ccroswhite/BFDAC/Alinx/pin_free.txt

=== used-pin presence on connectors ===
  G20: NOT on connectors (onboard?)
  G19: NOT on connectors (onboard?)
  B30: C17,B71_L24_P,B30
  A30: C16,B71_L24_N,A30
  A27: C20,B71_L22_P,A27
  A28: C19,B71_L22_N,A28
  T26: C2,B71_L3_P,T26
  R26: C1,B71_L3_N,R26
  H29: C5,B71_L15_P,H29
  G29: C4,B71_L15_N,G29
  P28: A5,B71_L5_P,P28
  R27: A1,B71_L2_N,R27
  T27: A2,B71_L2_P,T27
  N28: A4,B71_L5_N,N28
  R28: A7,B71_L1_N,R28
  T28: A8,B71_L1_P,T28
  BC33: NOT on connectors (onboard?)
  BF27: NOT on connectors (onboard?)
  AM26: A16,VUP_SELECTMAP_DATA4,AM26
  AN26: A14,VUP_SELECTMAP_DATA5,AN26
  AL25: A10,VUP_SELECTMAP_DATA6,AL25
  AM25: A11,VUP_SELECTMAP_DATA7,AM25
=== free bank-71 pins (first 20 not in XDC) ===
A10,B71_L18_N,D28
A11,B71_L18_P,E28
A13,B71_L10_N,K27
A14,B71_L10_P,K26
A16,B71_L12_N,J29
A17,B71_L12_P,J28
B1,B71_L6_N,N26
B2,B71_L6_P,P26
B4,B71_L13_N,H26
B5,B71_L13_P,J26
B7,B71_L4_N,N29
B8,B71_L4_P,P29
B10,B71_L23_N,A29
B11,B71_L23_P,B29
B13,B71_L20_N,C29
B14,B71_L20_P,D29
B16,B71_L11_N,H28
B17,B71_L11_P,H27
C7,B71_L17_N,E27
C8,B71_L17_P,F27
