ccroswhite/BFDAC/Alinx/xdc_pins.txt

set_property PACKAGE_PIN G20     [get_ports clk_200m_p]
set_property PACKAGE_PIN G19     [get_ports clk_200m_n]
set_property PACKAGE_PIN B30     [get_ports clk_49m_p]
set_property PACKAGE_PIN A30     [get_ports clk_49m_n]
set_property PACKAGE_PIN A27     [get_ports clk_45m_p]
set_property PACKAGE_PIN A28     [get_ports clk_45m_n]
set_property PACKAGE_PIN T26     [get_ports spi_sclk]
set_property PACKAGE_PIN R26     [get_ports spi_cs_n]
set_property PACKAGE_PIN H29     [get_ports spi_mosi]
set_property PACKAGE_PIN G29     [get_ports spi_miso]
set_property PACKAGE_PIN P28     [get_ports fpga_irq_n]
set_property PACKAGE_PIN R27     [get_ports i2s_bclk]
set_property PACKAGE_PIN T27     [get_ports i2s_lrclk]
set_property PACKAGE_PIN N28     [get_ports i2s_data]
set_property PACKAGE_PIN R28     [get_ports relay_line_mute]
set_property PACKAGE_PIN T28     [get_ports relay_hp_mute]
set_property PACKAGE_PIN U28     [get_ports relay_hp_rails]
set_property PACKAGE_PIN R29     [get_ports {relay_level[0]}]
set_property PACKAGE_PIN T29     [get_ports {relay_level[1]}]
set_property PACKAGE_PIN BC33    [get_ports led_status]
set_property PACKAGE_PIN BF27    [get_ports qspi1_cs_n]
set_property PACKAGE_PIN AM26    [get_ports {qspi1_dq[0]}]
set_property PACKAGE_PIN AN26    [get_ports {qspi1_dq[1]}]
set_property PACKAGE_PIN AL25    [get_ports {qspi1_dq[2]}]
set_property PACKAGE_PIN AM25    [get_ports {qspi1_dq[3]}]
