ccroswhite/BFDAC/utils/coef/DAC_PERSONAS.md

# BFDAC Filter Personas — Sonic Design Reference

**6 DAC Personas × 6 Filter Variations = 36 URAM Coefficient Sets**

Generated by: `gen_coe_super.py --generate-all --architecture uram`  
Coefficient format: Q1.17 signed 18-bit, 16 polyphase phases, 64 taps/phase  
Base sample rate: 48 kHz → 768 kHz output (×16 interpolation)

---

## Variation Axes (consistent across all personas)

| Tag | What changes | You hear it as |
|-----|---|---|
| **F1 Reference** | Definitive flagship character of that DAC | The intended "house sound" |
| **F2 Fast** | Higher Kaiser beta / steeper roll-off | More defined, more "hi-fi", slightly more fatiguing |
| **F3 Slow** | Lower Kaiser beta / gentler transition | More natural, analogue ease, less edge |
| **F4 Apodising** | Blackman-Harris window, fc pulled in | Removes CD brickwall pre-ringing, very clean presentation |
| **F5 Phase Alt** | Minimum-phase or hybrid (60% min / 40% linear) blend | Changes transient envelope — zero pre-ringing vs some |
| **F6 Extended BW** | fc pushed to 21–23 kHz | More air, space, and presence perceived above the mix |

---

## Persona 1 — dCS Vivaldi Apex

**Sonic Character: "Analytical Precision with Organic Resolution"**

The dCS house sound is about revealing everything in the recording without ever sounding harsh.
It is surgical but not clinical. The Vivaldi Apex is known for an enormous sense of space and
air — you hear deep into the mix. The baseline apodising filter (Kaiser β=8, fc=20.5 kHz) sits
just above 20 kHz to remove the Gibbs ringing injected by CD mastering brickwall filters
upstream, which is dCS's core philosophy. The relaxed beta means the transition band is gentle —
not trying to be a brickwall itself — giving a relaxed, airy quality rather than the "tense"
sound of a very steep filter.

| Variation | Parameters | Description |
|---|---|---|
| F1 | Kaiser β=8, fc=20.5k, linear | Definitive dCS filter — apodising, removes upstream pre-ringing |
| F2 | Kaiser β=12, fc=20k, linear | More frequency-domain precision, slightly more "hi-fi" |
| F3 | Kaiser β=5, fc=20.5k, linear | Softer — more analogue-like ease, less defined but more natural |
| F4 | Blackman-Harris, fc=19k, linear | Deep apodising — maximum removal of digital artefacts |
| F5 | Kaiser β=8, fc=20.5k, hybrid | Organic quality of minimum-phase combined with dCS openness |
| F6 | Kaiser β=8, fc=23k, linear | "Air and space" filter — maximises perception of presence |

---

## Persona 2 — Chord DAVE

**Sonic Character: "Transient Accuracy and Maximum Tap Count"**

Rob Watts's WTA (Watts Transient Alignment) algorithm is the defining characteristic. The DAVE
uses over 1 million taps to reconstruct the waveform with extraordinary precision. The result is
that you hear micro-details — the precise decay of a piano note, the exact attack of a plucked
string — that other DACs smear together. It is not warm, it is not smooth — it is truthful. The
steep Kaiser β=14 brickwall is intentional: keep 20 kHz as a hard boundary, waste no energy on
the transition, put all the taps into passband accuracy.

| Variation | Parameters | Description |
|---|---|---|
| F1 | Kaiser β=14, fc=20k, linear | WTA reference — tight brickwall, maximum impulse accuracy |
| F2 | Kaiser β=18, fc=20k, linear | Even more stopband rejection, most "hi-fi" presentation |
| F3 | Kaiser β=10, fc=20k, linear | Relaxed — trades some precision for a less intense listen |
| F4 | Blackman-Harris, fc=18.5k, linear | Cleans up CD-era material, less fatiguing on older recordings |
| F5 | Kaiser β=14, fc=20k, minimum | Removes pre-ringing entirely — fundamentally different character |
| F6 | Kaiser β=14, fc=22k, linear | Adds "air" that the strict brickwall cuts off |

---

## Persona 3 — MSB Reference

**Sonic Character: "Zero Pre-Ringing, Organic Transients, Black Background"**

MSB uses a discrete R-2R ladder DAC — no delta-sigma, no DSD conversion. The modulator noise
floor is exceptionally low, giving an almost spooky quiet background. The sonic character is
organic and natural — transients have the right energy envelope (all post-impulse, nothing before
it), which is exactly what you hear in real acoustic instruments. Minimum phase is the correct
choice here: no pre-ringing means a piano attack sounds like a piano attack, not like something
that starts ringing before the hammer hits the string. The Hann window gives a smooth,
non-aggressive roll-off.

| Variation | Parameters | Description |
|---|---|---|
| F1 | Hann, fc=20k, minimum | MSB reference — Hann + minimum phase, zero pre-ringing |
| F2 | Kaiser β=10, fc=20k, minimum | Slightly steeper, more defined, still zero pre-ringing |
| F3 | Kaiser β=6, fc=20k, minimum | Softest version, most "analogue" feeling |
| F4 | Blackman-Harris, fc=19k, minimum | Deep apodising and zero pre-ringing combined |
| F5 | Kaiser β=10, fc=20k, hybrid | Compromise — some pre-ringing returns, sharper transient attack |
| F6 | Hann, fc=23k, minimum | More air without introducing pre-ringing |

---

## Persona 4 — Berkeley Audio Design Alpha 3

**Sonic Character: "Maximum Analogue Character, No Digital Fingerprint"**

Michael Ritter's philosophy at Berkeley is radical: the DAC chip does nothing but convert bits
to voltage. All the filtering happens in the FPGA. This means the output has no trace of the
internal chip filter (which typically adds its own phase distortion and roll-off character). The
Berkeley sound is extraordinarily open and relaxed — non-fatiguing, listeners report being able
to sit with it for hours. The aggressive FIRLS + Blackman-Harris apodising at 18.5 kHz means the
filter is already rolled off before 20 kHz. This sounds like a limitation but the ear perceives
it as ease — there is no "edge" to the sound.

| Variation | Parameters | Description |
|---|---|---|
| F1 | FIRLS+BH, fc=18.5k, linear | Berkeley reference — maximum analogue ease |
| F2 | FIRLS+BH, fc=20k, linear | Widens to 20 kHz — more detail at the cost of some ease |
| F3 | FIRLS+BH, fc=17k, linear | Most analogue/relaxed version, almost LP-like top end |
| F4 | Gaussian α=4, fc=18k, linear | Softer roll-off shape than BH — very smooth, no hard knee |
| F5 | FIRLS+BH, fc=18.5k, hybrid | Adds minimum-phase organic quality to the Berkeley character |
| F6 | FIRLS+BH, fc=21k, linear | Retains BH character with more air |

---

## Persona 5 — Merason DAC1

**Sonic Character: "Burr-Brown PRaT — Pace, Rhythm and Timing"**

The Merason is built on the Burr-Brown PCM1794A, one of the most loved DAC chips in audiophile
history. The Burr-Brown house sound is slightly smooth and romantic — never harsh, never
fatiguing, but with enough detail to be engaging. More importantly, it has exceptional PRaT
(Pace, Rhythm and Timing) — music played through it has drive and momentum. It makes you want
to tap your foot. Kaiser β=11 sits between the Chord brick-wall precision and the dCS ease —
a deliberately crafted middle ground that is detailed but smooth.

| Variation | Parameters | Description |
|---|---|---|
| F1 | Kaiser β=11, fc=20k, linear | Merason reference — balanced smooth/detailed |
| F2 | Kaiser β=13, fc=20k, linear | More detail, better transient definition, still not harsh |
| F3 | Kaiser β=9, fc=20k, linear | More romantic — the PCM1794A's smoothest character |
| F4 | Blackman-Harris, fc=19.5k, linear | Cleans up digital fingerprint, purely natural presentation |
| F5 | Kaiser β=11, fc=20k, hybrid | Slightly organic transients — preserves PRaT quality |
| F6 | Kaiser β=11, fc=22k, linear | Adds "air and shimmer" above the mix |

---

## Persona 6 — Mola Mola Tambaqui

**Sonic Character: "Studio Monitor Neutrality, Ultra-Low Noise"**

Bruno Putzeys (also designer of Purifi amplifiers) built the Tambaqui around his MDAT modulator
— a proprietary noise shaper that achieves extraordinary dynamic range and linearity. The
Tambaqui tells you exactly what is in the recording — it does not add warmth, romance, or any
colouration. If the recording is great, it sounds great. If it is not, you will know. This is
the DAC engineers and mastering engineers reach for. Kaiser β=16 is the steepest flagship
reference — maximum stopband rejection, ruler-flat passband.

| Variation | Parameters | Description |
|---|---|---|
| F1 | Kaiser β=16, fc=20k, linear | Tambaqui reference — neutral precision, ruler-flat |
| F2 | Kaiser β=20, fc=20k, linear | Maximum resolution — every micro-detail resolved |
| F3 | Kaiser β=12, fc=20k, linear | Slight relaxation — adds the tiniest warmth to very revealing material |
| F4 | Blackman-Harris, fc=19k, linear | Removes digital artefacts, slightly less clinical presentation |
| F5 | Kaiser β=16, fc=20k, minimum | Zero pre-ringing — changes character toward organic |
| F6 | Gaussian α=3, fc=21k, linear | The one "colour" option: air with a smooth Gaussian roll, no hard knee |

---

## Generation Commands

```bash
# All 36 filters — simulation scale (4 MACs, 64 taps/phase):
python gen_coe_super.py --generate-all --architecture uram --out_dir coeffs

# Single persona — all 6 variations:
python gen_coe_super.py --generate-all --persona chord-dave --architecture uram --out_dir coeffs

# Single specific filter:
python gen_coe_super.py --persona msb-reference --variation F4 --architecture uram --out_dir coeffs

# Production scale (1024 MACs):
python gen_coe_super.py --generate-all --architecture uram \
    --uram-num-macs 1024 --uram-taps-per-phase 64 --out_dir coeffs_prod
```

## Output File Tree

```
coeffs/
  dcs-vivaldi/
    dcs-vivaldi_F1_F1-Reference_m4_t64.txt
    dcs-vivaldi_F2_F2-Fast_m4_t64.txt
    dcs-vivaldi_F3_F3-Slow_m4_t64.txt
    dcs-vivaldi_F4_F4-Apodising_m4_t64.txt
    dcs-vivaldi_F5_F5-PhaseAlt_m4_t64.txt
    dcs-vivaldi_F6_F6-ExtendedBW_m4_t64.txt
  chord-dave/      (6 files)
  msb-reference/   (6 files)
  berkeley-alpha3/ (6 files)
  merason/         (6 files)
  mola-mola/       (6 files)
```

---

*Last updated: 2026-07-01*  
*Reference implementation: `gen_coe_super.py` `DAC_LIBRARY` dict*

---

# Filter Design Choices: The Science and the Honesty

## What We Actually Know vs. What We Are Approximating

### The Hard Truth First

We do **not** know with confidence exactly what Rob Watts, dCS, MSB, or Mola Mola are doing
internally. What we have is:

- **Published patents** (Watts has several on WTA, dCS has SACD/ring DAC patents)
- **White papers** (dCS Ring DAC, Chord WTA algorithm description)
- **Measurements** published by Audio Science Review, Stereophile, and others — impulse
  responses, frequency responses, phase responses
- **Interviews** where designers describe their philosophy in general terms
- **Reverse-engineering** from those measurements by the audio community

What we are doing is **emulating the audible fingerprint** of those designs using filter theory,
not replicating their actual silicon. The distinction matters.

---

## Why Specific Windows Produce Specific Sounds

The relationship between window choice and audible character is well-understood DSP. The
science here is solid.

### Kaiser Window — Why Chord DAVE uses high beta

The Kaiser window is parametric — beta controls the **trade-off between stopband attenuation
and transition band width**. High beta (14–20) means:

```
Passband → [very flat] → steep cliff → [very deep stopband]
```

Rob Watts has explicitly stated in interviews and white papers that his WTA filter prioritises
**time domain accuracy over frequency domain performance**. The paradox is that to get time
domain accuracy you need **very long filters** (~1 million taps), not necessarily steep
frequency roll-off. However, the Kaiser window's shape produces a very controlled impulse
response — the ringing is symmetric and decays predictably. With enough taps, the pre-ringing
and post-ringing are pushed so far out in time that they become inaudible. This is the WTA
principle: **don't reduce the ringing, make it temporally inaudible by spreading it far from
the transient**.

A Hamming window at the same tap count would have lower stopband attenuation (~43 dB vs ~80+
dB for Kaiser β=14) and a less controlled transition. Kaiser gives **adjustable precision** —
that is why it dominates serious filter design.

### Hann Window — Why MSB uses it for minimum phase

The Hann window has a **smooth, gradual roll-off shape**:

```
Passband → [gentle slope] → quiet stopband
```

Stopband attenuation is ~44 dB — less than Kaiser β=14 — but the **impulse response is very
smooth** with no abrupt discontinuities. Combined with minimum-phase conversion (which takes
all the energy and pushes it forward in time, eliminating pre-ringing entirely), the Hann
window produces the most **organically-shaped post-impulse decay**.

The minimum-phase conversion via Hilbert transform or homomorphic method does not change the
magnitude response — only the phase. So you keep the Hann's gentle frequency roll-off but
eliminate all pre-ringing. The remaining ringing all follows the impulse, which is how acoustic
instruments actually behave in a room. MSB have published that their design philosophy is
explicitly around this — zero pre-ringing, all energy causal.

### Blackman-Harris Window — Why it is used for apodising

Blackman-Harris has the **highest stopband attenuation** of the common windows (~92 dB) with a
fairly wide transition band. The wide transition is the key:

```
Passband → [wide gentle slope starting at ~17–19 kHz] → very deep stopband
```

The word **apodising** literally means "removing the foot" — it refers to removing the
sidelobes of the sinc function that cause Gibbs phenomenon ringing. A CD's original mastering
uses a brickwall at 22.05 kHz which injects its own pre-ringing into the signal. An apodising
filter rolls off *before* that brickwall frequency, effectively erasing that pre-ringing.

dCS's apodising filters (and our F4 variations) do exactly this. dCS has explicitly described
this in their technical literature — their filter is designed to attenuate the out-of-band
energy that causes Gibbs ringing from upstream 44.1 kHz brickwall filters.
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
