ccroswhite/BFDAC/pkg36.png

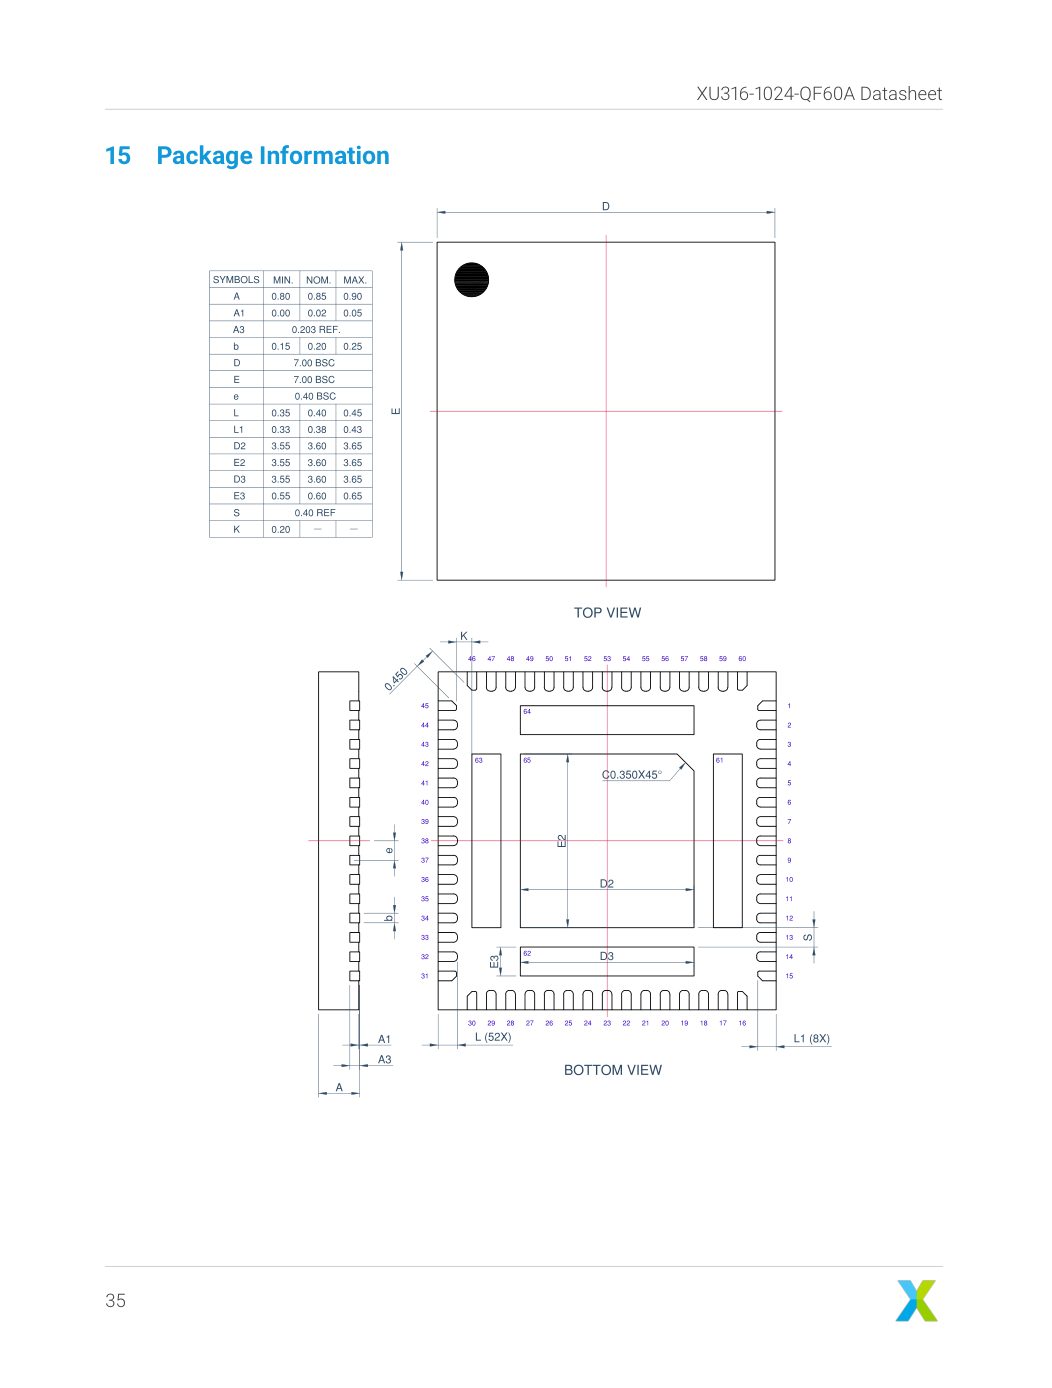
pkg36.png
