ccroswhite/BFDAC/bom.md

# BFDAC — Consolidated Bill of Materials

Single source of truth for all board-level parts. Organized per block; **BOM
section N documents schematic.html figure N** — the two files are an
authoritative pair and MUST be edited in lock-step (any part added, removed or
revalued in one is reflected in the other in the same change). Netlist values
(`bfdac_*.cir`) are authoritative for analog values; this document tracks
realized MPNs and quantities.

## 18b. Current Coefficient-Flash Decision (Supersedes Item 18a MPN)

The selected carrier part is **Macronix `MX66UM2G45GXRI00`** (no `-T` suffix),
four devices, one shared bus and four existing chip-selects. The interface in
this revision is **x1 SPI**, not x4 QSPI; use 4-byte Fast Read `0x0C` with eight
dummy clocks at a 100 MHz carrier SCK target. The device also supports x8 OPI,
which is not used by this design. The selected part is linked at
[DigiKey](https://www.digikey.com/en/products/detail/macronix/MX66UM2G45GXRI00/18109953).
SIO0/SIO1 map to MOSI/MISO; SIO2/SIO3 remain static high in x1 mode;
SIO4-SIO7, DQS and ECS# are no-connect. VCC/VCCQ share V18, GND/VSSQ share
GND, RESET# is strapped high, and the schematic includes separate 100-nF
decouplers for VCC and VCCQ per device. The 100-MHz target still requires
post-route MISO timing sign-off.

The 1-Gb alternate is `MX66UM1G45GXDI00`. Its 24-ball map and 6 x 8 mm,
5 x 5 / 1.0 mm land pattern match the 2-Gb part; no PCB pin or CS changes are
needed. Build that population with `CFLASH_DEVICE_ADDR_BITS=27` instead of 28
(for the current Vivado scripts, set that environment variable) and limit the
coefficient image accordingly. With 64-KiB-sector-aligned,
11,862,016-byte records that do not cross chip boundaries, four 2-Gb devices
hold up to 88 full-size records (22/device); four 1-Gb devices hold 44 (11/device).
The 2-Gb population is the default and supports the planned 64-record library.
This per-device limit supersedes item 18a's aggregate-only 90-record estimate;
the controller does not split a single read across chip-select boundaries.
The prior Micron MPN and its footprint/pin map are superseded.

## Board-to-Board Connectors

The main circuit board has three bottom-side SEAF-40 sites: Conn1/J506 west,
closest to the FPGA; Conn2/J603 north-center; and Conn3/J604 south-center.
Use `SEAF-40-05.0-L-06-2-A-K-TR` on all board-side sites. The local symbol and
footprint each represent 40 contacts per row x six rows (240 pads), numbered
row-major A1-F40. Conn1/J506 carries the AP interface, a 30-contact `V12SOM`
bank with its `GND` perimeter, and a separate `V33_IF_IN` group with a carrier
`GND` guard. `VAP_IO/GND_AP` remain a separate AP-side domain. The separate
J507/J508 +12 V terminals are removed from the active design.
The mating pre-regulator board uses the same SEAF land pattern; its connectors
(J7703/J7704 to J603/J604, plus **J7705 to J506** - full 240-pad mirror of the
Conn1 map; `V12SOM`/`V33_IF_IN` are sourced on that assembly, row-A AP_* +
`VAP_IO`/`GND_AP` continue to the AP section whose physical interconnect is
TBD) and V4P3 front-end are drawn on the PREREG subsheet of this project with
`on_board=no` (bom 17o). Its own PCB file remains separate.
See `docs/SEAF_PIN_ASSIGNMENTS.md` for the complete Conn1 map and the current
J603/J604 assignments. Contact derating/current sharing and the local 1.8 V
LDO implementation remain to be qualified; the source for `V33_IF_IN` on the
pre-regulator/mating assembly must also be specified.
This section is the current connector selection and supersedes the historical
connector decisions recorded under items 17(m5)/(m6) below.
Use three `SEAR-40-30.0-06-85` interposers, one per mating site. They are
BOM-only; do not add them as PCB footprints or to the chassis 3MF. The
matching three SEAF connectors on the pre-regulator board belong in that
board's assembly BOM.
The target separation between the two boards is 40 mm; the pre-regulator
board's PCB layout is not in this project.

| BOM § | Block | Schematic | MPN status |
|---|---|---|---|
| 1 | Master clock tree & reclock | Fig. 1b | **LOCKED (Round 30, ratified)** — RTZ coding + SN74LVC1G74 single-FF reclock |
| 2 | Unit cell array | Fig. 2 | **LOCKED (Round 29)** — BJT steering cell (DMMT5551) |
| 3 | Per-rail output stage | Fig. 3 | values locked, MPNs TBD |
| 4 | I/V converter | Fig. 4 | OPA1612AIDRGR DRG WSON-8; BUF634AIDDAR DDA HSOIC-8 PowerPAD |
| 5 | Reconstruction filter | Fig. 4b | values locked, coils custom |
| 6 | Line V-stage | Fig. 4c | shares §8 MPNs |
| 7 | Output routing & relays | Fig. 4d | K4 = Omron G6K-2F-Y **DC3** on dedicated `V33RLY` LDO (2026-10-10), drawn |
| 8 | ~~Headphone amplifier~~ | Fig. 4e | **REMOVED 2026-10-05 (user: power/heat) — not in this version; kept for record** |
| 20 | Temperature sensing (I²C, isolated) | — | NEW 2026-10-05 — TMP117 + ~~ISO1610~~ **ISO1640** ruled (MPN corrected 2026-10-08) |
| 21 | AP ↔ FPGA control SPI isolation | — | **RULED 2026-10-05: single SPI, TI ISO7741** (3/1, 100 Mbps); 10 MHz guaranteed / 50 MHz if the AP has RX sample delay |
| 9 | Supplies & references | Fig. 5 | values locked, LDO/refs TBD |
| 10 | Common-mode servo | Fig. 5b | pairs selected, support TBD |

Open sync items are listed at the [bottom](#open-sync-items).

---

# 1. Master clock tree & cascode reclocking (Fig. 1b, Round 24)

Round 24 architecture: clock selection moved off-chip. FPGA receives a single
muxed MCLK and drives `clk_sel`; the same buffer tree clocks the external
reclock flip-flops so cascode edge timing is set by the OCXO chain, not the
FPGA fabric (~23 dB timing-SNDR gain, `reclock_study.py`, Round 23).

> **DATASHEET-VERIFIED (Round 30, 2026-07-22):** all §1 jitter/skew/timing
> figures below updated from MC10EP52/D rev 7 (onsemi), LMK00304 SNAS578G
> rev G, LMK1C110x SNAS717A, SN74LVC1G74 rev G (TI).
>
> **RATIFIED (Round 30, 2026-07-22, user):** the cell coding is **RTZ at
> 75 % duty** (each selected cell emits one identical charge pulse per
> sample: 6-of-8 mclk cycles high = 122.1 ns at the 6.144 MHz cell rate)
> and the reclock stage is **one SN74LVC1G74 per cell** (single-FF package
> — MANDATED by the SSN code² analysis, see §1.2). DEM is the
> unconstrained sort-based 2nd-order vector shaper (RTL). Verification:
> 4-leg battery, `progress.md` Round 30 "RTZ-DEM VERIFICATION"
> (`rtz_study.py`, `bfdac_cosim28j.cir`, `rtz_noise.py`, `dwa_tones*.py`).
> Key consequence for layout: **sub-ns length matching is retired** — RTZ
> pulse-position invariance relaxes clock-tree skew to ±5 ns and Q/Q̅
> intra-pair mismatch to ~700 ps (~12 cm).

## 1.1 Clock selection & distribution

| Ref | Qty | Part | Function | Key specs |
|---|---|---|---|---|
| Y301 | 1 | Crystek **CCHD-957-25-49.152** (primary) / NDK **NZ2520SDA** 49.152 MHz audio grade per NDKT02-00008 (2nd source) | 48 kHz-family master clock, 1024·fs, LVCMOS 3.3 V → 33 Ω → shared `XOCLK` net (2026-09-28: E/D = `!clk_sel`; **VERIFY output high-Z when disabled**, pinout 1 E/D 2 GND 3 OUT 4 Vcc, footprint) | P3 (2026-09-13, `pn_n2b.py` + gate 97): with RTZ both pulse edges come from the same clock 122 ns apart, so **only the broadband floor above ~1 MHz reaches the output** (close-in PN = pulse position only, −179 dBc @ 1 kHz, sim-validated to 0.4 dB). Requirement: floor ≤ −169 dBc/Hz (≈ 80 fs width-jitter). CCHD-957: floor ~−169, ~82 fs 12k–20M, ±25 ppm — **confirm both figures on datasheet**; NZ2520SDA: −172 @ 100k, 43 fs, ±50 ppm (irrelevant to audio; matters only if slaved to S/PDIF without ASRC). OCXO not required. PLL cleaners (AD9558/LMK048xx) REJECTED — floors 10–20 dB worse. |
| Y302 | 1 | same family, **45.1584 MHz** | 44.1 kHz-family master clock → 33 Ω → `XOCLK` (E/D = `clk_sel`) | as Y301 |
| ~~U301 LMK00304~~ | 0 | **REMOVED 2026-09-28 (open item 15, user-ratified option 2).** Its only LVCMOS output (REFout, the sole way to drive LMK1C1108 CLKIN) is 95 fs additive vs the 51 fs LVPECL figure quoted here; the mux function moves to the XO enables. Tree common jitter ≈ √(82² + 20² + 20²) ≈ 87 fs (was ≈129 fs with REFout, ≈101 fs as originally assumed). Switch still not glitch-free → same sequencer mute + MMCM reset as before. | | |
| U301 | 1 | TI **SN74LVC1G04DBVR** | `clk_sel` inverter → Y301 E/D; `clk_sel` → Y302 E/D directly; 10 k pull-down on `clk_sel` = 48 k family default while the FPGA is unconfigured | SOT-23-5, V33CLK |
| U312 | 1 | TI **SN74LVC1G125DBVR** | FPGA `mclk` copy off `XOCLK` → 100/120 Ω divider (3.3 → 1.8 V, ≈55 Ω source) → J1 A17 (B71_L12_P / J28) as **LVCMOS18 single-ended** | its jitter is irrelevant — the FF retimes; FPGA only needs the ±5 ns window. **FPGA XDC TODO:** `mclk` becomes IBUF on J28, `mclk_n`/J29 freed |
| U302–U319 | 18 | TI **LMK1C1108** | 1:8 LVCMOS clock fanout, two-level tree (2 roots → 16 leaves → 128 FF clock traces; Round 29: 128 single-FF MC100EP52 packages). **LOCKED 2026-10-09: all 128 XO→FF CLK paths length-matched ±5 mm (§1.2 layout rule)** | VERIFIED @3.3 V: output–output skew 35 ps typ / 55 ps max per device; **part-to-part skew 280 ps max** (dominates leaf-to-leaf across different chips — still inside the 1 ns FPGA-vs-FF budget; inter-bank static skew benign, DEM decorrelates, Round 23); additive jitter 12 fs typ / 20 fs max; tpd 1.3–2.2 ns; fmax 250 MHz; ~~length matching RETIRED (Round 30 RTZ ratification): tree skew tolerance ±5 ns — route for signal integrity only~~ **RE-INSTATED 2026-10-09 (user): ±5 ns remains the functional limit; layout target ±5 mm end-to-end, ±2.5 mm root/leaf feeds (§1.2 layout rule)** |
| R3xx | 1 per clock trace + 2 | 22–33 Ω 0402 | Series termination at each buffer clock output | at driver pin, no stubs |

## 1.2 Reclock flip-flops — **LOCKED (Round 30, ratified): RTZ + SN74LVC1G74**

> **HARD CONSTRAINT (Round 30 user ruling — was implicit, now explicit):
> the reclock/drive electronics sit millimeters from the matched DMMT5551
> steering pairs and the timing-critical clock tree. The thermal budget
> there is very small: per-cell heat sources cause gradient drift across
> the matched parts (Vbe/alpha tempco → INL drift, timing drift). Target:
> per-cell drive electronics ≤ ~10 mW (CMOS-class dynamic power only);
> reclock array total ≤ ~1–1.5 W. The MC100EP52 (≈140 mW/cell static,
> ≈18 W array — verified Round 30) is VETOED. Any future drive-stage
> candidate must pass this constraint BEFORE electrical evaluation.**
>
> **RESOLVED (Round 30 ratification): SN74LVC1G74 @ ≈5–7 mW/cell passes
> the constraint** (3–4 mW FF dynamic + 2.9 mW drive network, sim-measured
> `bfdac_cosim28j.cir` p_net1). Array < 1 W.

### Round 30 ratified design: RTZ coding + SN74LVC1G74 per cell

Architecture: **one FPGA data pin per cell (128 total, LVCMOS18)** carrying
the **RTZ-encoded** pattern (selected cell → 6-of-8 mclk cycles high per
cell period; unselected → low); **octal 1.8→3.3 V translators at the SoM
connectors (FPGA side of the board, SN74AXC8T245-class, 8/channel — RULED
2026-10-09, replaces the 128 per-cell AXC1T45)** feed the **SN74LVC1G74** D
inputs over 3.3 V runs into the cell array; the **128 FPGA → translator 1.8 V
lines are length-matched** (user ruling); the FF —
clocked from the LMK1C1108 tree at mclk — retimes the pulse and its true
Q/Q̅ outputs drive the DMMT5551 steering pair (§2) through the rs/rp
network. Translator/data-path timing errors are retimed away by the FF;
only the FF's own edges reach the cell.

Why RTZ (Round 30, 4-leg verification, `progress.md`): every selected cell
emits an *identical, self-contained* charge pulse per sample, so
(a) rise-vs-fall duty asymmetry — the defect that killed every NRZ CMOS
candidate at 1.1–1.4e-2/ns — becomes a pure **gain** error (−2.43 % at the
worst measured dtrf, k-variation ≤ 3.3e-4, sim-verified); (b) per-cell
static spreads (duty, Q/Q̅ trace skew) become DEM-shaped mismatch;
(c) pulse position is charge-invariant → clock skew is benign. Costs:
−2.5 dB amplitude (75 % duty) and real width-jitter sensitivity (needs
tree broadband floor ≤ 150 fs — actual 50–80 fs ✓; per-FF additive jitter
≤ 1 ps — bench-verify).

Why single-FF packages (MANDATORY): under RTZ all selected cells switch
simultaneously; on a shared die the SSN edge pushout (β·switching-count,
rise-vs-fall coefficients differ) makes pulse WIDTH depend on packmate
activity → code² distortion at 75–100 dB class for a quad (even Δβ =
0.05 ps/cell → 104.7 dB, `rtz_noise.py`). One FF per package reduces SSN
to a per-cell static effect (DEM-shaped). Each FF package gets local rail
isolation (R/ferrite + C, values at open item #11) so board-rail droop
stays width-symmetric.

Derived layout tolerances (Round 30): Q/Q̅ intra-pair trace mismatch
≤ ~700 ps ≈ 12 cm; clock-tree skew ≤ ±5 ns ≈ ±80 cm; data traces
untimed (retimed away). Only the analog cell matching constraints (§2)
remain sub-ns/precision class.

**LOCKED layout rule (2026-10-09, user: "beat the 5 ns by a country mile; equalise
SSN timing") — the Round-30 tolerances above are the *functional* limits, NOT the
layout targets.** Data path, FPGA pin → translator → FF, length-matched on both
segments: **FPGA pin → AXC8T245 input (1.8 V, 128 lines): ±2.5 mm (≈ ±16 ps),
within each octal group and across all 16 groups**; **AXC8T245 output → LVC1G74 D
(3.3 V, 128 lines): ±5 mm (≈ ±33 ps)**; Q/Q̅ intra-pair ±1 mm. Rationale: the
trace is then 20× below the FPGA pin-to-pin Tco spread (~300 ps) and the
translator channel skew (~300–500 ps), so all 128 D edges — and the translators'
SSN event — land at one repeatable point in every cell's setup window, far from
the sampling edge. SSN equalisation: 8 lines per octal, 8 octals per channel,
identical decoupling per octal, channels mirrored; translator B-sides on their
own ferrite/C island of `V33FF`, separate from the FF islands. **Clock tree
matching RE-INSTATED (user, 2026-10-09): XO → root LMK1C1108 → leaf LMK1C1108 →
FF CLK, all 128 end-to-end paths matched to ±5 mm (≈ ±33 ps), both channels
included; the two root legs and the 16 leaf feeds matched to ±2.5 mm.** The
Round-30 "length matching retired" note is reversed: static per-cell clock skew
interacts with sort-shaper DEM (cell assignment changes every sample), so it is
removed rather than tolerated; the remaining leaf-to-leaf skew is then the
LMK1C1108 part-to-part figure (280 ps max) alone.

| Ref | Qty | Part | Function | Key specs |
|---|---|---|---|---|
| U311–U438 | 128 | TI **SN74LVC1G74DQER** (single D-FF, true Q/Q̅, X2SON-8 DQE, 1.4 x 1.0 mm, 0.35 mm pitch, VCC = 3.3 V) | Retime 1 RTZ data line → complementary base-drive pair (1 per cell, placed adjacent to its DMMT5551 pair) | VERIFIED (rev G): fmax 175–200 MHz @3.3 V (vs 49.152 MHz clock); tpd 2.2–7.1 ns; "balanced outputs"; Icc static 10 µA; ~3–4 mW dynamic at RTZ activity. **BENCH-VERIFY (not datasheet-spec'd):** part-to-part \|tPLH−tPHL\| spread σ ≤ ~600 ps; **additive jitter ≤ 0.8 ps rms (P3 2026-09-16, gate 98: per-FF jitter is independent per cell and enters at 0.155× the common-path sensitivity = 171 nV/ps; 0.84 ps is the most the 245 nV budget can absorb with the CCHD-957 floor, 0.6 ps comfortable; 1 ps → 171 nV = −127 dB0 total, still 14 dB better than dCS)**. Design-in: clock pin driven by the full-swing LMK1C1108 leaf edge (≥ 3 V/ns, series R, no stub); per-FF ferrite + local C from a dedicated low-noise 3.3 V rail (delay sensitivity ~50–100 ps/V → ≤ 1 mV rms rail noise ≈ 0.1 ps). Fallback if bench > 0.6 ps: MC100EP52 / NB7V52M-class (0.2 ps spec'd) + level translator (Round 29 costing). Open item #10 |
| ~~U440–U567~~ | ~~128~~ | ~~**AXC1T45-class** single-bit 1.8→3.3 V translator~~ | **SUPERSEDED 2026-10-09 (user ruling: routing/parts congestion in the cell array; no single-part FF+translator exists, see item 12)** | — |
| U440–U455 | 16 (8/channel) | TI **SN74AXC8T245RHLR — LOCKED 2026-10-10** (VQFN-24 RHL 3.5 × 5.5 mm 0.5 mm EP; user ruling VQFN over TSSOP). **Pin map VERIFIED 2026-10-10 against the datasheet Fig. 4-2 (user image):** 1 VCCA, 2 DIR1, 3–10 A1–A8, 11 DIR2, 12/13 GND, 14–21 B8–B1, 22 OE̅, 23/24 VCCB, 25 PAD (grounded, recommended). *The TI/UL KiCad symbol (`datasheets/CAXC8T245QWRGYRQ1/KiCADv6`) labels pin 23 "VCCA" — the figure says VCCB; the figure is used.* Vendor land pattern `VQFN25_RGY_TEX` copied verbatim as `bfdac:TI_RGY_VQFN-24_3.5x5.5mm_P0.5mm_EP` (-L/-M density variants left in `datasheets/`). **DRAWN 2026-10-10 on the new `xlat.kicad_sch`:** device g carries cells 8g+1..8g+8 (U440–447 = L, U448–455 = R); A = `DATnn_1V8` / `DATRnn_1V8` from J6 / J5 (connector nets renamed), B = `DATnn` / `DATRnn` to the CELL sheets; DIR1/DIR2 = V18, OE̅ = GND, PAD = GND; C440–455 100 n on VCCA; FB440–455 BLM18PG121 + C460–475 100 n = per-octal `V33FF` island (`VXBnnn`). Per-cell AXC1T45 removed from the CELL sheets (cell = 7 kinds now). ERC 0 errors, xcheck PASS | FPGA LVCMOS18 data → LVC1G74 D inputs, placed **at the SoM connectors (J1/J5/J6), FPGA side of the board**; A-side on `V18` (SoM VCCIO_65_EX), B-side on `V33FF` | timing benign (pre-FF, retimed away; setup path = Tco + ~1–2 ns + flight ≪ half-period). **LOCKED 2026-10-09: FPGA pin → translator 1.8 V lines matched ±2.5 mm; translator → FF 3.3 V lines matched ±5 mm (see layout rule above); own `V33FF` ferrite/C island per octal.** Removes 128 SOT packages + 128 decoupling caps from the cell zone; per cell leaves FF + DMMT5551 + base network |
| R43x | 2/cell (256) | **1.35 kΩ** 0402 1% (was 1.41 k) | FF Q/Q̅ → base series (rs) | **RULING 2026-09-26 (hw/reconcile.md 1):** network re-sized to reproduce the locked-deck base levels **vlo/vhi = 1.10 / 1.70 V** (every ID record, LUT and kernel since R28 was taken at these levels). k = rp/(rs+rp) = 0.1823 → swing 0.602 V |
| R44x | 2/cell (256) | **301 Ω** 0402 1% (was 246) | base node → buffered **VCM 1.345 V rail** (rp) | V_base = VCM(1−k) + k·V_Q = 1.10 / 1.70 V. Thevenin 246 Ω at the base (+ the 10 Ω stopper of §2); complementary pair → VCM rail net current constant, 0.37 mA/cell sink → 24 mA/channel into the buffer (OPA1678-class, MPN at §9); ≈3.4 mW/cell. **CONFIRMATION GATE (open):** one `cosim112` run with the real rs/rp/3.3 V network in place of the ideal 10 Ω `B` drives (Thevenin 246 Ω vs 10 Ω into ~10 pF base) before release |
| L/C4xx | 128 sets | ferrite/R + local C per FF package | per-package 3.3 V rail isolation | values from open item #11 bound (board-rail SSN width-symmetry) |
| U390 | 1/channel | ~~TI TPS7A4700~~ **ADI ADP7158ACPZ-3.3-R7 — LOCKED 2026-10-10 (user)**: fixed 3.3 V, 2 A, 1.7 µVrms (10 Hz–100 kHz), LFCSP-10 3 × 3 EP (ADI CP-10-9). KiCad symbol/footprint supplied by the user: `datasheets/ADP7158ACPZ_3_3_R7/KiCADv6` (pins 1–2 VOUT, 3 VOUT_SENSE, 4 BYP, 5 EN, 6 REF_SENSE, 7 REF, 8 VREG, 9–10 VIN, 11 GND = EP) | dedicated 3.3 V FF/translator rail `V33FF` | load ≈ 0.3–0.5 A/channel (64 × LVC1G74 + 8 × AXC8T245 B-side; final from item 11 deck) → 15–25 % of rating. **Input: 4.0 V pre-reg (user ruling 2026-10-10, power sheet item 17) → 0.7 V × 0.3 A ≈ 0.2 W, ≈ +10 K.** Why this class: the `V33FF` 15 nV/√Hz pin requirement (≈ 5 µVrms in band) is set by the LDO itself — the per-FF bead/C (item 11) only works above ~10 MHz. TPS7A80xx (≈ 15 µVrms) rejected on noise; TPS7A85 (4 A) rejected as oversize; TPS7A4700 (4 µVrms) was marginal. NOT shared with digital 3.3 V |

### Round 29 EP52 design (SUPERSEDED by Round 30 ratification; kept for record)

Architecture (Rounds 27–29): **one FPGA data pin per cell (128 total,
LVCMOS18)**; reclock FF is a **differential LVPECL D-FF** whose true/complement
outputs drive the BJT steering pair (§2) through a resistive level-shift
network. Rationale (Round 28 sims): the cell needs Q/Q̅ skew ≤ ~0.4 ns with
matched complementary edge shapes to hold |asym| ≤ 1e-3; ECLinPS-EP guarantees
≤ 30 ps skew and inherently matched differential edges (→ asym ~1e-4, back at
the verified 151.7 dB glitch budget). No CMOS translator is needed: the FPGA’s
1.8 V output is resistively shifted into the FF’s differential D input against
an external threshold reference (see finding below).

> **VERIFIED FINDING (Round 30): the MC100EP52 has NO V_BB output pin.**
> SOIC-8 pinout is CLK/CLK̅, D/D̅, Q/Q̅, VCC, VEE only (the IBB row in the
> maximum-ratings table is EP-family boilerplate).
>
> **THRESHOLD-RAIL DESIGN (Round 30, closes open item #8).** Three buffered
> rails per channel replace the assumed on-chip V_BB (all derive from the
> clean FF 3.3 V LDO rail — partial ratiometric tracking):
>
> - **Offset rail 2.49 V** (revised from 2.31 V): feeds all 128 × 1 kΩ
>   offset legs (D and CLK networks). With the unchanged 3.6k/1k values the
>   D pin then swings 1.95–2.34 V (center ≈ 2.15 V) and the CLK pin
>   1.95–2.67 V (center ≈ 2.31 V). Load ≈ 40 mA avg per channel, partly
>   data-dependent (D legs) — buffer must source AND sink stiffly.
> - **THR_D = 2.15 V**: all 64 D̅ pins. Worst-case 64 × IIH(150 µA) =
>   9.6 mA, **data-dependent** (IIL is only 0.5 µA) — which is exactly why
>   it must NOT share a rail with the clock thresholds.
> - **THR_CLK = 2.31 V** (= CLK mid-swing): all 64 CLK̅ pins. ≤ 9.6 mA,
>   periodic (benign). Kept at mid-swing for symmetric noise margin; the
>   larger clock swing keeps pin slew ≈ 0.6–1.4 V/ns (LMK 20–80% edge
>   0.3–0.7 ns × network attenuation 0.217).
>
> Margins (verified limits): VIHCMR 2.0–3.3 V — low-state more-positive
> input = 2.15 V (D) / 2.31 V (CLK), ≥ 150/310 mV above the 2.0 V floor
> (old design sat exactly AT it); VPP(min) 150 mV vs 390 mV (D) / 720 mV
> (CLK) differential swing ✓. Accuracy: 1% divider + LDO ≈ ±35 mV — inside
> the ±150 mV window ✓.
>
> Jitter budget: CLK̅ threshold noise converts at σt = σv / slew (worst
> 0.6 V/ns) — buffered divider + per-pin RC keeps σv < 10 µV → < 17 fs,
> negligible vs the 0.2–1 ps FF jitter. Slow drift is common to all FFs in
> a group = static skew, DEM/inter-bank benign (Round 23 ruling).
>
> Realization per rail: E96 divider from FF 3.3 V rail → RC (1 µF, fc
> ≈44 Hz) → op-amp buffer (dual handles THR_D+THR_CLK; OPA1678-class, MPN
> final at §9) → 2.2 Ω into 10 µF bulk (cap-load isolation, DC feedback
> after the resistor) → star distribution → **10 Ω + 100 nF at every FF
> pin** (kickback isolation; 150 µA × 10 Ω = 1.5 mV static, negligible).

| Ref | Qty | Part | Function | Key specs |
|---|---|---|---|---|
| ~~U311–U438~~ | 128 | onsemi **MC100EP52** (ECLinPS-EP differential D-FF, LVPECL, VCC = 3.3 V) | SUPERSEDED — was: reclock 128 data lines → 128 complementary base-drive pairs (1 per cell) | VERIFIED (MC10EP52/D rev 7): tpd 330 ps typ / 410 ps max (85 °C); random clock jitter 0.2 ps typ / 1 ps max RMS; setup 50 ps min, **hold 0 ps min**; tr/tf (20–80%) 80–180 ps; fmax 4 GHz typ; Q/Q̅ skew not separately specified — inherent to the single differential output stage (matched complementary edges, the Round-28 requirement); **no V_BB pin** (see finding above) |
| R41x | 2/FF (256) | 3.6 kΩ + 1 kΩ 0402 1% | FPGA LVCMOS18 → D input level shift (swing 1.95–2.34 V, offset leg to the 2.49 V rail); D̅ → 10 Ω + 100 nF → THR_D 2.15 V rail | DC-coupled (cell lines are not DC-balanced; no AC coupling); values unchanged from Round 29, only the rails moved (see threshold-rail design above) |
| R42x | 2/FF (256) | 3.6 kΩ + 1 kΩ 0402 1% | LMK1C1108 3.3 V CMOS clock → CLK input (swing 1.95–2.67 V, same 2.49 V offset leg); CLK̅ → 10 Ω + 100 nF → THR_CLK 2.31 V rail | single-ended clock vs mid-swing external reference; separate rail from THR_D so data-dependent D̅ input current cannot modulate the clock threshold |
| U390 | TBD (≥3/channel) | TI **TPS7A4700** 1 A low-noise LDO (or 1× TPS7A85 4 A per channel — decide at §9 power design) **[EP52 era — superseded; current part is ADP7158ACPZ-3.3-R7, see the §1.2 RTZ table above]** | dedicated 3.3 V PECL/FF rail | NOT shared with digital 3.3 V. **VERIFIED FINDING (Round 30): IEE = 35 mA typ / 47 mA max per FF (85 °C) + ≈7 mA output-network load ⇒ ≈42 mA typ / 54 mA max per FF → 64 FFs ≈ 2.7 A typ / 3.5 A max PER CHANNEL (~18 W array dissipation total).** Old estimate (25–35 mA/FF, 1–1.6 A/channel) was low — one 1 A LDO per channel is INSUFFICIENT: use ≥3 × TPS7A4700 per channel (≤22 FFs each, ≈0.9 A) or one 4 A-class low-noise LDO. Draw is code-INDEPENDENT (differential) — still true |
| — | — | ~~SN74LVC74A / SN74AVC16T245~~ | **REMOVED (Round 29)** — CMOS FF + translator replaced by MC100EP52 + resistive shift | Q/Q̅ skew and edge-shape mismatch of CMOS FFs fail the asym ≤ 1e-3 requirement (Round 28) |
| R4xx | 256 | 100 Ω 0402 1% | FF Q/Q̅ → steering-pair base series (2 per cell) | with R4yx forms the PECL pulldown + attenuator (§2) |
| R4yx | 256 | 165 Ω 0402 1% | base node → buffered 1.0 V rail (2 per cell) | sets base swing 1.36–1.86 V from PECL 1.6–2.4 V; PECL DC pulldown 1.6–3.6 mA |

## 1.3 FPGA interface summary

| Signal | Direction | Pin | Notes |
|---|---|---|---|
| `mclk` | in | J28 (B71_L12_P, true GC; J29 freed) | LVCMOS18 single-ended from U312 divider (2026-09-28; was LVDS from the removed LMK00304) |
| `clk_sel` | out | J26 (B71_L13_P) | quasi-static, **SPI reg 0x03** (single register drives DSP family + OCXO mux, Round 30; 0x06 retired); H26 (B71_L13_N) now free |
| `cascode_l/r[63:0]` | out | **ASSIGNED (Round 30)**: L = banks 64+65, R = banks 67+69, explicit `PACKAGE_PIN` list in XDC §8 (L-pair sites only, conflict-checked vs connector CSV) | 128 pins, 1 per cell, IOB-registered on `cell_clk` (mclk-rate MMCM output, phase-aligned to the FF clock); **carries the RTZ pattern (Round 30): selected cell = 6-of-8 mclk cycles high per 6.144 MHz cell period** — pattern generated in the DEM/staging RTL; output timing vs virtual `ff_clk` (LVC1G74 capture); per-cell pin order free to remap at layout (DEM decorrelates) |

## 1.4 Timing budget (49.152 MHz worst case, 20.35 ns period)

| Item | Value |
|---|---|
| FPGA Tco (IOB, LVCMOS18) | 3–5 ns |
| Board flight FPGA → FF | 0.5–1 ns |
| Translator (AXC1T45-class) | ≈ 1–2 ns (budget; retimed away, only setup-path relevant) |
| FF setup (SN74LVC1G74) | ≤ 2.5 ns budget (conservative; transcribe exact rev G value at XDC pass) |
| Clock skew FPGA vs FF | ±5 ns TOLERANCE (Round 30 RTZ position-invariance — was <1 ns); actual ≈ 0.35 ns worst (LMK00304 50 ps + LMK1C1108 part-to-part 280 ps + trace) |
| **Setup margin** | **≈ 9–13 ns** (XDC virtual-clock numbers stay conservative) |
| Hold | verify at XDC pass: Tco(min) ~2 ns + translator ~1 ns vs LVC1G74 t_h (budget 1.5 ns) + 0.35 ns skew — expected pass, TRANSCRIBE exact t_h |

---

# 2. Unit cell array (Fig. 2) — LOCKED (Round 29): BJT steering cell

Per cell; **64 cells per channel, 128 per stereo unit**, one FPGA pin per cell
(RTL: `cascode_l/r[63:0]`, 128 pins); the complementary base-drive pair comes
from the reclock FF's differential Q/Q̅ outputs (§1.2).

**Round 28/29 redesign: the switch-FET pair is replaced by a same-die NPN
emitter-coupled steering pair** (classic ECL-driven bipolar current-steering,
PCM63 lineage). Bases swing 1.36–1.86 V (0.5 V differential crossing, set by
the §1.2 attenuator — **2026-09-26: levels are 1.10–1.70 V**, the locked-deck
`vlo/vhi`; the 1.36–1.86 figures below are the Round-29 history); the pair steers within ±~120 mV of crossing, the emitter
node never collapses (no dead zone), and injection is ~100× lower than any
FET/rail combination. Deck-verified (`bfdac_cosim27*`): bus disturbance
2.2 mV vs 89 mV (FET), asym 7.6e-5 at zero skew, temp corners −20/+85 °C
stable, k-linearity clean.

| Ref | Role | Qty/cell | Qty/unit | Part / value | Notes |
|---|---|---|---|---|---|
| Q1a, Q1b | Steering pair, same-die matched NPN | 1 pkg | 128 | **DMMT5551** (Diodes Inc dual, SOT-363) | same die → ΔV_be < 1 mV sets crossing symmetry; V_CE ≈ 0.58 V on-state (bus 1.75 V, emitter 1.17 V); α error (I_c/I_e) is a static per-cell gain term → absorbed by DEM mismatch shaping |
| Rs1, Rs2 | Base stopper **10 Ω** | 2 | 256 | 10 Ω 0402 1% | deck `RNa/RNb` (locked); sits between the §1.2 rs/rp node and the base. ~~Rb 100 Ω / Rp 165 Ω to a 1.0 V rail~~ REMOVED 2026-09-26 (EP52/PECL network, superseded by §1.2 R43x/R44x) |
| Q4 | Tail transistor | 1 (¼ pkg) | 32 pkg | **THAT300** matched quad NPN array | 4 cells share one package |
| Rt | Tail set 750 Ω | 1 | 128 | 750 Ω thin film | I_cell = (1.25 − V_be)/750 ≈ 0.774 mA |
| Rb | q4_base feed 100 Ω | shared | per netlist | 100 Ω | common base line, 1.25 V ref |
| Cb (C_q4) | Base-line bypass | 1/channel | 2 | **220 µF** (locked deck; was 1000 µF R14) | shared ×1 per channel; with R_bias 100 Ω → 7 Hz corner; noise floor code-independence verified on the locked plant (R109/R110) |

---

# 3. Per-rail output stage (Fig. 3) — LOCKED 2026-09-24 (`hw/ref_netlist.md`, from `bfdac_cosim112.cir`)

Per rail; **2 rails per channel, 4 per stereo unit**. Values are the locked
plant of gates 112–118 (v80 padding + passive replica-ff + Si1555 double
cascode + Rg 100 Ω). The Round-24 BJT cascode / I_b-comp / replica-DAC
rows are gone (superseded R80/R91). Discrete MPNs: Si1555DL ratified, 2SA1036K (QR) ruled — **all §3 actives named (stale "rest TBD" struck 2026-10-09)**.

| Ref | Role | Qty/rail | Qty/unit | Part / value | Notes |
|---|---|---|---|---|---|
| M5 | Bottom cascode, N-MOSFET | 1 | 4 | **Si1555DL** (N half) | source = bus, drain = mid; gate from casb via Rg5 |
| Rg5 | Bottom-cascode gate stopper | 1 | 4 | **100 Ω** | ruling 4b (10 Ω) REVERSED 2026-09-24: 10 Ω cost ~4 dB HD3 (half of the "static bow" was ringing) |
| M6 | Top cascode, N-MOSFET | 1 | 4 | **Si1555DL** (N half) | source = mid, drain = col (TIA summing node, 4.0 V) |
| Rg6 | Top-cascode gate stopper | 1 | 4 | 100 Ω | gate from casb2 (fixed 4.37 V) |
| MR | casb reference, diode-connected | 1 | 4 | Si1555DL (N half) | drain+gate = casb, source = vfr 1.75 V; sets casb = 1.75 + V_gs |
| QR | Replica-ff PNP V-I | 1 | 4 | **2SA1036K** (Rohm) | base = ns1p/m (summed FF outputs), collector → casb, emitter via Re to 7.2 V |
| Re | Replica emitter degeneration | 1 | 4 | 35.3 Ω | — |
| Rr1 ×64 | Replica sum resistors | 64 | 256 | 10 kΩ | one per cell per rail: FF Q̅ → ns1p (p rail), FF Q → ns1m (m rail). **R114 (2026-09-27):** the replica senses the FF *pin*, whose levels are shifted by Rout × base-network current (≈25 Ω × 1.2/0.8 mA); that scale error is a static bow (34 ppm) absorbed by the in-situ LUT cal (gate 126 HD2 −128 / HD3 −135). Do NOT add any other load to Q/Q̅ — it changes the replica scale |
| Rsh | Replica node shunt | 1 | 4 | 156.25 Ω → **156 Ω E96** | ns1 node to 5.94 V bias; nominal for a 3.3 V pin swing — the real loaded swing is ≈3.25 V, residual taken up by the LUT (hw/reconcile.md G1) |
| Csh | Replica node C | 1 | 4 | 50 pF C0G | ns1 to GND |
| Mpad | 50 mA padding mirror, N-MOSFET | 1 | 4 | **Si1555DL** (N half) | drain = bus, gate = padb 0.6 V (shared), source via Rpad to −15 |
| Rpad | Padding source resistor | 1 | 4 | 286 Ω (≈0.7 W) | ~50 mA; N4 noise line 43 nV. **LOCKED 2026-10-09 (user): 4 × TE RQ73C2B1K13BTD in parallel — 1.13 kΩ, 1206, 0.5 W (DigiKey-verified), 0.1 %, 10 ppm precision thin film = 282.5 Ω (−1.2 % vs 286, irrelevant: PADB servo U907 sets the 50 mA); 12.5 mA / 0.18 W per leg = 36 % loading.** Rationale: thin film mandatory (excess noise under 14 V DC is in the N4 budget — thick film 0.1 %/25 ppm alternative rejected); 4 legs at ≤ 50 % loading spread the heat per the item 13 ruling and average 1/f noise; precision is free. Earlier 2 × 574/576 Ω 2010/2512 realisations (Vishay PAT constructed MPN, Cal-Chip 1 W 100 ppm) superseded. Item 13 RULED 2026-09-29: −15 V return stays, heat managed by placement. |
| Cpadb | padb bypass | 1/channel | 2 | 100 µF | shared across both rails |
| C_bus | Bus capacitor | 1 | 4 | **47 nF C0G** 50 V 1206, Murata GRM3195C1H473JA01D (`gen_kicad`) | (was 10 nF R24); casb noise → i = e·ωC_bus is the P6 mechanism — keep casb quiet |
| R_bleed | Bus bleed | 1 | 4 | 910 Ω | ≈1.9 mA |
| C_col | Summing-node RTZ slam absorber | 1 | 4 | **12 nF C0G** 50 V 0805, Murata GRM2165C1H123JA01D (`gen_kicad`) | 47 nF remains an available refinement (not adopted) |

Cell-array shared parts (per channel): R_bias 100 Ω + C_q4 220 µF on q4_base
(1.25 V ref → THAT300 tail bases), see §2.

---

# 4. I/V converter (Fig. 4) — P5 TIA, RATIFIED 2026-09-21 / LOCKED 2026-09-24

Per rail (×4 per unit). Transimpedance with the summing node (col) held at
**V_VG = 4.0 V**; R_f 270 Ω direct to **6.0 Vrms balanced** (per side
±4.25 V pk) — no reconstruction filter, no line V-stage (§5, §6 superseded).
R_off from the filtered +15F rail carries the cascode DC plus V_VG/R_f.

| Ref | Role | Qty/rail | Qty/unit | Part / value | Notes |
|---|---|---|---|---|---|
| U_iv | Front amp | 1 | 4 | **OPA1612AIDRGR** (DRG WSON-8 3 x 3 mm, thermal pad to V-) (single; dual footprint reserved for NPAR=2 fallback if bench FF jitter > 0.7 ps) | +in = V_VG 4.0 V ref; e_n sees R_off‖R_f (noise gain 2.4–4) |
| U_buf | Output buffer in the loop | 1 | 4 | **BUF634AIDDAR** (DDA HSOIC-8 PowerPAD, exposed pad to V-; 13 x 0.254 mm thermal vias per TI Figure 11-1) | C_f MUST hang on the buffer output (Cf from the op-amp output lets BUF634A i_n reach the output, +36 nV) |
| R_f | Feedback | 1 | 4 | **270 Ω 0.1%** thin film | — |
| C_f | Feedback | 1 | 4 | **1.3 nF C0G** (‖ R_f, 450 kHz) | = the old 28 Ω‖12 nF pole |
| R_off | DC injection from +15F | 1 | 4 | **p: 133 Ω / m: 116 Ω** (MIDCODE 32.5; 132.8/116.0 at 32) — **LOCKED 2026-10-09 (user): 4 × 536 Ω (E96) = 134.0 (+0.75 %, DC trim) / 4 × 464 Ω (E96) = 116.0 in parallel, TE RA73 0603 — aluminium-nitride substrate, 0.5 W @ 70 °C (datasheet 1773270-3; the series only exists in 0603), 0.1 %, 25 ppm, 75 V: RA73F1J536RBTD / RA73F1J464RBTD (both user-verified at DigiKey 2026-10-09)**; 21 / 24 mA per leg = 0.23 / 0.26 W = 46 / 52 %. **LAYOUT RULE: RA73 rating is "dependent on component mounting" — enlarged copper/thermal pads per the datasheet, in the items 13/14 chassis-coupled heat zone.** Fallback if cooler is wanted: 8 legs (1.07 k / 931 Ω E96 → 133.75 / 116.4 Ω) at 23 / 26 %. RQ73 1206 (Rpad's series) has no 536/464 Ω at 0.5 W | sized for the mean code incl. the +0.5 code idle-pattern offset — this nulls the offset DC at the summing node (no servo). With 0.1 % / 25 ppm: cal-time offset ≈ 22 mV and ≈ 22 mV drift over ~40 K self-heat (was ≈ 220 / 90 mV with 1 % / 100 ppm) — both inside the digital DC trim, no temperature re-trim needed (item 14). Thin film mandatory: noise gain × 3.2 into the summing node, 11 V DC across the part |
| R_ld | Output load (sim) | — | — | — | ~~600 Ω tap string for 6/4/2 V on K1/K2 relays~~ **STRUCK 2026-10-07: level is digital (§7)**; output = 600 Ω min external load via 10 Ω build-out + K4 |
| — | V_VG 4.0 V reference | 1/channel | 2 | buffered, ≤10 nV/√Hz | see §9 |

---

# 5. Reconstruction filter (Fig. 4b) — SUPERSEDED 2026-09-21 (ruling 2: R_f 270 direct to 6 Vrms; kept for record)

Per leg; **2 legs per channel, 4 per stereo unit**. 3rd-order Bessel,
f−3dB = 450 kHz, singly-terminated; exact synthesis (`bfdac_filt1.cir`).

| Ref | Role | Qty/leg | Qty/unit | Part / value | Notes |
|---|---|---|---|---|---|
| L1 | Series inductor | 1 | 4 | ~~77.6 µH air-core, DCR 1.5 Ω (custom wound)~~ **NOT BUILT — §5 superseded; no inductors on the board** | L = (5/6)R0/ωs; ±5% OK (delay 583–644 ns, flatness survives) |
| C2 | Shunt capacitor | 1 | 4 | **1.99 nF C0G** (e.g. 1.8 n + 180 p‖) | C = (12/25)/(R0·ωs); per leg to ground |
| L3 | Series inductor | 1 | 4 | ~~15.5 µH air-core, DCR 0.4 Ω (custom wound)~~ **NOT BUILT — §5 superseded** | L = (1/6)R0/ωs |
| R0 | Termination, tapped | 1 (string) | 4 | **150 Ω total, taps at 1/3 & 2/3** → 3× 50 Ω 0.1% string | taps = 2/4/6 Vrms level select (Fig. 4d); bridged by hi-Z V-stage |

**Layout rule:** air-core coils orthogonal orientation + spacing; keep away
from mains/rail magnetics.

---

# 6. Line V-stage (Fig. 4c) — SUPERSEDED 2026-09-21 (ruling 2: no line V-stage; kept for record)

Per leg; **2 legs per channel, 4 per stereo unit**. Same topology and
semiconductor MPNs as the HP front end (§8.1) with line-specific values.
Decks: `bfdac_vstage1/1b/1o/1n/1t/2/2b`. Fixed gain 1.769; never
relay-switched (level set upstream at the R0 taps).

| Ref | Role | Qty/leg | Qty/unit | Part / value | Notes |
|---|---|---|---|---|---|
| LTP pair | Input, low-noise NPN | 2 | 8 | ZTX851 (per §8.1) | 6 mA/side, **33 Ω degeneration** |
| Tail CCS | BJT tail | 1 | 8 | 2N5551 (per §8.1) | 12 mA |
| Mirror + QH | PNP mirror load + β-helper | 3 | 12 | 2N5401 (per §8.1) | **200 Ω degeneration** (HP uses 100 Ω), 22 k bleed |
| QV0, QV, QVC | Darlington VAS + cascode | 3 | 12 | 2N5401 / KSA992 (per §8.1) | QV 6 mA (Rev 130 Ω); cascode base +8 V |
| Miller | Compensation | 1+1 | 4+4 | 1 nF C0G + 100 Ω series | back to LTP output node |
| Diamond | Class-A output, m=3 | — | — | per §8.1 driver parts | Idq 25 mA; stoppers 22 Ω / 10 Ω |
| Zobel | — | 1+1 | 4+4 | 10 Ω + 100 nF | — |
| Rf | Feedback | 1 | 4 | 150 Ω 0.1% thin film 25 ppm | — |
| Rg | Feedback | 1 | 4 | 195 Ω → **use 196 Ω E96** (gain −0.03%, FPGA-trimmable) | matching sets XLR balance |

Min load 600 Ω differential. Verified: −140 dB THD @ 1 k, SNR 132.8 dB @ 6 V.

---

# 7. Output routing & relays (Fig. 4d) — **RELAY LOCKED: Omron G6K-2F-Y DC12 (user ruling 2026-10-08, re-affirmed 2026-10-09). Selection CLOSED — do not reopen.**

Per channel (×2 per unit). All relays **telecom-class, bifurcated Au
contacts** — **family RULED 2026-10-07 (user): Panasonic GN (AGN2xx)**; **variant set CONFIRMED 2026-10-07 21:52 (user): K4 = AGN200A12, K1/K2 = AGN210A12 + DRV8220** (see below). Switched only
while muted so contacts never break current.

**GN datasheet check (ASCTB13E 2022.10, `datasheets/Panasonic_GN_relay_mech_eng_gn.pdf`, read 2026-10-07):** the current catalog offers **only three operating functions — 0 single-side stable, 1 = ONE-coil latching, 6 = high-sensitivity single-side stable. There is NO 2-coil latching GN; "AGN220A12" is not in the 2022 catalog** (treat as discontinued / not orderable — the earlier from-memory ruling of a dual-coil AGN220A12 + ULN2003A is withdrawn). Verified figures: 2 Form C; contacts **AgPd + Au-clad stationary / AgPd movable**, 100 mΩ max initial, 1 A 30 VDC / 0.3 A 125 VAC, min load (ref.) 10 µA 10 mV; 12 V coil: single-side stable 1,028 Ω / 11.7 mA / 140 mW, operate ≤ 75 % / release ≥ 10 %; **1-coil latching AGN210\*12: 1,440 Ω / 8.3 mA / 100 mW, set & reset ≤ 75 % V (9 V)**, max allowable 150 %, "use within ±5 % of rated coil voltage"; operate/set and release/reset ≤ 4 ms; recommended set/reset pulse **≥ 10 ms at rated voltage**; 1,500 Vrms contact-coil; −40…+85 °C. **Size: 10.6 L × 5.7 W × 9.0 H mm (SMD max 10 mm) — a standing relay, so it misses the §7(5) ≤ 6 mm low-profile preference.** Suffixes: none = PC-board pins, **A** = SMD gull-wing (7.4 mm span), **S** = SMD H = 0.5 (5.7 span); **X/Z** = tape. Pins: 1–4 / 5–8 two rows at 2.2 mm pitch with a 3.2 mm gap, coil on 1/8 (polarised, "direction indication" bar = pin 1 side), 2 Form C on 2–4 / 5–7 (TOP-view schematic p.7).

**Decision needed (one of):** **(A) AGN210A12 single-coil latching + one bipolar (H-bridge) driver per relay** — e.g. TI **DRV8220** (4.5–18 V VM, 1.8 V-compatible logic inputs, SOT-23-8), 3 per channel / 6 per unit, 8.3 mA pulses from `V12SOM`, zero hold power, 9 mm tall; TB6612FNG dual bridge is the 2-relays-per-package alternative but its 0.7·VCC logic threshold does not take 1.8 V directly. **(B) TQ2SA-L2-12V** (Panasonic TQ-SMD, 2 Form C, 2-coil latching, 12 V, Au-clad Ag twin crossbar, 14 × 9 × **5** mm — from memory, datasheet to fetch) + one **ULN2003V12** per channel (6 low-side pulsed outputs, 1.8 V-logic version of the ULN2003A) — the original driver plan, low profile, not GN. **(C) AGN200A12 single-side stable + ULN2003V12** — simplest, but 6 × 140 mW = **0.84 W held** near the output stage (the heat criterion that made latching preferred). Recommendation: (A) if GN is a must, else (B).

**TECHNOLOGY RULED 2026-10-07 21:31 (user): electromechanical relays — NO MEMS at this point. DECISION MADE.** MEMS switch (ADI ADGM3144 SP4T / ADGM3121, datasheet Rev. 0 in `datasheets/adgm3144.pdf`, reviewed 2026-10-07) evaluated and rejected on datasheet numbers: (1) abs max ±7 V on / ±10 V stand-off on RF pins vs 48 V P48 phantom at the XLR (4.8× over; GN open contact 750 Vrms / 1,500 V surge); (2) RF-pin ESD **150 V HBM, Class 0B** at a human-touched connector (ADI text: add external protection — which puts a TVS in the −140 dB path); (3) open-only switch — cannot ground the muted output, so the §7 "disconnected AND grounded" rule fails (muted node floats on 10 MΩ; a bleeder stiff enough to matter breaks the 600 Ω min load); (4) only published linearity −103 dBc THD @ 0.88 Vrms/300 Ω vs the −140 dB target at 3 Vrms/300 Ω (37 dB short, unproven); (5) ΔRon 0.8 Ω max → 0.27 % leg imbalance vs the 0.1 % Rf/Rg matching budget (GN ≤ 0.1 Ω → 0.033 %). Secondary: VINH 2.0 V (level shifter from the 1.8 V bank), 10 MHz charge-pump feedthrough on the signal node, 80 V VCP next to the output, continuously-on wear-out (10 yr to 1 % at 85 °C). MEMS wins on held power (8 mW vs 100 mW), area (10×), cycles (10⁸) and off-isolation (−119 dB) — none of which is a binding constraint here, so they do not offset the abs-max failures. **Reopen only** for a MEMS part with ≥ ±50 V stand-off, ≥ 2 kV HBM on the RF pins and published THD ≤ −140 dB at ≥ 3 Vrms/300 Ω.

**Variant set — CONFIRMED 2026-10-07 21:52 (user: "if by math the electromechanical relay is best, we use it"; K4 recommendation honoured):** **K4 = AGN200A12 single-side stable** (NC contact = output shorted to GND with coil off → mute is guaranteed with no power, no FPGA, no pulse; 140 mW held per channel, 0.28 W/unit, inside the thermal budget) + **K1/K2 = AGN210A12 single-coil latching + DRV8220 H-bridge** (zero held power; taps are switched only while K4 mutes). Driver for K4: one low-side switch (ULN2003V12 channel or a logic-level MOSFET) with flyback to `V12SOM`; unmute asserted only by FPGA GPIO AND-ed with DONE and power-good. **High-sensitivity AGN26xA12 for K4 considered and NOT taken:** saves 40 mW/channel held (100 vs 140 mW) but drops ambient to −40…+70 °C and tightens operate to ≤ 80 % V; the 85 °C ceiling is worth more than 80 mW/unit in a ~20 W enclosure.

**LEVEL SELECT RULED 2026-10-07 22:14 (user: "go with your suggestion"): DIGITAL — K1/K2 and the R0 tap string are STRUCK.** Why: the R0 taps were the §5 filter termination bridged by a hi-Z V-stage, both removed by ruling 2 (2026-09-21); nothing replaced them, so §7 had no working level mechanism. Analysed alternatives: **(B) passive output divider** — Z_out = 0.222·R_s, −1.74 dB load-dependent at 600 Ω (R_s = 300 Ω/leg) or 71 mA rms per leg to fix it → rejected. **(A) switched R_f in the TIA loop** (parallel-add 540 Ω ‖ 0.67 nF → 180 Ω / 135 Ω ‖ 2.6 nF → 90 Ω, pole stays 450 kHz, loop never opens) — workable, but R_off sets I_off = I_DC + V_VG/R_f to hold the output at 0 V DC, so each tap also needs an R_off add (1,486 Ω / 371 Ω from +15F on the same contact) and the buffer DC sink rises 14.8 → 22.2 → 44.4 mA: **+0.77 W/unit at 4 V, +3.1 W/unit at 2 V held**, plus 4 latching relays + 4 DRV8220 + 8 networks. **(C) digital** — LEVEL register 0x02 becomes a cap on VOLUME 0x01; SNR 132.8 → 129.3 (4 V) → 123.3 dB0 (2 V) sim; N1 (≥ 120 dB0) is defined at 6 V so no MUST is touched, D1 improves at reduced level; zero parts, zero heat, frees P26/N29. **Chosen: (C).** RTL follow-up: `relay_level[1:0]` ports idle (pins stay in the XDC, no-connect on J1), LEVEL → digital gain cap sequenced by automute as today. **DONE 2026-10-09 (RTL):** LEVEL 0x02 is a 3-bit code — **000 = 2 V, 001 = 4 V, 010 = 6 V, 011 = 0.6 V, 100 = 0.2 V rms** (0.6 / 0.2 added 2026-10-09 after the dCS Vivaldi comparison; user ruling: free, so add them). Implementation: `automute_controller` applies the code only in ST_SWITCHING (muted + force-zero, so a 10–30 dB gain step is click-free); `vu13p_dac_top` maps it to a Q0.16 gain {×1/3, ×2/3, ×1, ×1/10, ×1/30} and folds it into the boot-envelope word the `dac_dsp_core` volume multiplier already consumes (one 16×16 DSP; DSP core untouched). Two latent bugs fixed on the way: the level was reset to 2 V on every mute/i2s_err/rate change, and a LEVEL write made while muted was lost (req pulse swallowed) — pending is now `target != applied`, state resets only on `rst_n`. **SNR at the XLR by level (analog floor ≈ 1.4 µV rms is fixed, the signal shrinks): 132.8 / 129.3 / 123.3 / 112.8 / 103.3 dB0 at 6 / 4 / 2 / 0.6 / 0.2 V.** N1 (≥ 120 dB0) is defined at 6 V and is untouched; the low levels exist as a safety cap / volume-range convenience for direct-to-power-amp use, where 1.4 µV is already at or below the amp's own input noise. tb_automute (+4 checks) and tb_spi_ctrl_plane (CTRL_STATE layout now `{clk_src[5], base_rate[4], outsel[3], level[2:0]}`) ALL PASS.

**§7 SHEET REALISED 2026-10-07 (`out.kicad_sch`, gen_kicad `OUT_PARTS`):** per channel **R670/R671 (L), R672/R673 (R) = 10 Ω RG1608P 0.1 % build-out** outside the TIA loop (default, revisit; −0.14 dB into 600 Ω) → **K601/K602 AGN200A12** (local symbol, pins coil 1(+)/8(−), COM 4/5, NC 3/6, NO 2/7 — **VERIFY against ASCTB13E p.7**; SMD footprint TODO): COM = XLR pin, NO = build-out, NC = GND → **J601/J602 XLR3** (~~Neutrik NC3MAH placeholder~~ **NC3MD-H-B locked 2026-10-10**, pin 1 + shell to GND). **U602 SN74LVC1G11** at V18 (1.65–5.5 V part): `RLY_LINE_MUTE` (J1 R28) AND `FPGA_DONE` (**J2 A1 VUP_SELECTMAP_DONE**, new carrier pin, 1.8 V bank 0 — VERIFY the SoM's DONE pull-up) AND `PG_A15` (analog ±15 V power-good, **placeholder from the power sheet**, R674 10 k to V18 holds it high until drawn) → `UNMUTE_EN` → **U601 ULN2003V12** (SOIC-16, 1.8 V inputs, COM = V12SOM flyback; ch 1/2 = K601/K602, inputs 3–7 to GND, outputs 3–7 NC) → coils from `V12SOM`. C601 100 n. Checks: xcheck PASS 1300/542 both channels, ERC 2 (CASB2 notes), netlist `OUT_P_L → R670 → K601.2`, `KC_L = K601.8/U601.16`.

**K4 PART CHANGED 2026-10-08 (user): AGN200A12 → Omron G6K-2F-Y DC12.** Reason: no usable Panasonic pin map or SMD footprint drawing could be found (the GN datasheet text has coil 1/8 and contact triples 2–4 / 5–7 only); the user's best reading of the GN diagram — **COM 3/6, NC 2/7, NO 4/5** — is exactly the map decoded from the KiCad `Relay:G6K-2` symbol graphics (armature rests on the filled NC contact), so the two sources agree and the G6K (same industry 8-pin family) comes with a library symbol **and** footprint `Relay_SMD:Relay_DPDT_Omron_G6K-2F-Y`. Trade: 12 V coil 1,440 Ω / 8.3 mA / **100 mW** held (−40 mW/channel vs GN) against a **70 °C ambient ceiling** (GN 85 °C) — accepted because K4 sits at the rear-panel/XLR edge, the coolest zone of a ~20 W enclosure (expected internal air ≈ room + 15–25 K); the §20 TMP117 "ambient" sensor validates this on the prototype. Datasheet figures above are from memory — **VERIFY coil R / contact material / min-load against en-g6k.pdf**. Generator: `OUT_PARTS["k4"]`, K601/K602 now `Relay:G6K-2` pins 1 (+coil, V12SOM) / 8 (coil, ULN) / 3,6 (COM → XLR 2,3) / 4,5 (NO → build-outs) / 2,7 (NC → GND); local AGN200A12 symbol removed. xcheck PASS, ERC 2, netlist `XLR_HOT_L = J601.2/K601.3`, `OBP_L = K601.4/R670.2`.

**Fixed either way:** ~~coil net = `V12SOM` branch~~ **coil net = `V33RLY` (dedicated TPS7A2033 from the 4.0 V pre-reg, 2026-10-10 — 12 V is SoM-only, item 17(l))**; FPGA set/reset pulse ≥ 10 ms per datasheet → use 20 ms; the fail-safe rule below applies in full for (A)/(B) (power-on reset pulse to *muted*, state survives power loss). One DPDT handles both legs of the balanced output, so K1/K2/K4 stay one package each.

**Selection criteria (2026-10-05, user: heat is a criterion — item 17):** (1) **coil heat** — non-latching telecom relays hold 100–200 mW each; 3 relays/channel held continuously = 0.6–1.2 W/unit of steady heat near the output stage. **Latching (bistable) preferred**: zero holding power, coil energised only for the 10 ms set/reset pulse (candidates: Omron G6KU-2F-Y, TE Axicom IM41/IM42 (single/dual coil), Panasonic TQ2-L/TX2-L, Kemet EC2-L). Latching changes the driver (dual-coil or H-bridge pulse driver, e.g. TBD62783/DRV8838-class, or ULN2003A with pulse timing in the FPGA) and the fail-safe rule below. (2) Contact: bifurcated Au-clad, ≥ 1 µA / 10 mV dry-circuit rating, thermal EMF ≤ ~1 µV (both contacts of a Form C pair same material — DC offset into the 6 Vrms output). (3) 2 Form C where the unused side must be grounded (K3/K4 rule). (4) Coil voltage decides the rail: 5 V coil from `V5AP`/digital or 12 V from `V12SOM` (item 17(a)); 3 V coils draw more current. (5) Sealed (wash-tight) not required; low profile (≤ 6 mm) preferred for the lid clearance.

| Ref | Function | Qty/ch | Qty/unit | De-energised / reset state | FPGA pin (XDC) |
|---|---|---|---|---|---|
| ~~K1, K2~~ | ~~Level taps (R0 string, 2/4/6 Vrms)~~ | — | — | **STRUCK 2026-10-07 — level is digital (see ruling above)** | P26/N29 no-connect, RTL ports idle |
| ~~K3~~ | ~~Input select (line/HP), DPDT~~ | — | — | **STRUCK 2026-10-05 — no HP path to select** | pin was shared, none freed |
| K4 (K601/K602) | Line mute, **Omron G6K-2F-Y DC3** (DC12 → DC3 2026-10-10; was AGN200A12, changed 2026-10-08) | 1 | 2 | NO open + NC shunt to GND (muted) | `relay_line_mute` (R28) via U602 gate; coil 91 Ω / 33 mA / 100 mW on `V33RLY` | **Re-confirmed 2026-10-12 (user):** stays NON-latching - held 100 mW/ch accepted; latching K4 rejected (cannot guarantee NC on power loss), coil-economiser PWM rejected (noise on the coil rail at the XLR).
| ~~K5~~ | ~~HP mute~~ | — | — | **STRUCK 2026-10-05 (§8 removed)** | T28 FREED |
| ~~K6~~ | ~~HP rails~~ | — | — | **STRUCK 2026-10-05 (§8 removed)** | N26 FREED |
| U601 | Relay coil driver, ULN2003V12 | ½ | 1 | — | one package for both K4 coils (ch 1/2), flyback COM to `V33RLY`; **DRV8220 H-bridges dropped with K1/K2** |
| U603 | Relay-coil LDO, **TI TPS7A2033PDBVR** (3.3 V, 300 mA, SOT-23-5) + C602/C603 1 µF | ½ | 1 | — | **ADDED 2026-10-10 (user):** `V4P0` (4.0 V pre-reg) → `V33RLY`, coils + ULN COM only. **EN = `UNMUTE_EN`** (V_EN(HI) 0.9 V max vs ≥ 1.65 V from U602; internal 500 k pull-down) → the coil rail does not exist until DONE ∧ PG_A15 ∧ GPIO: a second hardware mute path that survives a shorted U601 output. Keeps the 33 mA coil steps and flyback energy off `V33D` (TMP117 / ISO1640). V_DO 140 mV max @ 300 mA; t_start 0.75–1.15 ms. `datasheets/TI_TPS7A20.pdf` |
| U602 | Unmute gate, SN74LVC1G11 @ V18 | ½ | 1 | — | `relay_line_mute` AND `FPGA_DONE` (J2 A1) AND `PG_A15` (power sheet placeholder, R674 pull-up) |
| R670–R673 | Build-out 10 Ω 0.1 % | 2 | 4 | — | outside the TIA loop, default value — revisit with cable/ESD plan |
| J601/J602 | XLR3 male | 1 | 2 | — | **Neutrik NC3MD-H-B — LOCKED 2026-10-10 (user: metal shell, black):** D-size zinc die-cast shell, black KTL, gold contacts, horizontal PCB mount (board perpendicular to the rear panel), latch lock, UL. Male is correct for a source (signal flows out of male pins; MHA200's female jacks are inputs / headphone outputs). Footprint `bfdac:Neutrik_NC3MD-H` from Neutrik drawing S1-NC3MD-H (`datasheets/NC3MD-H-B/`): pins 2/3/1 at −4/0/+4 mm, G 5 mm behind pin 3, Ø1.2 holes (Ø2.0 pads), Ø2.3 NPTH locating peg 5 mm in front; pin row 22.5 mm behind the panel rear face; **flange 31 mm tall centred 12.5 mm above the board → reaches 3 mm below it: board edge ≤ 20.2 mm in front of the pin row** (User.1 marker at 19.7). Pin 1 + shell to GND on the sheet; chassis-vs-signal ground split still a grounding-plan decision (shell bonds to chassis through the panel screws). Was NC3MAH placeholder (plastic A-series) |
| TP3xx–TP17xx | Test points — **DRAWN 2026-10-12 (progress.md mandate):** `Connector:TestPoint`, 138 total (2026-10-14: four dedicated summing-probe GND pads added). Signal/clock/cell-drive/summing nodes → `TestPoint:TestPoint_Pad_1.0x1.0mm` behind a 1 kΩ isolation stub (TNPW06031K00FEEA ×16: IV R688/R689, CLKR R845–R847, FPGA R327–R329, XLAT R470–R475); rails/refs/control/GND → `TestPoint:TestPoint_THTPad_2.0x2.0mm_Drill1.0mm`. Every bank ends in GND pads (rule d); COL_P/M also have dedicated 1 mm SMD GND pads: L TP987/988 via R688/689 with GND TP992/993, R TP787/788 via R788/789 with GND TP792/793. The 1k tap limits, but does not eliminate, probe loading (10 pF gives ~16 MHz); low-C active probe, no 50-ohm termination. Measure per-cell current contribution from settled pre-relay OUT_P/M baseline/test deltas using the independent L/R RTL diagnostic commands, not from the nominally fixed summing-node voltage | — | — | — | coverage: POWER 9, REFS_L 22 / REFS_R 19, IV 13/ch, CLKR 7, FPGA 5, XLAT 11, CTRL 15, SOM 12, OUT 12 — every rail, every reference, representative DAT/MCLK leaves, COL_P/M summing nodes, OUT_P/M, full control handshake set. Layout review (rule e: keep-outs vs match/capacitance budget) is a placement-time item, not drawn |

**Bring-up controls and indicators — LOCKED/DRAWN 2026-10-14.** BRINGUP sheet: SW9000 SELECT and SW9001 STEP = Würth 434133025816 tactile switches, 10k pull-ups to SoM V18 and 1k GPIO series resistors. SELECT press count in 3 seconds chooses CELL/DC/FREQUENCY; STEP advances one held condition, extra STEP after final R condition completes, 2-second SELECT hold cancels. Test LED D9023 = Kingbright APT1608LSECK/J3-PRV red 0603, nominal 500uA from V12SOM through 20k (user-approved current revision), Q9001 MMBT3904 sink with 10k base and 1M base-emitter pull-down; continuous 1/2/3 Hz while active, off after completion/abort. Digital-side placement only. M29/L29/L28 = SELECT/STEP/LED; N29 PG_ALL corrected to RTL input (old unused relay_level[1] moved to K28). XLR remains muted for every local test.

**Rail-presence indicators:** D9000–D9026 cover three shared pre-reg rails (P16A/N16A/V8P3), five V4P3 branch rails (LA/LB/LC/RA/RB), twelve per-channel POL rails, V12SOM, V33CLK, V33FF_L/R, V33D, V33RLY and VAP_IO. Negative-rail LEDs have anode at ground and resistor return to the negative rail. VAP_IO LED returns ONLY to GND_AP. D9027 senses V18 via 10k into Q9000, its 500uA LED current supplied by V12SOM through 20k (1.8V cannot guarantee direct LED headroom); D9028 is the TEST_ACTIVE flasher. VAP18/VAP09 carry NO presence LEDs (user ruling 2026-11-01: remove LEDs on the 1.8 V / 0.9 V rails — probe them on the AP-sheet TP bank TP852-TP860 instead). V18 sensing loads V18 by roughly 100uA in addition to the LED's separate V12SOM load. Nominal LED current ~500uA using Vf≈1.8V; exact current/visibility varies with Vf, rail voltage and temperature, and must be checked on first article (LED light-output specification is at 2mA). Locked direct-LED resistors: 28.7k at ±16.2V; 26.7k at ±15V; 20.5k at 12V; 13k at 8.3V; 10.7k at 7.2V; 4.99k at 4.3V; 3.01k at 3.3V. VAP_IO uses 3.01k: nominal 500uA at 3.3V, approximately 150uA at 2.25V with the same assumed Vf, hence dimmer. The 100uA target in earlier progress entries is superseded. No precision-reference/SET/bias/summing-node LEDs. Keep steady during normal measurements; the current-setting resistor doubles as a removable isolation component for comparisons. Place indicators near their rail source/entry; shared pre-reg presence does not prove continuity of BOTH parallel entry connectors. These are presence hints, not power-good comparators or voltage measurements. Source: https://www.kingbrightusa.com/images/catalog/SPEC/APT1608LSECK-J3-PRV.pdf .

Rule: unpowered-stage input must be relay-disconnected AND grounded (b-c
junction to collapsed rails clamps at ~0.6 V). ~~With latching relays the
de-energised = muted guarantee is lost~~ — **moot 2026-10-07: no latching relays
remain; K4 is single-side stable, coil off = NC shunt = muted, and the I/V output
sits at 0 V DC (R_off null) so unmute is thump-free.** Now 1 relay/channel (was 6).

---

# 8. Headphone amplifier (Fig. 4e, Rounds 19–20) — REMOVED 2026-10-05 (user: total power/heat; feature dropped for this version. Kept for record.)

**Consequences:** §7 K3/K5/K6 struck (FPGA pins T28, N26 freed); §9 HP rails and
§17(a) HP power deleted; thermal model 17(k): the **41.9 W "HP on" case and the
7–14 K HP step disappear** — the unit is a 19.9 W line-out design with only the
ambient/warm-up (≤ 5 K) excursion, so the QR1 compensator and CASB2 servo now
run with large margin (they stay: lot spread, warm-up, and the per-board trim
they remove). The HP-amp radiator ruling of 2026-10-01 is moot; the I/V and
FF/clock radiators stand. Front panel loses the HP jack.

Per `bfdac_hp1/hp2` decks. One leg as listed. **Stereo unit = 4 legs**
(2 bridged legs x 2 channels). Qty columns give per-leg and per-stereo-unit counts.
All primary MPNs chosen for ACTIVE production status as of selection date —
verify stock before ordering; alternates listed in preference order.

## 8.1 Semiconductors

| Ref (deck) | Role | Qty/leg | Qty/unit | Primary MPN | Pkg | Alternates | Notes |
|---|---|---|---|---|---|---|---|
| QI1, QI2 | LTP input, low-noise NPN (`QLN`) | 2 | 8 | ZTX851 (Diodes Inc) | TO-92 (E-Line) | BC550C x2 paralleled (onsemi); KSC1845F | rbb' <= 3R required to hold 3.3nV floor. ZTX851 rbb' ~1.7R, 60V Vceo OK on +/-15V. Match Vbe pairs to <2mV |
| QT | Tail current source NPN | 1 | 4 | 2N5551 (onsemi) | TO-92 | PN2222A; KSC2690A | Jellybean, multi-source |
| QP1, QP2, QH | Mirror + beta helper PNP (`QMPNP`) | 3 | 12 | 2N5401 (onsemi) | TO-92 | BC556B; KSA992 | Match QP1/QP2 from same tape |
| QV0, QV, QVC | Darlington VAS + cascode PNP (`Q5401`) | 3 | 12 | 2N5401 (onsemi) | TO-92 | KSA992; KSA1220A for QV if dissipation concern | QV runs 10mA/~7V = 70mW, TO-92 OK |
| QLV, QL0 | VAS current-source load NPN | 2 | 8 | 2N5551 (onsemi) | TO-92 | PN2222A | — |
| QA | Diamond driver NPN (m=2 in sim) | 1 | 4 | KSC2690A (onsemi) | TO-126 | TTC004B; 2x 2N5551 paralleled | Single medium-power part replaces m=2. Mount on main heatsink (Vbe tracking, see progress Round 19) |
| QB | Diamond driver PNP (m=2 in sim) | 1 | 4 | KSA1220A (onsemi) | TO-126 | TTA004B; 2x 2N5401 paralleled | Complement of QA, same heatsink |
| QD | Output power NPN (`QPWN`) | 1 | 4 | TTC004B (onsemi) | TO-220F | 2SC5171; MJE15032 (fT 3x lower — MUST re-run PM/osc decks first) | 2.4W idle class-A, isolated tab, heatsink required (~2C/W per channel) |
| QC | Output power PNP (`QPWP`) | 1 | 4 | TTA004B (onsemi) | TO-220F | 2SA1930; MJE15033 (same fT caveat) | Complement of QD |

## 8.2 Resistors

| Ref | Value | Qty/leg | Qty/unit | Type / MPN class | Notes |
|---|---|---|---|---|---|
| Re1, Re2 | 33R | 2 | 8 | 0.1% thin film 0805 (Vishay TNPW / Susumu RG) | LTP degeneration — matching sets gain balance |
| Rm1, Rm2 | 100R | 2 | 8 | 0.1% thin film | Mirror degeneration — matching sets offset |
| Rhb | 22k | 1 | 4 | 1% thick film | Helper bias |
| Rbl | 1k | 1 | 4 | 1% thick film | Darlington leak |
| Rev | 130R | 1 | 4 | 1% thin film | VAS current set — value is compliance-critical (Round 16 latch rule) |
| Rle, Rl0 | 120R | 2 | 8 | 1% thin film | VAS load CCS set |
| Rset | 4.7k | 1 | 4 | 1% thick film | CCS reference |
| Rmc | 100R | 1 | 4 | 1% thick film | Miller zero |
| RbA, RbB | 22R | 2 | 8 | 1% thick film | Driver base stoppers |
| RbC, RbD | 4.7R | 2 | 8 | 1% thick film 1206 | Power base stoppers |
| Red, Rec | 0.47R | 2 | 8 | 1206 thick-film current-sense, 0.25-0.5W 1% (Panasonic ERJ / Vishay CRCW-HP / Bourns CRA) | Dissipation only ~12mW quiescent, ~17mW full power — jellybean chip part. Sets Idq=162mA |
| Rz | 10R | 1 | 4 | 1W metal film | Zobel |
| Rf | 150R | 1 | 4 | 0.1% thin film 25ppm | Feedback — THD/gain critical |
| Rg | 195R | 1 | 4 | 0.1% thin film — **195R is not E96: use 196R (gain -0.03%, FPGA-trimmable) or 390R x2 parallel** | Feedback — matching across legs sets bridge balance (0.5% tested OK, 0.1% better) |

## 8.3 Capacitors

| Ref | Value | Qty/leg | Qty/unit | Type | Notes |
|---|---|---|---|---|---|
| C_m | 1nF | 1 | 4 | C0G/NP0 50V 0805 (TDK/Murata/Kemet) | Miller comp — value verified, do not substitute X7R |
| Cz | 100nF | 1 | 4 | Film PP/PET 63V (Wima MKS2) or C0G 50V | Zobel |

## 8.4 Bias networks — realized and verified (bfdac_hp4, Round 20)

| Ref | Function | Qty/leg | Qty/unit | Part | Notes |
|---|---|---|---|---|---|
| Dln, Dlp | LED voltage references (Vf ~1.8-2.0V) | 2 | 8 | Any jellybean green LED, 3mm/0805 (e.g., Kingbright) | Rail-tracking refs: tail/bias currents immune to rail sag |
| Rln, Rlp | LED feed, 2.7k | 2 | 8 | 1% thick film | ~4.9mA LED current |
| Cln, Clp | LED bypass, 100uF 25V | 2 | 8 | Alu electrolytic or polymer | LED noise filter |
| QCA / QCB | Diamond bias CCS | 2 | 8 | 2N5551 / 2N5401 | Replaces ideal Iba/Ibb (13.6/14.1mA) |
| Rea, Reb | CCS set, 75R | 2 | 8 | 1% thin film | — |
| Rte | Tail CCS set, 91R | 1 | 4 | 1% thin film | Tail 11.3mA (replaces Vtb + 900R) |
| Rc1, Rc2 | Cascode divider 3.3k/3.9k | 2 | 8 | 1% thick film | 8.1V ref (replaces Vbcas) |
| Cc1 | Cascode bypass, 10uF | 1 | 4 | X7R 25V or film | — |

Verified with full battery: THD/stability/temp corners unchanged vs ideal
sources (progress.md Round 20). Remaining schematic-level item before layout:
relay/mute interface.

## 8.5 Availability review flags

- **ZTX851** — single-source (Diodes Inc). If unobtainable: BC550C paralleled is the fully-jellybean fallback (noise re-sim recommended, expect ~+0.3dB).
- **KSC2690A/KSA1220A** — legacy Fairchild lines under onsemi; verify lifecycle status. TTC004B/TTA004B are the drop-in alternates and are shared with the output position (BOM consolidation option: use TTC004B/TTA004B for BOTH driver and output = one NPN/PNP power part number).
- **TTC004B/TTA004B** — onsemi active, but single-source. MJE15032/33 are the multi-source fallback pending a PM re-sim.
- All TO-92 small-signal parts are multi-source jellybeans.

---

# 9. Supplies & references (Fig. 5)

Rail filter feeds **R_off only** (offset injection, the sensitive path); raw
±15 feeds diamond buffers and current pads. One filter per rail polarity per
channel (+15F and −15F identical).

| Ref | Role | Qty/rail | Qty/unit | Part / value | Notes |
|---|---|---|---|---|---|
| R9a | Series element | 1 | 4 | 0.01 Ω | — |
| L9a | Series inductor | 1 | 4 | 30 nH | — |
| FB9 ‖ R9b | Ferrite bead + damp | 1+1 | 4+4 | bead 1 µH ‖ 100 Ω | damped — no bead resonance |
| C9a | Bulk | 1 | 4 | 10 µF | at +15F node |
| C9b | HF | 1 | 4 | 100 nF, 0.01 Ω ESR | — |
| U9x | ±15 V LDO rails, VEE15, V_ROFF (+15F LDO), **VP10** (+10 V pre-reg for U906/U908) | — | — | **power sheet — item 17(d)**; V_ROFF = LT3045-class 10 nV/√Hz LDO from the +17 pre-reg + the R9a/L9a/FB9/C9 filter above | the refs sheet consumes these via PWR_FLAG inputs only (KiCad `refs.kicad_sch`, rails table) |
| — | **Reference ladder — REALISED 2026-10-06** (`utils/gen_kicad.py` REFS_PARTS / refs sheet, xcheck PASS, ERC clean): one **REF7050** → R902 4.99 k + C904 **10 µF film** (3.2 Hz) → U902A **OPA1656** FET buffer = `REF5F` → dividers → buffers / servos | 1 chain | **1 per board** (ONE REF7050; the R channel's REF5 comes from the same part — derived req. 6) | REF7050QFKHT (LCCC-8, 2 ppm/°C, 0.23 ppm p-p, 55 nV/√Hz, 10 mA), VIN from P15A via 10 Ω/10 µF; film C (WIMA MKS2 10 µF 50 V) chosen over UKL/X7R: no leakage-vs-temperature ratio error, no class-II piezo on the master node; FET buffer so 5 k source × I_b < 0.01 % | Divider set-point errors are static E96 residues inside the 17(i) columns: V_VG +0.08 %, VREF −0.15 %, VFR −0.14 %, VCM −0.10 %, VE1 +0.14 %, CASB2 tap +0.07 %, PADB −0.2 %. Dividers from `REF5F`: **RG1608P 0.1 % 25 ppm** discretes for V_VG (2.49 k/10.0 k), CASB2 tap (4.02 k/6.04 k), PADB tap (2.87 k/7.15 k); **Vishay ACAS 0612 AT** matched arrays (ratio 0.05 %, 5 ppm/K tracking; 2 of 4 elements used, 2 NC) for VFR (1.18 k/634 — low-Z after sim), VCM (7.32 k/2.69 k), VREF (15.0 k/4.99 k), VE1 gain (4.42 k/10.0 k). **VERIFY** ACAS ordering-code format and MKS2 MPN before purchase |
| U903 | **V_VG 4.000 V** + **VREF 1.250 V** buffers | 1 dual | 2 | OPA1612AIDRGR (DRG WSON-8, EP to V-), unity, 10 Ω + 47 µF UKL + 1 µF C0G at each node | V_VG noise: divider 2 k‖ → 5.8 nV + 1.1 nV amp + 2.9×0.8 nV from REF5F ≈ 6.6 nV/√Hz ≤ 10 ✓; VREF ≤ 55 trivially |
| U904A, Q901 | **VFR 1.75 V sink** (absorbs the 150 mA replica current) | 1 + 1 | 2 | OPA1612AIDRGR (DRG WSON-8) A PI error amp (**vfr on +in**, ref on −in via 1 k, 1 µF film + 100 Ω from the output) → 100 Ω → BCP56-16 (SOT-223) collector on VFR, 2.2 Ω emitter → GND; **D903 BAT54 from the op-amp output to GND** (output cannot go below −0.4 V → Q901 V_EB(rev) ≤ 0.4 V vs 5 V abs-max, and the PI cap cannot wind up); 100 µF UKL + 1 µF C0G; divider **1.18 k/634** (ACAS) | P = 1.4 V × 150 mA = **0.21 W** in Q901 (wall zone, 17) — the one real power device on the sheet, hence SOT-223. **SIM 2026-10-07 (`utils/refs_loop.py` vfr, Nexperia BCP56-16 + BAT54 models, OPA1612 I_sc modelled): f_c 480 Hz, PM 96°, T(1 Hz) 74 dB; 5.5 nV/√Hz @ 10 Hz (first draft with the 11.8 k/6.34 k tap and 10 k/100 n PI gave 28 nV — i_n × 14 k — hence the low-Z tap); realistic start-up (ref and current together) max 1.748 V, no overshoot; STRESS (current 40 ms late) peaks 2.6 V for ~10 ms then settles ±0.1 % 15 ms later; op-amp/base min −0.41 V in both, clamp current 35 mA.** First draft had the sink polarity inverted (vfr on −in) — caught by the sim |
| U904B, Q903/Q904/Q905 | **VCM 1.345 V** bidirectional class-A buffer (±24 mA RTZ-edge current) | 1 + 3 | 2 | OPA1612AIDRGR (DRG WSON-8) B error amp → 47 Ω → V_be multiplier (BC847B, 1.43 k/1.0 k, 470 Ω pull-up from **+3V3A**) → **BC817-40 up / BC807-40 down (SOT-23)**, 2.2 Ω emitters → 2.2 Ω → VCM node (10 µF + 100 µF UKL); feedback from the VCM node | **SIM 2026-10-07 (refs_loop vcm, Nexperia models, 3.3 V rail): f_c 373 kHz, PM 160°, T(1 kHz) 81 dB; |Z_out| 4.6 µΩ / 0.11 mΩ / 1.1 mΩ / 12 mΩ / 21 mΩ @ 10 / 1 k / 10 k / 100 k / 1 MHz; 5.8 nV/√Hz; 23 mA × 50 ns RTZ pulses → +0.07 / −0.33 mV; I(Q903)/I(Q904) 41/65 mA with the 23.7 mA load sunk (class A held, I(Q904) min 64 mA); P(Q903) 0.079 W, P(Q904) 0.075 W.** 2026-10-07 ruling (user: "why such a large transistor?"): the pair only needs to source/sink ±24 mA around ~40 mA I_q — the SOT-223 parts were sized for 5 V × 40 mA = 0.2 W each; dropping the rail to 3.3 V halves that, so SOT-23 (≈ 0.25 W rated, θ_JA 250 K/W → +20 °C) is sufficient. Q905 thermally coupled to Q903/Q904. Replaces the 2026-09-26 "OPA1678 from the FF 3.3 V LDO" sketch (that rail is the noisy FF rail; VCM is now on the common REF5F chain) |
| U905A, RN927, U906 | **VE1 7.20 V / 150 mA** source | 1 + 1 + 1 | 2 | OPA1612AIDRGR (DRG WSON-8) A non-inv ×1.442 from REF5F (ACAS 4.42 k/10.0 k) → **LT3045EMSE SET** (stiff drive: LT3045 reference-noise term removed, C_SET 100 n) ← VP10; 10 µF X7R + 100 µF UKL out | (10 − 7.2) V × 0.15 A = 0.42 W in U906 (wall zone). ILIM/PGFB strapping **VERIFY** |
| Q902, R928/R929, U905B | **VB1 5.94 V** replica-node bias — **V_eb compensator (17(k)(d))** | 1 + 2 + 1 | 2 | VE1 → R928 57.6 Ω → **2SA1036K diode-connected** (same type/lot as QR1 Q7/Q8, placed touching them) → R929 590 Ω → GND (I ≈ 10 mA; R928 **59.0 Ω** after sim: VB1 5.947 V at 25 °C with the Rohm model) → OPA1612AIDRGR (DRG WSON-8) B unity → 10 Ω + 47 µF UKL + 1 µF C0G | dVB1/dV_eb = −R929/(R928+R929) = −0.91. **SIM 2026-10-06 (refs_loop vb1, DC temp −20…90 °C, QR1 replica Re 35.7 at 16 mA): I(QR1) tempco +0.039 %/K compensated vs +0.435 %/K with a fixed 5.94 V → 11×; dVB1/dT +2.43 mV/K.** Static V_eb spread absorbed by the ID campaign. VB1 ≤ 20 nV: 57.6‖590 → 1 nV + 2SA shot noise ≈ 2 nV + amp 1.1 ✓ |
| U902B, D901 | **CASB2 servo** (ruled 2026-10-01, gate 2026-10-02 — see row below) | ½ + 1 | 2 | OPA1656 B half: −in ← mid_p via 2 × 499 k + 1 n, +in = 3.002 V tap, C_i 1 µF film, out → 100 Ω → shared CASB2 node (100 µF UKL) → Rg6_p/m stoppers on CORE; BZT52C6V2 clamp | `mid_p` and the shared node are global nets in the capture; `kicad_xcheck` MERGE {casb2_m→casb2_p} documents the deliberate join |
| U907, D902 | **PADB current servo** (derived req. 4: 50 mA independent of VEE15 and Si1555 V_th) | 1 dual + 1 | 2 | OPA1656: A = diff-amp 0.25 × (padb_ep − VEE15) [4 × RG1608P 40.2 k/10.0 k] = 3.575 V at 50 mA; B = integrator (100 k / 1 µF film) vs 3.568 V tap → 1 k → PADB_BASE (Cpadb 100 µF on CORE); BZT52C2V7 clamp | **SIM 2026-10-06 (refs_loop padb): f_c 0.38 Hz, PM 103°, T(9 kHz) −86 dB; padb_base noise 1.7 nV @ 10 Hz, 0.14 nV @ 100 Hz; start-up (VEE15 ramp) I_pad peak 55.6 mA on the clamp, settles ±1 % in 1.2 s, final 50.15 mA p and m, gate 0.66 V.** First draft had the diff-amp inputs mirrored (PD_OUT = −3.57 V, loop railed) — caught by the sim; padb_ep now on the + side. p/m share the gate, I_m = I_p ± Mpad V_th mismatch (static, calibrated). Replaces the fixed 0.6 V gate bias |
| U908 | **+3V3A** rail for the VCM output pair (net `p5a` in the capture — was 5 V until 2026-10-07) | 1 | 2 | LT3045EMSE, SET 33.2 k RG1608P + 4.7 µF (3.32 V), from VP10; 10 µF + 100 µF UKL | ≈ 50 mA, (10 − 3.3) × 0.05 = 0.34 W in U908 (wall zone) |
| — | Loop verification | — | — | **`utils/refs_loop.py` (2026-10-06): VFR / VCM / PADB loops + VB1 compensator — all PASS after three corrections (VFR polarity + low-Z tap, PADB diff-amp sides, R928 59.0)**; CASB2 loop gated earlier (`utils/servo_loop.py`) | **2026-10-07 re-run with the Nexperia vendor models (`hw/models/nexperia_bjt.lib`: BCP56-16, BCP53-16, BC847B, BC817-40, BC807-40, BAT54) and the op-amp output-current limit modelled — all four PASS, numbers in the rows above.** Start-up ordering ruling: **no sequencer IC**. The VFR sink is the only block that can be hurt by ordering (replica current before the ±15 rails → Q901 base pulled below GND, PI cap winds up); the BAT54 clamp bounds it to −0.4 V, and the stress case (current 40 ms late) shows a 2.6 V / 10 ms excursion on VFR that the M5 gates follow harmlessly (Si1555 V_GS abs-max ±8 V). VCM / PADB / CASB2 servos all start from zero with their clamps (D901/D902) and were simulated with rails ramping from 0 |
| — | **VCM 1.345 V base-network rail** (2026-09-26, replaces the 1.00 V / 1.85 V figures) | 1 ref | 2 | realised above (U904B stage) | Thevenin return for the 128 §1.2 networks; net current constant 24 mA sink per channel (complementary drive); noise is common-mode at the pairs |
| — | ~~1.00 V steering-bias rail~~ ~~2.49 V offset rail~~ ~~THR_D 2.15 V~~ ~~THR_CLK 2.31 V~~ | — | — | **STRUCK 2026-09-26** (hw/reconcile.md 2) | EP52 differential-input era; no consumer with the single-ended LVC1G74 |
| — | **casb2 4.37 V** realisation (2026-09-26, hw/reconcile.md 6) | 1 ref | 2 | **RULED 2026-10-01 (user, final): SERVO** — op-amp holds the DC mean of `mid_p` at the 3.0 V REF7050 tap and drives the shared casb2 node (→ 100 Ω stoppers → M6p/M6m, local cap); sense ≥ 100 kΩ + C, crossover 0.1–1 Hz, output clamp for start-up. Fixed+trim, tracking-MOSFET and reference-transistor options rejected — see 17(i) row and 17(k) | 4.37 V = 3.0 V + V_gs is lot- and temperature-dependent; the loop removes both (and the production trim). Fixed 4.37 V remains the deck value for sim. **GATE PASSED 2026-10-02 (`utils/servo_sense.ps1/.py`, `utils/servo_loop.py`): OPA1656 (FET input — OPA1612's 1.7 pA × 1 MΩ gives 23 nV @ 10 Hz, fails), R_s 2 × 499 k + 1 nF, C_i 1 µF film, R_o 100 Ω / C_g 100 µF, clamp 6 V; f_c 0.16 Hz, PM 91°, casb2 noise 4.7 / 0.8 nV @ 10 / 100 Hz, loop gain −107 dB at the 9 kHz fundamental, start-up settles to ±11 mV in 4.8 s with zero overshoot. Sense audit on the locked plant: mean(mid_p) moves +4.1 mV from −60 to −1 dBFS (V_gs sqrt-nonlinearity) → servo tracks a 0.09 % level-dependent casb2 shift, inside the ±0.25 % budget** |
| — | Reclock FF 3.3 V LDO | — | 2 | **ADP7158ACPZ-3.3-R7** (§1.2, locked 2026-10-10), fed from a 4.0 V pre-reg | dedicated, not digital 3.3 V; load ≈ 0.3–0.5 A/channel |
| — | Deck rails not drawn | — | — | `vp8` 9 V, `vfr2` 3.0 V (unused in `cosim112`) | 2026-09-26 (hw/reconcile.md 3): dead in the locked deck. `vfr2` 3.0 V returns only as the casb2 replica reference above; `vcc15` = raw +15 → filter → +15F |

---

# 10. Common-mode servo (Fig. 5b) — SUPERSEDED 2026-09-26 (DC nulled by MIDCODE R_off sizing, §4; kept for record)

One complete instance **per mono channel** (×2 per unit). Verified
`bfdac_servo1/2/3`: 75.9 dB DC gain, 11.7 mHz crossover, 89° PM; residual CM
95–135 µV; noise −153.9 dB rel 2 Vrms. Both caps in servo branch, not audio path.

| Ref | Role | Qty/ch | Qty/unit | Part / value | Notes |
|---|---|---|---|---|---|
| Rs1, Rs2 | CM sense | 2 | 4 | 10 k matched thin film | (out_p + out_m)/2 |
| QI1, QI2 | Input pair | 1 pkg | 2 | **SSM2212** matched NPN | matched 5 k base source impedances cancel I_b drops |
| Rd1, Rd2 | LTP degeneration | 2 | 4 | 4.7 k | — |
| Rt10 | Tail set | 1 | 2 | 143 k | 100 µA tail |
| Ri | iref source impedance | 1 | 2 | 5 k | = sense R_th → I_b drops cancel |
| QP1, QP2 | Mirror | 1 pkg | 2 | **SSM2220** matched PNP | degenerated 10 k ×2 |
| Rm10, Rm11 | Mirror degeneration | 2 | 4 | 10 k | — |
| QH10 | β-helper | 1 | 2 | 2N5401-class (superseded — not built) | — |
| QS0, QS | Darlington 2nd stage | 2 | 4 | 2N5401-class (superseded — not built) | kills base-current steal at vint1; 470 k bleed |
| Rbl10 | Darlington bleed | 1 | 2 | 470 k | — |
| QL1, QL0 | Current-source load | 2 | 4 | 2N5551-class (superseded — not built) | 100 µA (293 k set) |
| Rl10 | CCS set | 1 | 2 | 293 k | — |
| C_int | Integrator (Miller) | 1 | 2 | **10 µF film** | servo branch |
| Rpf | Post-filter | 1 | 2 | 100 k | — |
| C_pf | Post-filter / noise wall | 1 | 2 | **1 µF film** | 1.6 Hz; pole 130× above crossover |
| QA1, QA2 | Vernier actuators | 2 | 4 | matched NPN (superseded — not built) | 1.43 mA ±0.71 mA into sum_p/sum_m; ±40 mV CM authority |
| Ra1, Ra2 | Actuator degeneration | 2 | 4 | 2 k | 1% actuator mismatch → −153.9 dB noise |

---

# 20. Temperature sensing (NEW 2026-10-05, user)

Purpose: (a) temperature-indexed calibration (17(k) action c); (b) validate
the 17(k) thermal model on the prototype; (c) over-temperature mute/shutdown.
Requirement (user): **stability, not absolute accuracy** — repeatable to
≤ 1 K over months; ±1 K absolute is fine. Bus: **I²C to the application
processor**, crossing every isolated ground domain through a **digital
isolator** (one bidirectional I²C isolator per domain). Sensors are powered
from the domain they sit in (µA-class load, no noise concern).

| Ref | Part | Qty/unit | Why | Notes |
|---|---|---|---|---|
| U20x | **TI TMP117** — RULED 2026-10-05 (user: cheaper, specified long-term stability) — I²C, 16-bit 7.8 mK, ±0.1 K, 1.8–5.5 V, **4 addresses** (ADD0 → GND/V+/SDA/SCL), WSON-6 | 6–8 | silicon bandgap, datasheet long-term drift spec; repeatability ≪ 0.1 K | **Address constraint:** all isolated segments join into one logical bus through the isolators, so only 4 TMP117 can be addressed directly → either (i) 4 sensors (A-L, A-R, D, W) or (ii) an I²C mux (TCA9548A-class) on the AP side giving one downstream segment per isolator — **decide with the AP side (deferred)**; the board side is identical either way. Mount with a thermal via patch to the plane of the zone being measured |
| U21x | **TI ~~ISO1610~~ ISO1640** bidirectional I²C isolator — RULED 2026-10-05 (user); **MPN corrected 2026-10-08: "ISO1610" does not exist (TI 404), the part is ISO1640 (SLLSFC2D), ISO1640BDR SOIC-8 D.** SDA/SCL, ~~1.71–5.5 V both sides~~ **side 1 = 3.0–5.5 V, side 2 = 2.25–5.5 V (§6.3) — not 1.8 V capable.** Wired sensor bus on side 1 (V33D), AP on the wider side 2 (VAP_IO) → **the AP I²C rail must be ≥ 2.25 V**, else a different isolator / level shifter is needed (AP open) | 1 per isolated domain hosting a sensor (≈ 3–4: analog L, analog R, FF/clock, + wall if its own ground) | bidirectional open-drain both sides, no direction pin | Domain-side VCC from the domain's 3.3 V (V33FF for D; a 3.3 V tap from the analog LDO for the array zone); 4.7 k pull-ups domain side. **AP side (VCC, pull-ups, mux, port) deferred — user 2026-10-05** |
| — | Placement (per 17(k) zones) | — | A: between the two cascode/replica groups of each channel (2); D: FF/clock strip of each channel (2); W: tube wall at the radiator foot (1–2); T: I/V heat zone (optional, 2); ambient: near the AP, away from heat (1) | The A sensors are what the indexed cal uses; W/D/ambient validate the model |
| — | AP I²C port | 1 bus | **DEFERRED (user 2026-10-05)** — AP side of the isolation worked later | 100 kHz is plenty; poll at ≤ 1 Hz |

Open: isolated-domain count follows the grounding plan (not yet drawn);
sensor count > 4: AP-side mux or a second AP I²C controller (user 2026-10-05
— decide in the AP section).

**REALISED 2026-10-07 (`ctrl.kicad_sch`, user: 4 sensors so far, barrier between the sensors and the AP):** U505–U508 TMP117 on ONE bus on the FPGA/analog side (`V33D`, ADD0 = GND / V+ / SDA / SCL → 0x48–0x4B), U504 ISO1640 (sensor bus = side 1 at V33D, AP = side 2 at `VAP_IO`/`GND_AP`; sides assigned 2026-10-08 per the real supply ranges), 2.2 k pull-ups both sides, 100 n per device. Placement text on the sheet: L array, R array, R_off/Rpad heat zone, clock XO. Single domain for now — the per-domain ISO1640 split waits for the grounding plan; the AP side ends on header J501.

---

# 21. AP ↔ FPGA control SPI isolation (NEW 2026-10-05, user)

**CLOCK/RATE OWNERSHIP — REAFFIRMED AND LOCKED 2026-10-16 (user).**
AP reports the PCM stream rate/format; FPGA validates it and selects the
appropriate carrier MCLK, total interpolation and I2S BCLK/LRCLK as one coherent
configuration. FPGA remains I2S master; AP is slave transmitter. The carrier
oscillators supply the low-jitter converter/reclock MCLK; the FPGA does not
replace that analog clock source, and no separate MCLK is exported to the AP.
Maximum native input is **384 kHz**: 44.1/48, 88.2/96, 176.4/192 and 352.8/384 kHz
use x128/x64/x32/x16 total interpolation into fixed 5.6448/6.144 MHz conversion.
Two 32-bit I2S slots require BCLK=64*Fs (maximum 24.576 MHz). AP filter choice
remains policy; FPGA must validate filter/rate compatibility, reject unsupported
requests and report the applied configuration/readiness after a muted transition.
This supersedes higher native-input-rate claims; it is a design ruling, not
completed RTL or isolation-timing sign-off. See
[system specification Section 4.2](docs/SYSTEM_ARCHITECTURE.md#42-rates-and-capacity)
and [implementation findings R01–R04](docs/IMPLEMENTATION_REVIEW.md#12-open-findings-and-review-actions).

The coefficient QSPI (item 18) is FPGA-only — no isolator. The **AP → FPGA
register SPI** (SCLK, MOSI, CS → FPGA; MISO ← FPGA; optional IRQ ← FPGA)
crosses the AP/digital-board boundary and **must be isolated**. Target **50 MHz
SCLK** (user).

**Timing — why 50 MHz is not "just pick a fast isolator":** standard SPI
samples MISO on the edge opposite the one that launched it, so the loop
SCLK→isolator→FPGA(t_CO)→isolator→AP(t_SU) must fit in **half a period = 10 ns**.
Best-in-class 150 Mbps isolators have t_PD ≈ 8–13 ns *each way*; two crossings
plus FPGA t_CO (≈ 4–6 ns from an IOB register) is **≈ 22–32 ns** — three times the
budget. Standard-timed SPI through any isolator tops out around **15–20 MHz**.
The forward path (SCLK/MOSI/CS) is not the problem: same package, channel skew
≤ 2 ns, fine at 50 MHz.

**RULED 2026-10-05 (user): single SPI at a realistic frequency.** QSPI
rejected (bidirectional lanes need 11 isolator channels + direction control;
throughput only matters for coefficient provisioning). **Isolator: TI ISO7741
(RULED 2026-10-05, user: TI)** — 3 forward / 1 reverse, 100 Mbps, t_PD ≈ 10.7 ns
typ / 16 ns max, PWD ≤ 4 ns, 1.71–5.5 V level-translating sides, SOIC-16 (DW)
or QSOP-16 (DBQ); 5 kV basic. ISO7841 (8 kV reinforced, wide body) only if
safety isolation is ever required — same pinout class. Figures VERIFY against
SLLSEQ0/SLLSEW6 at the AP section. Hardware identical for both speed modes:

- **Guaranteed mode: 10 MHz, standard SPI timing** — works with any AP SPI
  master; designed to datasheet-max delays (2 × 16 + 5 + 3 = 40 ns = half-period
  at 12.5 MHz with zero margin → **10 MHz** guaranteed; 12.5 MHz will work on
  typical parts). One 10M-tap filter ≈ 9.4 s, full 64-filter set ≈ 10 min.
- **Fast mode: 50 MHz, if the chosen AP's SPI master has a programmable RX
  sample delay ≥ 2 cycles** (Rockchip SPI, AMD PS QSPI loopback, NXP FlexSPI,
  Allwinner — VERIFY; not Raspberry Pi / STM32 / i.MX ECSPI / TI McSPI) with
  **boot-time MISO training** (FPGA returns a known pattern, AP scans its
  sample-delay setting, picks the centre of the passing range — required because
  the 26–37 ns round trip straddles 1.5 cycles over PVT). Filter ≈ 1.9 s, set
  ≈ 2 min. Valid window at 50 MHz ≈ 12 ns after PWD (4) / skew (2) / t_CO (2)
  erosion. SCLK at 50 MHz is a 100 Mbps toggle = exactly the ISO7741 rating;
  fine, but no headroom above 50 MHz.
- **AP selection criterion added:** SPI master with programmable RX sample delay.
- FPGA side: IOB-registered MISO (fixed t_CO), optional ODELAY for fine
  alignment; training pattern register in the SPI register map.

**REVISED 2026-10-09 (MAX22445 selected); RE-RATED 2026-10-30 (datasheet re-read + user: run the bus as fast as it can for FPGA updates):**
the old "50 Mbps at 1.8 V" figure was wrong — DRMAX at 1.71–2.25 V is **150 Mbps**, so isolator bandwidth is NOT the gate (a 50 MHz clock = 100 Mbps passes, and the 1.8 V PWD is ≤ 2 ns, not 6.6). The real ceilings: **(a) FPGA-side oversampling** — `spi_slave` samples SCLK/CS/MOSI into clk_200m through 2–3-FF synchronizers and edge-detects: a reliable edge needs ~3×5 ns = 15 ns per half-period → SCLK ≤ ~33 MHz absolute, and MOSI is sampled ~10–15 ns after the real edge so the half-period must exceed that → **spec'd fast mode = 25 MHz SCLK** (20 ns half-period = 4 samples; comfortable margin); **(b) MISO round trip** — 2× tPD ≈ 44 ns worst at 1.8 V + FPGA sync/shift ≈ 60 ns = ~1.5 SCLK periods at 25 MHz → **the AP must sample MISO 1–2 cycles late** (XMOS does this trivially in port timing; it was already a selection criterion). Guaranteed mode 10 MHz (no AP smarts) stands; 50 MHz is out — not the isolator, the slave's oversampling; going faster needs an SCLK-clocked slave domain, not justified for a register bus. Throughput at 25 MHz ≈ 1.6 µs/frame ≈ 15 Mbps payload — coefficient-set upload lands in ms, flash writes are bounded by the flash itself. Fallback if more is ever needed: FPGA side on V33D + AXC translator block → 3.3 V timing (200 Mbps grade), same footprint.

Options considered (kept for record):

| Option | What it needs | 50 MHz? |
|---|---|---|
| **A. AP with programmable RX sample delay** (sample MISO 1–2 full SCLK cycles late; e.g. NXP LPSPI/FlexSPI, Xilinx/AMD PS QSPI loopback-clock, TI McSPI, some i.MX controllers) + generic 150 Mbps isolator | AP controller must have the feature — check when the AP is chosen; FPGA side unchanged | **Yes** |
| **B. FPGA echoes SCLK back with MISO** (source-synchronous return) through a 2/2 isolator | AP must be able to clock RX from an external clock — rare on SPI peripherals; usually means a small CPLD/bit-bang on the AP side | Yes, but awkward |
| **C. ADI ADuM3150 SPIsolator** (dedicated, 3 fwd + 1 rev + delayed-clock output DCLK that the AP uses to sample MISO) | AP must have a second clock input for sampling (most do not); ADuM3151/3152/3153 variants give 17 MHz without DCLK | **40 MHz max**, not 50 |
| **D. Accept ≤ ~20 MHz** with a generic isolator | nothing | No — register traffic is light, so this costs nothing functionally; coefficient streaming does **not** go over this bus |

**Part class:** 4-channel, 3 forward / 1 reverse, ~~1.8–5 V~~ level-translating sides. **FINDING 2026-10-09 (user, TI datasheet): ISO7741 VCC range is 2.25–5.5 V per side — NOT 1.8 V capable. The "side 2 on V18" realisation below is INVALID for U501/U502/U503 (ISO7710 is the same family/range). No 1.8 V-capable isolator at ≥ 100 Mbps has been found (Si8641 2.5 V+, ADuM342E 2.25 V+, MAX14483 50 Mbps/no stock). OPTIONS: (A) FPGA-side isolator supply on `V33D` + one AXC-class 1.8 ↔ 3.3 V translator block between the isolators and bank 71 (9 signals: SPI ×4, I²S ×3, IRQ, RST; e.g. 2 × SN74AXC4T774 direction-per-bit, or AXC8T245 + AXC1T45) — adds ≈ 2 ns per crossing to the §21 MISO round trip (≈ 26–36 ns), 10 MHz standard mode unaffected, 50 MHz fast mode still needs AP RX delay; (B) a verified 1.7 V isolator — **FOUND and RULED (user, 2026-10-09 21:48): ADI/Maxim MAX22445 / MAX22444, see SELECTED row below; option (A) not needed**; (C) none of the SoM banks offer a ≥ 2.25 V VCCIO (all 1.8 V), so a bank change is not available. RULING PENDING; (A) is the known-good path and reuses the TODO-26 translator family.**

| Candidate | Rate | t_PD typ / max | Config | Notes |
|---|---|---|---|---|
| ~~TI ISO7741 — SELECTED (user, confirmed 2026-10-05 20:38 after the Si8641 comparison)~~ | 100 Mbps | ≈ 10.7 / 16 ns | 3/1 | ~~ISO7742 (2/2) as the second part if an FPGA→AP IRQ is added; ISO7841 = reinforced alt.~~ **SUPERSEDED 2026-10-09: VCC 2.25–5.5 V per side (user-verified) — cannot sit on V18; see FINDING above and the MAX2244x row** |
| ~~Skyworks Si8641BC~~ | 150 Mbps | 8.5 / 13 ns | 3/1 | rejected: only gains 12.5 vs 10 MHz in fallback mode and headroom at 50 MHz; supply confidence favoured TI. ~~Footprint-compatible fallback~~ **NOT USABLE (user, 2026-10-09): Si86xx VDD range is 2.5–5.5 V — cannot sit on the `V18` (1.8 V) side without an added level shifter** |
| ~~ADI ADuM342E~~ | 150 Mbps @ 5 V only | ≈ 10 / 13 ns | 3/1 | **NOT USABLE (user, 2026-10-09, datasheet adum340e-341e-342e.pdf): VDD 2.25–5.0 V, 150 Mbps only at 5.0 V** — not a 1.8 V part either. **Conclusion: no 150 Mbps isolator reaches 1.8 V (and per the FINDING above, neither does the ISO7741). U502 I²S ceiling with ISO7741 at 100 Mbps: 768 kHz × 64·fs = 98 Mbps BCLK sits at the rating → cap I²S over the barrier at 384 kHz / 64·fs (49 Mbps); the FPGA upsamples internally so the cap has no audible cost** |
| ADI ADuM3150 | SPI 40 MHz | — | 3/1 + DCLK | option C only |
| ~~ADI/Maxim MAX14483~~ | 50 Mbps | — | 6-ch SPI-oriented | **NOT USABLE (user, 2026-10-09): 1.71 V capable but only 50 Mbps and no distributor stock found** — no advantage over ISO7741 even if sourced |
| **ADI/Maxim MAX22445 (3/1) / MAX22444 (4/0) — SELECTED (user, 2026-10-09 21:48)**, datasheet max22444-max22446.pdf, 16-SOIC-W ("AWE") | 200 Mbps grade at ≥2.25 V; **CORRECTED 2026-10-30: datasheet DRMAX at 1.71–2.25 V is 150 Mbps (C/F/S/V variants; the 25 Mbps row is the separate "B" glitch-reject variant we don't use) — bandwidth is NOT the constraint** | t<sub>PD</sub> at 1.71–1.89 V: typ 12.0/12.1 ns, **max 20.3/21.7 ns**; PWD ≤2 ns; same-channel skew ≤~10 ns | 3/1 (22445), 4/0 (22444) | **MPNs: U501 SPI = MAX22445CAWE+ (3/1, default HIGH → CS_N deselected with AP off); U502 I²S = MAX22445FAWE+ (3/1, default LOW → SDATA = silence with AP off; `fpga_irq_n` reads asserted while the FPGA domain is down — benign, AP treats SPI-unresponsive as not-ready), sides swapped for FPGA-as-master; U503 reset = MAX22444CAWE+ (4/0, default HIGH → AP_RST_N released with open header; ch2 = AP_I2S_DATA2 2026-10-30, 2 spare fwd channels).** The only high-speed isolator found that runs at 1.71 V → FPGA side stays on V18, no translator block. **Corrected consequence (2026-10-30): the 384 kHz I²S limit comes from LATENCY, not bandwidth — two crossings at max tPD ≈ 44 ns vs the 40.7 ns bit period at 24.576 MHz BCLK, before XMOS/SAI response time; ≤192 kHz fits worst-case, 384 kHz wants the resp_lag capture-offset in i2s_master_ingress on BOTH source paths.** SPI standard-timed 10 MHz unaffected; 50 MHz fast mode still OFF (see §21 for the PWD analysis). Fallback if more rate is ever wanted: FPGA side to V33D + translator block (option A), same footprint. **Stock VERIFIED 2026-10-09 (user): all three MPNs in stock at DigiKey, manufacturer 30k+ — sourcing not a concern.** |

All figures from memory — **VERIFY against current datasheets** before the AP
section is drawn. A 5th channel (FPGA→AP IRQ) can ride on an ISO7742 (2/2) second part or
an ISO7761-class 6-channel device replacing the ISO7741. Supply: AP side from the
AP's 3.3 V, board side from `V33D`; a separate `ISO_GND` for the AP side is part
of the grounding plan (item 17 / sec 20).

**REALISED 2026-10-07 (`ctrl.kicad_sch`; user ruling: I²S crosses the same barrier) — PARTS SUPERSEDED 2026-10-09 (ISO7741/ISO7710 → MAX22445CAWE+ / MAX22445FAWE+ / MAX22444CAWE+, see table); SHEET REGENERATED 2026-10-10 with the verified pin maps:** U501 ~~ISO7741~~ MAX22445CAWE+ = SPI (SCLK/CS_N/MOSI AP→FPGA, MISO back); U502 ~~ISO7741~~ MAX22445FAWE+ = I²S ~~(BCLK/LRCLK/DATA AP→FPGA) + `fpga_irq_n` on the reverse channel~~ (SDATA AP→FPGA fwd; BCLK, LRCLK, `fpga_irq_n` FPGA→AP rev); U503 ~~ISO7710~~ MAX22444CAWE+ = `AP_RST_N` → `ext_rst_n` (+ 3 spare fwd channels, NC) (new XDC pin **R27 = B71_L2_N = J1-A1**, 10 k pull-up on the AP side so an open header runs); side 2 of all three on **V18** (bank 71 is LVCMOS18, so no level problem and no `V33D` on that side), side 1 on `VAP_IO`/`GND_AP`; EN pins tied high; 100 n per supply pin. AP side terminates on **J501 (2×10, Samtec TSW-110-07-G-D)** until the AP is chosen (open item 22). **BARRIER REVIEW 2026-10-09 (user rulings, `progress.md` TODO-13/27):** (1) isolation KEPT — ground separation + noise containment; the ISO77xx per-side supplies do the 3.3 ↔ 1.8 V shift, no separate translator. (2) **FPGA = I²S MASTER** (DAC is the timebase, item 19(c); no MCLK export): **U502 sides SWAPPED** — SDATA AP→FPGA on the single forward channel, BCLK + LRCLK + `fpga_irq_n` FPGA→AP on the three reverse channels (same ISO7741, side 1 now on V18, side 2 on VAP_IO); **weak pull-down on SDATA at the FPGA side** so an idle/unpowered AP reads as silence; J501 pinout unchanged, directions re-labelled. (3) **Ready/status = SPI register, no extra wire**; `fpga_irq_n` unchanged. (4) Coefficient-flash provisioning path still needs a ruling. LED_DBG0..3 + SOM_PG: MMBT3904 sinks from the 1.8 V IOs → 0603 LEDs → 470 Ω → `V33D` (`led_status` BC33 is on the module). Relay nets RLY_LINE_MUTE / RLY_LEVEL0/1 are on J1 and end on no-connect stubs until the §7 sheet exists.

---

# 22. SoM carrier — connectors and infrastructure (NEW 2026-10-07, user: all SoM pins mapped)

`som.kicad_sch` + the connector half of `fpga.kicad_sch`. All **eight Samtec ADM6-60-01.5-L-4-2-A-TR** (0.635 mm AcceleRate HD, 4 × 60 = 240, body 60 × 0.635 + 4.72 = 42.8 × 5.0 mm, 1.34 A/pin) are now symbols generated from `Alinx/ACVU13P-Pin-Assignment-20260703.csv` with every live pin wired and every unused pin an ERC no-connect:

| Conn | Carries | Carrier use |
|---|---|---|
| J1 | banks 69/70/71 | mclk (J28), clk_sel (J26), coefficient flash bus (bank 70), control plane (SPI/I²S/IRQ/reset/relays/LEDs, bank 71), `cascode_r[48..63]` (bank 69), VCCIO_69/70/71 → V18 |
| J2 | +12 V x 52, SelectMAP, BOOT_M0..2 | 12 V feed via Conn1/J506 `V12SOM` contacts and the `GND` perimeter; 2 x 220 uF polymer (25SVPF220M) + 4 x 10 uF X7R kept at J2; SelectMAP unused; BOOT_M straps R801-R803 **DNP** (SoM boots its own QSPI - VERIFY in the ACVU13P manual). ~~J507/J508 REDCUBE and J801 Mini-Fit 39-28-1063 struck~~ |
| J3, J4, J7, J8 | MGT quads only | all no-connect, GND tied |
| J5 | banks 66/67/68, MGT 225/226, VP/VN | `cascode_r[0..47]` (bank 67), VCCIO_66/67/68 → V18, SYSMON VP/VN → GND |
| J6 | banks 64/65/66, JTAG, VCCAUX_PG | `cascode_l` (DAT01..64), FPGA_TCK/TMS/TDI/TDO → **J802 Xilinx 14-pin 2 mm header (Molex 87832-1420, VREF = V18)**, VCCAUX_PG → `SOM_PG` LED, VCCIO_65_EX → V18 |

Rules applied: every VCCIO pin tied to V18 (an unpowered bank is not allowed even if unused); V18 is SoM-supplied, flagged on the REFS_L rails table with V12SOM / V33D / VAP_IO / GND_AP. Generator fix 2026-10-07: `cascode_map` silently dropped `cascode_r[48..63]` (column-aligned XDC lines) — now 64/64. SoM-sheet designators are **8xx** (J801/J802, C801–C806, R801–R803; 9xx is the REFS sheet).

**Right channel — DONE 2026-10-07 (user go-ahead):** `gen_kicad.build_channel(ch)` now emits both channels from one description: `cell/core/iv/refs.kicad_sch` (L) and `cell_r/core_r/iv_r/refs_r.kicad_sch` (R), 64 CELLR sheets on the root fed by `DATR01..64` / `MCLKR01..64`, and a new **`clkr.kicad_sch`** (U303 LMK1C1108 root + U330–U337 leaves, R350/R351, R360–R367, R600–R663, C370–C396 — the §1.1 R tree, `XOCLK` promoted to a global net). **Net naming:** every channel-local global net carries `_L` / `_R` (BUS_PLUS_L, CASB2_P_R, VCM_L, …); `SHARED_NETS` (GND, P15A/N15A, VEE15, V_ROFF, VP10, V33FF, V33CLK, V18, V33D, V12SOM, VAP_IO, GND_AP, **REF5/REF5F**) are not suffixed. **One-per-board blocks stay on REFS_L:** the rails PWR_FLAG table and U901 REF7050 → R902/C904 → U902A (REF5F); REFS_R's U702A is the spare half of the CASB2-servo OPA1656, follower to GND. **Designators:** R = L + offset (cells 1xxx→2xxx, refs 9xx→7xx, tail quads Q3xx→Q4xx, core/IV 1..59 → +60). `kicad_xcheck` checks both instances against the single-channel deck (1300 endpoints / 542 nets each, PASS) and adds a **channel-short test** (no L deck endpoint may share a KiCad net with an R endpoint except on the shared rails — PASS); ERC: only the two intentional CASB2_M/P "multiple names" notes remain, the 64 DATR placeholders are gone, no annotation errors.

**Footprint — DONE 2026-10-07 from the Samtec print** (`RECOMMENDED PCB LAYOUT FOR ADM6-XXX-XX.X-XXX-X-X-X` Rev A, ECN-358211, 6/5/2019; user-supplied catalog page F-226 Rev 23JAN26; both in `datasheets/`). `gen_kicad.write_local_footprints()` emits `hw/kicad/bfdac.pretty/Samtec_ADM6-60-01.5-L-4-2-A.kicad_mod` + `fp-lib-table`; all eight J connectors reference it (ERC footprint-link clean). Numbers used: rows A–D at ±1.75 / ±0.79 mm (0.96 A–B and C–D, 1.58 across the centreline, 3.50 total), 0.635 pitch, pin 1 at +x (A01 top-right, D01 bottom-right), **pad Ø 0.356 ± 0.05 mm** (solder-ball terminal; 0.05 mask margin), TABLE 1 −60: envelope A = 42.82, pin span B = 37.465, alignment-pin span C = 40.27; two **Ø 0.95 NPTH** at ±C/2, ±1.27 mm off centreline, diagonal; body 5.00 wide with 1.00 × 45° chamfers on the A01 and D60 corners; courtyard = envelope + 0.25 (print note 2: nothing else inside the envelope); stencil 0.102 mm, 1:1. Lead style −01.5: 2.90 mm (3.32 with ball) tall; mates ADF6-60-03.5 on the module → **5 mm stack**. Current 1.34 A/pin (4 powered) → J2's 52 × 12 V pins are far above the 5 A feed. Connector X/Y positions still blocked on the Alinx drawing (item 16).

**Real components still missing (schematic-complete list, 2026-10-07):**

| Block | Missing | Blocked on |
|---|---|---|
| Output routing §7 | **DRAWN 2026-10-07 (`out.kicad_sch`): K4 G6K-2F-Y DC12 × 2 (library symbol + footprint, 2026-10-08) + ULN2003V12 + LVC1G11 gate + 10 Ω build-outs + XLR placeholders; K1/K2 struck (digital level)** — remaining: ~~G6K coil/contact figures VERIFY~~ (done 2026-10-08: 1,315 Ω / 9.1 mA, terminal map confirmed), ~~XLR connector decision (NC3MAH placeholder)~~ (**LOCKED 2026-10-10: NC3MD-H-B, footprint from the Neutrik drawing**), `PG_A15` source (power sheet), SoM DONE pull-up VERIFY, RTL: LEVEL → digital cap | datasheets / power sheet / RTL |
| Application processor | AP module/board, VAP_IO level, SPI RX-sample-delay capability (J501 header is the committed carrier-side interface) | **open item 22 — PARKED by the user 2026-10-07, not blocking the carrier** |
| Power 17(d) | all regulators, transformers/bridges, filters, the 12 V and 5 V switchers, V33D/V33FF/V33CLK LDOs | parked by the user (last) |
| Footprints to obtain | ~~Samtec ADM6~~ (done 2026-10-07), ~~Crystek CCHD-957 (9 × 14)~~ (done 2026-10-08: `bfdac:Crystek_CCHD-957` from the Rev N suggested pad layout — 4 pads 1.27 × 2.28 mm on 5.08 × 7.11 mm, body 14.2 × 9.14, pin 1 bottom-left CCW), ~~Micron MT25QU02G T-PBGA-24~~ (done 2026-10-08: `bfdac:Micron_T-PBGA-24_6x8mm_Layout5x5_P1.0mm` from Fig. 6 — 5×5 grid 1.0 mm, Ø0.40 SMD pads, 6 × 8 body, A1 absent), TMP117 WSON-6 EP (KiCad generic used), ~~AGN200A12~~ (G6K-2F-Y library footprint, 2026-10-08), ~~XLR~~ (done 2026-10-10: `bfdac:Neutrik_NC3MD-H` from the Neutrik S1-NC3MD-H drawing, `datasheets/NC3MD-H-B/`) | datasheets |
| Pin maps to VERIFY | ~~ISO7741 / ISO7710 / ISO1610 / TMP117~~ **VERIFIED 2026-10-08 against the TI PDFs** — ISO7741 OK (part SUPERSEDED 2026-10-09 by MAX22445CAWE+/FAWE+ and MAX22444CAWE+ — **pin maps VERIFIED 2026-10-10 against the datasheet pin-configuration figure (user) + the ADI KiCad symbol: MAX22445 = 1 VDDA 2 GNDA 3 IN1 4 IN2 5 IN3 6 OUT4 7 ENA 8 GNDA | 9 GNDB 10 ENB 11 IN4 12 OUT3 13 OUT2 14 OUT1 15 GNDB 16 VDDB (pin-for-pin the ISO7741 layout); MAX22444 = pin 6 IN4, 7 I.C., 11 OUT4, no ENA. `ctrl.kicad_sch` REGENERATED (U501 C, U502 F with sides swapped, U503 22444 with IN2–4 to GNDA, OUT2–4 NC, **pin 7 I.C. to GNDA** — pin description read by the user 2026-10-10: "leave unconnected or connect to GNDA or VDDA"; grounded for a defined potential, not thermal — the part dissipates mW); ERC clean. Vendor land patterns (ADI 21-0042B W SOIC-16, CP-10-9 LFCSP-10) copied into `bfdac.pretty` by `gen_kicad.VENDOR_FOOTPRINTS` (user ruling 2026-10-10: official footprints)**); **ISO7710 was WRONG** (D package: VCC1 on pins 1 **and** 3, IN 2, GND1 4, GND2 5, OUT 6, NC 7; the from-memory map had IN on 3 = reset line shorted to VCC1, GND1 on 2) — fixed; ISO1610 → **ISO1640** (pin map identical, supply range not 1.8 V — see §20); TMP117 OK (thermal pad floating per datasheet). **G6K-2F-Y VERIFIED** vs en-g6k.pdf p.3/p.6: 12 V coil **1,315 Ω / 9.1 mA / ~100 mW** (not 1,440 Ω / 8.3 mA), must-operate ≤ 80 %, release ≥ 10 %, max 150 %, −40…70 °C; terminal diagram (top view) coil 1(+)/8(−), COM 6/3, NC 7/2, NO 5/4 — matches the schematic. **CCHD-957 VERIFIED** (user-supplied PDF Rev N 25-Aug-2026): 1 E/D, 2 GND, 3 OUT, 4 Vcc; E/D open or ≥ 0.7 Vcc = active, ≤ 0.3 Vcc = High Z (200 ns, 1.5 mA standby), −350 µA pin-1 disable current, 3.3 V ± 0.3, 15 mA typ, 15 pF load, floor −169 dBc/Hz typ. **MT25QU02G ball map VERIFIED** (mt25q-qlkt-U02-CBB-S-IT Rev C Fig. 4, fetched 2026-10-08) — **was WRONG**: the from-memory map put RESET# on B4 (actually **VCC**) and VCC on C3 (actually DNU) → the flash would have been unpowered. Real map: A4 RESET# (pin-config 8 = dedicated RESET#, internal pull-up), B2 C, B3 VSS, B4 VCC, C2 S#, C4 W#/DQ2, D2 DQ1, D3 DQ0, D4 HOLD#/DQ3. Fixed; U320–U323 netlist checked. **BOOT_M strap / SoM DONE pull-up: user 2026-10-08 — no dedicated ACVU13P manual exists; stays an open bring-up item (R801–R803 DNP; DONE is bank-0 1.8 V, pull-up assumed on the SoM)** | — |

---

# Open sync items

1. ~~Gate-count discrepancy~~ **RESOLVED (Round 27, user ruling):** one FPGA data pin per cell = **128 pins** (`cascode_l/r[63:0]`); the reclock FF stage generates the complementary gate pair from Q/Q̅ at ≈ 3.3 V. The per-cell ODELAY crossing-trim knob stays retired (post-FF RC trim = bring-up fallback).
2. ~~Cell redesign~~ **RESOLVED (Round 29):** BJT steering cell (DMMT5551) locked, §2; verified `bfdac_cosim27*`.
3. ~~Reclock stage MPNs~~ **RESOLVED (Round 29); datasheet verification DONE (Round 30):** MC100EP52 checked against MC10EP52/D rev 7 — timing better than budgeted (setup 50 ps, hold 0), but **no V_BB pin** (see §1.2 finding: external ~2.1 V threshold rail required) and per-FF current higher than estimated (see item 7).
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
