ccroswhite/BFDAC/datasheets/ACVU13_BOT.dxf

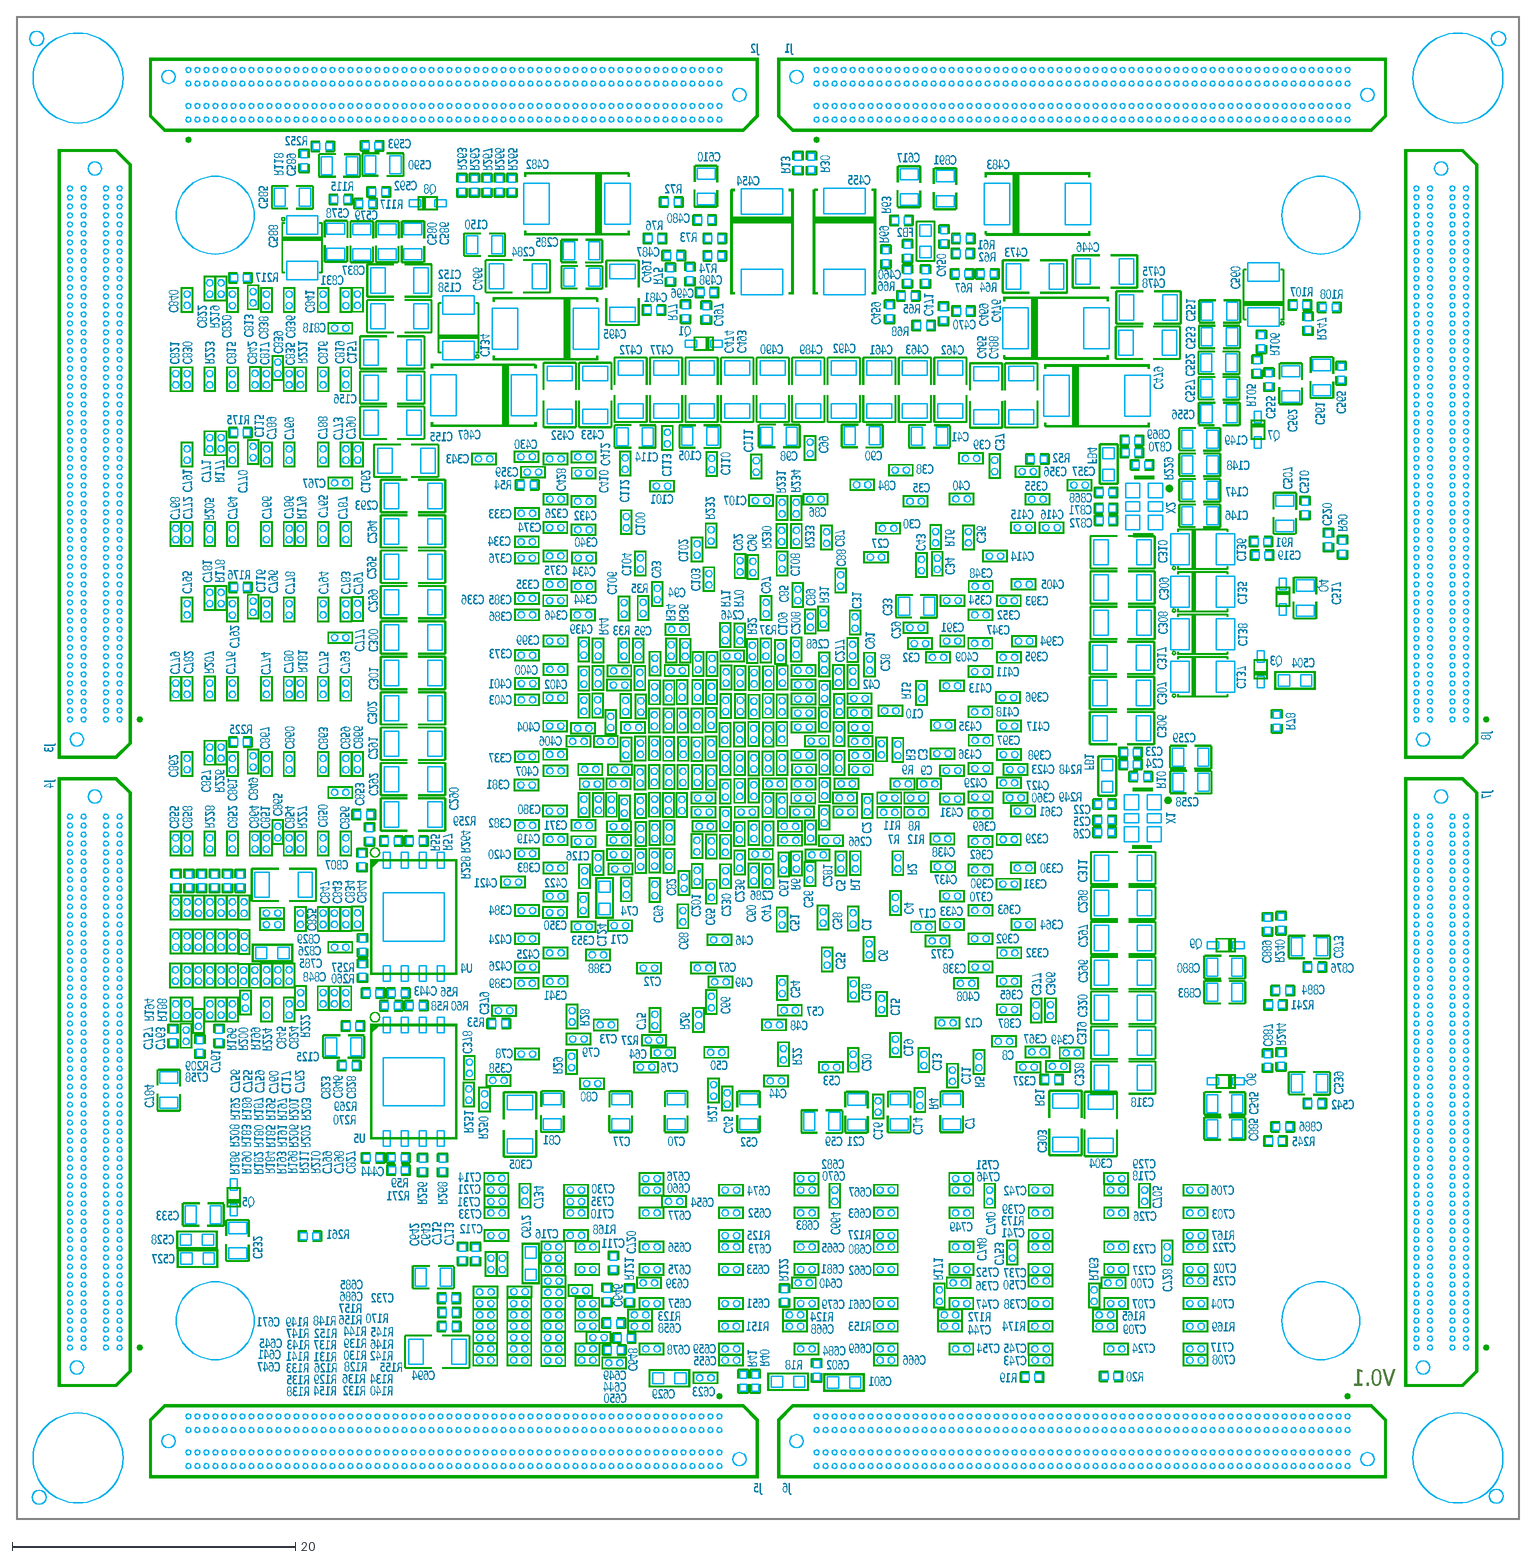
[picture p2: CAD file, 2026-10-17]
datasheets/ACVU13_BOT.dxf
J7
J8
J1
J2
J3
J4
J5
J6
U4
U5
X2
X1
C717
C700
C709
C718
C669
C745
C640
C670
C736
C744
C746
C659
C660
C668
C639
C658
C686
C721
C685
C799
C834
C798
C782
C858
C116
C849
C857
C859
C772
C115
C771
C773
C781
C783
C813
C830
C822
C831
C623
C19
C2
C20
C201
C208
C230
C236
C266
C268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
