ccroswhite/BFDAC/datasheets/NC3MD-H-B/nc3md-h-4.dxf

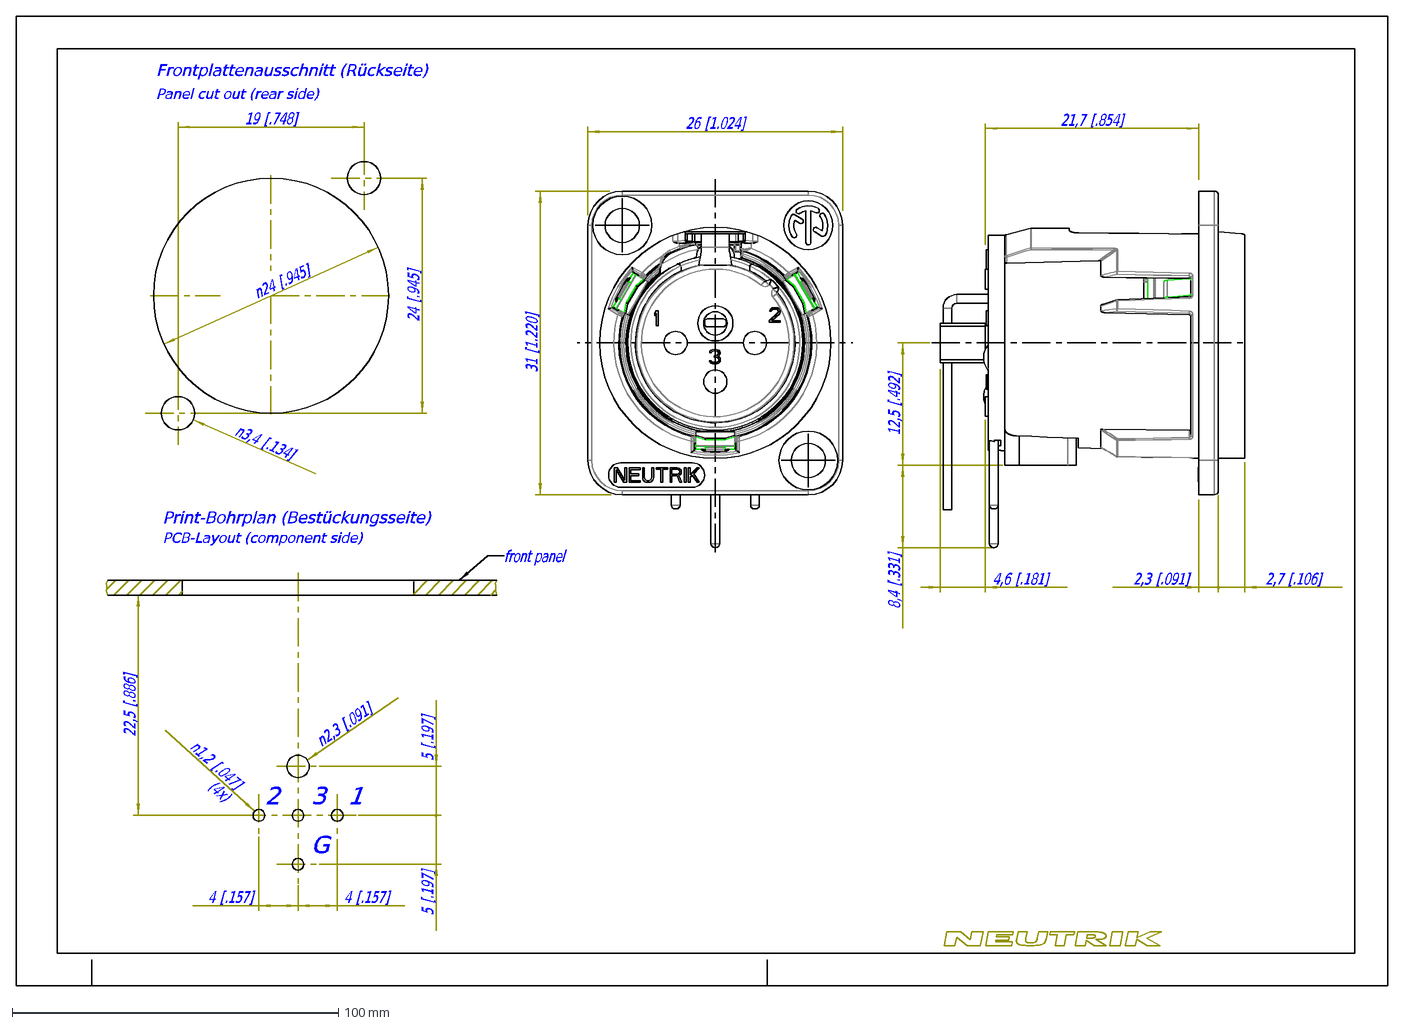
[picture p3: CAD file, 2026-10-17]
datasheets/NC3MD-H-B/nc3md-h-4.dxf
26 [1.024]
31 [1.220]
21,7 [.854]
2,7 [.106]
2,3 [.091]
4,6 [.181]
12,5 [.492]
19 [.748]
24 [.945]
5 [.197]
4 [.157]
22,5 [.886]
8,4 [.331]
1
3
2
G
Panel cut out (rear side)
Frontplattenausschnitt (Rückseite)
PCB-Layout (component side)
Print-Bohrplan (Bestückungsseite)
front panel
