ccroswhite/BFDAC/datasheets/ACVU13.1.stp

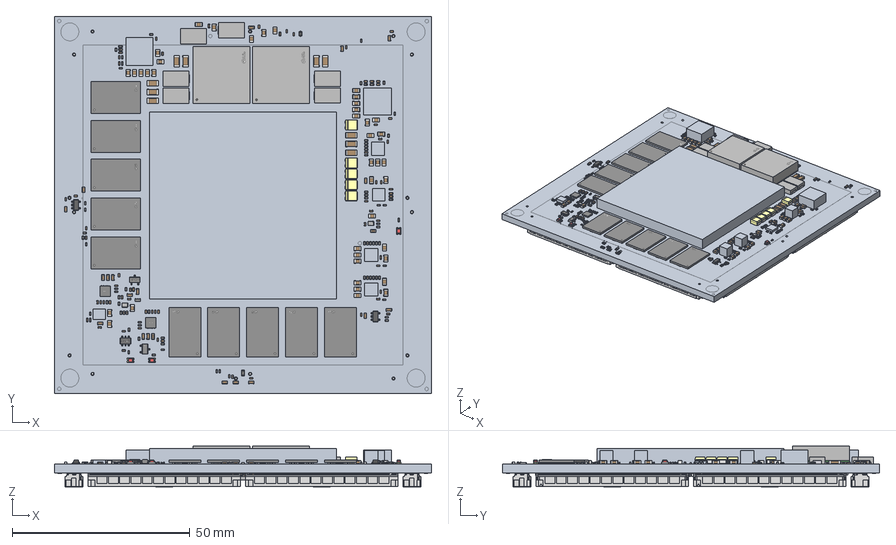
[picture p4: CAD file, 2026-10-17]
datasheets/ACVU13.1.stp
106.0 x 106.0 x 11.5 mm
BOARD
R0402 x 270
FAN90X90
MARK x 24
R0603 x 2
SOD-523 x 9
User Library-cap_1206_0.95 x 64
User Library-cap_0805_lowprofile x 93
SX2.0 x 14
User Library-cap_0603_lowprofile x 29
User Library-cap_0402 x 643
SOT-23-3 x 2
CircuitWorks-SOT-23-5 x 2
Pins x 2
ThermalPin x 2
PinsArrayLR x 2
User Library-SOT-23-6-3
MH_250H125 x 4
LGA13-2_5X3X1_18
FHGB2104
ADF6_Pad x 8
ADF6-60-03.5-2_PINS x 16
Al_Pin_2_Alignment_pin x 8
Al_Pin_1_Alignment_pin x 8
ADF6-60-03.5-A_BODY x 8
QFN20-3_5X3_5-0_5
LGA-19 x 3
21FB2861-41FF-4153-8654-03225E8C6D42 x 12
User Library-led_0805 x 3
QFN29-7X7X3_95 x 2
