ccroswhite/BFDAC/hw/kicad/acentry.kicad_sch

## KiCad design hw/kicad/acentry.kicad_sch (2026-11-04)

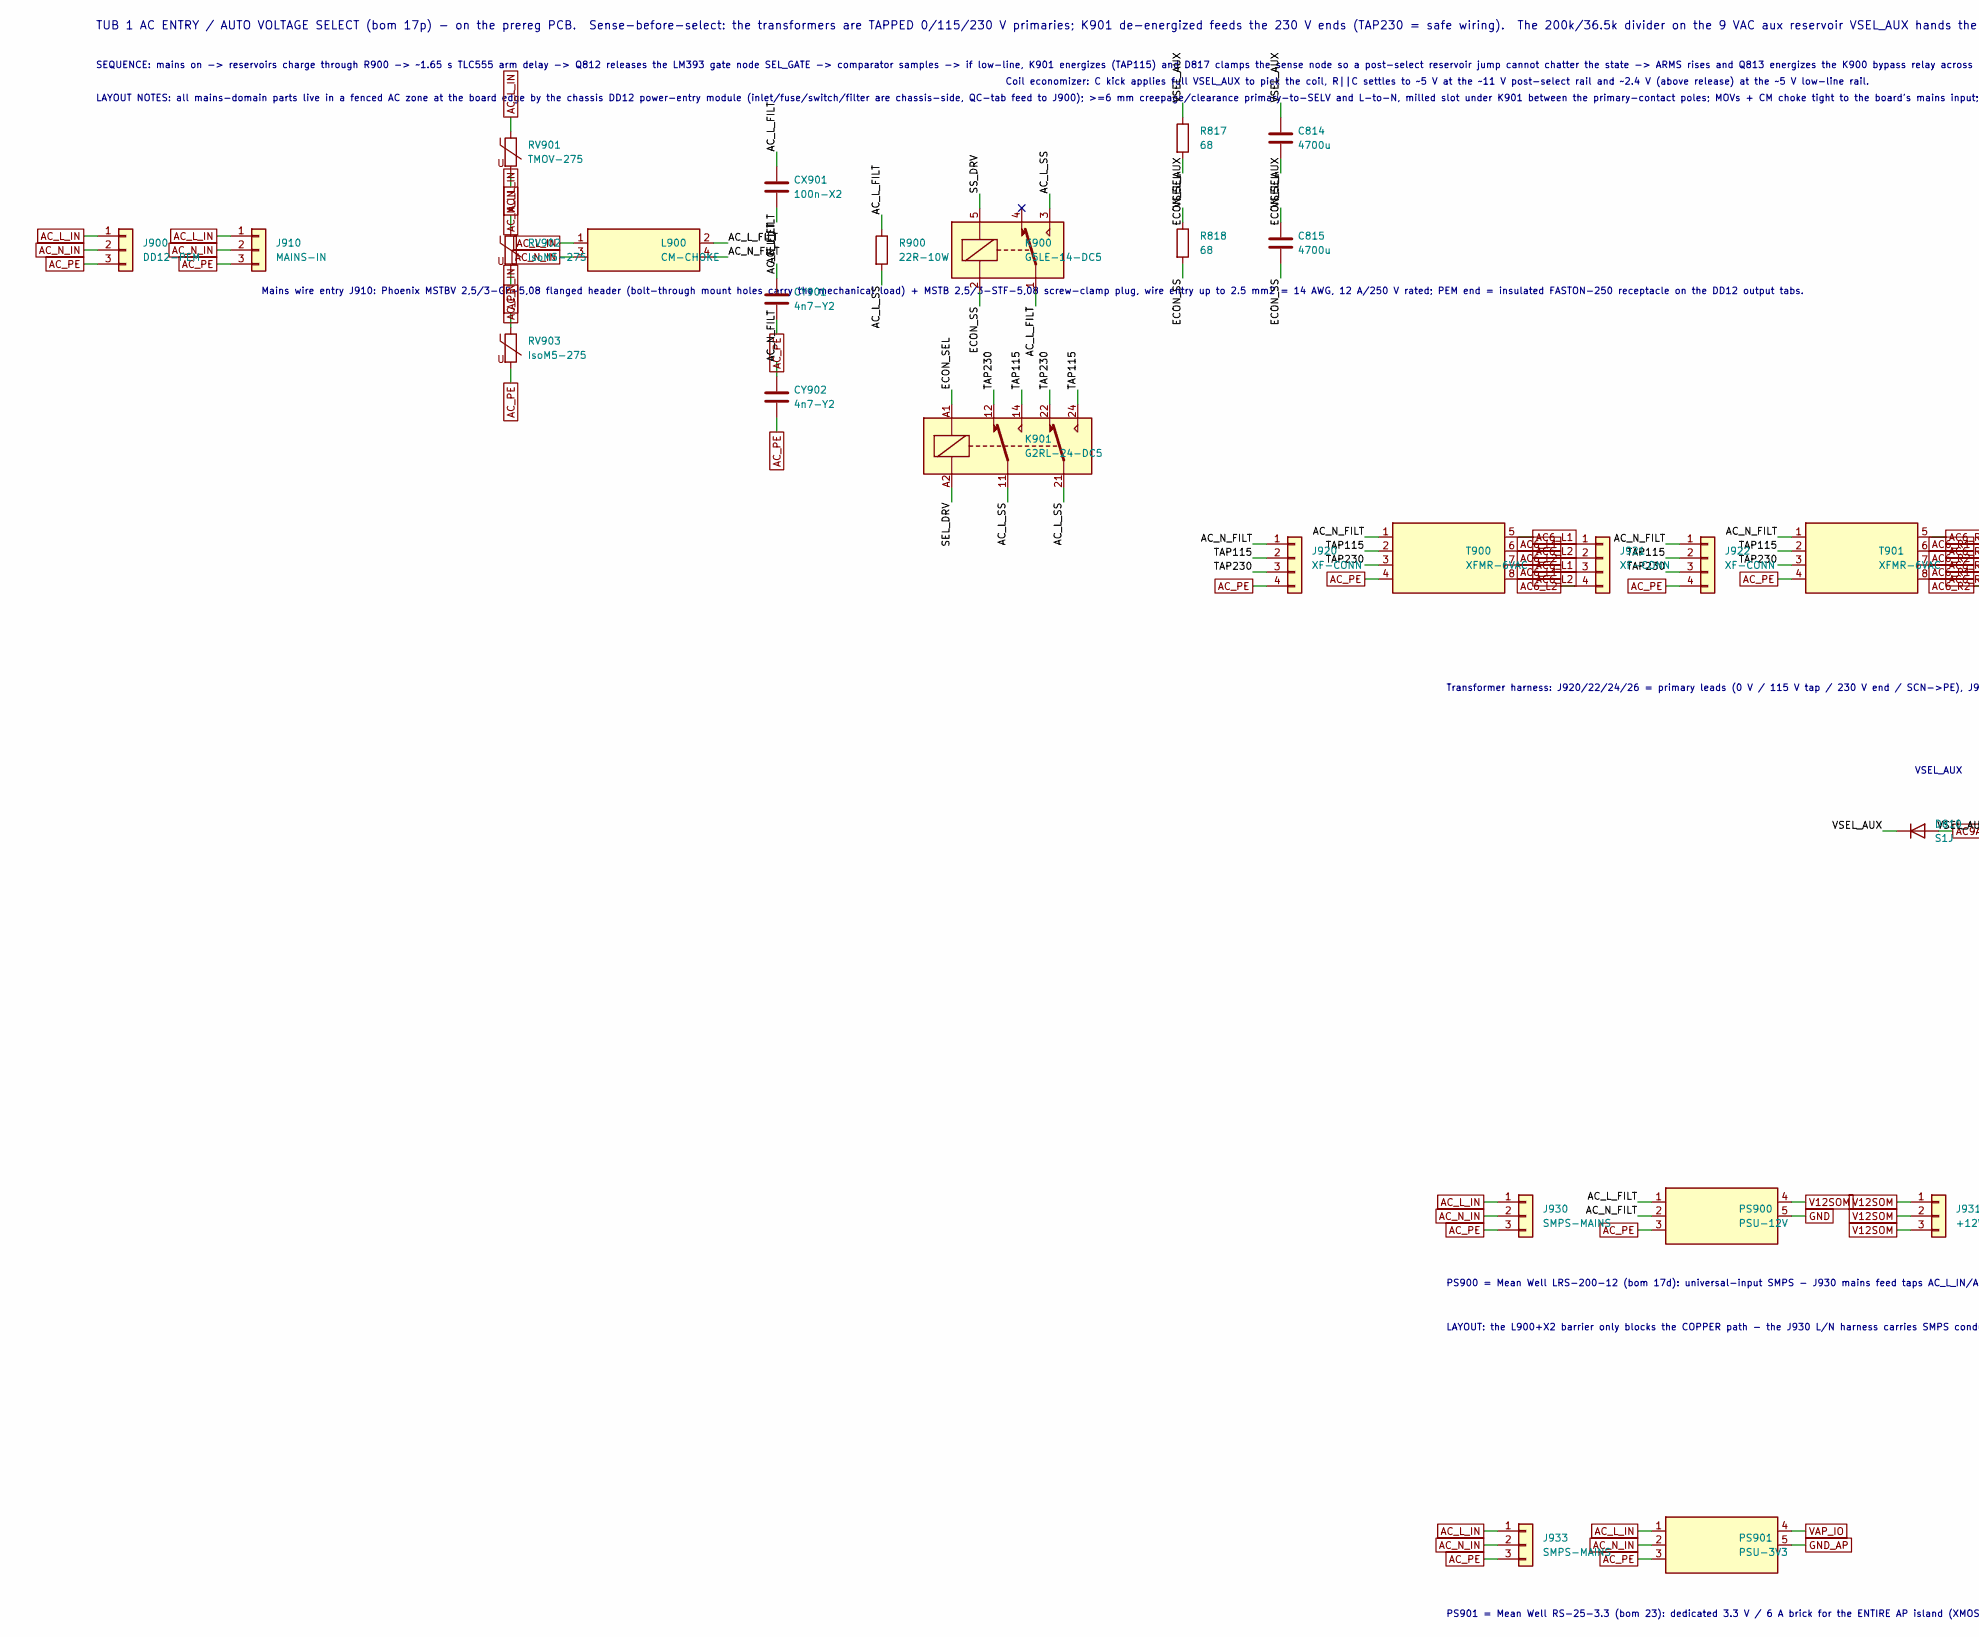
[picture p5: schematic acentry.kicad_sch, part in row 1, column 1]

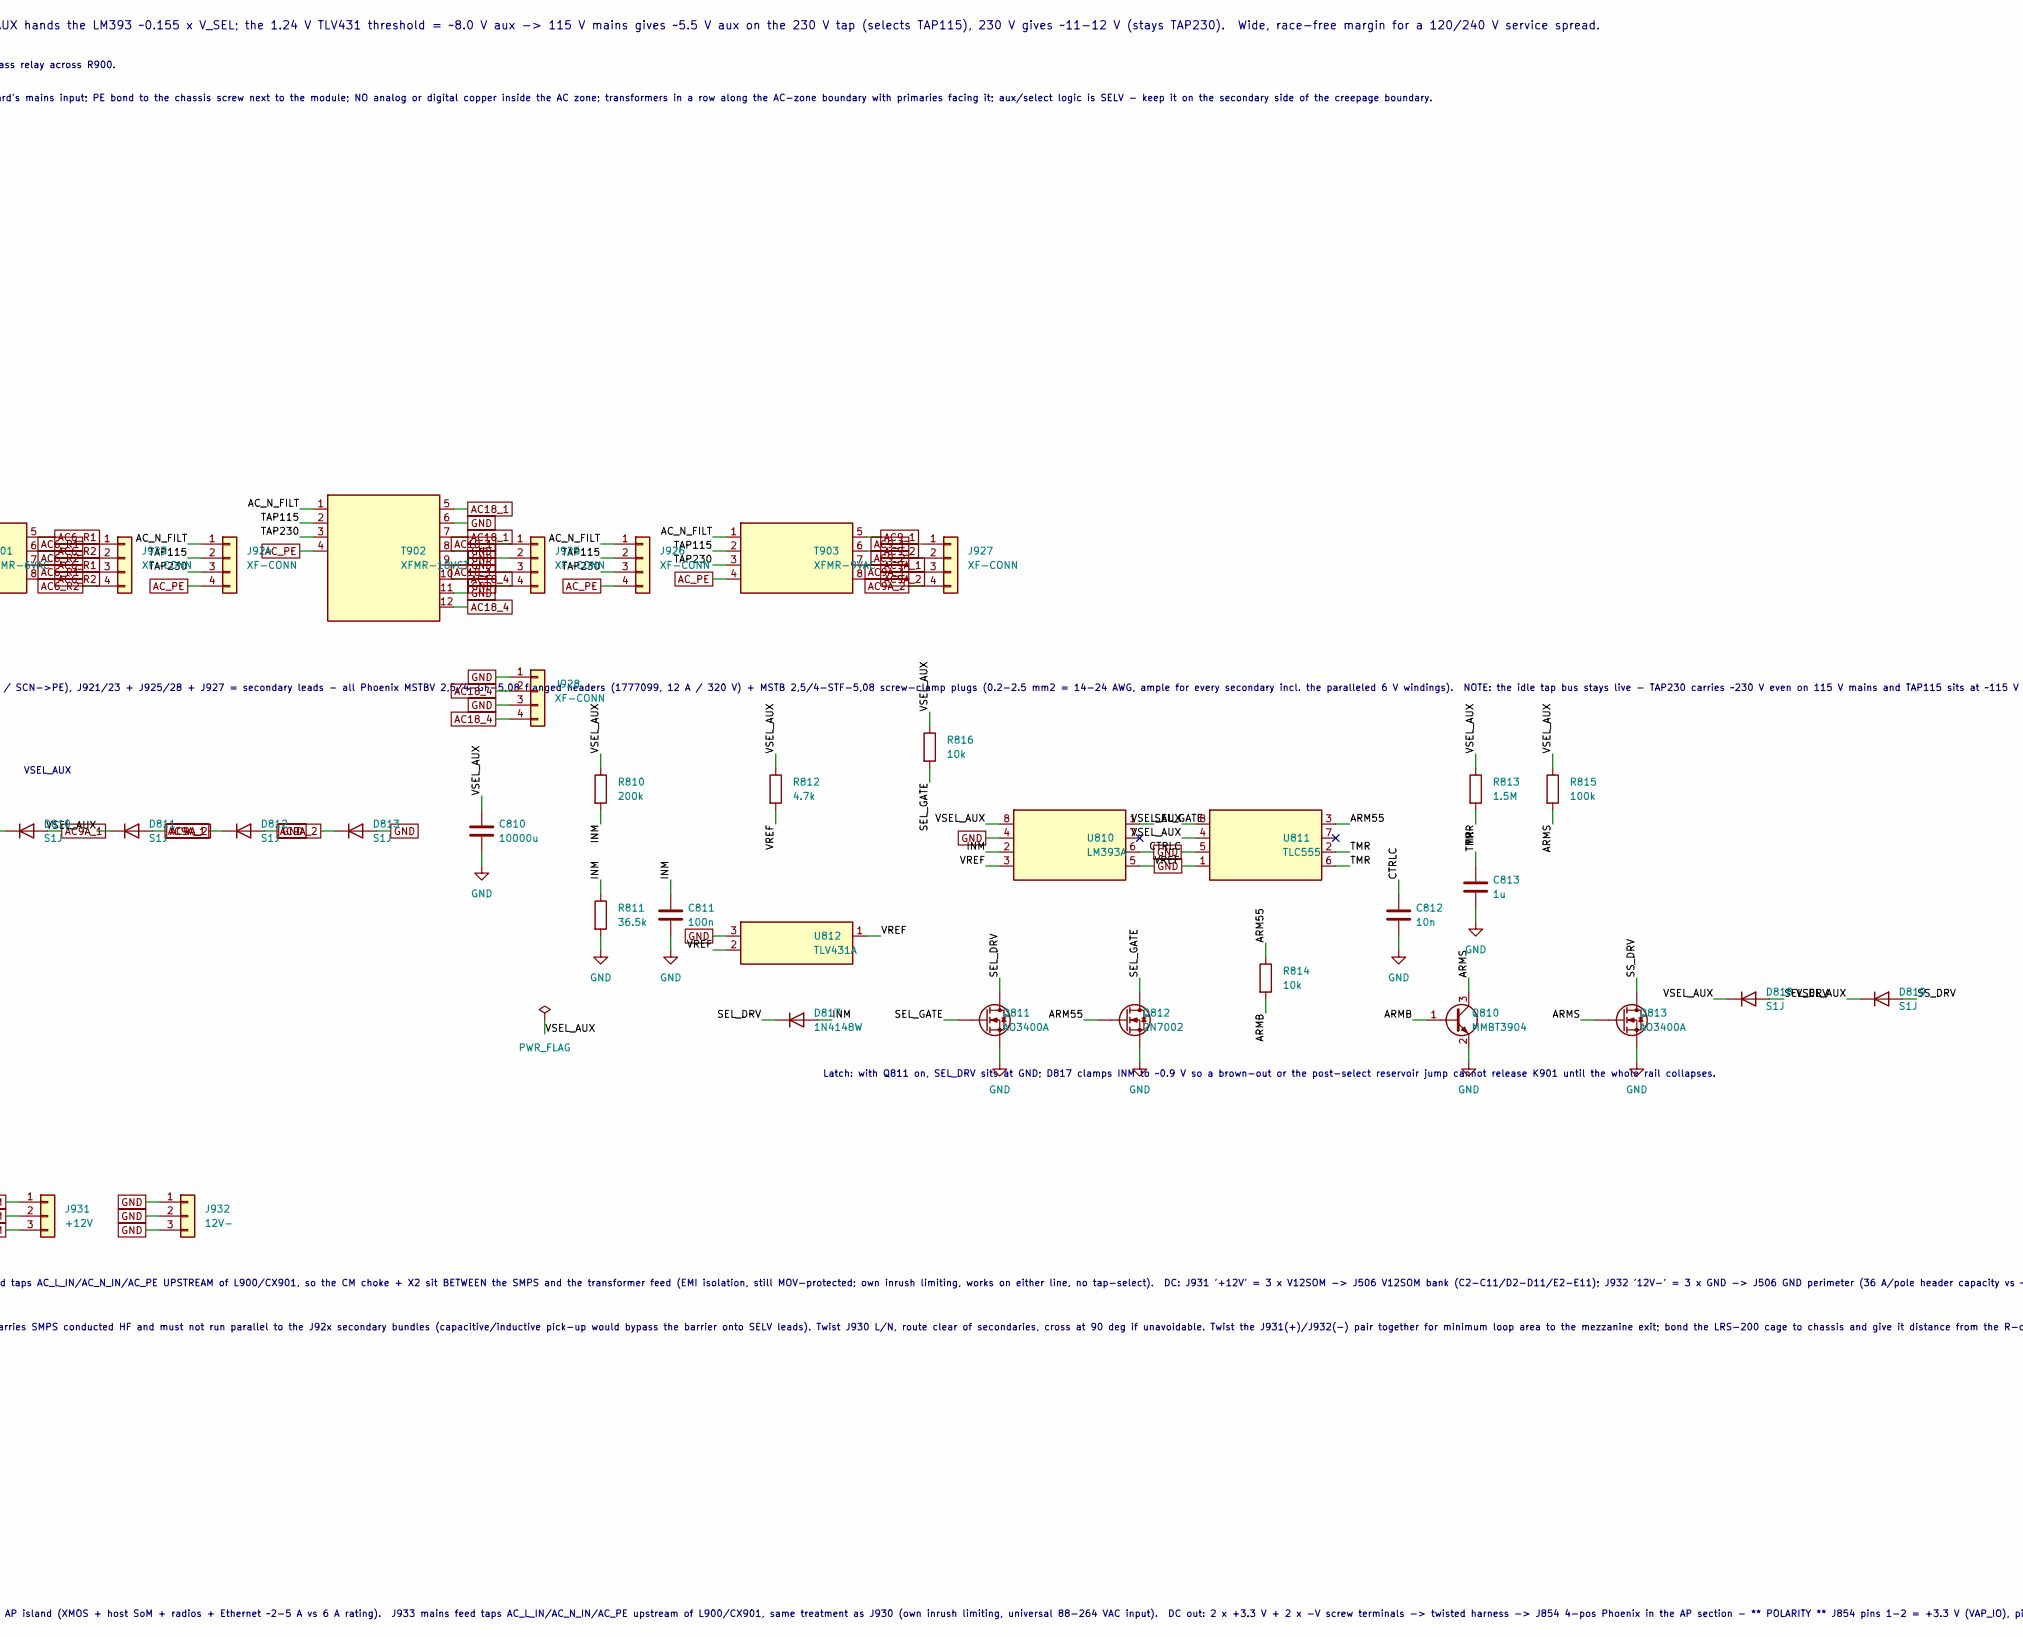
[picture p6: schematic acentry.kicad_sch, part in row 1, column 2]

Parts:
C810: 10000u; CP_Radial_D16.0mm_P7.50mm; MPN UPW1E103MHD
C811: 100n; C_0603_1608Metric; MPN GRM188R71C104KA01D
C812: 10n; C_0603_1608Metric; MPN GRM1885C1H103JA01D
C813: 1u; C_0805_2012Metric; MPN GRM21BR71C105KA01L
C814, C815: 4700u; CP_Radial_D16.0mm_P7.50mm; MPN UPW1E472MHD
CX901: 100n-X2; C_Rect_L18.0mm_W5.0mm_P15.00mm_FKS3_FKP3; MPN B32922C3104K
CY901, CY902: 4n7-Y2; C_Rect_L13.0mm_W4.0mm_P10.00mm_FKS3_FKP3_MKS4; MPN B32022A3472M000
D810, D811, D812, D813, D818, D819: S1J; D_SMA; MPN S1J-13-F
D817: 1N4148W; D_SOD-323; MPN 1N4148WS-7-F
J900: DD12-PEM; MPN DD12.4121.111
J910: MAINS-IN; PhoenixContact_MSTBV_2,5_3-GF-5,08_1x03_P5.08mm_Vertical_Th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; MPN 1777086
J920, J921, J922, J923, J924, J925, J926, J927, J928: XF-CONN; PhoenixContact_MSTBV_2,5_4-GF-5,08_1x04_P5.08mm_Vertical_Th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; MPN 1777099
J930, J933: SMPS-MAINS; PhoenixContact_MSTBV_2,5_3-GF-5,08_1x03_P5.08mm_Vertical_Th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; MPN 1777086
J931: +12V; PhoenixContact_MSTBV_2,5_3-GF-5,08_1x03_P5.08mm_Vertical_Th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; MPN 1777086
J932: 12V-; PhoenixContact_MSTBV_2,5_3-GF-5,08_1x03_P5.08mm_Vertical_Th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; MPN 1777086
K900: G5LE-14-DC5; Relay_SPDT_Omron-G5LE-1; MPN G5LE-14-DC5
K901: G2RL-24-DC5; Relay_DPDT_Omron_G2RL-2; MPN G2RL-24-DC5
L900: CM-CHOKE; Common_Mode_Choke_Schaffner_RN222; MPN RN222-2-02-6M8
PS900: PSU-12V; MPN LRS-200-12
PS901: PSU-3V3; MPN RS-25-3.3
Q810: MMBT3904; SOT-23; MPN MMBT3904LT1G
Q811, Q813: AO3400A; SOT-23; MPN AO3400A
Q812: 2N7002; SOT-23; MPN 2N7002
R810: 200k; R_0603_1608Metric; MPN TNPW06032003FEEA
R811: 36.5k; R_0603_1608Metric; MPN TNPW06033652FEEA
R812: 4.7k; R_0603_1608Metric; MPN TNPW06034701FEEA
R813: 1.5M; R_0603_1608Metric; MPN TNPW06031504FEEA
R814, R816: 10k; R_0603_1608Metric; MPN TNPW06031002FEEA
R815: 100k; R_0603_1608Metric; MPN TNPW06031003FEEA
R817, R818: 68; R_1206_3216Metric; MPN TNPW120668R0FEEA
R900: 22R-10W; R_Axial_Power_L25.0mm_W9.0mm_P30.48mm; MPN SQP10A22RJB
RV901: TMOV-275; Varistor_Disc_D14.0mm_P7.5mm; MPN TMOV14RP275E
RV902, RV903: IsoM5-275; Varistor_IsoM5_D14_P10.0mm; MPN ISOM5-275-B-L2
T900, T901: XFMR-6VAC; XFMR_Rcore_TP4S_TBD; MPN RN20-2x6V2.5A-TAP
T902: XFMR-18VCT; XFMR_Rcore_TP8S_TBD; MPN RN35-4x18V0.7A-TAP
T903: XFMR-9VAC; XFMR_Rcore_TP4S_TBD; MPN RN10-2x9V0.83A-TAP
U810: LM393A; SOIC-8_3.9x4.9mm_P1.27mm; MPN LM393ADR
U811: TLC555; SOIC-8_3.9x4.9mm_P1.27mm; MPN TLC555CDR
U812: TLV431A; SOT-23; MPN TLV431AIDBZR

Connections:
AC6_L1: J921.1, J921.3, T900.5 (S1), T900.7 (S3)
AC6_L2: J921.2, J921.4, T900.6 (S2), T900.8 (S4)
AC6_R1: J923.1, J923.3, T901.5 (S1), T901.7 (S3)
AC6_R2: J923.2, J923.4, T901.6 (S2), T901.8 (S4)
AC9A_1: D810.2 (A), D812.1 (K), J927.3, T903.7 (S3)
AC9A_2: D811.2 (A), D813.1 (K), J927.4, T903.8 (S4)
AC9_1: J927.1, T903.5 (S1)
AC9_2: J927.2, T903.6 (S2)
AC18_1: J925.1, J925.3, T902.5 (S1), T902.7 (S3)
AC18_4: J928.2, J928.4, T902.10 (S6), T902.12 (S8)
AC_L_FILT: CX901.1, CY901.1, K900.1, L900.2 (L2), PS900.1 (L), R900.1
AC_L_IN: J900.1, J910.1, J930.1, J933.1, L900.1 (L1), PS901.1 (L), RV901.1, RV902.1
AC_L_SS: K900.3, K901.11, K901.21, R900.2
AC_N_FILT: CX901.2, CY902.1, J920.1, J922.1, J924.1, J926.1, L900.4 (N2), PS900.2 (N), T900.1 (P0), T901.1 (P0), T902.1 (P0), T903.1 (P0)
AC_N_IN: J900.2, J910.2, J930.2, J933.2, L900.3 (N1), PS901.2 (N), RV901.2, RV903.1
AC_PE: CY901.2, CY902.2, J900.3, J910.3, J920.4, J922.4, J924.4, J926.4, J930.3, J933.3, PS900.3 (PE), PS901.3 (PE), RV902.2, RV903.2, T900.4 (SCN), T901.4 (SCN), T902.4 (SCN), T903.4 (SCN)
ARM55: Q812.G, R814.1, U811.3 (OUT)
ARMB: Q810.1 (B), R814.2
ARMS: Q810.3 (C), Q813.G, R815.2
CTRLC: C812.1, U811.5 (CTRL)
ECON_SEL: C814.2, K901.A1, R817.2
ECON_SS: C815.2, K900.2, R818.2
GND: C810.2, C811.2, C812.2, C813.2, D812.2 (A), D813.2 (A), J925.2, J925.4, J928.1, J928.3, J932.1, J932.2, J932.3, PS900.5 (NEGV), Q810.2 (E), Q811.S, Q812.S, Q813.S, R811.2, T902.6 (S2), T902.8 (S4), T902.9 (S5), T902.11 (S7), U810.4 (GND), U810.6 (INB-), U811.1 (GND), U812.3 (A)
GND_AP: PS901.5 (NEGV)
INM: C811.1, D817.2 (A), R810.2, R811.1, U810.2 (INA-)
SEL_DRV: D817.1 (K), D818.2 (A), K901.A2, Q811.D
SEL_GATE: Q811.G, Q812.D, R816.2, U810.1 (OUTA)
SS_DRV: D819.2 (A), K900.5, Q813.D
TAP115: J920.2, J922.2, J924.2, J926.2, K901.14, K901.24, T900.2 (P115), T901.2 (P115), T902.2 (P115), T903.2 (P115)
TAP230: J920.3, J922.3, J924.3, J926.3, K901.12, K901.22, T900.3 (P230), T901.3 (P230), T902.3 (P230), T903.3 (P230)
TMR: C813.1, R813.2, U811.2 (TRIG), U811.6 (THR)
V12SOM: J931.1, J931.2, J931.3, PS900.4 (POSV)
VAP_IO: PS901.4 (POSV)
VREF: R812.2, U810.3 (INA+), U810.5 (INB+), U812.1 (K), U812.2 (REF)
VSEL_AUX: C810.1, C814.1, C815.1, D810.1 (K), D811.1 (K), D818.1 (K), D819.1 (K), R810.1, R812.1, R813.1, R815.1, R816.1, R817.1, R818.1, U810.8 (VCC), U811.4 (RESET), U811.8 (VCC)

Notes on the sheet:
TUB 1 AC ENTRY / AUTO VOLTAGE SELECT (bom 17p) - on the prereg PCB. Sense-before-select: the transformers are TAPPED 0/115/230 V primaries; K901 de-energized feeds the 230 V ends (TAP230 = safe wiring). The 200k/36.5k divider on the 9 VAC aux reservoir VSEL_AUX hands the LM393 ~0.155 x V_SEL; the 1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
SEQUENCE: mains on -> reservoirs charge through R900 -> ~1.65 s TLC555 arm delay -> Q812 releases the LM393 gate node SEL_GATE -> comparator samples -> if low-line, K901 energizes (TAP115) and D817 clamps the sense node so a post-select reservoir jump cannot chatter the state -> ARMS rises and Q813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
LAYOUT NOTES: all mains-domain parts live in a fenced AC zone at the board edge by the chassis DD12 power-entry module (inlet/fuse/switch/filter are chassis-side, QC-tab feed to J900); >=6 mm creepage/clearance primary-to-SELV and L-to-N, milled slot under K901 between the primary-contact poles; MO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
Mains wire entry J910: Phoenix MSTBV 2,5/3-GF-5,08 flanged header (bolt-through mount holes carry the mechanical load) + MSTB 2,5/3-STF-5,08 screw-clamp plug, wire entry up to 2.5 mm2 = 14 AWG, 12 A/250 V rated; PEM end = insulated FASTON-250 receptacle on the DD12 output tabs.
Coil economizer: C kick applies full VSEL_AUX to pick the coil, R||C settles to ~5 V at the ~11 V post-select rail and ~2.4 V (above release) at the ~5 V low-line rail.
Transformer harness: J920/22/24/26 = primary leads (0 V / 115 V tap / 230 V end / SCN->PE), J921/23 + J925/28 + J927 = secondary leads - all Phoenix MSTBV 2,5/4-GF-5,08 flanged headers (1777099, 12 A / 320 V) + MSTB 2,5/4-STF-5,08 screw-clamp plugs (0.2-2.5 mm2 = 14-24 AWG, ample for every secondar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
PS900 = Mean Well LRS-200-12 (bom 17d): universal-input SMPS - J930 mains feed taps AC_L_IN/AC_N_IN/AC_PE UPSTREAM of L900/CX901, so the CM choke + X2 sit BETWEEN the SMPS and the transformer feed (EMI isolation, still MOV-protected; own inrush limiting, works on either line, no tap-select). DC: J9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
LAYOUT: the L900+X2 barrier only blocks the COPPER path - the J930 L/N harness carries SMPS conducted HF and must not run parallel to the J92x secondary bundles (capacitive/inductive pick-up would bypass the barrier onto SELV leads). Twist J930 L/N, route clear of secondaries, cross at 90 deg if un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
PS901 = Mean Well RS-25-3.3 (bom 23): dedicated 3.3 V / 6 A brick for the ENTIRE AP island (XMOS + host SoM + radios + Ethernet ~2-5 A vs 6 A rating). J933 mains feed taps AC_L_IN/AC_N_IN/AC_PE upstream of L900/CX901, same treatment as J930 (own inrush limiting, universal 88-264 VAC input). DC out: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
VSEL_AUX
Latch: with Q811 on, SEL_DRV sits at GND; D817 clamps INM to ~0.9 V so a brown-out or the post-select reservoir jump cannot release K901 until the whole rail collapses.
