ccroswhite/BFDAC/hw/kicad/ap.kicad_sch

## KiCad design hw/kicad/ap.kicad_sch (2026-11-04)

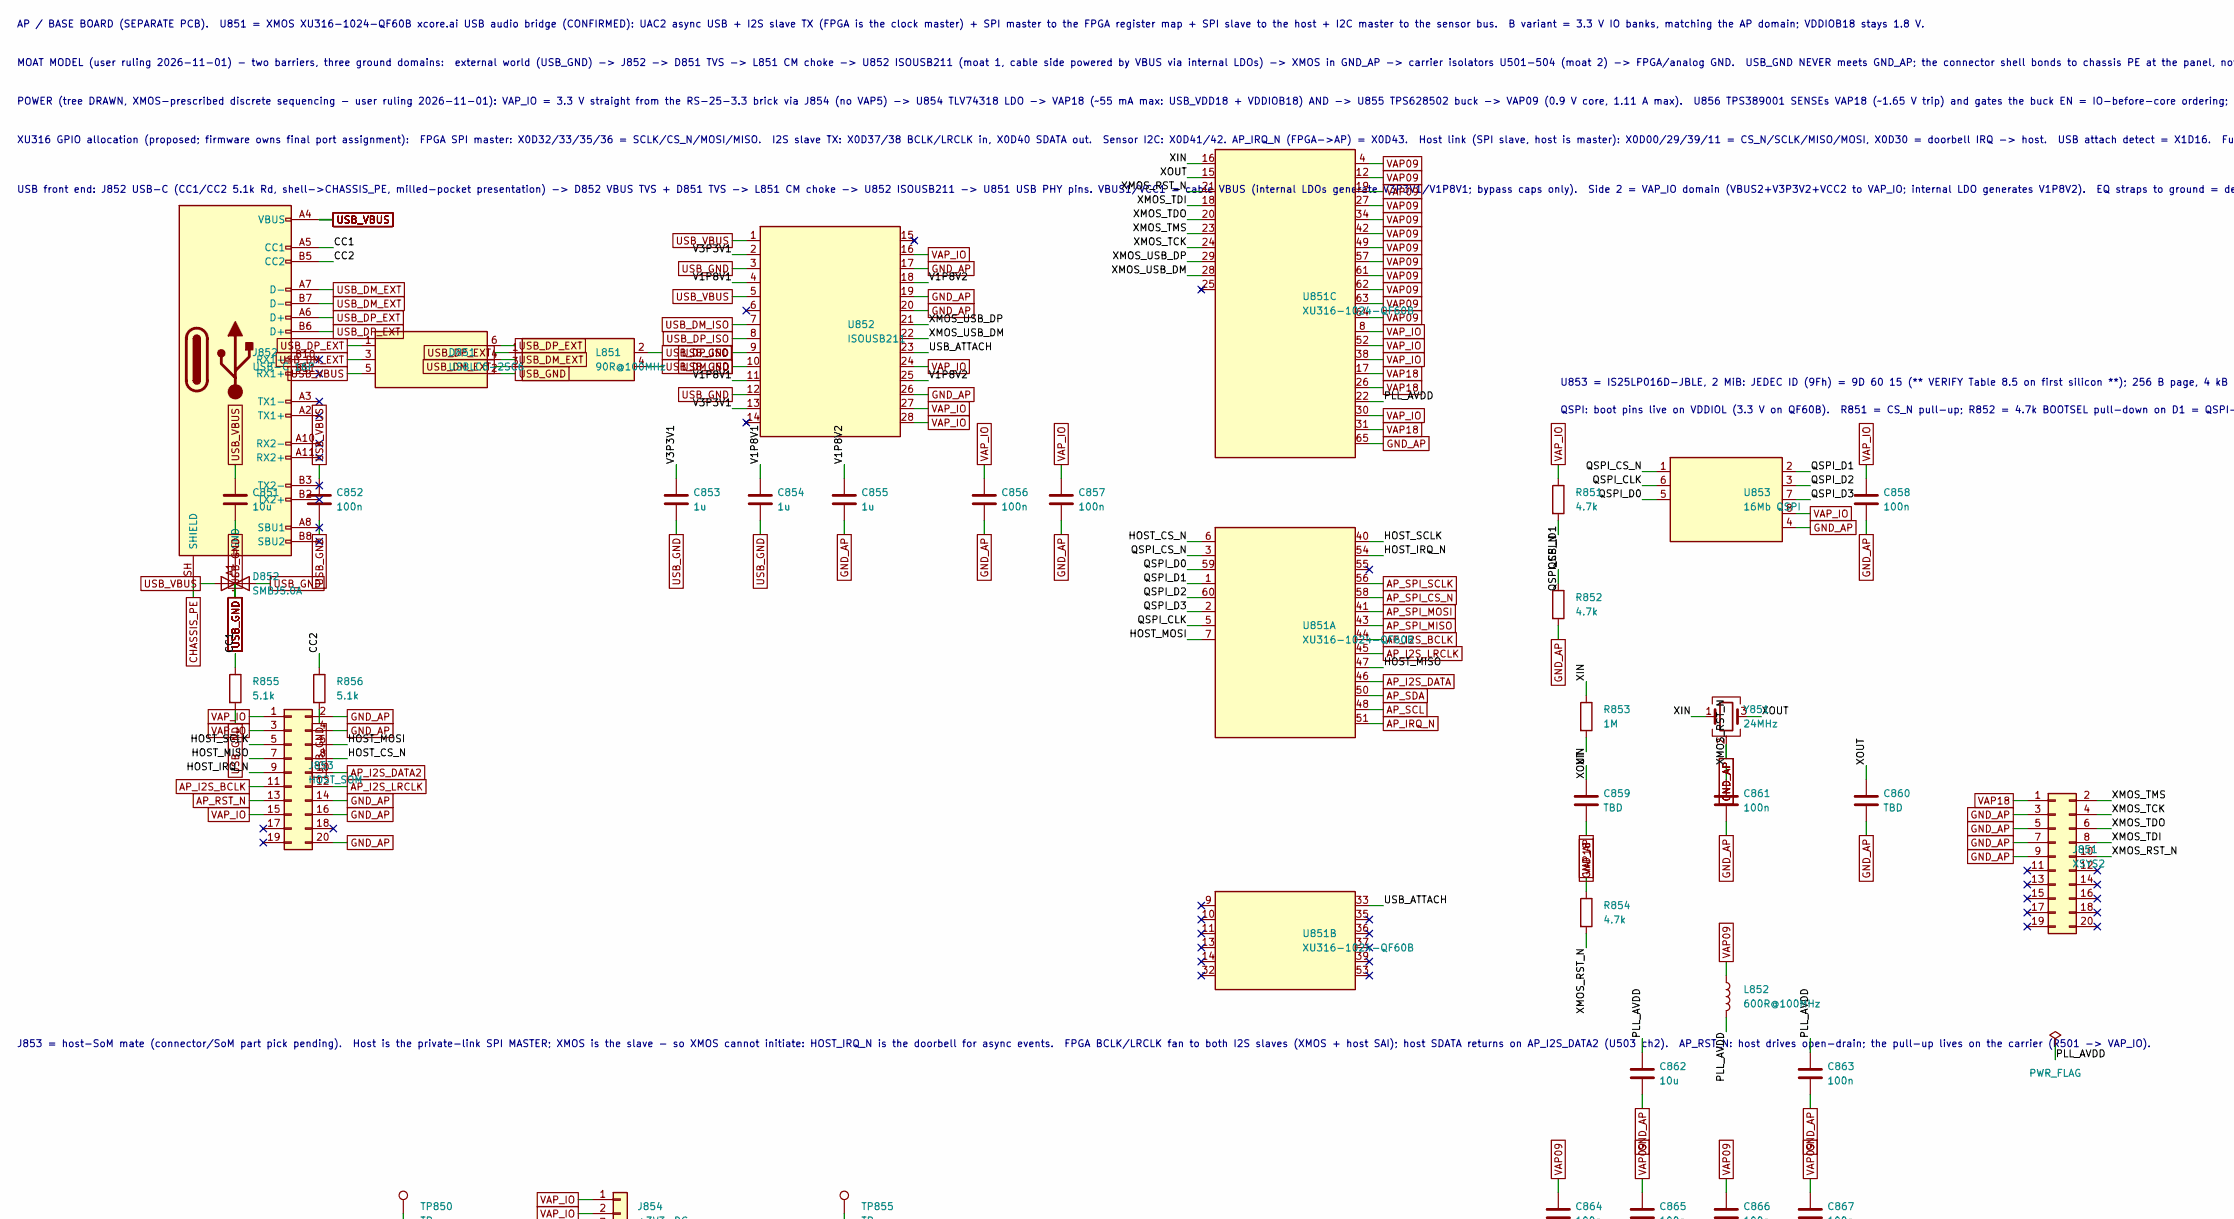
[picture p7: schematic ap.kicad_sch, part in row 1, column 1]

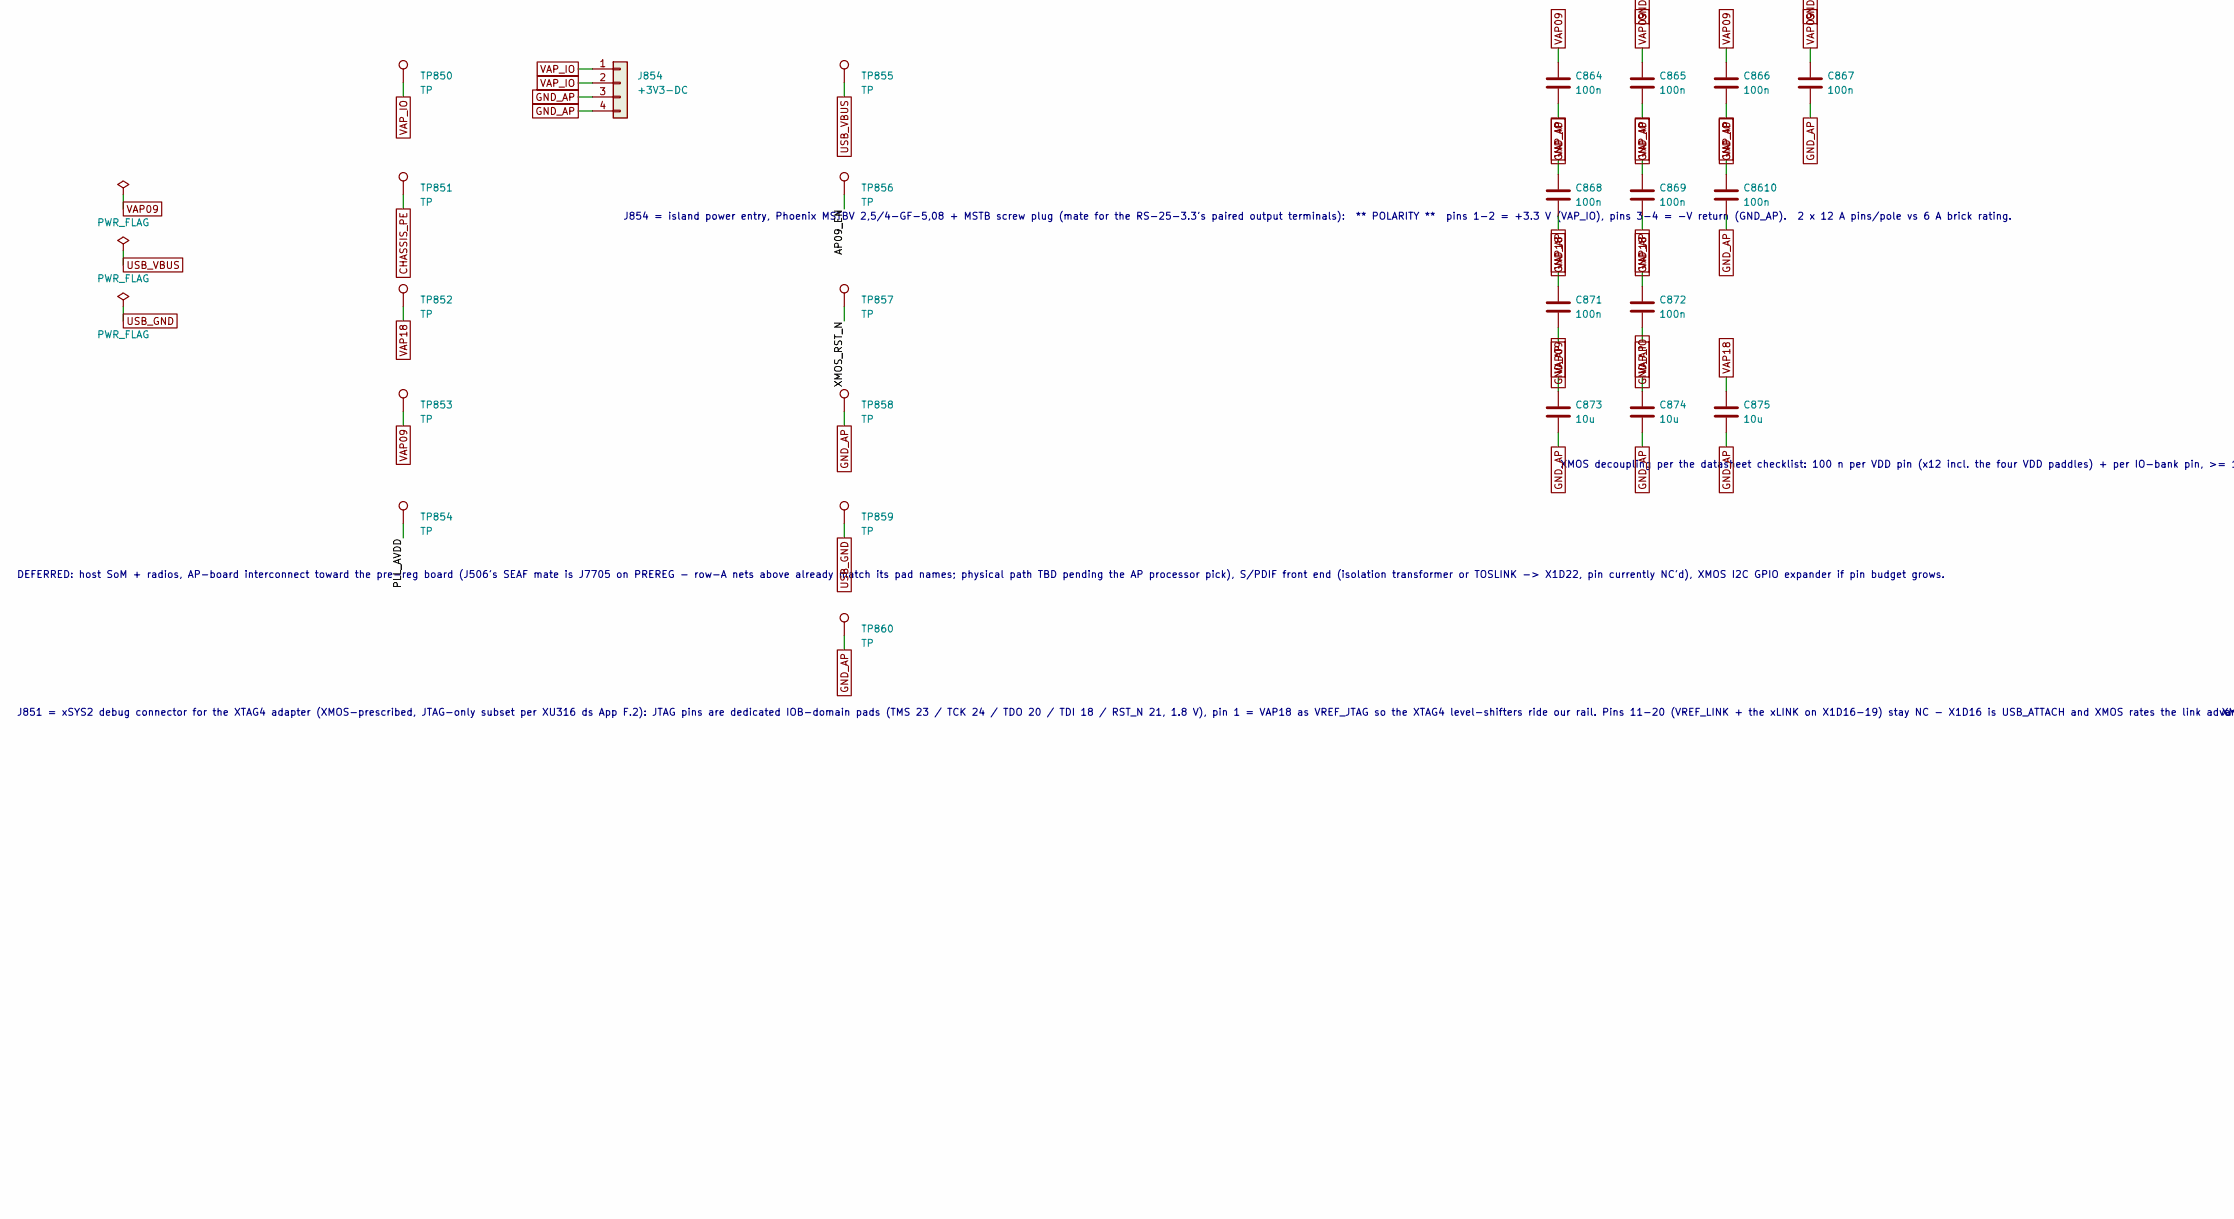
[picture p8: schematic ap.kicad_sch, part in row 2, column 1]

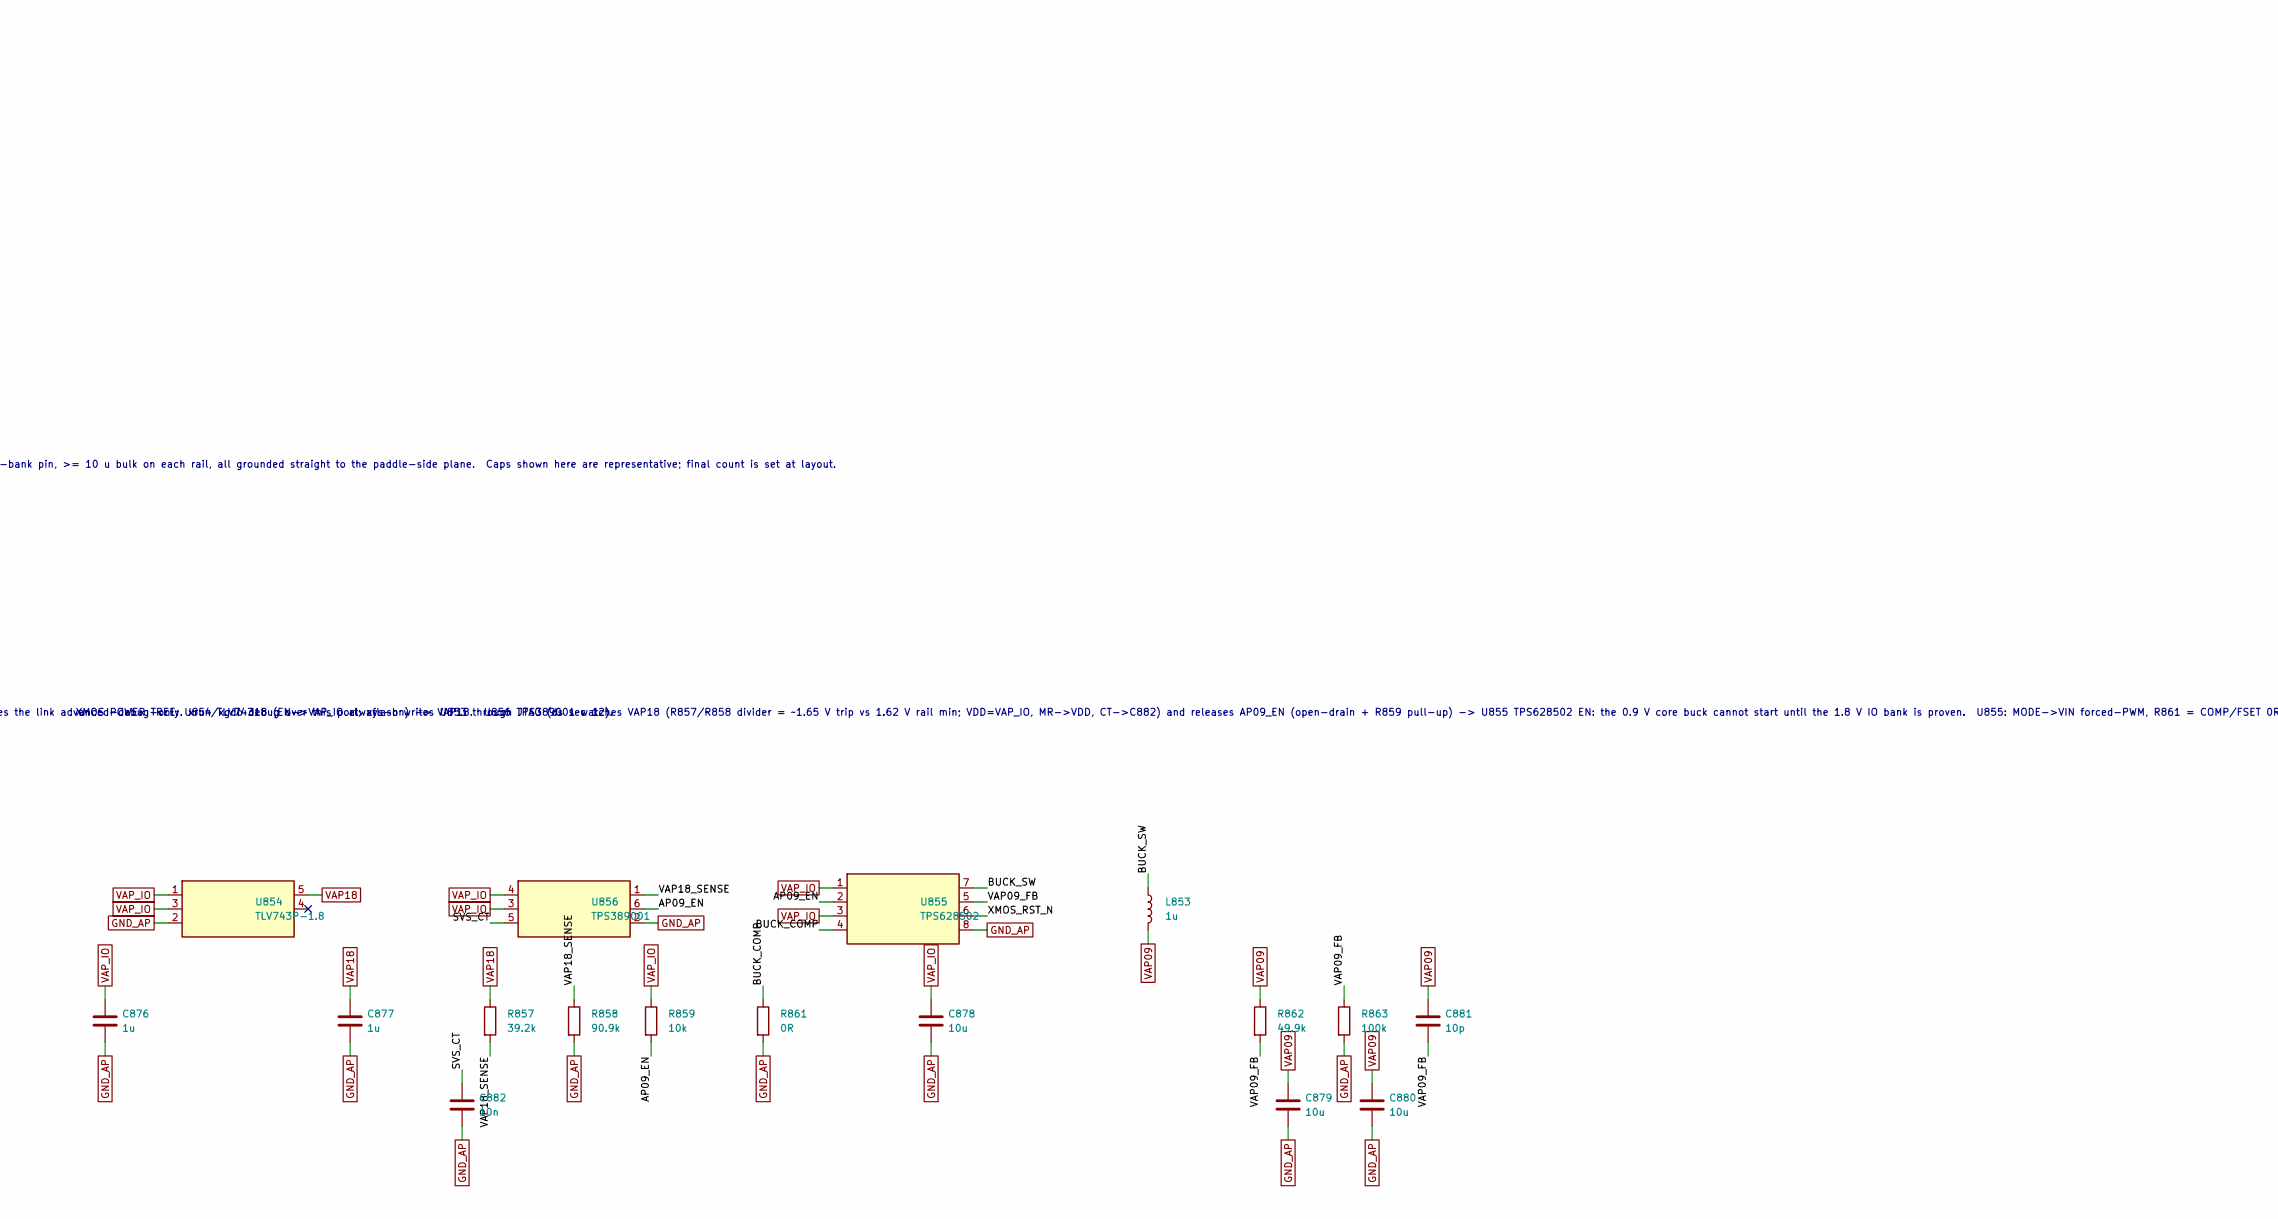
[picture p9: schematic ap.kicad_sch, part in row 2, column 2]

Parts:
C851, C862, C873, C874, C875, C878, C879, C880: 10u; C_0603_1608Metric; MPN GRM188R61A106KE69D (PROPOSED)
C852, C856, C857, C858, C861, C863, C864, C865, C866, C867, C868, C869, C871, C872, C8610: 100n; C_0603_1608Metric; MPN GRM188R71C104KA01D
C853, C854, C855, C876, C877: 1u; C_0603_1608Metric; MPN GRM188R61E105KA12D
C859, C860: TBD; C_0603_1608Metric; MPN TBD - C0G/NP0 0603 (size to crystal CL)
C881: 10p; C_0603_1608Metric; MPN GRM1885C1H100JA01D
C882: 10n; C_0603_1608Metric; MPN GRM188R71C103KA01D
D851: USBLC6-2SC6; SOT-23-6; MPN USBLC6-2SC6 (PROPOSED)
D852: SMBJ5.0A; D_SMB; MPN SMBJ5.0A (PROPOSED - Littelfuse; ~2.5k 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
J851: XSYS2; PinHeader_2x10_P1.27mm_Vertical_SMD; MPN FTSH-110-01-F-DV-K-TR ** PROPOSED **
J852: USB-C 16P; USB_C_Receptacle_GCT_USB4085; MPN USB4085-GF-A (RULED 2026-11-01, user; ~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
J853: HOST_SOM; PinHeader_2x10_P2.54mm_Vertical; MPN TBD - host SoM mate (SODIMM/module conn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
J854: +3V3-DC; PhoenixContact_MSTBV_2,5_4-GF-5,08_1x04_P5.08mm_Vertical_Th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; MPN 1777099
L851: 90R@100MHz; MPN TBD - USB data CM choke (Wurth 74423209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
L852: 600R@100MHz; L_0603_1608Metric; MPN BLM18PG601SN1D (PROPOSED; Taiyo Yuden B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
L853: 1u; L_Coilcraft_XAL4020-XXX; MPN XAL4020-102MEC (VERIFIED stocked - Coil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
R851, R852, R854: 4.7k; R_0603_1608Metric; MPN CRCW06034K70FKEA
R853: 1M; R_0603_1608Metric; MPN CRCW06031M00FKEA
R855, R856: 5.1k; R_0603_1608Metric; MPN CRCW06035K10FKEA
R857: 39.2k; R_0603_1608Metric; MPN RG1608N-3922-W-T1
R858: 90.9k; R_0603_1608Metric; MPN RG1608N-9092-W-T1
R859: 10k; R_0603_1608Metric; MPN CRCW060310K0FKEA
R861: 0R; R_0603_1608Metric; MPN CRCW06030000Z0EA
R862: 49.9k; R_0603_1608Metric; MPN RG1608N-4992-W-T1
R863: 100k; R_0603_1608Metric; MPN RG1608N-1003-W-T1
TP850, TP851, TP852, TP853, TP854, TP855, TP856, TP857, TP858, TP859, TP860: TP; TestPoint_THTPad_2.0x2.0mm_Drill1.0mm
U851: XU316-1024-QF60B; XMOS_QF60_7x7_P0.4; MPN XU316-1024-QF60B-C32 (PROPOSED; -C24 ac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
U852: ISOUSB211; SSOP-28_5.3x10.2mm_P0.65mm; MPN ISOUSB211DPR (PROPOSED - cross-check su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
U853: 16Mb QSPI; SOIC-8_5.3x5.3mm_P1.27mm; MPN IS25LP016D-JBLE (RULED 2026-11-01, user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
U854: TLV743P-1.8; SOT-23-5; MPN TLV74318PDBVR (RULED 2026-11-01, user)
U855: TPS628502; SOT-583-8; MPN TPS628502DRLR (RULED 2026-11-01, user)
U856: TPS389001; WSON-6_1.5x1.5mm_P0.5mm; MPN TPS389001DSET (PROPOSED - same part as 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
Y851: 24MHz; Crystal_SMD_3225-4Pin_3.2x2.5mm; MPN TBD - 24 MHz 3225 crystal (Epson FA-128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

Connections:
AP09_EN: R859.2, TP856.1, U855.2 (EN), U856.6 (RESET)
AP_I2S_BCLK: J853.11, U851.44 (X0D37)
AP_I2S_DATA: U851.46 (X0D40)
AP_I2S_DATA2: J853.10
AP_I2S_LRCLK: J853.12, U851.45 (X0D38)
AP_IRQ_N: U851.51 (X0D43)
AP_RST_N: J853.13
AP_SCL: U851.48 (X0D42)
AP_SDA: U851.50 (X0D41)
AP_SPI_CS_N: U851.58 (X0D33)
AP_SPI_MISO: U851.43 (X0D36)
AP_SPI_MOSI: U851.41 (X0D35)
AP_SPI_SCLK: U851.56 (X0D32)
BUCK_COMP: R861.1, U855.4 (COMP)
BUCK_SW: L853.1, U855.7 (SW)
CC1: J852.A5 (CC1), R855.1
CC2: J852.B5 (CC2), R856.1
CHASSIS_PE: J852.SH (SHIELD), TP851.1
GND_AP: C855.2, C856.2, C857.2, C858.2, C859.2, C860.2, C861.2, C862.2, C863.2, C864.2, C865.2, C866.2, C867.2, C868.2, C869.2, C871.2, C872.2, C873.2, C874.2, C875.2, C876.2, C877.2, C878.2, C879.2, C880.2, C882.2, C8610.2, J851.3, J851.5, J851.7, J851.9, J853.2, J853.4, J853.14, J853.16, J853.20, J854.3, J854.4, R852.2, R858.2, R861.2, R863.2, TP858.1, TP860.1, U851.65 (VSS), U852.17 (GND2), U852.19 (EQ21), U852.20 (EQ20), U852.26 (GND2), U853.4 (VSS), U854.2 (GND), U855.8 (GND), U856.2 (GND), Y851.2 (G), Y851.4 (G)
HOST_CS_N: J853.8, U851.6 (X0D00)
HOST_IRQ_N: J853.9, U851.54 (X0D30)
HOST_MISO: J853.7, U851.47 (X0D39)
HOST_MOSI: J853.6, U851.7 (X0D11)
HOST_SCLK: J853.5, U851.40 (X0D29)
PLL_AVDD: C862.1, C863.1, L852.2, TP854.1, U851.22 (PLL_AVDD)
QSPI_CLK: U851.5 (X0D10), U853.6 (SCK)
QSPI_CS_N: R851.2, U851.3 (X0D01), U853.1 (CS_N)
QSPI_D0: U851.59 (X0D04), U853.5 (SI)
QSPI_D1: R852.1, U851.1 (X0D05), U853.2 (SO)
QSPI_D2: U851.60 (X0D06), U853.3 (WP_N)
QSPI_D3: U851.2 (X0D07), U853.7 (HOLD_N)
SVS_CT: C882.1, U856.5 (CT)
USB_ATTACH: U851.33 (X1D16), U852.23 (V1OK)
USB_DM_EXT: D851.3 (IO2A), D851.4 (IO2B), J852.A7 (D-), J852.B7 (D-), L851.3 (N1)
USB_DM_ISO: L851.4 (N2), U852.7 (UD-)
USB_DP_EXT: D851.1 (IO1A), D851.6 (IO1B), J852.A6 (D+), J852.B6 (D+), L851.1 (L1)
USB_DP_ISO: L851.2 (L2), U852.8 (UD+)
USB_GND: C851.2, C852.2, C853.2, C854.2, D851.2 (GND), D852.2 (A2), J852.A1 (GND), J852.A12 (GND), J852.B1 (GND), J852.B12 (GND), R855.2, R856.2, TP859.1, U852.3 (GND1), U852.9 (EQ10), U852.10 (EQ11), U852.12 (GND1)
USB_VBUS: C851.1, C852.1, D851.5 (VBUS), D852.1 (A1), J852.A4 (VBUS), J852.A9 (VBUS), J852.B4 (VBUS), J852.B9 (VBUS), TP855.1, U852.1 (VBUS1), U852.5 (VCC1)
V1P8V1: C854.1, U852.4 (V1P8V1), U852.11 (V1P8V1)
V1P8V2: C855.1, U852.18 (V1P8V2), U852.25 (V1P8V2)
V3P3V1: C853.1, U852.2 (V3P3V1), U852.13 (CDPENZ1)
VAP09: C864.1, C865.1, C866.1, C867.1, C873.1, C879.1, C880.1, C881.1, L852.1, L853.2, R862.1, TP853.1, U851.4 (VDD), U851.12 (VDD), U851.19 (VDD), U851.27 (VDD), U851.34 (VDD), U851.42 (VDD), U851.49 (VDD), U851.57 (VDD), U851.61 (VDD), U851.62 (VDD), U851.63 (VDD), U851.64 (VDD)
VAP09_FB: C881.2, R862.2, R863.1, U855.5 (FB)
VAP18: C871.1, C872.1, C875.1, C877.1, J851.1, R854.1, R857.1, TP852.1, U851.17 (VDDIOB18), U851.26 (VDDIOB18), U851.31 (USB_VDD18), U854.5 (OUT)
VAP18_SENSE: R857.2, R858.1, U856.1 (SENSE)
VAP_IO: C856.1, C857.1, C858.1, C868.1, C869.1, C874.1, C876.1, C878.1, C8610.1, J853.1, J853.3, J853.15, J854.1, J854.2, R851.1, R859.1, TP850.1, U851.8 (VDDIOL), U851.30 (USB_VDD33), U851.38 (VDDIOR), U851.52 (VDDIOT), U852.16 (CDPENZ2), U852.24 (VCC2), U852.27 (V3P3V2), U852.28 (VBUS2), U853.8 (VCC), U854.1 (IN), U854.3 (EN), U855.1 (VIN), U855.3 (MODE), U856.3 (MR), U856.4 (VDD)
XIN: C859.1, R853.1, U851.16 (XIN), Y851.1
XMOS_RST_N: C861.1, J851.10, R854.2, TP857.1, U851.21 (RST_N), U855.6 (PG)
XMOS_TCK: J851.4, U851.24 (TCK)
XMOS_TDI: J851.8, U851.18 (TDI)
XMOS_TDO: J851.6, U851.20 (TDO)
XMOS_TMS: J851.2, U851.23 (TMS)
XMOS_USB_DM: U851.28 (USB_DM), U852.22 (DD-)
XMOS_USB_DP: U851.29 (USB_DP), U852.21 (DD+)
XOUT: C860.1, R853.2, U851.15 (XOUT), Y851.3

Notes on the sheet:
AP / BASE BOARD (SEPARATE PCB). U851 = XMOS XU316-1024-QF60B xcore.ai USB audio bridge (CONFIRMED): UAC2 async USB + I2S slave TX (FPGA is the clock master) + SPI master to the FPGA register map + SPI slave to the host + I2C master to the sensor bus. B variant = 3.3 V IO banks, matching the AP doma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
MOAT MODEL (user ruling 2026-11-01) - two barriers, three ground domains: external world (USB_GND) -> J852 -> D851 TVS -> L851 CM choke -> U852 ISOUSB211 (moat 1, cable side powered by VBUS via internal LDOs) -> XMOS in GND_AP -> carrier isolators U501-504 (moat 2) -> FPGA/analog GND. USB_GND NEVER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
POWER (tree DRAWN, XMOS-prescribed discrete sequencing - user ruling 2026-11-01): VAP_IO = 3.3 V straight from the RS-25-3.3 brick via J854 (no VAP5) -> U854 TLV74318 LDO -> VAP18 (~55 mA max: USB_VDD18 + VDDIOB18) AND -> U855 TPS628502 buck -> VAP09 (0.9 V core, 1.11 A max). U856 TPS389001 SENSEs 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
XU316 GPIO allocation (proposed; firmware owns final port assignment): FPGA SPI master: X0D32/33/35/36 = SCLK/CS_N/MOSI/MISO. I2S slave TX: X0D37/38 BCLK/LRCLK in, X0D40 SDATA out. Sensor I2C: X0D41/42. AP_IRQ_N (FPGA->AP) = X0D43. Host link (SPI slave, host is master): X0D00/29/39/11 = CS_N/SCLK/M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
USB front end: J852 USB-C (CC1/CC2 5.1k Rd, shell->CHASSIS_PE, milled-pocket presentation) -> D852 VBUS TVS + D851 TVS -> L851 CM choke -> U852 ISOUSB211 -> U851 USB PHY pins. VBUS1/VCC1 = cable VBUS (internal LDOs generate V3P3V1/V1P8V1; bypass caps only). Side 2 = VAP_IO domain (VBUS2+V3P3V2+VCC2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
QSPI: boot pins live on VDDIOL (3.3 V on QF60B). R851 = CS_N pull-up; R852 = 4.7k BOOTSEL pull-down on D1 = QSPI-master boot (pull high instead -> SPI-slave boot mode, used for factory programming).
U853 = IS25LP016D-JBLE, 2 MiB: JEDEC ID (9Fh) = 9D 60 15 (** VERIFY Table 8.5 on first silicon **); 256 B page, 4 kB uniform sectors. XMOS map: loader+factory @0, CRC-versioned upgrade images, data partition tail (xflash --boot-partition-size). Host reaches the flash THROUGH the XMOS (SPI-slave cmd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
J851 = xSYS2 debug connector for the XTAG4 adapter (XMOS-prescribed, JTAG-only subset per XU316 ds App F.2): JTAG pins are dedicated IOB-domain pads (TMS 23 / TCK 24 / TDO 20 / TDI 18 / RST_N 21, 1.8 V), pin 1 = VAP18 as VREF_JTAG so the XTAG4 level-shifters ride our rail. Pins 11-20 (VREF_LINK + t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
J853 = host-SoM mate (connector/SoM part pick pending). Host is the private-link SPI MASTER; XMOS is the slave - so XMOS cannot initiate: HOST_IRQ_N is the doorbell for async events. FPGA BCLK/LRCLK fan to both I2S slaves (XMOS + host SAI); host SDATA returns on AP_I2S_DATA2 (U503 ch2). AP_RST_N: h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
XMOS decoupling per the datasheet checklist: 100 n per VDD pin (x12 incl. the four VDD paddles) + per IO-bank pin, >= 10 u bulk on each rail, all grounded straight to the paddle-side plane. Caps shown here are representative; final count is set at layout.
J854 = island power entry, Phoenix MSTBV 2,5/4-GF-5,08 + MSTB screw plug (mate for the RS-25-3.3's paired output terminals): ** POLARITY ** pins 1-2 = +3.3 V (VAP_IO), pins 3-4 = -V return (GND_AP). 2 x 12 A pins/pole vs 6 A brick rating.
XMOS POWER TREE: U854 TLV74318 (EN->VAP_IO always-on) -> VAP18. U856 TPS389001 watches VAP18 (R857/R858 divider = ~1.65 V trip vs 1.62 V rail min; VDD=VAP_IO, MR->VDD, CT->C882) and releases AP09_EN (open-drain + R859 pull-up) -> U855 TPS628502 EN: the 0.9 V core buck cannot start until the 1.8 V I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
DEFERRED: host SoM + radios, AP-board interconnect toward the pre-reg board (J506's SEAF mate is J7705 on PREREG - row-A nets above already match its pad names; physical path TBD pending the AP processor pick), S/PDIF front end (isolation transformer or TOSLINK -> X1D22, pin currently NC'd), XMOS I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
