ccroswhite/BFDAC/hw/kicad/bringup.kicad_sch

## KiCad design hw/kicad/bringup.kicad_sch (2026-11-04)

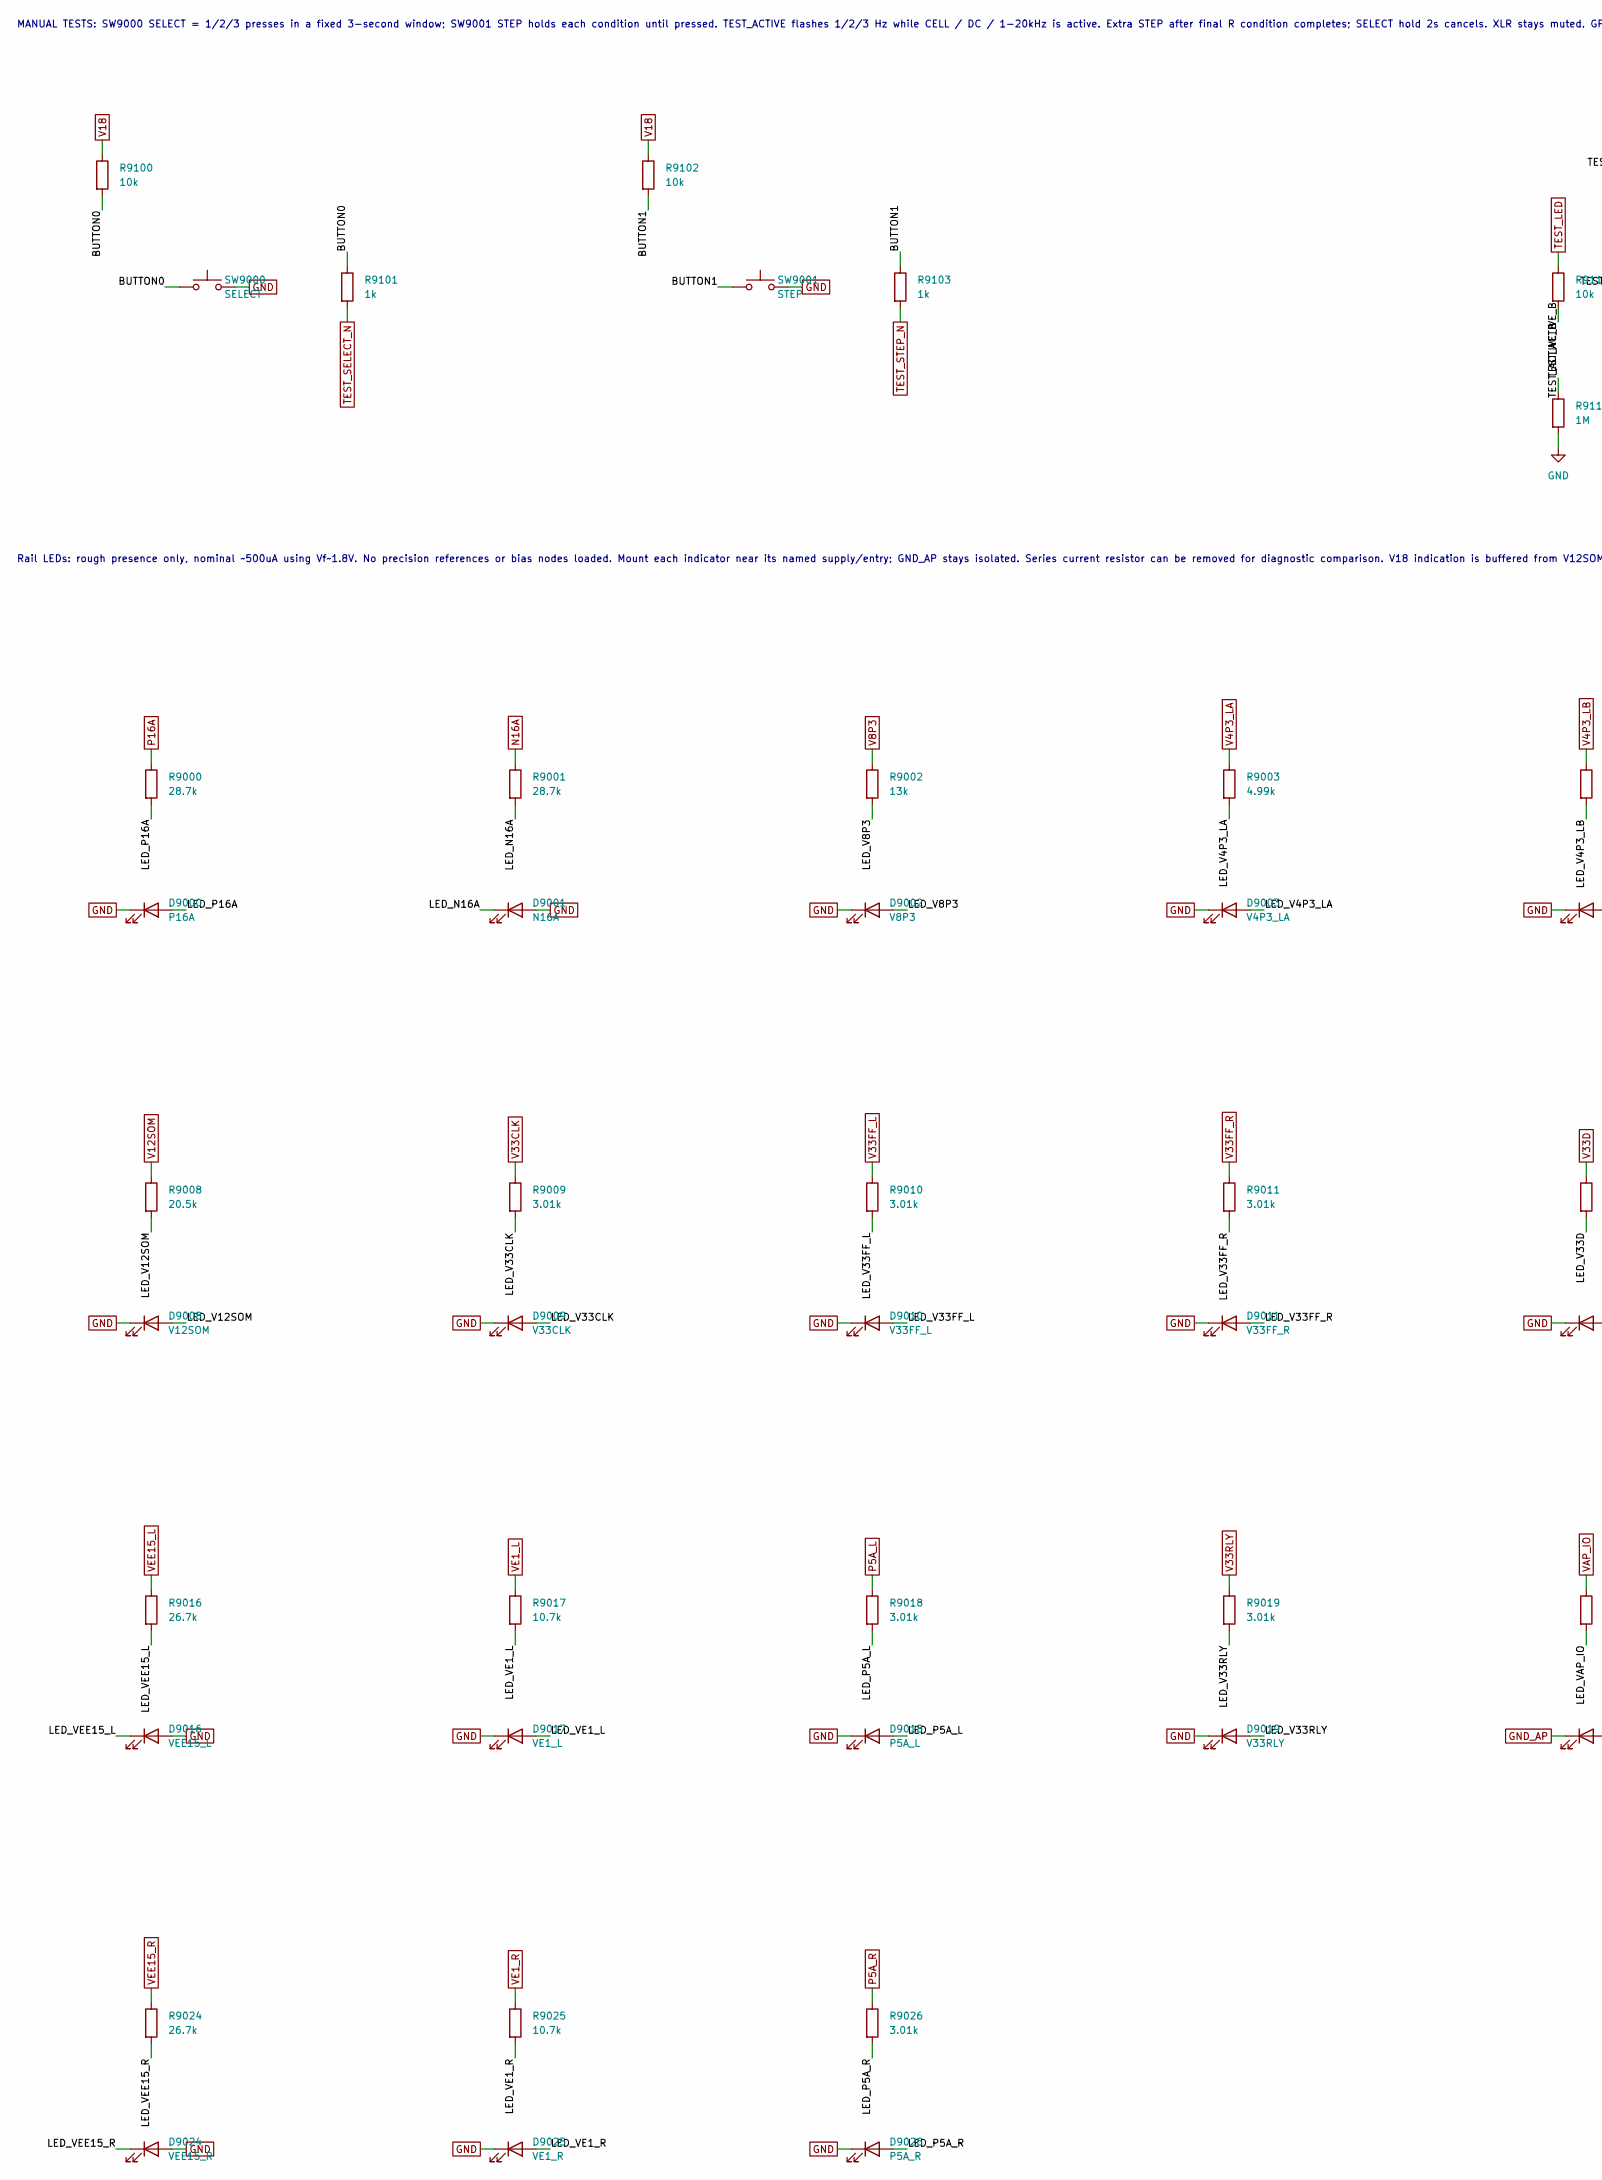
[picture p10: schematic bringup.kicad_sch, part in row 1, column 1]

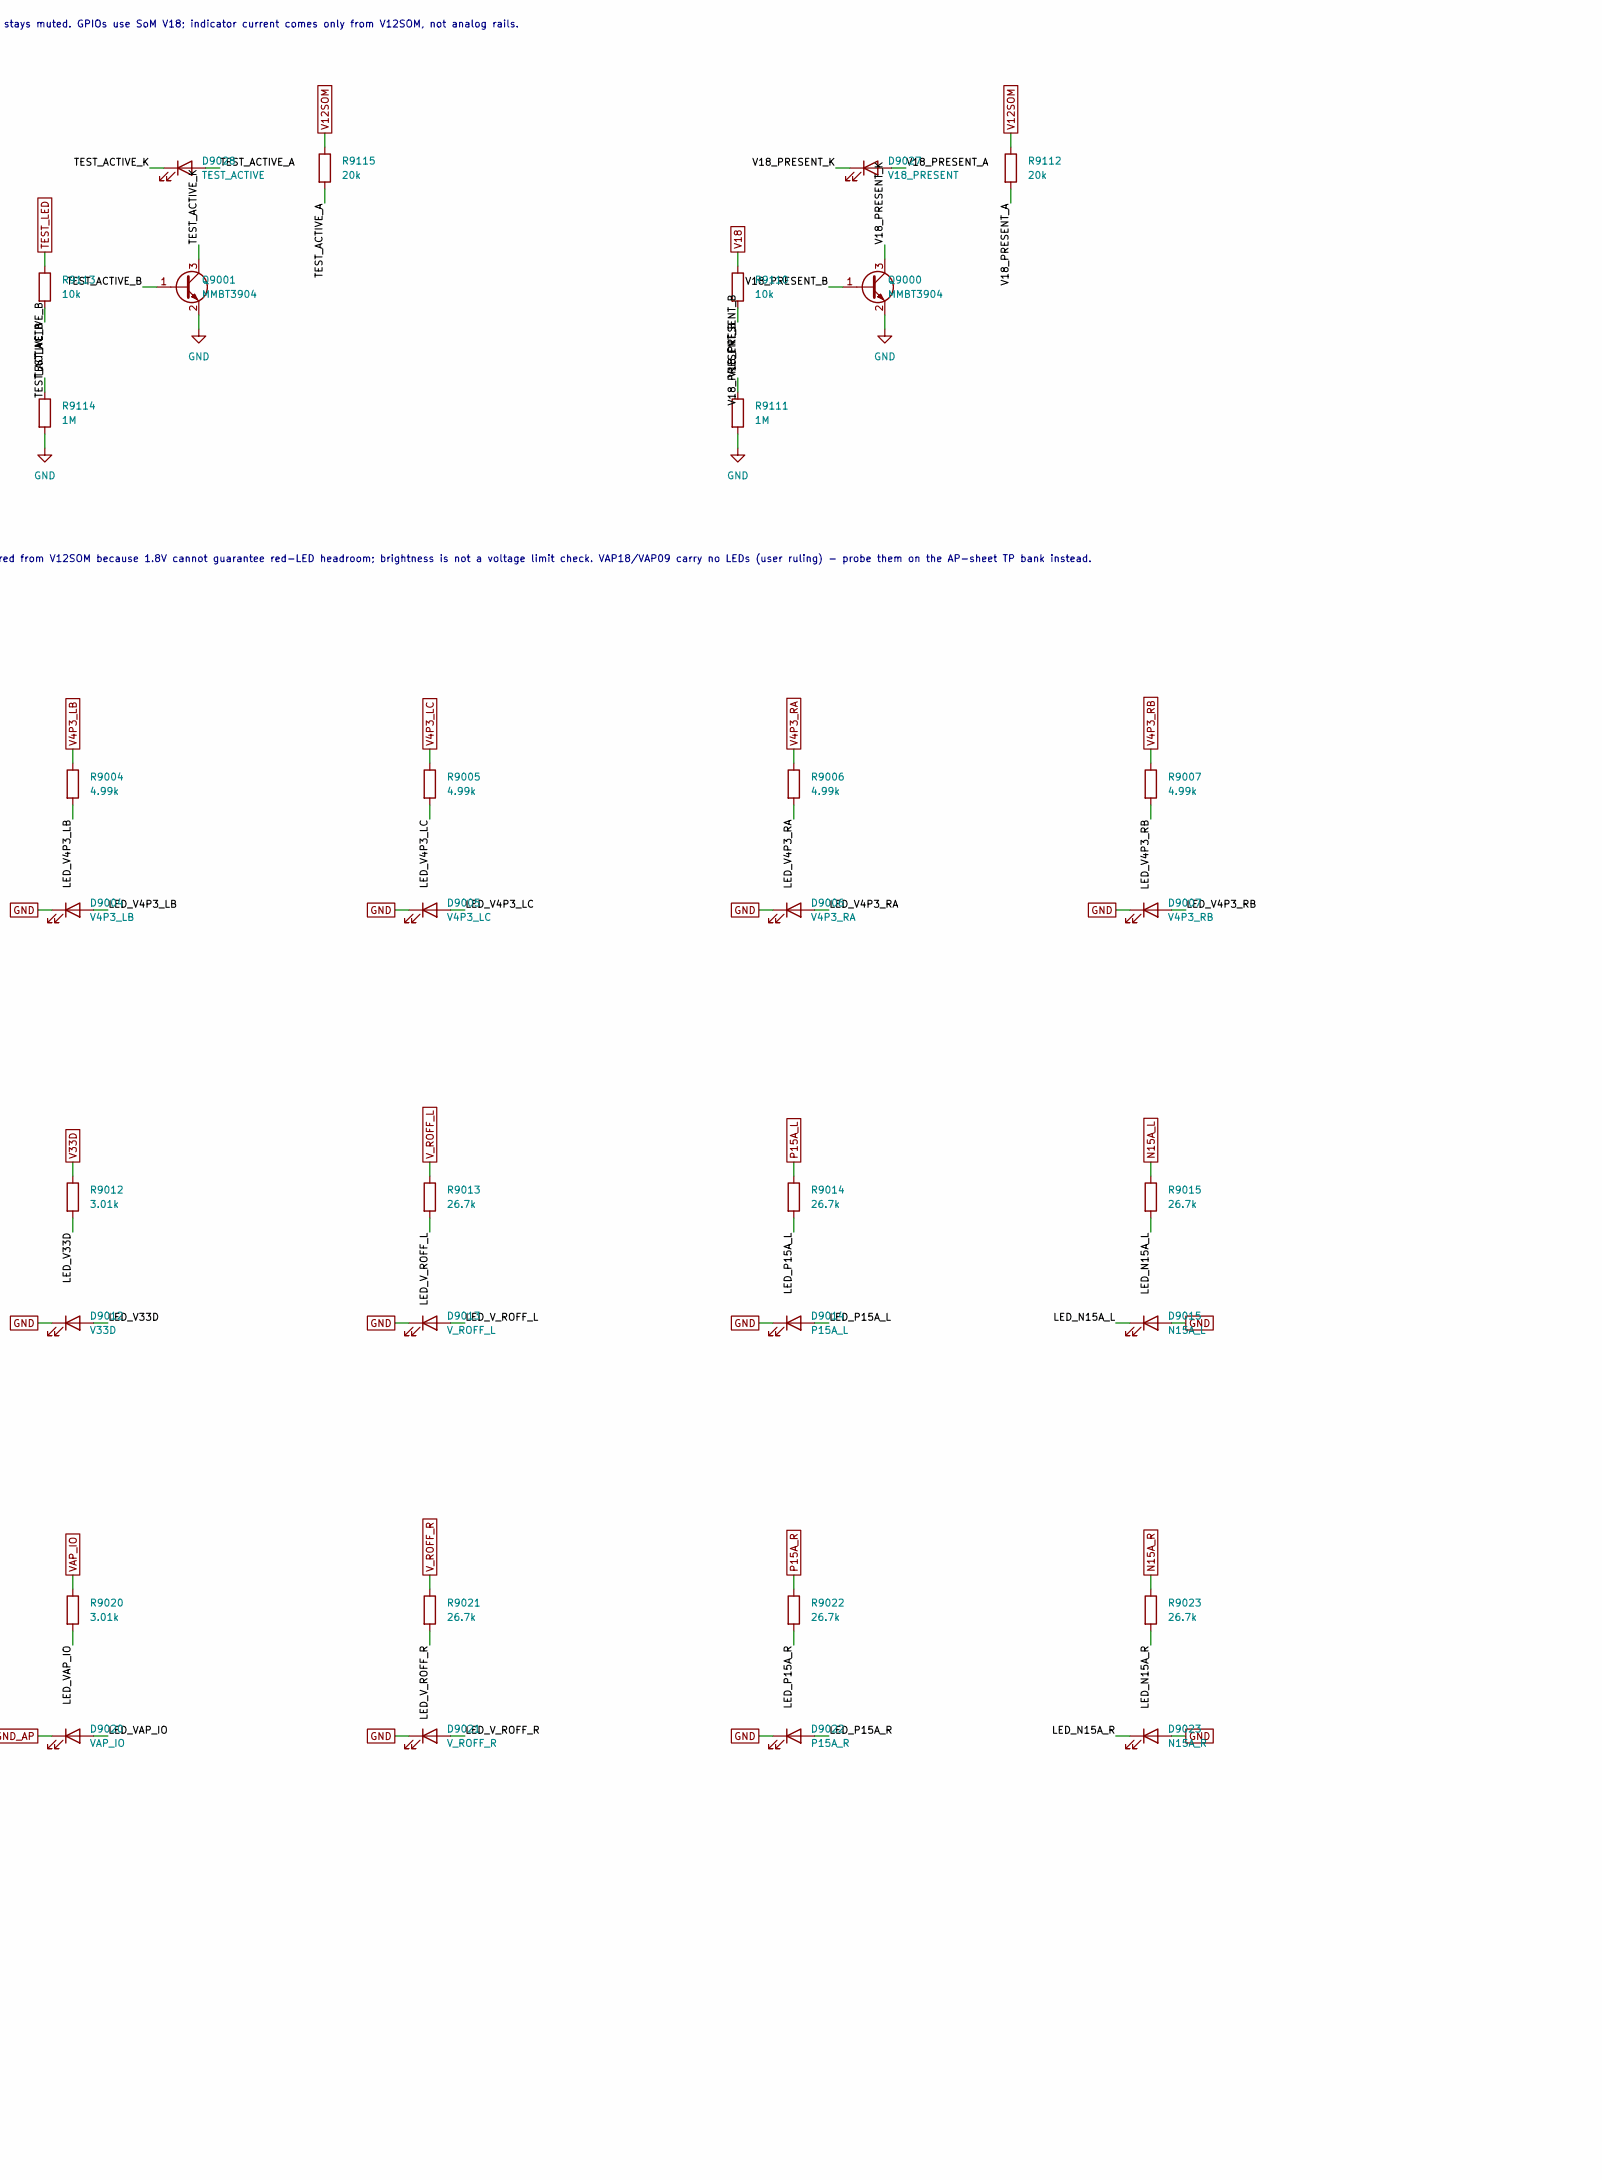
[picture p11: schematic bringup.kicad_sch, part in row 1, column 2]

Parts:
D9000: P16A; LED_0603_1608Metric; MPN APT1608LSECK/J3-PRV
D9001: N16A; LED_0603_1608Metric; MPN APT1608LSECK/J3-PRV
D9002: V8P3; LED_0603_1608Metric; MPN APT1608LSECK/J3-PRV
D9003: V4P3_LA; LED_0603_1608Metric; MPN APT1608LSECK/J3-PRV
D9004: V4P3_LB; LED_0603_1608Metric; MPN APT1608LSECK/J3-PRV
D9005: V4P3_LC; LED_0603_1608Metric; MPN APT1608LSECK/J3-PRV
D9006: V4P3_RA; LED_0603_1608Metric; MPN APT1608LSECK/J3-PRV
D9007: V4P3_RB; LED_0603_1608Metric; MPN APT1608LSECK/J3-PRV
D9008: V12SOM; LED_0603_1608Metric; MPN APT1608LSECK/J3-PRV
D9009: V33CLK; LED_0603_1608Metric; MPN APT1608LSECK/J3-PRV
D9010: V33FF_L; LED_0603_1608Metric; MPN APT1608LSECK/J3-PRV
D9011: V33FF_R; LED_0603_1608Metric; MPN APT1608LSECK/J3-PRV
D9012: V33D; LED_0603_1608Metric; MPN APT1608LSECK/J3-PRV
D9013: V_ROFF_L; LED_0603_1608Metric; MPN APT1608LSECK/J3-PRV
D9014: P15A_L; LED_0603_1608Metric; MPN APT1608LSECK/J3-PRV
D9015: N15A_L; LED_0603_1608Metric; MPN APT1608LSECK/J3-PRV
D9016: VEE15_L; LED_0603_1608Metric; MPN APT1608LSECK/J3-PRV
D9017: VE1_L; LED_0603_1608Metric; MPN APT1608LSECK/J3-PRV
D9018: P5A_L; LED_0603_1608Metric; MPN APT1608LSECK/J3-PRV
D9019: V33RLY; LED_0603_1608Metric; MPN APT1608LSECK/J3-PRV
D9020: VAP_IO; LED_0603_1608Metric; MPN APT1608LSECK/J3-PRV
D9021: V_ROFF_R; LED_0603_1608Metric; MPN APT1608LSECK/J3-PRV
D9022: P15A_R; LED_0603_1608Metric; MPN APT1608LSECK/J3-PRV
D9023: N15A_R; LED_0603_1608Metric; MPN APT1608LSECK/J3-PRV
D9024: VEE15_R; LED_0603_1608Metric; MPN APT1608LSECK/J3-PRV
D9025: VE1_R; LED_0603_1608Metric; MPN APT1608LSECK/J3-PRV
D9026: P5A_R; LED_0603_1608Metric; MPN APT1608LSECK/J3-PRV
D9027: V18_PRESENT; LED_0603_1608Metric; MPN APT1608LSECK/J3-PRV
D9028: TEST_ACTIVE; LED_0603_1608Metric; MPN APT1608LSECK/J3-PRV
Q9000, Q9001: MMBT3904; SOT-23; MPN MMBT3904LT1G
R9000, R9001: 28.7k; R_0603_1608Metric; MPN TNPW06032872FEEA
R9002: 13k; R_0603_1608Metric; MPN TNPW06031302FEEA
R9003, R9004, R9005, R9006, R9007: 4.99k; R_0603_1608Metric; MPN TNPW06034991FEEA
R9008: 20.5k; R_0603_1608Metric; MPN TNPW06032052FEEA
R9009, R9010, R9011, R9012, R9018, R9019, R9020, R9026: 3.01k; R_0603_1608Metric; MPN TNPW06033011FEEA
R9013, R9014, R9015, R9016, R9021, R9022, R9023, R9024: 26.7k; R_0603_1608Metric; MPN TNPW06032672FEEA
R9017, R9025: 10.7k; R_0603_1608Metric; MPN TNPW06031072FEEA
R9100, R9102, R9110, R9113: 10k; R_0603_1608Metric; MPN TNPW06031002FEEA
R9101, R9103: 1k; R_0603_1608Metric; MPN TNPW06031001FEEA
R9111, R9114: 1M; R_0603_1608Metric; MPN TNPW06031004FEEA
R9112, R9115: 20k; R_0603_1608Metric; MPN TNPW06032002FEEA
SW9000: SELECT; SW_Push_1P1T_NO_Vertical_Wuerth_434133025816; MPN 434133025816
SW9001: STEP; SW_Push_1P1T_NO_Vertical_Wuerth_434133025816; MPN 434133025816

Connections:
BUTTON0: R9100.2, R9101.1, SW9000.1
BUTTON1: R9102.2, R9103.1, SW9001.1
GND: D9000.1 (K), D9001.2 (A), D9002.1 (K), D9003.1 (K), D9004.1 (K), D9005.1 (K), D9006.1 (K), D9007.1 (K), D9008.1 (K), D9009.1 (K), D9010.1 (K), D9011.1 (K), D9012.1 (K), D9013.1 (K), D9014.1 (K), D9015.2 (A), D9016.2 (A), D9017.1 (K), D9018.1 (K), D9019.1 (K), D9021.1 (K), D9022.1 (K), D9023.2 (A), D9024.2 (A), D9025.1 (K), D9026.1 (K), Q9000.2 (E), Q9001.2 (E), R9111.2, R9114.2, SW9000.2, SW9001.2
GND_AP: D9020.1 (K)
LED_N15A_L: D9015.1 (K), R9015.2
LED_N15A_R: D9023.1 (K), R9023.2
LED_N16A: D9001.1 (K), R9001.2
LED_P5A_L: D9018.2 (A), R9018.2
LED_P5A_R: D9026.2 (A), R9026.2
LED_P15A_L: D9014.2 (A), R9014.2
LED_P15A_R: D9022.2 (A), R9022.2
LED_P16A: D9000.2 (A), R9000.2
LED_V4P3_LA: D9003.2 (A), R9003.2
LED_V4P3_LB: D9004.2 (A), R9004.2
LED_V4P3_LC: D9005.2 (A), R9005.2
LED_V4P3_RA: D9006.2 (A), R9006.2
LED_V4P3_RB: D9007.2 (A), R9007.2
LED_V8P3: D9002.2 (A), R9002.2
LED_V12SOM: D9008.2 (A), R9008.2
LED_V33CLK: D9009.2 (A), R9009.2
LED_V33D: D9012.2 (A), R9012.2
LED_V33FF_L: D9010.2 (A), R9010.2
LED_V33FF_R: D9011.2 (A), R9011.2
LED_V33RLY: D9019.2 (A), R9019.2
LED_VAP_IO: D9020.2 (A), R9020.2
LED_VE1_L: D9017.2 (A), R9017.2
LED_VE1_R: D9025.2 (A), R9025.2
LED_VEE15_L: D9016.1 (K), R9016.2
LED_VEE15_R: D9024.1 (K), R9024.2
LED_V_ROFF_L: D9013.2 (A), R9013.2
LED_V_ROFF_R: D9021.2 (A), R9021.2
N15A_L: R9015.1
N15A_R: R9023.1
N16A: R9001.1
P5A_L: R9018.1
P5A_R: R9026.1
P15A_L: R9014.1
P15A_R: R9022.1
P16A: R9000.1
TEST_ACTIVE_A: D9028.2 (A), R9115.2
TEST_ACTIVE_B: Q9001.1 (B), R9113.2, R9114.1
TEST_ACTIVE_K: D9028.1 (K), Q9001.3 (C)
TEST_LED: R9113.1
TEST_SELECT_N: R9101.2
TEST_STEP_N: R9103.2
V4P3_LA: R9003.1
V4P3_LB: R9004.1
V4P3_LC: R9005.1
V4P3_RA: R9006.1
V4P3_RB: R9007.1
V8P3: R9002.1
V12SOM: R9008.1, R9112.1, R9115.1
V18: R9100.1, R9102.1, R9110.1
V18_PRESENT_A: D9027.2 (A), R9112.2
V18_PRESENT_B: Q9000.1 (B), R9110.2, R9111.1
V18_PRESENT_K: D9027.1 (K), Q9000.3 (C)
V33CLK: R9009.1
V33D: R9012.1
V33FF_L: R9010.1
V33FF_R: R9011.1
V33RLY: R9019.1
VAP_IO: R9020.1
VE1_L: R9017.1
VE1_R: R9025.1
VEE15_L: R9016.1
VEE15_R: R9024.1
V_ROFF_L: R9013.1
V_ROFF_R: R9021.1

Notes on the sheet:
MANUAL TESTS: SW9000 SELECT = 1/2/3 presses in a fixed 3-second window; SW9001 STEP holds each condition until pressed. TEST_ACTIVE flashes 1/2/3 Hz while CELL / DC / 1-20kHz is active. Extra STEP after final R condition completes; SELECT hold 2s cancels. XLR stays muted. GPIOs use SoM V18; indicat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
Rail LEDs: rough presence only, nominal ~500uA using Vf~1.8V. No precision references or bias nodes loaded. Mount each indicator near its named supply/entry; GND_AP stays isolated. Series current resistor can be removed for diagnostic comparison. V18 indication is buffered from V12SOM because 1.8V 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
