ccroswhite/BFDAC/hw/kicad/cell.kicad_sch

## KiCad design hw/kicad/cell.kicad_sch (2026-11-04)

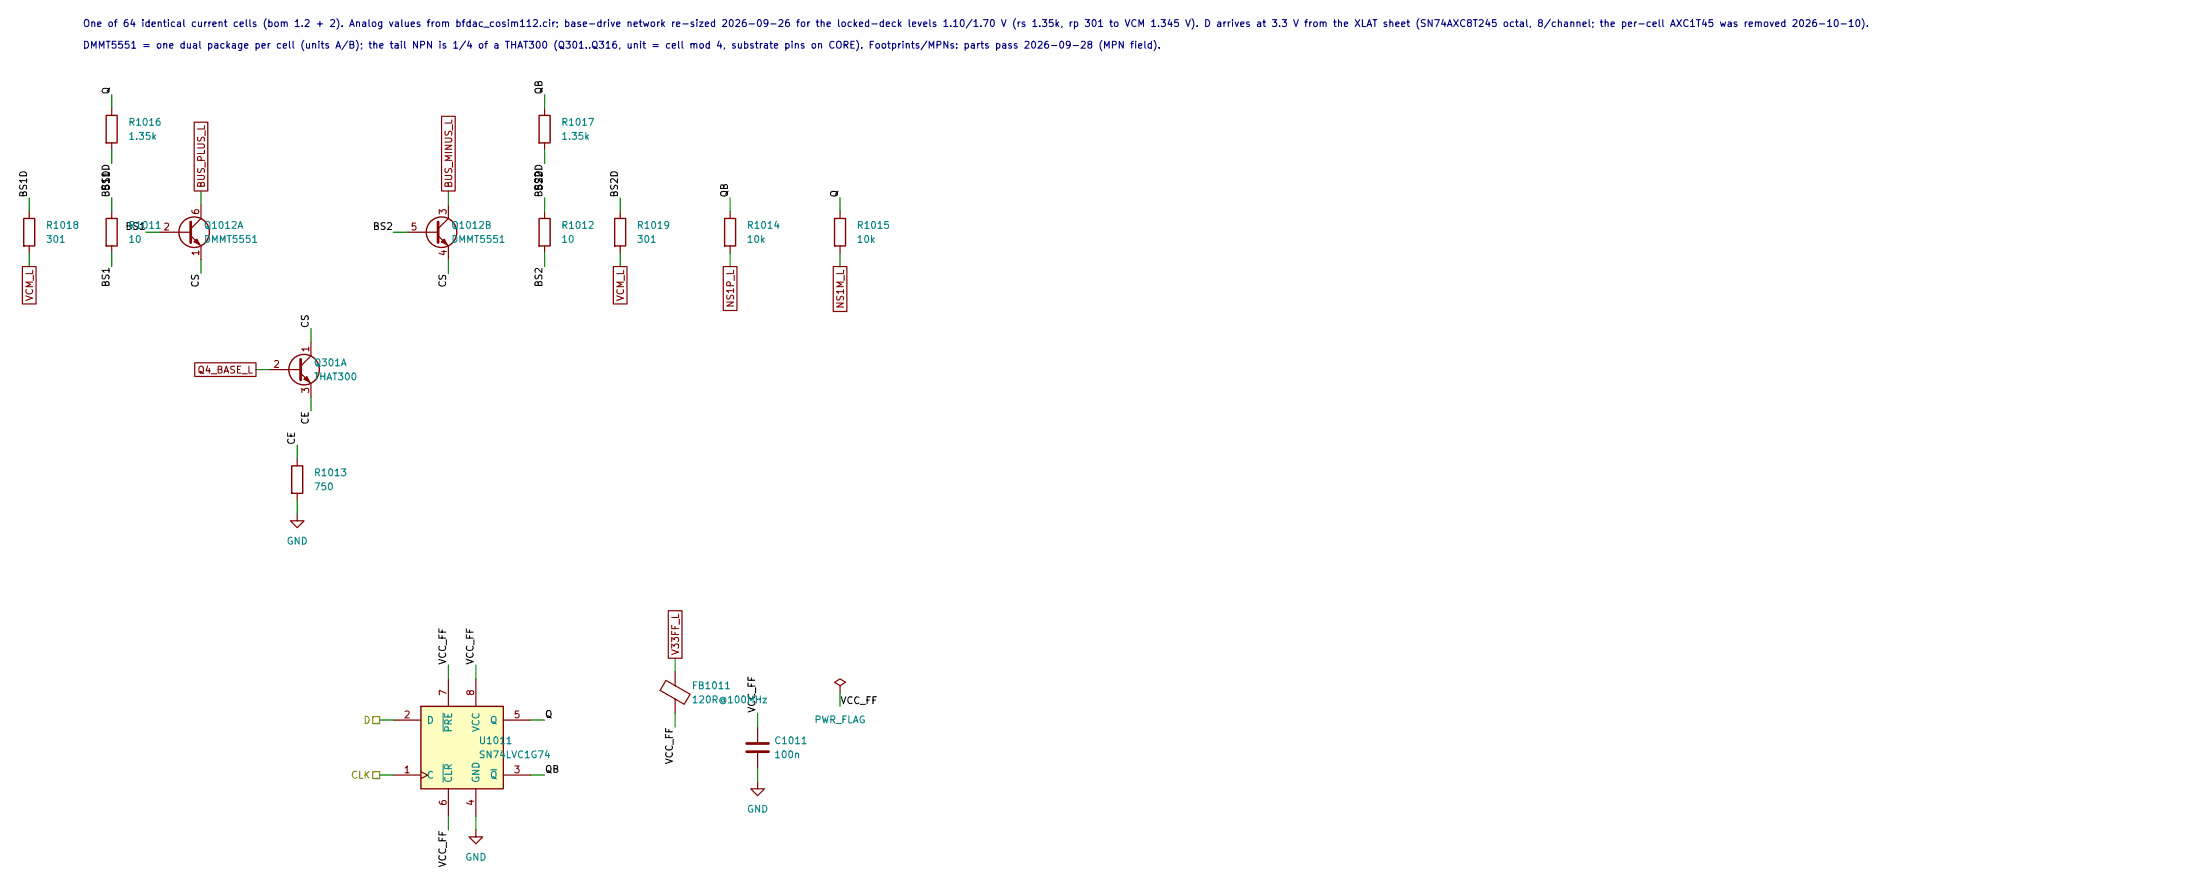
[picture p12: schematic cell.kicad_sch]

Parts:
C1011: 100n; C_0402_1005Metric; MPN GRM155R71C104KA88D
FB1011: 120R@100MHz; L_0603_1608Metric; MPN BLM18PG121SN1D
Q301: THAT300; SOIC-14_3.9x8.7mm_P1.27mm; MPN 300S14-U
Q1012: DMMT5551; SOT-363_SC-70-6; MPN DMMT5551-7
R1011, R1012: 10; R_0402_1005Metric; MPN TNPW040210R0FEEA
R1013: 750; R_0603_1608Metric; MPN RG1608N-7500-W-T1
R1014, R1015: 10k; R_0603_1608Metric; MPN RG1608N-1002-W-T1
R1016, R1017: 1.35k; R_0402_1005Metric; MPN TNPW04021K35FEEA
R1018, R1019: 301; R_0402_1005Metric; MPN TNPW0402301RFEEA
U1011: SN74LVC1G74; TI_DQE_X2SON-8_1.4x1.0mm_P0.35mm; MPN SN74LVC1G74DQER

Connections:
BS1: Q1012.2 (B1), R1011.2
BS1D: R1011.1, R1016.2, R1018.1
BS2: Q1012.5 (B2), R1012.2
BS2D: R1012.1, R1017.2, R1019.1
BUS_MINUS_L: Q1012.3 (C2)
BUS_PLUS_L: Q1012.6 (C1)
CE: Q301.3 (E1), R1013.1
CLK: U1011.1 (C)
CS: Q301.1 (C1), Q1012.1 (E1), Q1012.4 (E2)
D: U1011.2 (D)
GND: C1011.2, R1013.2, U1011.4 (GND)
NS1M_L: R1015.2
NS1P_L: R1014.2
Q: R1015.1, R1016.1, U1011.5 (Q)
Q4_BASE_L: Q301.2 (B1)
QB: R1014.1, R1017.1, U1011.3 (~Q)
V33FF_L: FB1011.1
VCC_FF: C1011.1, FB1011.2, U1011.6 (~CLR), U1011.7 (~PRE), U1011.8 (VCC)
VCM_L: R1018.2, R1019.2

Notes on the sheet:
One of 64 identical current cells (bom 1.2 + 2). Analog values from bfdac_cosim112.cir; base-drive network re-sized 2026-09-26 for the locked-deck levels 1.10/1.70 V (rs 1.35k, rp 301 to VCM 1.345 V). D arrives at 3.3 V from the XLAT sheet (SN74AXC8T245 octal, 8/channel; the per-cell AXC1T45 was re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
DMMT5551 = one dual package per cell (units A/B); the tail NPN is 1/4 of a THAT300 (Q301..Q316, unit = cell mod 4, substrate pins on CORE). Footprints/MPNs: parts pass 2026-09-28 (MPN field).
