ccroswhite/BFDAC/hw/kicad/cell_r.kicad_sch

## KiCad design hw/kicad/cell_r.kicad_sch (2026-11-04)

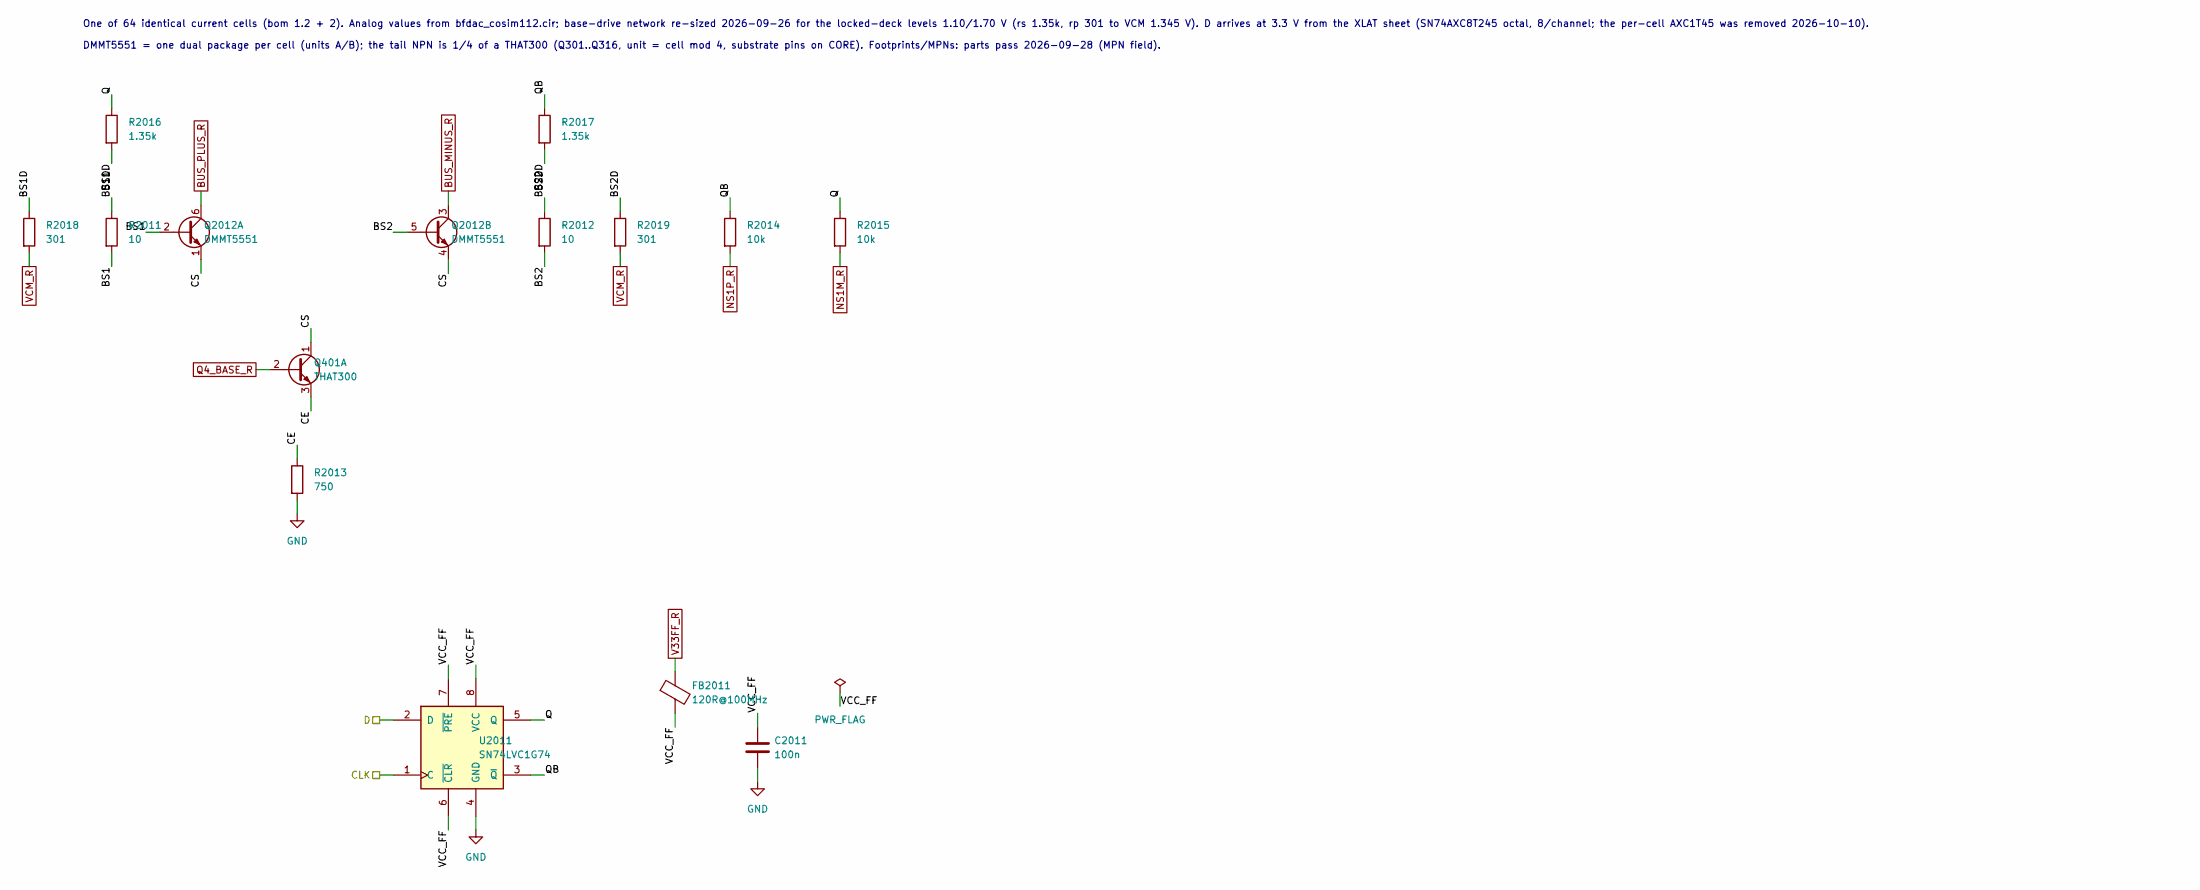
[picture p13: schematic cell_r.kicad_sch]

Parts:
C2011: 100n; C_0402_1005Metric; MPN GRM155R71C104KA88D
FB2011: 120R@100MHz; L_0603_1608Metric; MPN BLM18PG121SN1D
Q401: THAT300; SOIC-14_3.9x8.7mm_P1.27mm; MPN 300S14-U
Q2012: DMMT5551; SOT-363_SC-70-6; MPN DMMT5551-7
R2011, R2012: 10; R_0402_1005Metric; MPN TNPW040210R0FEEA
R2013: 750; R_0603_1608Metric; MPN RG1608N-7500-W-T1
R2014, R2015: 10k; R_0603_1608Metric; MPN RG1608N-1002-W-T1
R2016, R2017: 1.35k; R_0402_1005Metric; MPN TNPW04021K35FEEA
R2018, R2019: 301; R_0402_1005Metric; MPN TNPW0402301RFEEA
U2011: SN74LVC1G74; TI_DQE_X2SON-8_1.4x1.0mm_P0.35mm; MPN SN74LVC1G74DQER

Connections:
BS1: Q2012.2 (B1), R2011.2
BS1D: R2011.1, R2016.2, R2018.1
BS2: Q2012.5 (B2), R2012.2
BS2D: R2012.1, R2017.2, R2019.1
BUS_MINUS_R: Q2012.3 (C2)
BUS_PLUS_R: Q2012.6 (C1)
CE: Q401.3 (E1), R2013.1
CLK: U2011.1 (C)
CS: Q401.1 (C1), Q2012.1 (E1), Q2012.4 (E2)
D: U2011.2 (D)
GND: C2011.2, R2013.2, U2011.4 (GND)
NS1M_R: R2015.2
NS1P_R: R2014.2
Q: R2015.1, R2016.1, U2011.5 (Q)
Q4_BASE_R: Q401.2 (B1)
QB: R2014.1, R2017.1, U2011.3 (~Q)
V33FF_R: FB2011.1
VCC_FF: C2011.1, FB2011.2, U2011.6 (~CLR), U2011.7 (~PRE), U2011.8 (VCC)
VCM_R: R2018.2, R2019.2

Notes on the sheet:
One of 64 identical current cells (bom 1.2 + 2). Analog values from bfdac_cosim112.cir; base-drive network re-sized 2026-09-26 for the locked-deck levels 1.10/1.70 V (rs 1.35k, rp 301 to VCM 1.345 V). D arrives at 3.3 V from the XLAT sheet (SN74AXC8T245 octal, 8/channel; the per-cell AXC1T45 was re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
DMMT5551 = one dual package per cell (units A/B); the tail NPN is 1/4 of a THAT300 (Q301..Q316, unit = cell mod 4, substrate pins on CORE). Footprints/MPNs: parts pass 2026-09-28 (MPN field).
