ccroswhite/BFDAC/hw/kicad/clkr.kicad_sch

## KiCad design hw/kicad/clkr.kicad_sch (2026-11-04)

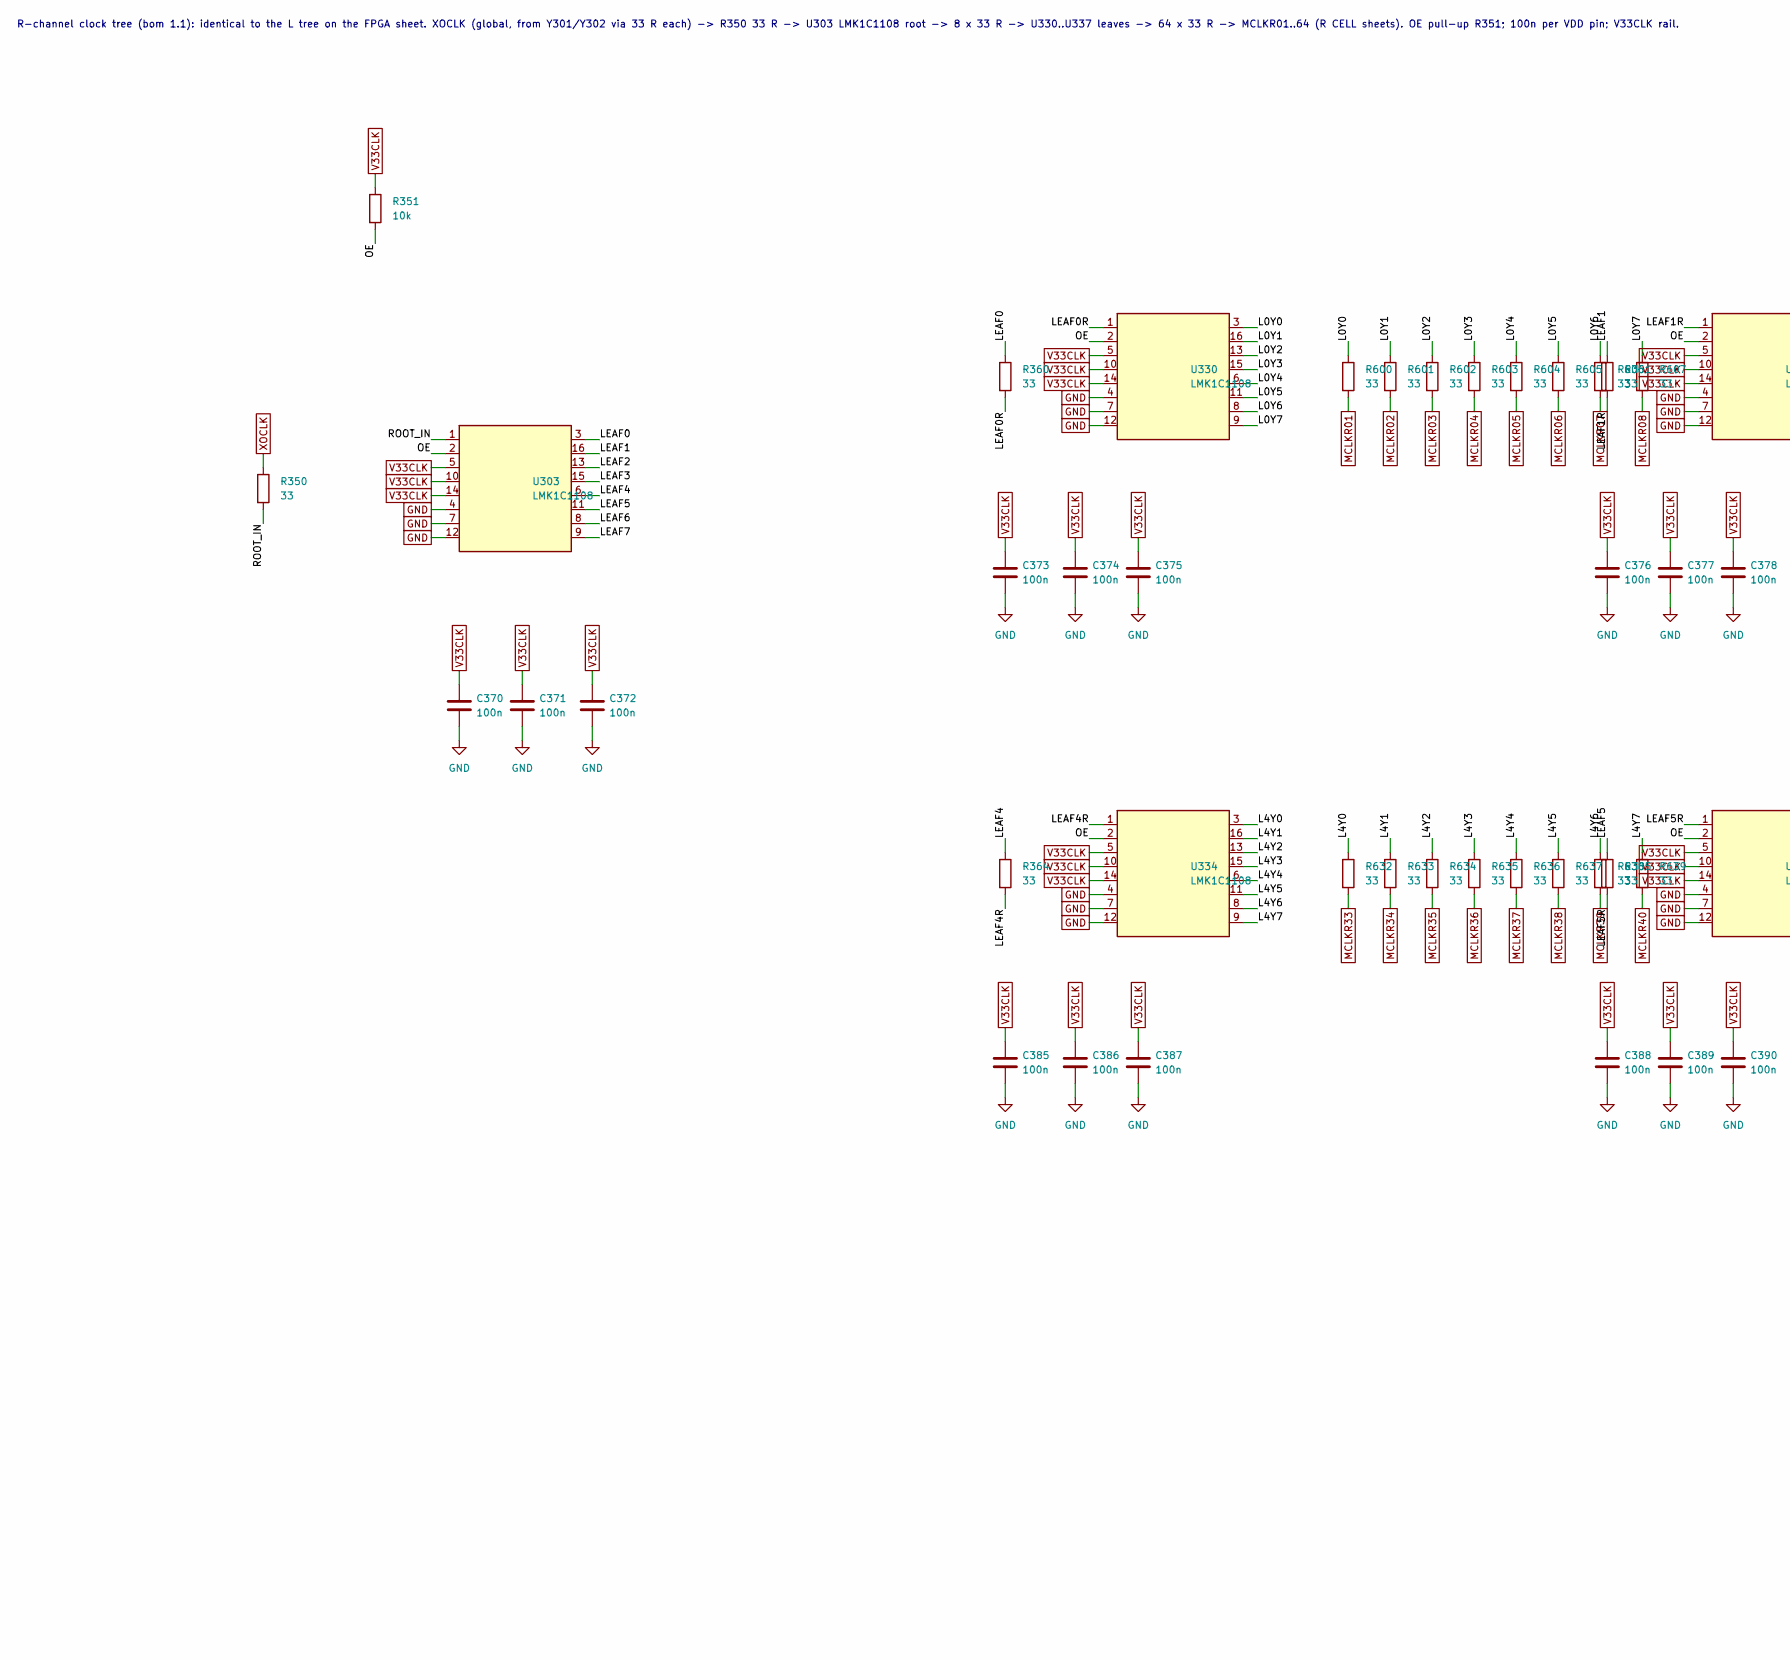
[picture p14: schematic clkr.kicad_sch, part in row 1, column 1]

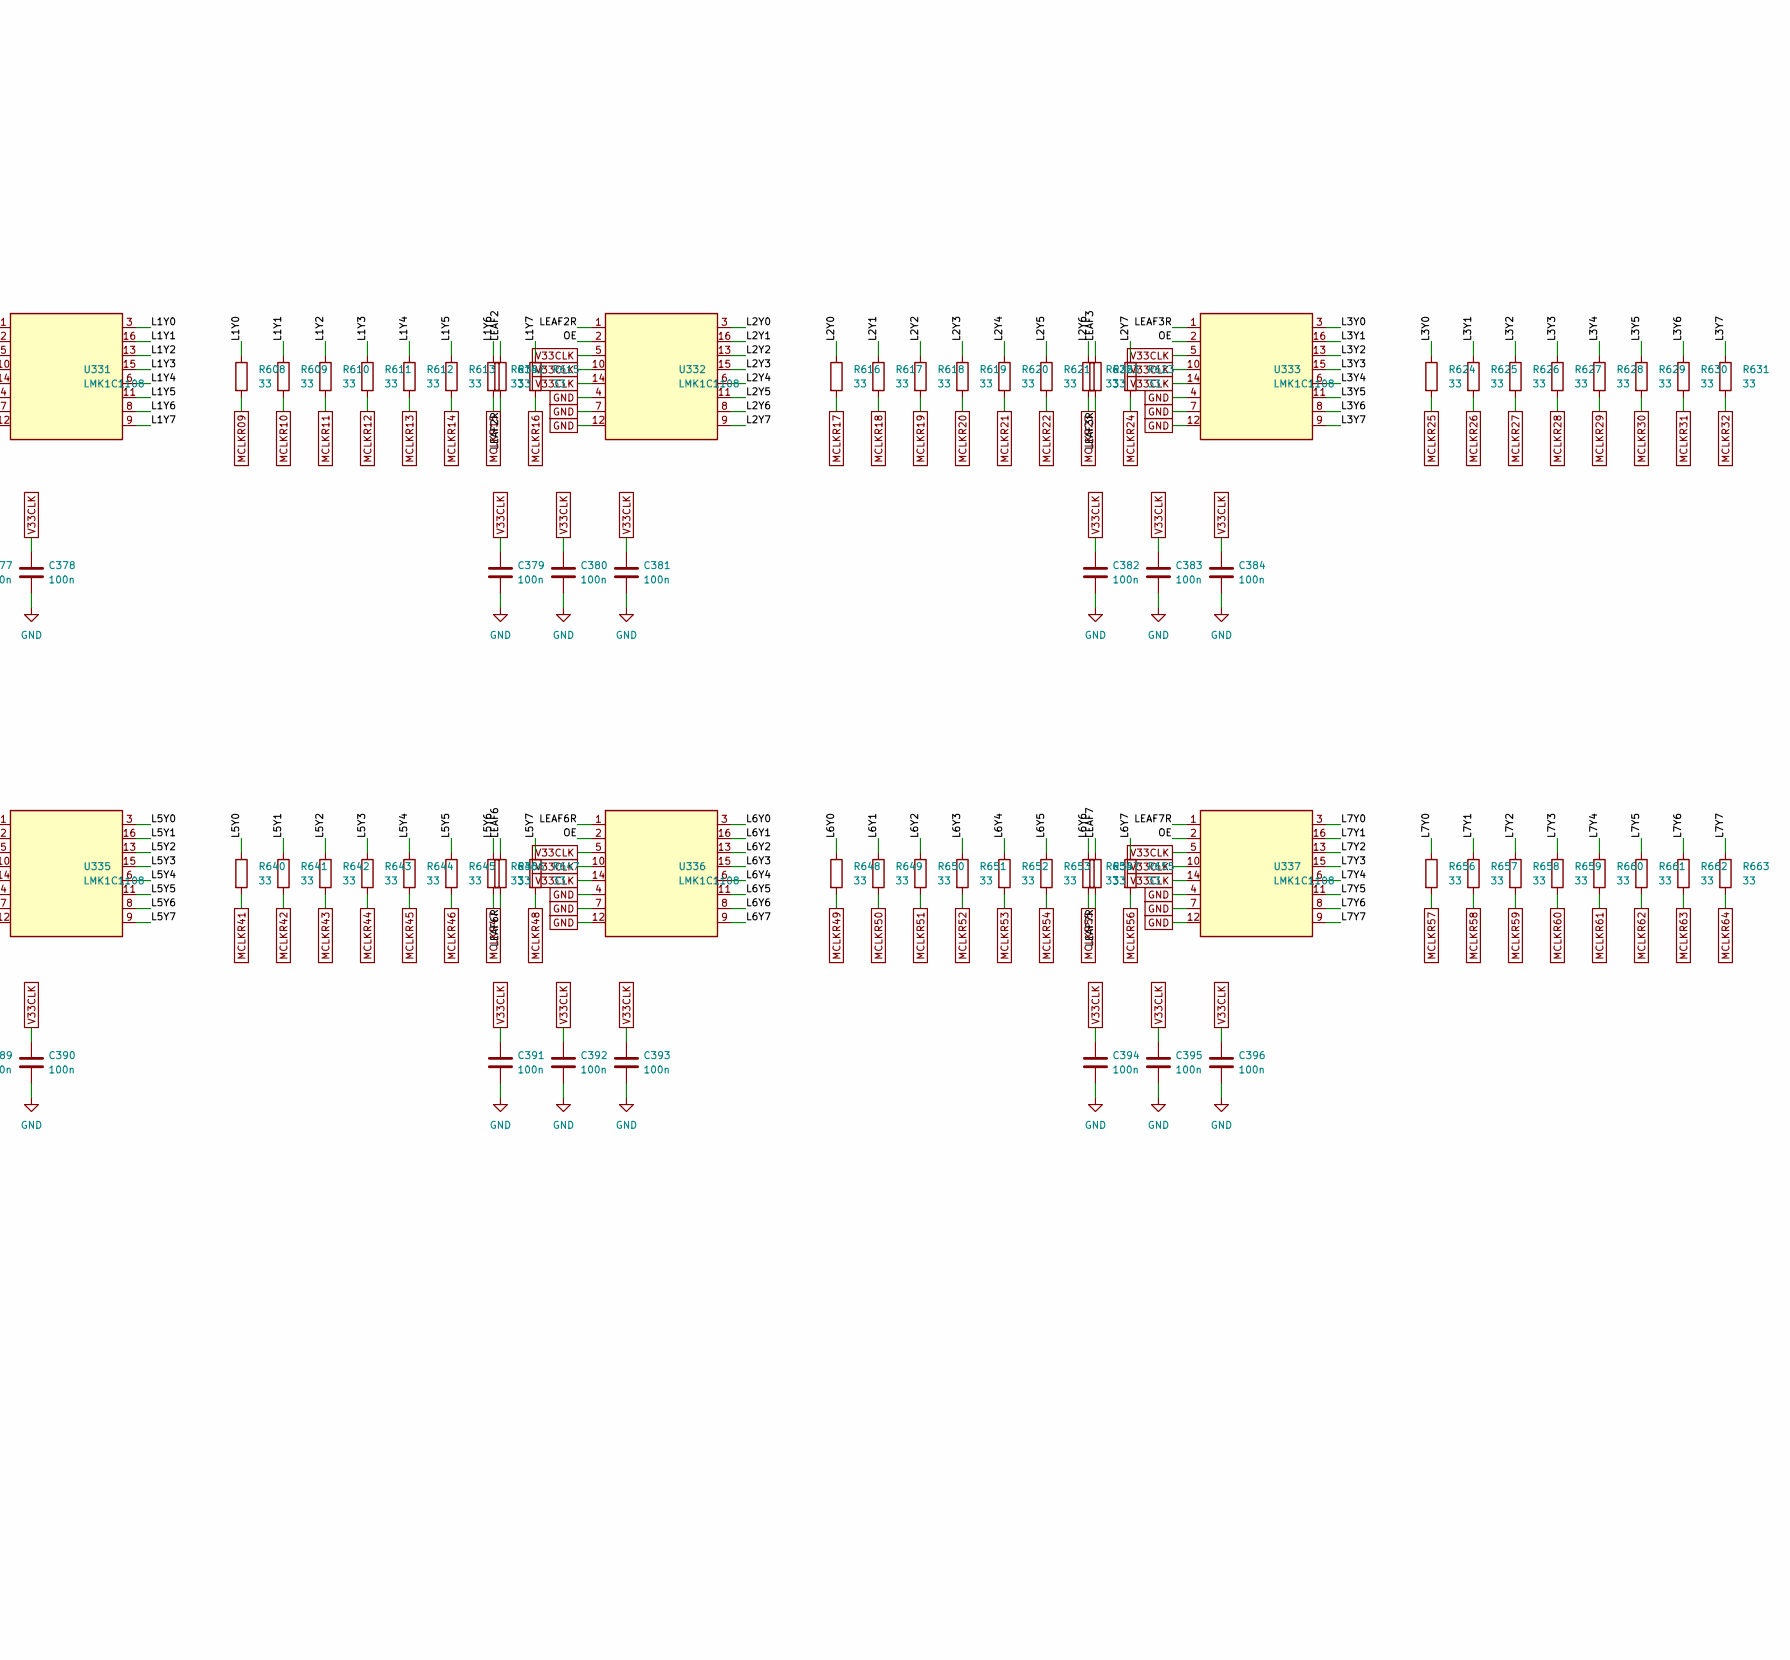
[picture p15: schematic clkr.kicad_sch, part in row 1, column 2]

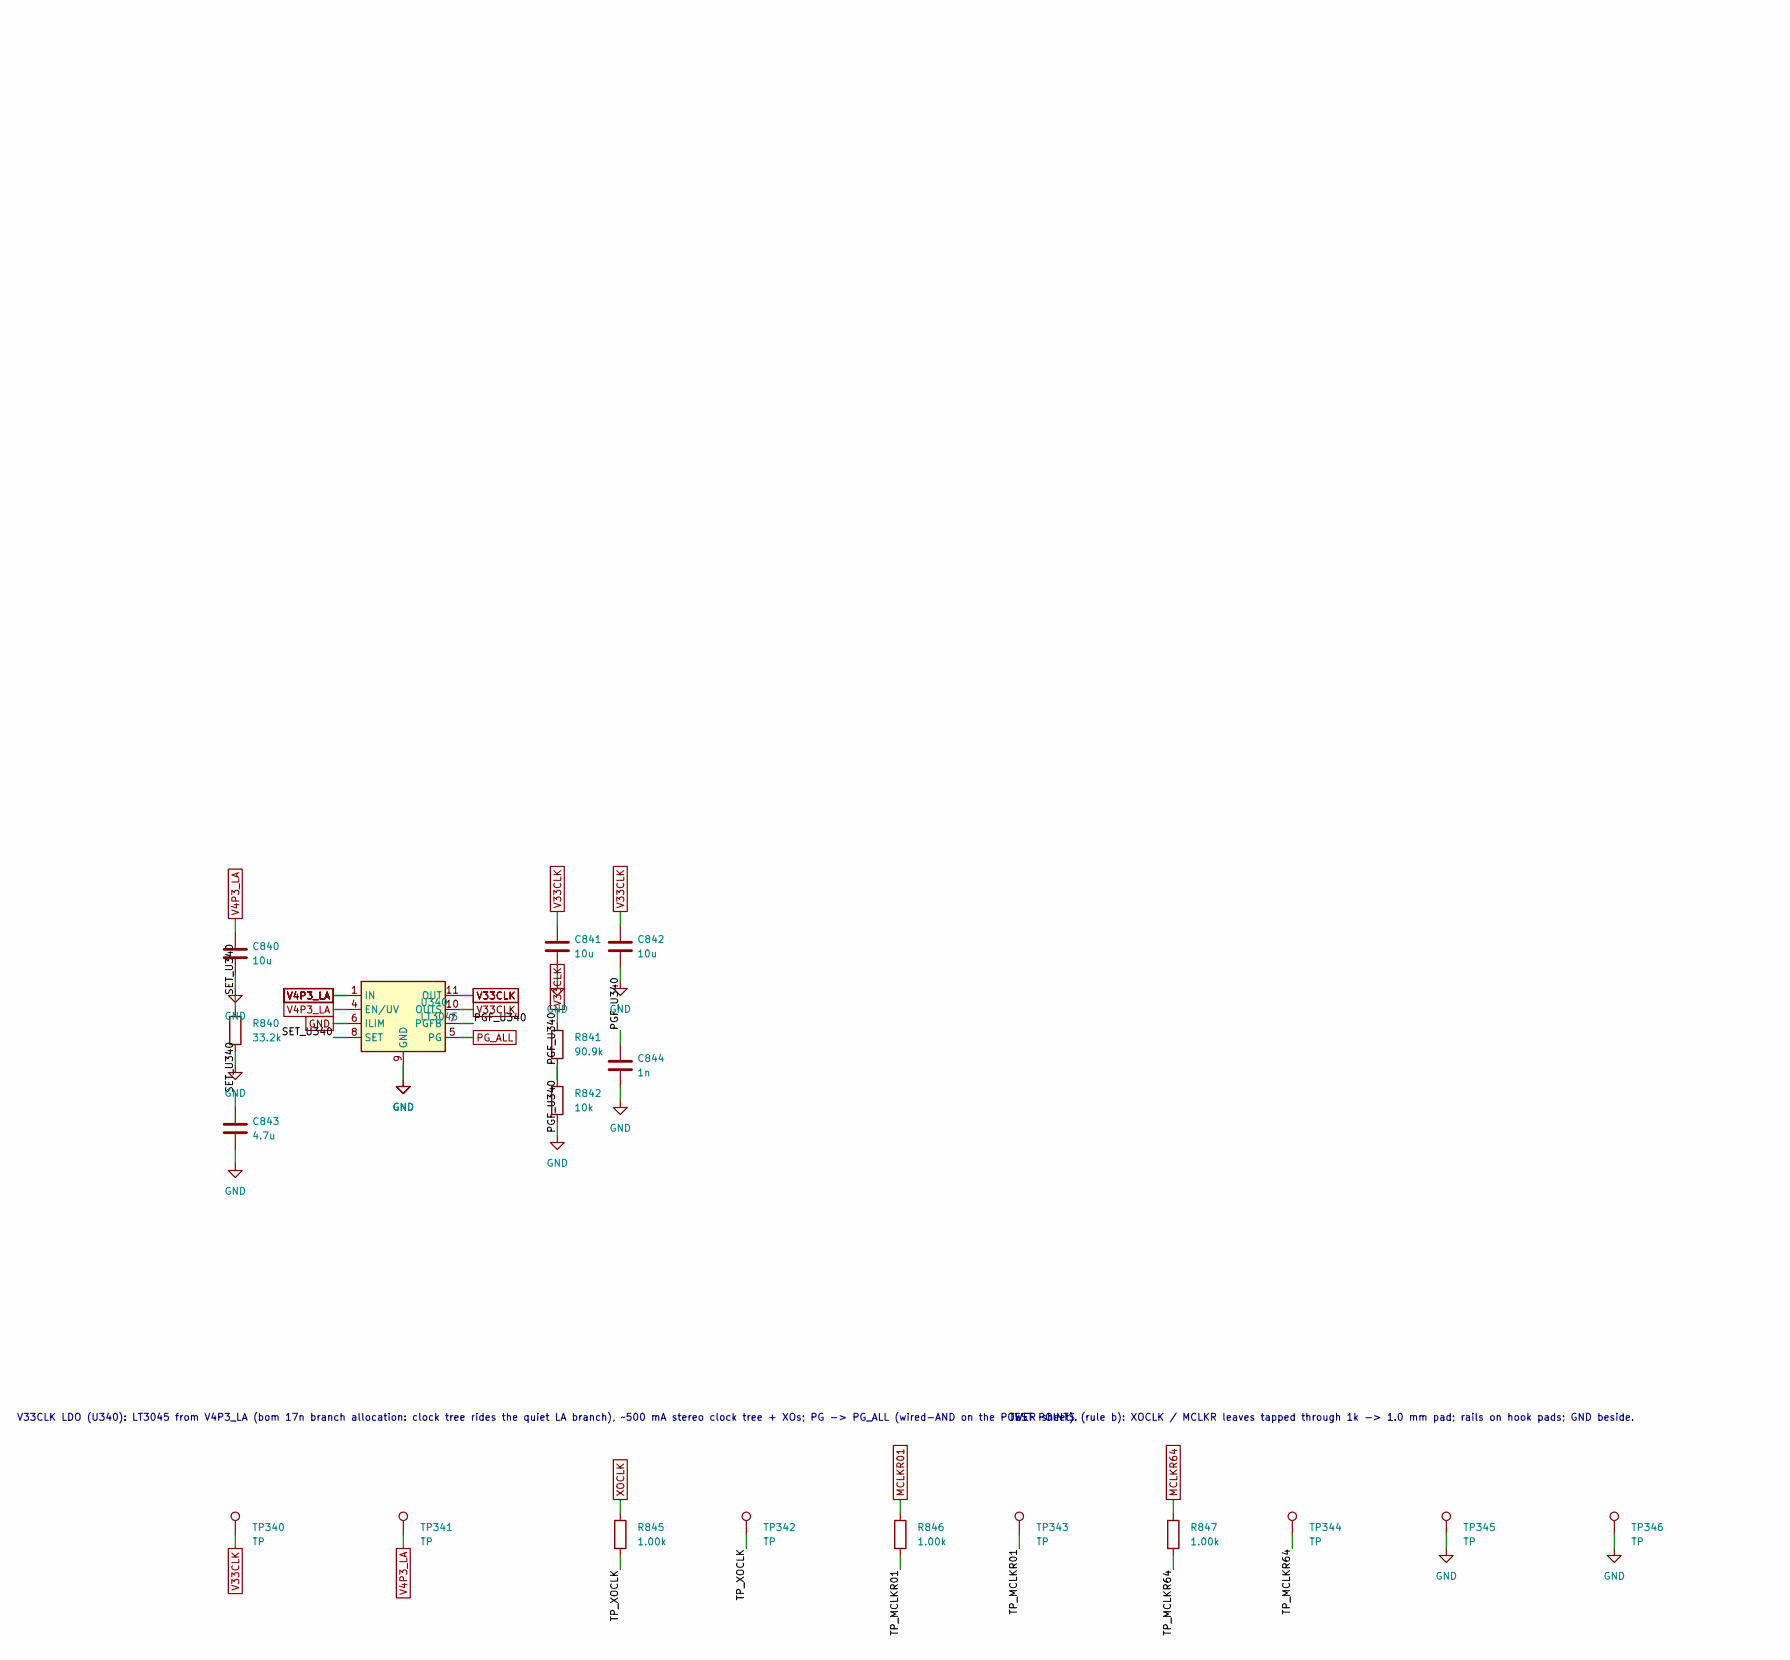
[picture p16: schematic clkr.kicad_sch, part in row 2, column 1]

Parts:
C370, C371, C372, C373, C374, C375, C376, C377, C378, C379, C380, C381, C382, C383, C384, C385, C386, C387, C388, C389, C390, C391, C392, C393, C394, C395, C396: 100n; C_0603_1608Metric; MPN GRM188R71C104KA01D
C840, C841, C842: 10u; C_1206_3216Metric; MPN GRM31CR71E106KA12L
C843: 4.7u; C_0805_2012Metric; MPN GRM21BR71E475KA73L
C844: 1n; C_0603_1608Metric; MPN GRM1885C1H102JA01D
R350, R360, R361, R362, R363, R364, R365, R366, R367, R600, R601, R602, R603, R604, R605, R606, R607, R608, R609, R610, R611, R612, R613, R614, R615, R616, R617, R618, R619, R620, R621, R622, R623, R624, R625, R626, R627, R628, R629, R630, R631, R632, R633, R634, R635, R636, R637, R638, R639, R640, R641, R642, R643, R644, R645, R646, R647, R648, R649, R650, R651, R652, R653, R654, R655, R656, R657, R658, R659, R660, R661, R662, R663: 33; R_0603_1608Metric; MPN CRCW060333R0FKEA
R351: 10k; R_0603_1608Metric; MPN CRCW060310K0FKEA
R840: 33.2k; R_0603_1608Metric; MPN RG1608N-3322-W-T1
R841: 90.9k; R_0603_1608Metric; MPN RG1608N-9092-W-T1
R842: 10k; R_0603_1608Metric; MPN RG1608N-1002-W-T1
R845, R846, R847: 1.00k; R_0603_1608Metric; MPN TNPW06031K00FEEA
TP340, TP341, TP345, TP346: TP; TestPoint_THTPad_2.0x2.0mm_Drill1.0mm
TP342, TP343, TP344: TP; TestPoint_Pad_1.0x1.0mm
U303, U330, U331, U332, U333, U334, U335, U336, U337: LMK1C1108; TSSOP-16_4.4x5mm_P0.65mm; MPN LMK1C1108PWR
U340: LT3045; MSOP-12-1EP_3x4.039mm_P0.65mm_EP1.651x2.845mm_ThermalVias; MPN LT3045EMSE#PBF

Connections:
GND: C370.2, C371.2, C372.2, C373.2, C374.2, C375.2, C376.2, C377.2, C378.2, C379.2, C380.2, C381.2, C382.2, C383.2, C384.2, C385.2, C386.2, C387.2, C388.2, C389.2, C390.2, C391.2, C392.2, C393.2, C394.2, C395.2, C396.2, C840.2, C841.2, C842.2, C843.2, C844.2, R840.2, R842.2, TP345.1, TP346.1, U303.4 (GND), U303.7 (GND), U303.12 (GND), U330.4 (GND), U330.7 (GND), U330.12 (GND), U331.4 (GND), U331.7 (GND), U331.12 (GND), U332.4 (GND), U332.7 (GND), U332.12 (GND), U333.4 (GND), U333.7 (GND), U333.12 (GND), U334.4 (GND), U334.7 (GND), U334.12 (GND), U335.4 (GND), U335.7 (GND), U335.12 (GND), U336.4 (GND), U336.7 (GND), U336.12 (GND), U337.4 (GND), U337.7 (GND), U337.12 (GND), U340.6 (ILIM), U340.9 (GND), U340.13 (GND)
L0Y0: R600.1, U330.3 (Y0)
L0Y1: R601.1, U330.16 (Y1)
L0Y2: R602.1, U330.13 (Y2)
L0Y3: R603.1, U330.15 (Y3)
L0Y4: R604.1, U330.6 (Y4)
L0Y5: R605.1, U330.11 (Y5)
L0Y6: R606.1, U330.8 (Y6)
L0Y7: R607.1, U330.9 (Y7)
L1Y0: R608.1, U331.3 (Y0)
L1Y1: R609.1, U331.16 (Y1)
L1Y2: R610.1, U331.13 (Y2)
L1Y3: R611.1, U331.15 (Y3)
L1Y4: R612.1, U331.6 (Y4)
L1Y5: R613.1, U331.11 (Y5)
L1Y6: R614.1, U331.8 (Y6)
L1Y7: R615.1, U331.9 (Y7)
L2Y0: R616.1, U332.3 (Y0)
L2Y1: R617.1, U332.16 (Y1)
L2Y2: R618.1, U332.13 (Y2)
L2Y3: R619.1, U332.15 (Y3)
L2Y4: R620.1, U332.6 (Y4)
L2Y5: R621.1, U332.11 (Y5)
L2Y6: R622.1, U332.8 (Y6)
L2Y7: R623.1, U332.9 (Y7)
L3Y0: R624.1, U333.3 (Y0)
L3Y1: R625.1, U333.16 (Y1)
L3Y2: R626.1, U333.13 (Y2)
L3Y3: R627.1, U333.15 (Y3)
L3Y4: R628.1, U333.6 (Y4)
L3Y5: R629.1, U333.11 (Y5)
L3Y6: R630.1, U333.8 (Y6)
L3Y7: R631.1, U333.9 (Y7)
L4Y0: R632.1, U334.3 (Y0)
L4Y1: R633.1, U334.16 (Y1)
L4Y2: R634.1, U334.13 (Y2)
L4Y3: R635.1, U334.15 (Y3)
L4Y4: R636.1, U334.6 (Y4)
L4Y5: R637.1, U334.11 (Y5)
L4Y6: R638.1, U334.8 (Y6)
L4Y7: R639.1, U334.9 (Y7)
L5Y0: R640.1, U335.3 (Y0)
L5Y1: R641.1, U335.16 (Y1)
L5Y2: R642.1, U335.13 (Y2)
L5Y3: R643.1, U335.15 (Y3)
L5Y4: R644.1, U335.6 (Y4)
L5Y5: R645.1, U335.11 (Y5)
L5Y6: R646.1, U335.8 (Y6)
L5Y7: R647.1, U335.9 (Y7)
L6Y0: R648.1, U336.3 (Y0)
L6Y1: R649.1, U336.16 (Y1)
L6Y2: R650.1, U336.13 (Y2)
L6Y3: R651.1, U336.15 (Y3)
L6Y4: R652.1, U336.6 (Y4)
L6Y5: R653.1, U336.11 (Y5)
L6Y6: R654.1, U336.8 (Y6)
L6Y7: R655.1, U336.9 (Y7)
L7Y0: R656.1, U337.3 (Y0)
L7Y1: R657.1, U337.16 (Y1)
L7Y2: R658.1, U337.13 (Y2)
L7Y3: R659.1, U337.15 (Y3)
L7Y4: R660.1, U337.6 (Y4)
L7Y5: R661.1, U337.11 (Y5)
L7Y6: R662.1, U337.8 (Y6)
L7Y7: R663.1, U337.9 (Y7)
LEAF0: R360.1, U303.3 (Y0)
LEAF0R: R360.2, U330.1 (CLKIN)
LEAF1: R361.1, U303.16 (Y1)
LEAF1R: R361.2, U331.1 (CLKIN)
LEAF2: R362.1, U303.13 (Y2)
LEAF2R: R362.2, U332.1 (CLKIN)
LEAF3: R363.1, U303.15 (Y3)
LEAF3R: R363.2, U333.1 (CLKIN)
LEAF4: R364.1, U303.6 (Y4)
LEAF4R: R364.2, U334.1 (CLKIN)
LEAF5: R365.1, U303.11 (Y5)
LEAF5R: R365.2, U335.1 (CLKIN)
LEAF6: R366.1, U303.8 (Y6)
LEAF6R: R366.2, U336.1 (CLKIN)
LEAF7: R367.1, U303.9 (Y7)
LEAF7R: R367.2, U337.1 (CLKIN)
MCLKR01: R600.2, R846.1
MCLKR02: R601.2
MCLKR03: R602.2
MCLKR04: R603.2
MCLKR05: R604.2
MCLKR06: R605.2
MCLKR07: R606.2
MCLKR08: R607.2
MCLKR09: R608.2
MCLKR10: R609.2
MCLKR11: R610.2
MCLKR12: R611.2
MCLKR13: R612.2
MCLKR14: R613.2
MCLKR15: R614.2
MCLKR16: R615.2
MCLKR17: R616.2
MCLKR18: R617.2
MCLKR19: R618.2
MCLKR20: R619.2
MCLKR21: R620.2
MCLKR22: R621.2
MCLKR23: R622.2
MCLKR24: R623.2
MCLKR25: R624.2
MCLKR26: R625.2
MCLKR27: R626.2
MCLKR28: R627.2
MCLKR29: R628.2
MCLKR30: R629.2
MCLKR31: R630.2
MCLKR32: R631.2
MCLKR33: R632.2
MCLKR34: R633.2
MCLKR35: R634.2
MCLKR36: R635.2
MCLKR37: R636.2
MCLKR38: R637.2
MCLKR39: R638.2
MCLKR40: R639.2
MCLKR41: R640.2
MCLKR42: R641.2
MCLKR43: R642.2
MCLKR44: R643.2
MCLKR45: R644.2
MCLKR46: R645.2
MCLKR47: R646.2
MCLKR48: R647.2
MCLKR49: R648.2
MCLKR50: R649.2
MCLKR51: R650.2
MCLKR52: R651.2
MCLKR53: R652.2
MCLKR54: R653.2
MCLKR55: R654.2
MCLKR56: R655.2
MCLKR57: R656.2
MCLKR58: R657.2
MCLKR59: R658.2
MCLKR60: R659.2
MCLKR61: R660.2
MCLKR62: R661.2
MCLKR63: R662.2
MCLKR64: R663.2, R847.1
OE: R351.2, U303.2 (1G), U330.2 (1G), U331.2 (1G), U332.2 (1G), U333.2 (1G), U334.2 (1G), U335.2 (1G), U336.2 (1G), U337.2 (1G)
PGF_U340: C844.1, R841.2, R842.1, U340.7 (PGFB)
PG_ALL: U340.5 (PG)
ROOT_IN: R350.2, U303.1 (CLKIN)
SET_U340: C843.1, R840.1, U340.8 (SET)
TP_MCLKR01: R846.2, TP343.1
TP_MCLKR64: R847.2, TP344.1
TP_XOCLK: R845.2, TP342.1
V4P3_LA: C840.1, TP341.1, U340.1 (IN), U340.2 (IN), U340.3 (IN), U340.4 (EN/UV)
V33CLK: C370.1, C371.1, C372.1, C373.1, C374.1, C375.1, C376.1, C377.1, C378.1, C379.1, C380.1, C381.1, C382.1, C383.1, C384.1, C385.1, C386.1, C387.1, C388.1, C389.1, C390.1, C391.1, C392.1, C393.1, C394.1, C395.1, C396.1, C841.1, C842.1, R351.1, R841.1, TP340.1, U303.5 (VDD), U303.10 (VDD), U303.14 (VDD), U330.5 (VDD), U330.10 (VDD), U330.14 (VDD), U331.5 (VDD), U331.10 (VDD), U331.14 (VDD), U332.5 (VDD), U332.10 (VDD), U332.14 (VDD), U333.5 (VDD), U333.10 (VDD), U333.14 (VDD), U334.5 (VDD), U334.10 (VDD), U334.14 (VDD), U335.5 (VDD), U335.10 (VDD), U335.14 (VDD), U336.5 (VDD), U336.10 (VDD), U336.14 (VDD), U337.5 (VDD), U337.10 (VDD), U337.14 (VDD), U340.10 (OUTS), U340.11 (OUT), U340.12 (OUT)
XOCLK: R350.1, R845.1

Notes on the sheet:
R-channel clock tree (bom 1.1): identical to the L tree on the FPGA sheet. XOCLK (global, from Y301/Y302 via 33 R each) -> R350 33 R -> U303 LMK1C1108 root -> 8 x 33 R -> U330..U337 leaves -> 64 x 33 R -> MCLKR01..64 (R CELL sheets). OE pull-up R351; 100n per VDD pin; V33CLK rail.
V33CLK LDO (U340): LT3045 from V4P3_LA (bom 17n branch allocation: clock tree rides the quiet LA branch), ~500 mA stereo clock tree + XOs; PG -> PG_ALL (wired-AND on the POWER sheet).
TEST POINTS (rule b): XOCLK / MCLKR leaves tapped through 1k -> 1.0 mm pad; rails on hook pads; GND beside.
