ccroswhite/BFDAC/hw/kicad/core.kicad_sch

## KiCad design hw/kicad/core.kicad_sch (2026-11-04)

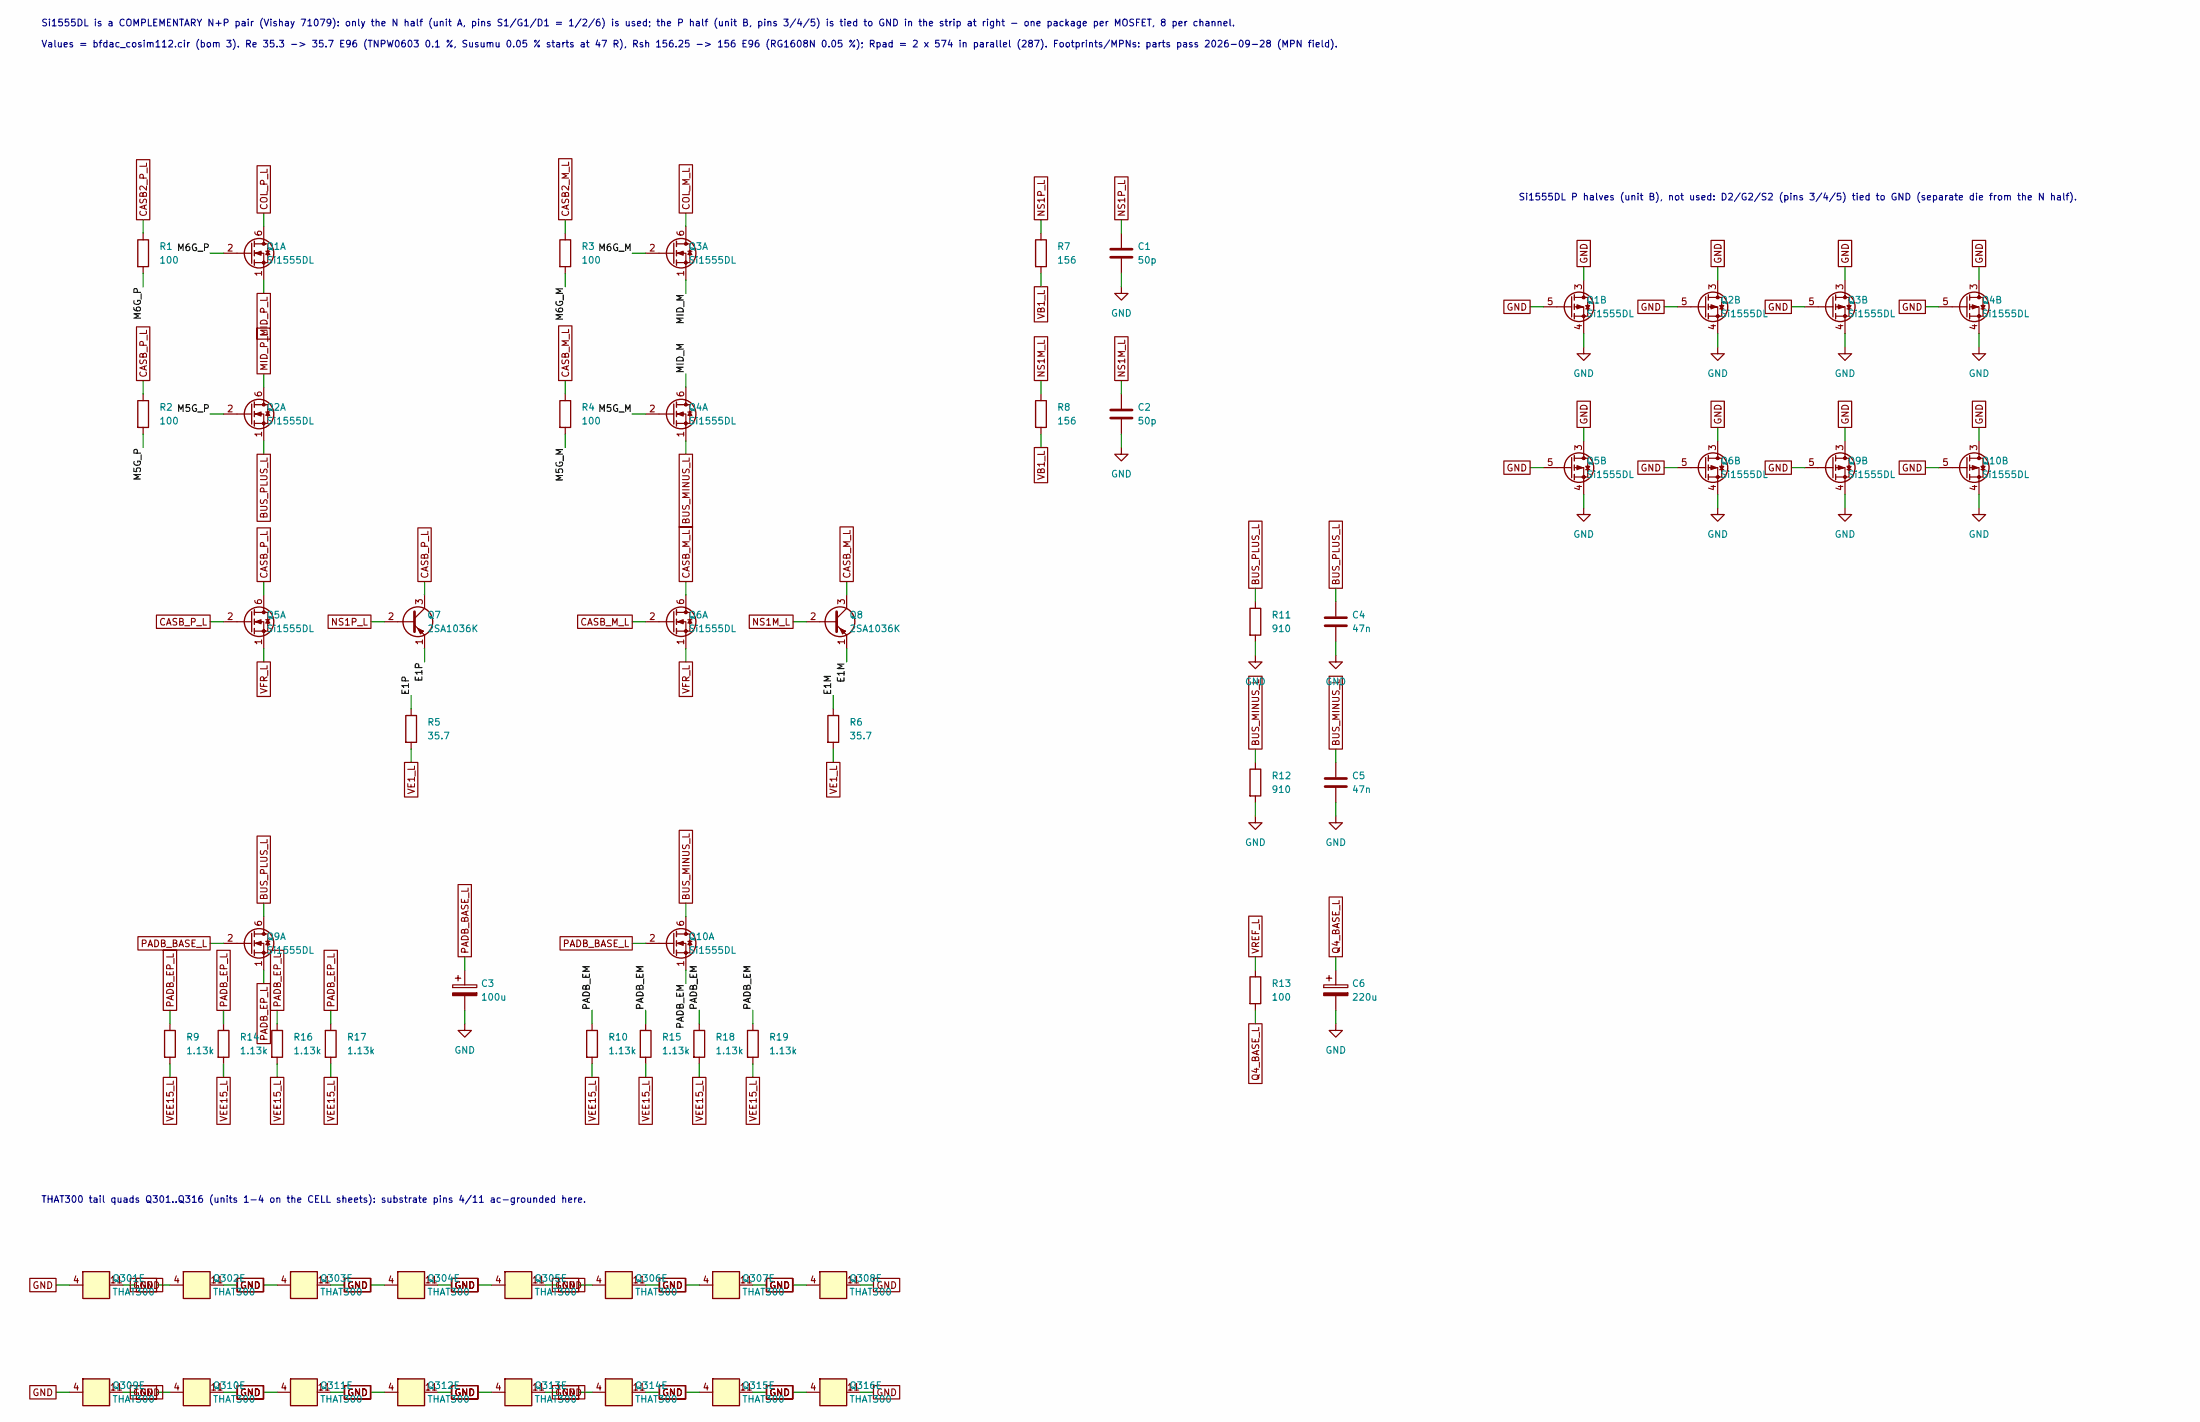
[picture p17: schematic core.kicad_sch]

Parts:
C1, C2: 50p; C_0603_1608Metric; MPN GRM1885C1H500JA01D
C3: 100u; CP_Radial_D6.3mm_P2.50mm; MPN UKL1C101MED
C4, C5: 47n; C_1206_3216Metric; MPN GRM3195C1H473JA01D
C6: 220u; CP_Radial_D8.0mm_P3.50mm; MPN UKL1C221MPD
Q1, Q2, Q3, Q4, Q5, Q6, Q9, Q10: Si1555DL; SOT-363_SC-70-6; MPN Si1555DL-T1-GE3
Q7, Q8: 2SA1036K; SC-59; MPN 2SA1036KT146Q
Q301, Q302, Q303, Q304, Q305, Q306, Q307, Q308, Q309, Q310, Q311, Q312, Q313, Q314, Q315, Q316: THAT300; SOIC-14_3.9x8.7mm_P1.27mm; MPN 300S14-U
R1, R2, R3, R4, R13: 100; R_0603_1608Metric; MPN TNPW0603100RFEEA
R5, R6: 35.7; R_0603_1608Metric; MPN TNPW060335R7BEEA
R7, R8: 156; R_0603_1608Metric; MPN RG1608N-1560-W-T1
R9, R10, R14, R15, R16, R17, R18, R19: 1.13k; R_1206_3216Metric; MPN RQ73C2B1K13BTD
R11, R12: 910; R_0603_1608Metric; MPN TNPW0603910RFEEA

Connections:
BUS_MINUS_L: C5.1, Q4.1 (S), Q10.6 (D), R12.1
BUS_PLUS_L: C4.1, Q2.1 (S), Q9.6 (D), R11.1
CASB2_M_L: R3.1
CASB2_P_L: R1.1
CASB_M_L: Q6.2 (G), Q6.6 (D), Q8.3 (C), R4.1
CASB_P_L: Q5.2 (G), Q5.6 (D), Q7.3 (C), R2.1
COL_M_L: Q3.6 (D)
COL_P_L: Q1.6 (D)
E1M: Q8.1 (E), R6.1
E1P: Q7.1 (E), R5.1
GND: C1.2, C2.2, C3.2, C4.2, C5.2, C6.2, Q1.3 (D), Q1.4 (S), Q1.5 (G), Q2.3 (D), Q2.4 (S), Q2.5 (G), Q3.3 (D), Q3.4 (S), Q3.5 (G), Q4.3 (D), Q4.4 (S), Q4.5 (G), Q5.3 (D), Q5.4 (S), Q5.5 (G), Q6.3 (D), Q6.4 (S), Q6.5 (G), Q9.3 (D), Q9.4 (S), Q9.5 (G), Q10.3 (D), Q10.4 (S), Q10.5 (G), Q301.4 (SUB), Q301.11 (SUB), Q302.4 (SUB), Q302.11 (SUB), Q303.4 (SUB), Q303.11 (SUB), Q304.4 (SUB), Q304.11 (SUB), Q305.4 (SUB), Q305.11 (SUB), Q306.4 (SUB), Q306.11 (SUB), Q307.4 (SUB), Q307.11 (SUB), Q308.4 (SUB), Q308.11 (SUB), Q309.4 (SUB), Q309.11 (SUB), Q310.4 (SUB), Q310.11 (SUB), Q311.4 (SUB), Q311.11 (SUB), Q312.4 (SUB), Q312.11 (SUB), Q313.4 (SUB), Q313.11 (SUB), Q314.4 (SUB), Q314.11 (SUB), Q315.4 (SUB), Q315.11 (SUB), Q316.4 (SUB), Q316.11 (SUB), R11.2, R12.2
M5G_M: Q4.2 (G), R4.2
M5G_P: Q2.2 (G), R2.2
M6G_M: Q3.2 (G), R3.2
M6G_P: Q1.2 (G), R1.2
MID_M: Q3.1 (S), Q4.6 (D)
MID_P_L: Q1.1 (S), Q2.6 (D)
NS1M_L: C2.1, Q8.2 (B), R8.1
NS1P_L: C1.1, Q7.2 (B), R7.1
PADB_BASE_L: C3.1, Q9.2 (G), Q10.2 (G)
PADB_EM: Q10.1 (S), R10.1, R15.1, R18.1, R19.1
PADB_EP_L: Q9.1 (S), R9.1, R14.1, R16.1, R17.1
Q4_BASE_L: C6.1, R13.2
VB1_L: R7.2, R8.2
VE1_L: R5.2, R6.2
VEE15_L: R9.2, R10.2, R14.2, R15.2, R16.2, R17.2, R18.2, R19.2
VFR_L: Q5.1 (S), Q6.1 (S)
VREF_L: R13.1

Notes on the sheet:
Si1555DL is a COMPLEMENTARY N+P pair (Vishay 71079): only the N half (unit A, pins S1/G1/D1 = 1/2/6) is used; the P half (unit B, pins 3/4/5) is tied to GND in the strip at right - one package per MOSFET, 8 per channel.
Values = bfdac_cosim112.cir (bom 3). Re 35.3 -> 35.7 E96 (TNPW0603 0.1 %, Susumu 0.05 % starts at 47 R), Rsh 156.25 -> 156 E96 (RG1608N 0.05 %); Rpad = 2 x 574 in parallel (287). Footprints/MPNs: parts pass 2026-09-28 (MPN field).
Si1555DL P halves (unit B), not used: D2/G2/S2 (pins 3/4/5) tied to GND (separate die from the N half).
THAT300 tail quads Q301..Q316 (units 1-4 on the CELL sheets): substrate pins 4/11 ac-grounded here.
