ccroswhite/BFDAC/hw/kicad/core_r.kicad_sch

## KiCad design hw/kicad/core_r.kicad_sch (2026-11-04)

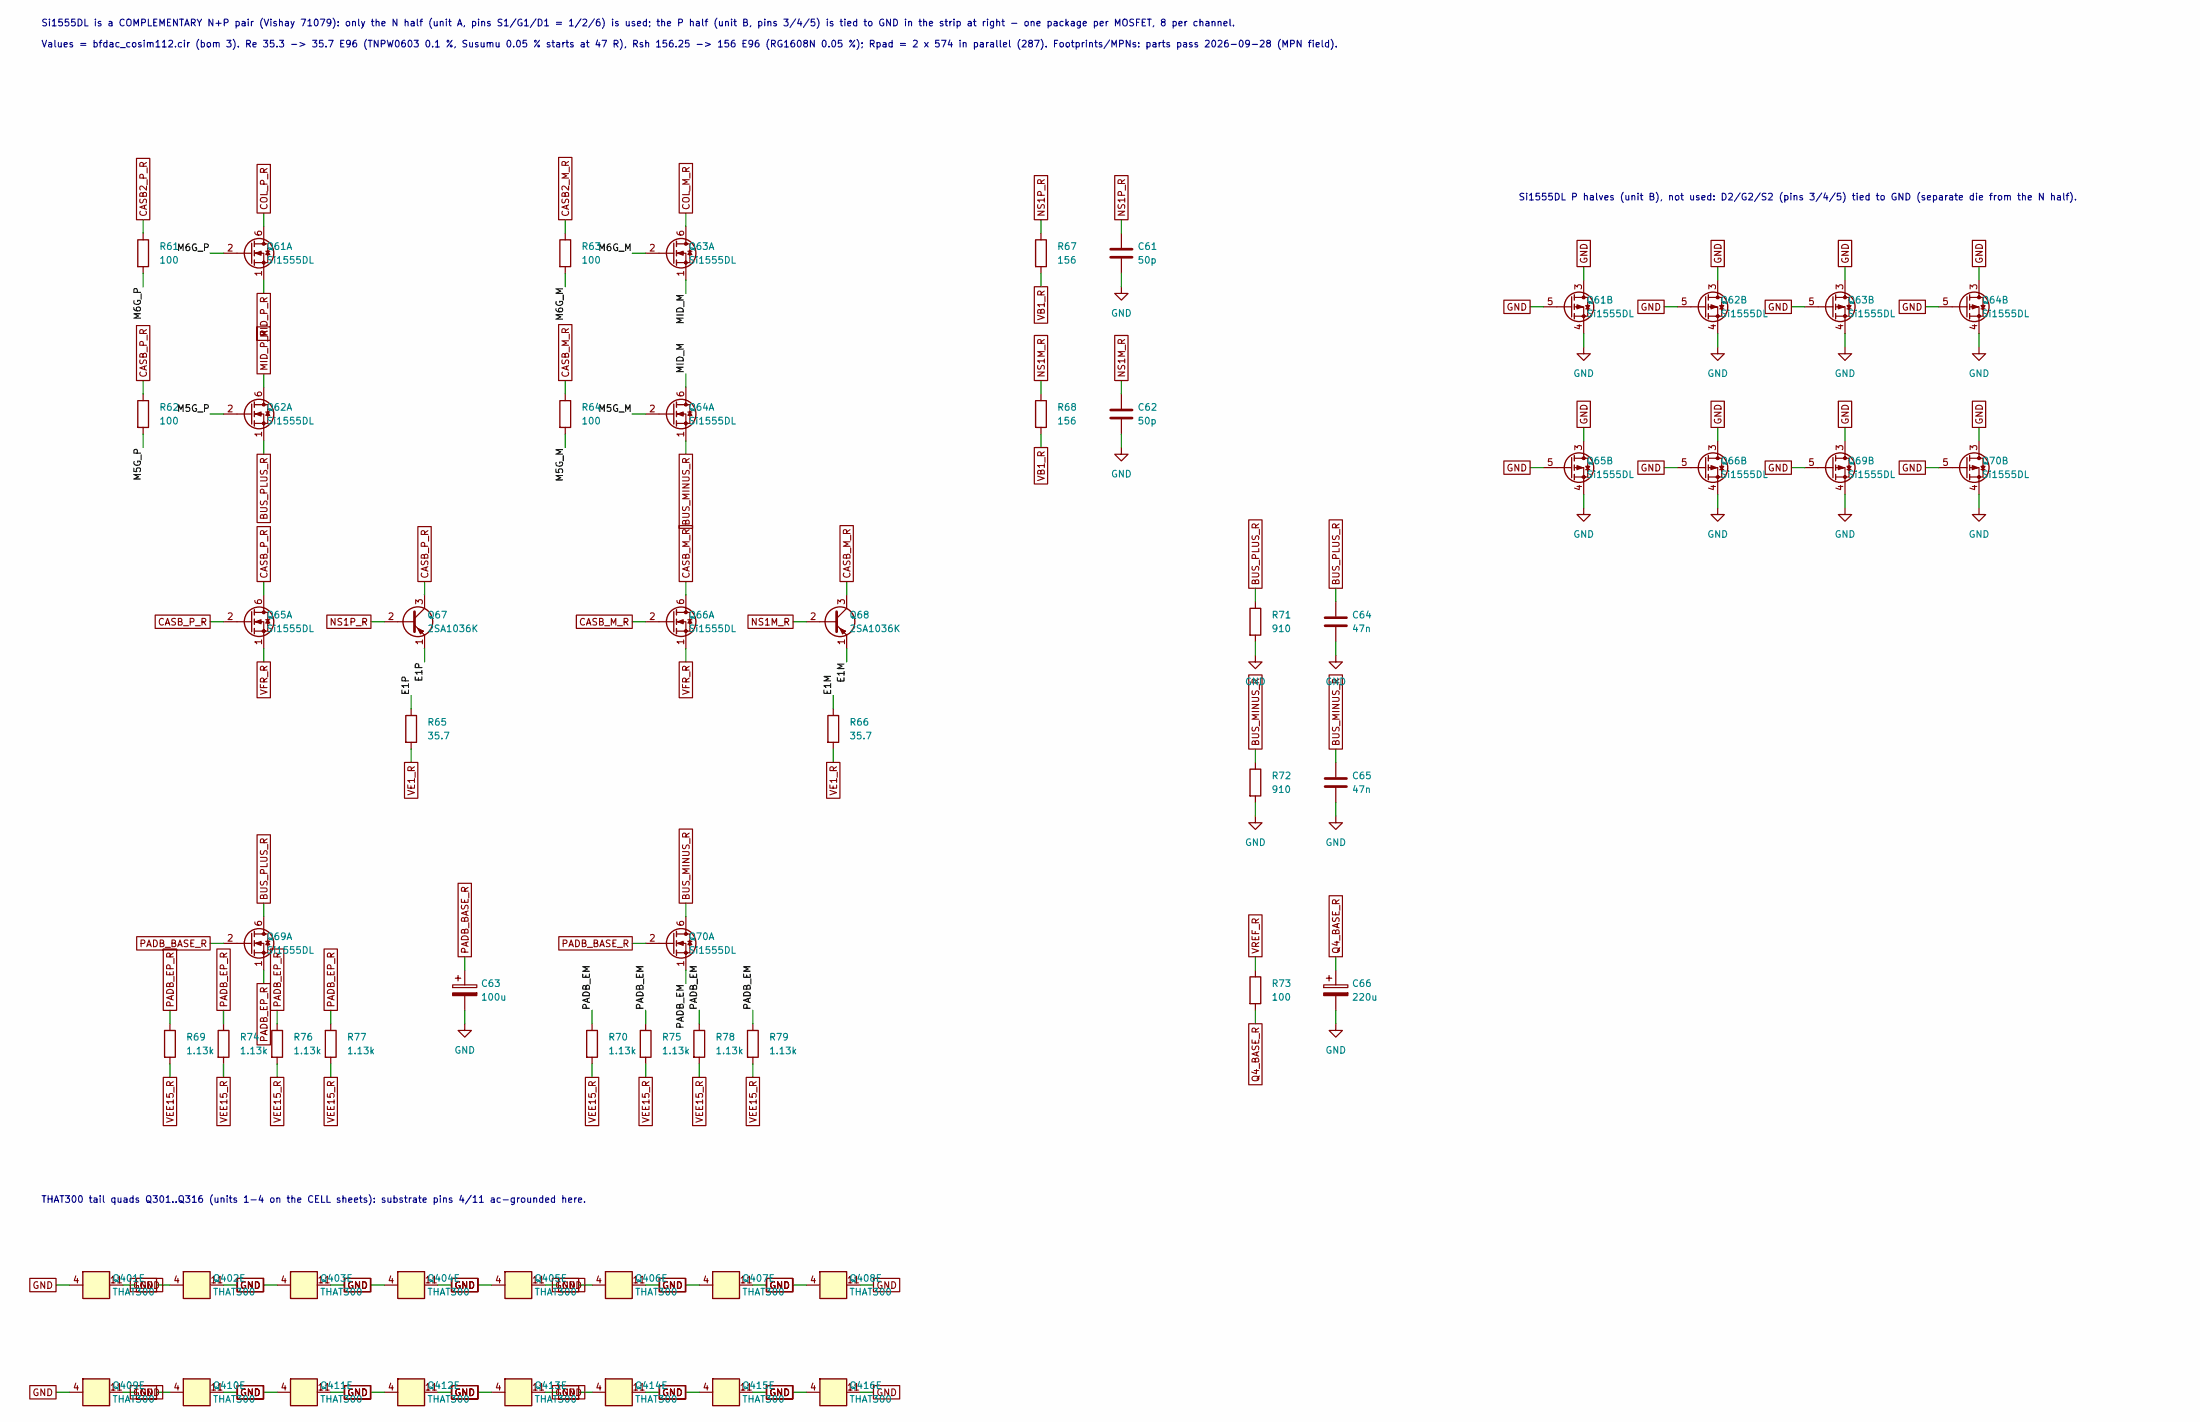
[picture p18: schematic core_r.kicad_sch]

Parts:
C61, C62: 50p; C_0603_1608Metric; MPN GRM1885C1H500JA01D
C63: 100u; CP_Radial_D6.3mm_P2.50mm; MPN UKL1C101MED
C64, C65: 47n; C_1206_3216Metric; MPN GRM3195C1H473JA01D
C66: 220u; CP_Radial_D8.0mm_P3.50mm; MPN UKL1C221MPD
Q61, Q62, Q63, Q64, Q65, Q66, Q69, Q70: Si1555DL; SOT-363_SC-70-6; MPN Si1555DL-T1-GE3
Q67, Q68: 2SA1036K; SC-59; MPN 2SA1036KT146Q
Q401, Q402, Q403, Q404, Q405, Q406, Q407, Q408, Q409, Q410, Q411, Q412, Q413, Q414, Q415, Q416: THAT300; SOIC-14_3.9x8.7mm_P1.27mm; MPN 300S14-U
R61, R62, R63, R64, R73: 100; R_0603_1608Metric; MPN TNPW0603100RFEEA
R65, R66: 35.7; R_0603_1608Metric; MPN TNPW060335R7BEEA
R67, R68: 156; R_0603_1608Metric; MPN RG1608N-1560-W-T1
R69, R70, R74, R75, R76, R77, R78, R79: 1.13k; R_1206_3216Metric; MPN RQ73C2B1K13BTD
R71, R72: 910; R_0603_1608Metric; MPN TNPW0603910RFEEA

Connections:
BUS_MINUS_R: C65.1, Q64.1 (S), Q70.6 (D), R72.1
BUS_PLUS_R: C64.1, Q62.1 (S), Q69.6 (D), R71.1
CASB2_M_R: R63.1
CASB2_P_R: R61.1
CASB_M_R: Q66.2 (G), Q66.6 (D), Q68.3 (C), R64.1
CASB_P_R: Q65.2 (G), Q65.6 (D), Q67.3 (C), R62.1
COL_M_R: Q63.6 (D)
COL_P_R: Q61.6 (D)
E1M: Q68.1 (E), R66.1
E1P: Q67.1 (E), R65.1
GND: C61.2, C62.2, C63.2, C64.2, C65.2, C66.2, Q61.3 (D), Q61.4 (S), Q61.5 (G), Q62.3 (D), Q62.4 (S), Q62.5 (G), Q63.3 (D), Q63.4 (S), Q63.5 (G), Q64.3 (D), Q64.4 (S), Q64.5 (G), Q65.3 (D), Q65.4 (S), Q65.5 (G), Q66.3 (D), Q66.4 (S), Q66.5 (G), Q69.3 (D), Q69.4 (S), Q69.5 (G), Q70.3 (D), Q70.4 (S), Q70.5 (G), Q401.4 (SUB), Q401.11 (SUB), Q402.4 (SUB), Q402.11 (SUB), Q403.4 (SUB), Q403.11 (SUB), Q404.4 (SUB), Q404.11 (SUB), Q405.4 (SUB), Q405.11 (SUB), Q406.4 (SUB), Q406.11 (SUB), Q407.4 (SUB), Q407.11 (SUB), Q408.4 (SUB), Q408.11 (SUB), Q409.4 (SUB), Q409.11 (SUB), Q410.4 (SUB), Q410.11 (SUB), Q411.4 (SUB), Q411.11 (SUB), Q412.4 (SUB), Q412.11 (SUB), Q413.4 (SUB), Q413.11 (SUB), Q414.4 (SUB), Q414.11 (SUB), Q415.4 (SUB), Q415.11 (SUB), Q416.4 (SUB), Q416.11 (SUB), R71.2, R72.2
M5G_M: Q64.2 (G), R64.2
M5G_P: Q62.2 (G), R62.2
M6G_M: Q63.2 (G), R63.2
M6G_P: Q61.2 (G), R61.2
MID_M: Q63.1 (S), Q64.6 (D)
MID_P_R: Q61.1 (S), Q62.6 (D)
NS1M_R: C62.1, Q68.2 (B), R68.1
NS1P_R: C61.1, Q67.2 (B), R67.1
PADB_BASE_R: C63.1, Q69.2 (G), Q70.2 (G)
PADB_EM: Q70.1 (S), R70.1, R75.1, R78.1, R79.1
PADB_EP_R: Q69.1 (S), R69.1, R74.1, R76.1, R77.1
Q4_BASE_R: C66.1, R73.2
VB1_R: R67.2, R68.2
VE1_R: R65.2, R66.2
VEE15_R: R69.2, R70.2, R74.2, R75.2, R76.2, R77.2, R78.2, R79.2
VFR_R: Q65.1 (S), Q66.1 (S)
VREF_R: R73.1

Notes on the sheet:
Si1555DL is a COMPLEMENTARY N+P pair (Vishay 71079): only the N half (unit A, pins S1/G1/D1 = 1/2/6) is used; the P half (unit B, pins 3/4/5) is tied to GND in the strip at right - one package per MOSFET, 8 per channel.
Values = bfdac_cosim112.cir (bom 3). Re 35.3 -> 35.7 E96 (TNPW0603 0.1 %, Susumu 0.05 % starts at 47 R), Rsh 156.25 -> 156 E96 (RG1608N 0.05 %); Rpad = 2 x 574 in parallel (287). Footprints/MPNs: parts pass 2026-09-28 (MPN field).
Si1555DL P halves (unit B), not used: D2/G2/S2 (pins 3/4/5) tied to GND (separate die from the N half).
THAT300 tail quads Q301..Q316 (units 1-4 on the CELL sheets): substrate pins 4/11 ac-grounded here.
