ccroswhite/BFDAC/hw/kicad/ctrl.kicad_sch

## KiCad design hw/kicad/ctrl.kicad_sch (2026-11-04)

Schematic: ctrl.kicad_sch

Parts:
C501, C502, C503, C504, C505, C506, C507, C508, C509, C510, C511, C512, C560, C561, C562, C563, C564, C660, C661, C662, C663, C664: 100n; C_0603_1608Metric; MPN GRM188R71C104KA01D
C518, C519: 1u; C_0603_1608Metric; MPN GRM188R61E105KA12D
C520, C521, C522, C523, C524, C525, C526, C527, C528, C529, C530, C531, C532, C565, C620, C621, C622, C623, C624, C625, C626, C627, C628, C629, C630, C631, C632, C665: 1n; C_0603_1608Metric; MPN GRM1885C1H102JA01D
D501, D502, D503, D504, D505: GREEN; LED_0603_1608Metric; MPN APT1608SGC
D516, D517, D520, D616, D617, D620: BAT54; SOT-23; MPN BAT54,215
J505: PMBUS; PinHeader_1x04_P2.54mm_Vertical; MPN TSW-104-07-G-S; not fitted
J506: AP DIG + PWR; Samtec_SEAF-40-05.0-L-06-2-A_40x6_P1.27mm; MPN SEAF-40-05.0-L-06-2-A-K-TR
Q501, Q502, Q503, Q504, Q505: MMBT3904; SOT-23; MPN MMBT3904LT1G
R501, R506, R552, R553, R554, R555, R556, R557, R586, R587, R588, R589, R590, R591: 10k; R_0603_1608Metric; MPN CRCW060310K0FKEA
R502, R503, R504, R505: 2.2k; R_0603_1608Metric; MPN CRCW06032K20FKEA
R510, R511, R512, R513, R514: 4.7k; R_0603_1608Metric; MPN CRCW06034K70FKEA
R520, R521, R522, R523, R524: 470; R_0603_1608Metric; MPN CRCW0603470RFKEA
R526, R528, R538, R540, R544, R546, R560, R562, R572, R574, R576, R578, R580: 100k; R_0603_1608Metric; MPN RG1608N-1003-W-T1
R527, R529, R531, R539, R541, R545, R547, R549, R561, R563, R565, R573, R575, R577, R579, R581: 10k; R_0603_1608Metric; MPN RG1608N-1002-W-T1
R530, R548, R564: 49.9k; R_0603_1608Metric; MPN RG1608N-4992-W-T1
R532, R533, R534, R535, R536, R537, R542, R543, R550, R551, R566, R567, R568, R569, R570, R571, R582, R583, R584, R585: 20k; R_0603_1608Metric; MPN RG1608N-2002-W-T1
R558, R559, R592: 10k; R_0603_1608Metric; MPN TNPW06031002FEEA
R593: 20k; R_0603_1608Metric; MPN TNPW06032002FEEA
TP510, TP511, TP512, TP513, TP514, TP515, TP516, TP517, TP518, TP519, TP520, TP521, TP522, TP523, TP524, TP525, TP526: TP; TestPoint_THTPad_2.0x2.0mm_Drill1.0mm
U501: MAX22445C; ADI_21-0042B_16_WSOIC; MPN MAX22445CAWE+
U502: MAX22445F; ADI_21-0042B_16_WSOIC; MPN MAX22445FAWE+
U503: MAX22444C; ADI_21-0042B_16_WSOIC; MPN MAX22444CAWE+
U504: ISO1640; SOIC-8_3.9x4.9mm_P1.27mm; MPN ISO1640BDR
U505, U506, U507, U508: TMP117; WSON-6-1EP_2x2mm_P0.65mm_EP1x1.6mm; MPN TMP117AIDRVR
U510, U511: UCD90120A; QFN-64-1EP_9x9mm_P0.5mm_EP3.8x3.8mm; MPN UCD90120ARGCR
U512: TPS7A2033; SOT-23-5; MPN TPS7A2033PDBVR

Connections:
ADR0_L: R558.1, U510.61 (PMBUS_ADDR0)
ADR0_R: R592.1, U511.61 (PMBUS_ADDR0)
ADR1_L: R559.1, U510.60 (PMBUS_ADDR1)
ADR1_R: R593.1, U511.60 (PMBUS_ADDR1)
ALRT_L: R557.2, U510.27 (PMBALERT)
ALRT_R: R591.2, U511.27 (PMBALERT)
AP_I2S_BCLK: J506.9 (A9), U502.14 (OUT1)
AP_I2S_DATA: J506.13 (A13), U502.11 (IN4)
AP_I2S_DATA2: J506.27 (A27), U503.4 (IN2)
AP_I2S_LRCLK: J506.11 (A11), U502.13 (OUT2)
AP_IRQ_N: J506.15 (A15), U502.12 (OUT3)
AP_RST_N: J506.17 (A17), R501.2, U503.3 (IN1)
AP_SCL: J506.21 (A21), R503.2, U504.6 (SCL2)
AP_SDA: J506.19 (A19), R502.2, U504.7 (SDA2)
AP_SPI_CS_N: J506.3 (A3), U501.4 (IN2)
AP_SPI_MISO: J506.7 (A7), U501.6 (OUT4)
AP_SPI_MOSI: J506.5 (A5), U501.5 (IN3)
AP_SPI_SCLK: J506.1 (A1), U501.3 (IN1)
BPC_L: C564.1, U510.47 (BPCAP)
BPC_R: C664.1, U511.47 (BPCAP)
EXT_RST_N: TP518.1, U503.14 (OUT1)
FPGA_IRQ_N: TP519.1, U502.5 (IN3)
GND: C502.2, C504.2, C506.2, C508.2, C509.2, C510.2, C511.2, C512.2, C518.2, C519.2, C520.2, C521.2, C522.2, C523.2, C524.2, C525.2, C526.2, C527.2, C528.2, C529.2, C530.2, C531.2, C532.2, C560.2, C561.2, C562.2, C563.2, C564.2, C565.2, C620.2, C621.2, C622.2, C623.2, C624.2, C625.2, C626.2, C627.2, C628.2, C629.2, C630.2, C631.2, C632.2, C660.2, C661.2, C662.2, C663.2, C664.2, C665.2, D516.2 (A), D517.2 (A), D520.2 (A), D616.2 (A), D617.2 (A), D620.2 (A), J505.4, J506.41 (B1), J506.42 (B2), J506.43 (B3), J506.44 (B4), J506.45 (B5), J506.46 (B6), J506.47 (B7), J506.48 (B8), J506.49 (B9), J506.50 (B10), J506.51 (B11), J506.52 (B12), J506.69 (B29), J506.70 (B30), J506.71 (B31), J506.72 (B32), J506.81 (C1), J506.92 (C12), J506.109 (C29), J506.112 (C32), J506.121 (D1), J506.132 (D12), J506.149 (D29), J506.152 (D32), J506.161 (E1), J506.172 (E12), J506.189 (E29), J506.190 (E30), J506.191 (E31), J506.192 (E32), J506.201 (F1), J506.202 (F2), J506.203 (F3), J506.204 (F4), J506.205 (F5), J506.206 (F6), J506.207 (F7), J506.208 (F8), J506.209 (F9), J506.210 (F10), J506.211 (F11), J506.212 (F12), Q501.2 (E), Q502.2 (E), Q503.2 (E), Q504.2 (E), Q505.2 (E), R506.2, R527.2, R529.2, R531.2, R533.2, R535.2, R537.2, R543.2, R545.2, R549.2, R551.2, R553.2, R554.2, R558.2, R559.2, R561.2, R563.2, R565.2, R567.2, R569.2, R571.2, R577.2, R579.2, R583.2, R585.2, R587.2, R588.2, R592.2, R593.2, TP523.1, TP524.1, U501.9 (GNDB), U501.15 (GNDBB), U502.2 (GNDA), U502.8 (GNDAB), U503.9 (GNDB), U503.15 (GNDBB), U504.4 (GND1), U505.2 (GND), U505.4 (ADD0), U506.2 (GND), U507.2 (GND), U508.2 (GND), U510.8 (DVSS1), U510.26 (DVSS2), U510.28 (PMBUS_CNTRL), U510.43 (DVSS3), U510.48 (AVSS2), U510.49 (AVSS1), U510.64 (AVSS3), U510.65 (EP), U511.8 (DVSS1), U511.26 (DVSS2), U511.28 (PMBUS_CNTRL), U511.43 (DVSS3), U511.48 (AVSS2), U511.49 (AVSS1), U511.64 (AVSS3), U511.65 (EP), U512.2 (GND)
GND_AP: C501.2, C503.2, C505.2, C507.2, J506.2 (A2), J506.4 (A4), J506.6 (A6), J506.8 (A8), J506.10 (A10), J506.12 (A12), J506.14 (A14), J506.16 (A16), J506.18 (A18), J506.20 (A20), J506.22 (A22), J506.24 (A24), J506.26 (A26), J506.28 (A28), J506.29 (A29), J506.30 (A30), J506.31 (A31), J506.32 (A32), J506.33 (A33), J506.34 (A34), J506.35 (A35), J506.36 (A36), J506.37 (A37), J506.38 (A38), J506.39 (A39), J506.40 (A40), J506.53 (B13), J506.54 (B14), J506.55 (B15), J506.56 (B16), J506.57 (B17), J506.58 (B18), J506.59 (B19), J506.60 (B20), J506.61 (B21), J506.62 (B22), J506.63 (B23), J506.64 (B24), J506.65 (B25), J506.66 (B26), J506.67 (B27), J506.68 (B28), J506.73 (B33), J506.75 (B35), J506.77 (B37), J506.79 (B39), J506.93 (C13), J506.94 (C14), J506.95 (C15), J506.96 (C16), J506.97 (C17), J506.98 (C18), J506.99 (C19), J506.100 (C20), J506.101 (C21), J506.102 (C22), J506.103 (C23), J506.104 (C24), J506.105 (C25), J506.106 (C26), J506.107 (C27), J506.108 (C28), J506.113 (C33), J506.114 (C34), J506.115 (C35), J506.116 (C36), J506.117 (C37), J506.118 (C38), J506.119 (C39), J506.120 (C40), J506.133 (D13), J506.134 (D14), J506.135 (D15), J506.136 (D16), J506.137 (D17), J506.138 (D18), J506.139 (D19), J506.140 (D20), J506.141 (D21), J506.142 (D22), J506.143 (D23), J506.144 (D24), J506.145 (D25), J506.146 (D26), J506.147 (D27), J506.148 (D28), J506.153 (D33), J506.154 (D34), J506.155 (D35), J506.156 (D36), J506.157 (D37), J506.158 (D38), J506.159 (D39), J506.160 (D40), J506.173 (E13), J506.174 (E14), J506.175 (E15), J506.176 (E16), J506.177 (E17), J506.178 (E18), J506.179 (E19), J506.180 (E20), J506.181 (E21), J506.182 (E22), J506.183 (E23), J506.184 (E24), J506.185 (E25), J506.186 (E26), J506.187 (E27), J506.188 (E28), J506.193 (E33), J506.194 (E34), J506.195 (E35), J506.196 (E36), J506.197 (E37), J506.198 (E38), J506.199 (E39), J506.200 (E40), J506.213 (F13), J506.214 (F14), J506.215 (F15), J506.216 (F16), J506.217 (F17), J506.218 (F18), J506.219 (F19), J506.220 (F20), J506.221 (F21), J506.222 (F22), J506.223 (F23), J506.224 (F24), J506.225 (F25), J506.226 (F26), J506.227 (F27), J506.228 (F28), J506.229 (F29), J506.230 (F30), J506.231 (F31), J506.232 (F32), J506.233 (F33), J506.234 (F34), J506.235 (F35), J506.236 (F36), J506.237 (F37), J506.238 (F38), J506.239 (F39), J506.240 (F40), TP526.1, U501.2 (GNDA), U501.8 (GNDAB), U502.9 (GNDB), U502.15 (GNDBB), U503.2 (GNDA), U503.5 (IN3), U503.6 (IN4), U503.7 (IC), U503.8 (GNDAB), U504.5 (GND2)
I2S_BCLK: TP521.1, U502.3 (IN1)
I2S_DATA: TP522.1, U502.6 (OUT4)
I2S_DATA2: R506.1, U503.13 (OUT2)
I2S_LRCLK: U502.4 (IN2)
JTDI_L: R555.2, U510.38 (TDI)
JTDI_R: R589.2, U511.38 (TDI)
JTMS_L: R556.2, U510.39 (TMS)
JTMS_R: R590.2, U511.39 (TMS)
LA0: D501.2 (A), R520.2
LA1: D502.2 (A), R521.2
LA2: D503.2 (A), R522.2
LA3: D504.2 (A), R523.2
LA4: D505.2 (A), R524.2
LED_DBG0: R510.1, TP520.1
LED_DBG1: R511.1
LED_DBG2: R512.1
LED_DBG3: R513.1
LK0: D501.1 (K), Q501.3 (C)
LK1: D502.1 (K), Q502.3 (C)
LK2: D503.1 (K), Q503.3 (C)
LK3: D504.1 (K), Q504.3 (C)
LK4: D505.1 (K), Q505.3 (C)
MON_L1: C520.1, R526.2, R527.1, U510.1 (MON1)
MON_L2: C521.1, R528.2, R529.1, U510.2 (MON2)
MON_L3: C522.1, R530.2, R531.1, U510.3 (MON3)
MON_L4: C523.1, R532.2, R533.1, U510.4 (MON4)
MON_L5: C524.1, R534.2, R535.1, U510.5 (MON5)
MON_L6: C525.1, R536.2, R537.1, U510.6 (MON6)
MON_L7: C526.1, D516.1 (K), R538.2, R539.1, U510.59 (MON7)
MON_L8: C527.1, D517.1 (K), R540.2, R541.1, U510.62 (MON8)
MON_L9: C528.1, R542.2, R543.1, U510.63 (MON9)
MON_L10: C529.1, R544.2, R545.1, U510.50 (MON10)
MON_L11: C530.1, D520.1 (K), R546.2, R547.1, U510.52 (MON11)
MON_L12: C531.1, R548.2, R549.1, U510.54 (MON12)
MON_L13: C532.1, R550.2, R551.1, U510.56 (MON13)
MON_R1: C620.1, R560.2, R561.1, U511.1 (MON1)
MON_R2: C621.1, R562.2, R563.1, U511.2 (MON2)
MON_R3: C622.1, R564.2, R565.1, U511.3 (MON3)
MON_R4: C623.1, R566.2, R567.1, U511.4 (MON4)
MON_R5: C624.1, R568.2, R569.1, U511.5 (MON5)
MON_R6: C625.1, R570.2, R571.1, U511.6 (MON6)
MON_R7: C626.1, D616.1 (K), R572.2, R573.1, U511.59 (MON7)
MON_R8: C627.1, D617.1 (K), R574.2, R575.1, U511.62 (MON8)
MON_R9: C628.1, R576.2, R577.1, U511.63 (MON9)
MON_R10: C629.1, R578.2, R579.1, U511.50 (MON10)
MON_R11: C630.1, D620.1 (K), R580.2, R581.1, U511.52 (MON11)
MON_R12: C631.1, R582.2, R583.1, U511.54 (MON12)
MON_R13: C632.1, R584.2, R585.1, U511.56 (MON13)
N15A_L: R538.1
N15A_R: R572.1
N16A: R546.1, R580.1
P5A_L: R532.1
P5A_R: R566.1
P15A_L: R528.1
P15A_R: R562.1
P16A: R544.1, R578.1
QB0: Q501.1 (B), R510.2
QB1: Q502.1 (B), R511.2
QB2: Q503.1 (B), R512.2
QB3: Q504.1 (B), R513.2
QB4: Q505.1 (B), R514.2
SENS_SCL: J505.2, R505.2, TP512.1, U504.3 (SCL1), U505.1 (SCL), U506.1 (SCL), U507.1 (SCL), U508.1 (SCL), U508.4 (ADD0), U510.15 (PMBUS_CLK), U511.15 (PMBUS_CLK)
SENS_SDA: J505.3, R504.2, TP513.1, U504.2 (SDA1), U505.6 (SDA), U506.6 (SDA), U507.4 (ADD0), U507.6 (SDA), U508.6 (SDA), U510.16 (PMBUS_DATA), U511.16 (PMBUS_DATA)
SOM_PG: J506.23 (A23), R514.1
SPI_CS_N: TP515.1, U501.13 (OUT2)
SPI_MISO: TP517.1, U501.11 (IN4)
SPI_MOSI: TP516.1, U501.12 (OUT3)
SPI_SCLK: TP514.1, U501.14 (OUT1)
TRCK_L: R554.1, U510.10 (TRCK)
TRCK_R: R588.1, U511.10 (TRCK)
TRST_L: R553.1, U510.40 (TRST)
TRST_R: R587.1, U511.40 (TRST)
URST_L: C565.1, R552.2, U510.9 (RESET)
URST_R: C665.1, R586.2, U511.9 (RESET)
V4P3_LA: R550.1
V4P3_LB: C518.1, U512.1 (IN), U512.3 (EN)
V4P3_RA: R584.1
V8P3: R548.1
V12SOM: J506.82 (C2), J506.83 (C3), J506.84 (C4), J506.85 (C5), J506.86 (C6), J506.87 (C7), J506.88 (C8), J506.89 (C9), J506.90 (C10), J506.91 (C11), J506.122 (D2), J506.123 (D3), J506.124 (D4), J506.125 (D5), J506.126 (D6), J506.127 (D7), J506.128 (D8), J506.129 (D9), J506.130 (D10), J506.131 (D11), J506.162 (E2), J506.163 (E3), J506.164 (E4), J506.165 (E5), J506.166 (E6), J506.167 (E7), J506.168 (E8), J506.169 (E9), J506.170 (E10), J506.171 (E11), R576.1, TP511.1
V18: C502.1, C504.1, C506.1, R570.1, U501.10 (ENB), U501.16 (VDDB), U502.1 (VDDA), U502.7 (ENA), U503.10 (ENB), U503.16 (VDDB)
V33CLK: R534.1
V33D: C508.1, C509.1, C510.1, C511.1, C512.1, C519.1, C560.1, C561.1, C562.1, C563.1, C660.1, C661.1, C662.1, C663.1, J505.1, R504.1, R505.1, R520.1, R521.1, R522.1, R523.1, R524.1, R539.2, R541.2, R547.2, R552.1, R555.1, R556.1, R557.1, R568.1, R573.2, R575.2, R581.2, R586.1, R589.1, R590.1, R591.1, TP510.1, U504.1 (VCC1), U505.5 (V+), U506.4 (ADD0), U506.5 (V+), U507.5 (V+), U508.5 (V+), U510.7 (V33DIO1), U510.44 (V33DIO2), U510.45 (V33D), U510.46 (V33A), U510.58 (V33FB), U511.7 (V33DIO1), U511.44 (V33DIO2), U511.45 (V33D), U511.46 (V33A), U511.58 (V33FB), U512.5 (OUT)
V33FF_L: R536.1
V33FF_R: R582.1
V33RLY: R542.1
V33_IF_IN: J506.110 (C30), J506.111 (C31), J506.150 (D30), J506.151 (D31)
VAP_IO: C501.1, C503.1, C505.1, C507.1, J506.25 (A25), J506.74 (B34), J506.76 (B36), J506.78 (B38), J506.80 (B40), R501.1, R502.1, R503.1, TP525.1, U501.1 (VDDA), U501.7 (ENA), U502.10 (ENB), U502.16 (VDDB), U503.1 (VDDA), U504.8 (VCC2)
VE1_L: R530.1
VE1_R: R564.1
VEE15_L: R540.1
VEE15_R: R574.1
V_ROFF_L: R526.1
V_ROFF_R: R560.1

Notes on the sheet:
Isolation barrier (user rulings 2026-10-05 / 2026-10-07): the application processor (AP) is its own ground domain (GND_AP, VAP_IO). Everything that crosses to the FPGA/analog side goes through isolators: U501 MAX22445C = control SPI (SCLK/CS_N/MOSI AP->FPGA, MISO back), U502 MAX22445F = I2S with th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
Conn1 power allocation: 30 x V12SOM plus 30 GND perimeter contacts; 4 x V33_IF_IN plus 12 carrier-GND guard contacts. V33_IF_IN is distinct from VAP_IO/GND_AP. Local 1.8 V LDO MPN/output wiring remains to be added.
TMP117 placement (bom 20, 4 so far): U505 L cascode/replica array, U506 R cascode/replica array, U507 R_off/Rpad heat zone, U508 clock XO area. V33D = digital 3.3 V (power sheet, PWR_FLAG here). ALERT pins unused. Pull-ups 2.2k each side of the ISO1640.
LEDs: led_debug[3:0] (xdc s10: 3 clk_locked, 2 ddr4_calib, 1 i2s_err, 0 force_zero) + SOM_PG; MMBT3904 sink from the 1.8 V IO. led_status (BC33) is on the module.
RLY_LINE_MUTE (J1 R28) terminates on the OUT sheet (bom 7): U602 AND gate with FPGA_DONE and PG_ALL -> UNMUTE_EN -> U601 ULN2003V12 inputs AND U603 TPS7A2033 EN (V33RLY coil rail). relay_level[1:0] struck (digital level).
V33D = U512 TPS7A2033 from V4P3_LB (always on; bom 17n: housekeeping branch, also feeds P5A_R): TMP117 x4 + ISO1640 side 1 + UCD90120A x2 + LEDs, ~120 mA.
RAIL TELEMETRY (bom 17(m2)/(m3)): U510 (UCD_L) watches the L-channel POL rails + V33CLK/V33FF/V33RLY + the four pre-regs; U511 (UCD_R) watches the R-channel rails + V33D/V18/V12SOM + the same four pre-regs (cross-check). 26 of 26 MON inputs used - every rail on the board. MON window 0-2.5 V: positi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
ADDRESSES (resistor straps on PMBUS_ADDR0/1, analog pins per SLVSAN9C): UCD_L 10k/10k to GND, UCD_R 10k/20k - DISTINCT, and both strapped away from the 126/JTAG default. ** VERIFY chosen values against the TI address-detection table and record the resulting PMBus addresses here **. Straps: RESET = 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
MON1 <- V_ROFF_L
MON2 <- P15A_L
MON3 <- VE1_L
MON4 <- P5A_L
MON5 <- V33CLK
MON6 <- V33FF_L
MON7 <- N15A_L
MON8 <- VEE15_L
MON9 <- V33RLY
MON10 <- P16A
MON11 <- N16A
MON12 <- V8P3
MON13 <- V4P3_LA
MON1 <- V_ROFF_R
MON2 <- P15A_R
MON3 <- VE1_R
MON4 <- P5A_R
MON5 <- V33D
MON6 <- V18
MON7 <- N15A_R
MON8 <- VEE15_R
MON9 <- V12SOM
MON12 <- V33FF_R
MON13 <- V4P3_RA
TEST POINTS (rule c): SPI / SENS / RST / IRQ / LED / I2S handshakes on hook pads; GND at the bottom.
