ccroswhite/BFDAC/hw/kicad/fpga.kicad_sch

## KiCad design hw/kicad/fpga.kicad_sch (2026-11-04)

Schematic: fpga.kicad_sch

Parts:
C301, C302, C303, C304, C321, C322, C323, C324, C325, C326, C327, C328, C329, C330, C331, C332, C333, C334, C335, C336, C337, C338, C339, C340, C341, C342, C343, C344, C345, C346, C347, C360, C361, C362, C363, C364, C365, C366, C367: 100n; C_0603_1608Metric; MPN GRM188R71C104KA01D
C320: 10u; C_0805_2012Metric; MPN GRM21BR61A106KE19L
J1, J6: ADM6-60; Samtec_ADM6-60-01.5-L-4-2-A; MPN ADM6-60-01.5-L-4-2-A-TR
R301, R302, R306, R310, R311, R312, R313, R314, R315, R316, R317, R326, R400, R401, R402, R403, R404, R405, R406, R407, R408, R409, R410, R411, R412, R413, R414, R415, R416, R417, R418, R419, R420, R421, R422, R423, R424, R425, R426, R427, R428, R429, R430, R431, R432, R433, R434, R435, R436, R437, R438, R439, R440, R441, R442, R443, R444, R445, R446, R447, R448, R449, R450, R451, R452, R453, R454, R455, R456, R457, R458, R459, R460, R461, R462, R463: 33; R_0603_1608Metric; MPN CRCW060333R0FKEA
R303, R307, R320, R321, R322, R323, R324, R325: 10k; R_0603_1608Metric; MPN CRCW060310K0FKEA
R304: 100; R_0603_1608Metric; MPN CRCW0603100RFKEA
R305: 120; R_0603_1608Metric; MPN CRCW0603120RFKEA
R327, R328, R329: 1.00k; R_0603_1608Metric; MPN TNPW06031K00FEEA
TP300, TP301, TP302: TP; TestPoint_Pad_1.0x1.0mm
TP303, TP304: TP; TestPoint_THTPad_2.0x2.0mm_Drill1.0mm
U301: SN74LVC1G04; SOT-23-5; MPN SN74LVC1G04DBVR
U302, U304, U305, U306, U307, U308, U309, U310, U311: LMK1C1108; TSSOP-16_4.4x5mm_P0.65mm; MPN LMK1C1108PWR
U312: SN74LVC1G125; SOT-23-5; MPN SN74LVC1G125DBVR
U320, U321, U322, U323: MX66UM2G45G; Macronix_MX66UM_CSPBGA-24_6x8mm_5x5_P1.0mm; MPN MX66UM2G45GXRI00
Y301: 49.152 MHz; Crystek_CCHD-957; MPN CCHD-957-25-49.152
Y302: 45.1584 MHz; Crystek_CCHD-957; MPN CCHD-957-25-45.1584

Connections:
CF_CLK: R326.2, U320.B2 (SCLK), U321.B2 (SCLK), U322.B2 (SCLK), U323.B2 (SCLK)
CF_CLK_J1: J1.A20 (CF_CLK_J1), R326.1
CF_CS0: J1.A19 (CF_CS0), R320.2, U320.C2 (CS#)
CF_CS1: J1.A26 (CF_CS1), R321.2, U321.C2 (CS#)
CF_CS2: J1.A25 (CF_CS2), R322.2, U322.C2 (CS#)
CF_CS3: J1.B29 (CF_CS3), R323.2, U323.C2 (CS#)
CF_DQ0: J1.A23 (CF_DQ0), U320.D3 (SIO0), U321.D3 (SIO0), U322.D3 (SIO0), U323.D3 (SIO0)
CF_DQ1: J1.A22 (CF_DQ1), U320.D2 (SIO1), U321.D2 (SIO1), U322.D2 (SIO1), U323.D2 (SIO1)
CF_DQ2: J1.B20 (CF_DQ2), R324.2, U320.C4 (SIO2), U321.C4 (SIO2), U322.C4 (SIO2), U323.C4 (SIO2)
CF_DQ3: J1.B19 (CF_DQ3), R325.2, U320.D4 (SIO3), U321.D4 (SIO3), U322.D4 (SIO3), U323.D4 (SIO3)
CLK_SEL: J6.A19 (CLK_SEL), R303.1, TP303.1, U301.2, Y302.1 (E/D)
CLK_SEL_N: U301.4, Y301.1 (E/D)
DAT01_1V8: J6.C40 (DAT01)
DAT02_1V8: J6.C39 (DAT02)
DAT03_1V8: J6.D38 (DAT03)
DAT04_1V8: J6.D37 (DAT04)
DAT05_1V8: J6.C38 (DAT05)
DAT06_1V8: J6.C37 (DAT06)
DAT07_1V8: J6.C43 (DAT07)
DAT08_1V8: J6.C42 (DAT08)
DAT09_1V8: J6.C45 (DAT09)
DAT10_1V8: J6.C44 (DAT10)
DAT11_1V8: J6.D40 (DAT11)
DAT12_1V8: J6.D39 (DAT12)
DAT13_1V8: J6.D43 (DAT13)
DAT14_1V8: J6.D42 (DAT14)
DAT15_1V8: J6.D33 (DAT15)
DAT16_1V8: J6.D32 (DAT16)
DAT17_1V8: J6.D45 (DAT17)
DAT18_1V8: J6.D44 (DAT18)
DAT19_1V8: J6.B49 (DAT19)
DAT20_1V8: J6.B48 (DAT20)
DAT21_1V8: J6.B47 (DAT21)
DAT22_1V8: J6.B46 (DAT22)
DAT23_1V8: J6.C35 (DAT23)
DAT24_1V8: J6.C34 (DAT24)
DAT25_1V8: J6.C33 (DAT25)
DAT26_1V8: J6.C32 (DAT26)
DAT27_1V8: J6.B34 (DAT27)
DAT28_1V8: J6.B33 (DAT28)
DAT29_1V8: J6.A44 (DAT29)
DAT30_1V8: J6.A43 (DAT30)
DAT31_1V8: J6.B44 (DAT31)
DAT32_1V8: J6.B43 (DAT32)
DAT33_1V8: J6.A42 (DAT33)
DAT34_1V8: J6.A41 (DAT34)
DAT35_1V8: J6.B39 (DAT35)
DAT36_1V8: J6.B38 (DAT36)
DAT37_1V8: J6.A47 (DAT37)
DAT38_1V8: J6.A46 (DAT38)
DAT39_1V8: J6.A39 (DAT39)
DAT40_1V8: J6.A38 (DAT40)
DAT41_1V8: J6.A37 (DAT41)
DAT42_1V8: J6.A36 (DAT42)
DAT43_1V8: J6.B37 (DAT43)
DAT44_1V8: J6.B36 (DAT44)
DAT45_1V8: J6.B32 (DAT45)
DAT46_1V8: J6.B31 (DAT46)
DAT47_1V8: J6.B42 (DAT47)
DAT48_1V8: J6.B41 (DAT48)
DAT49_1V8: J6.D23 (DAT49)
DAT50_1V8: J6.D22 (DAT50)
DAT51_1V8: J6.B29 (DAT51)
DAT52_1V8: J6.D28 (DAT52)
DAT53_1V8: J6.D27 (DAT53)
DAT54_1V8: J6.B24 (DAT54)
DAT55_1V8: J6.B23 (DAT55)
DAT56_1V8: J6.B19 (DAT56)
DAT57_1V8: J6.B18 (DAT57)
DAT58_1V8: J6.D30 (DAT58)
DAT59_1V8: J6.D29 (DAT59)
DAT60_1V8: J6.A32 (DAT60)
DAT61_1V8: J6.A31 (DAT61)
DAT62_1V8: J6.D25 (DAT62)
DAT63_1V8: J6.D24 (DAT63)
DAT64_1V8: J6.A27 (DAT64)
DATR49_1V8: J6.B59 (DATR49)
DATR50_1V8: J6.B58 (DATR50)
DATR51_1V8: J6.A59 (DATR51)
DATR52_1V8: J6.A58 (DATR52)
DATR53_1V8: J6.C50 (DATR53)
DATR54_1V8: J6.C49 (DATR54)
DATR55_1V8: J6.C53 (DATR55)
DATR56_1V8: J6.C52 (DATR56)
DATR57_1V8: J6.A52 (DATR57)
DATR58_1V8: J6.A51 (DATR58)
DATR59_1V8: J6.A54 (DATR59)
DATR60_1V8: J6.A53 (DATR60)
DATR61_1V8: J6.B57 (DATR61)
DATR62_1V8: J6.B56 (DATR62)
DATR63_1V8: J6.B52 (DATR63)
DATR64_1V8: J6.B51 (DATR64)
EXT_RST_N: J1.A1 (EXT_RST_N)
FPGACLK_3V3: R304.1, U312.4
FPGA_IRQ_N: J1.A5 (FPGA_IRQ_N)
GND: C301.2, C302.2, C303.2, C304.2, C320.2, C321.2, C322.2, C323.2, C324.2, C325.2, C326.2, C327.2, C328.2, C329.2, C330.2, C331.2, C332.2, C333.2, C334.2, C335.2, C336.2, C337.2, C338.2, C339.2, C340.2, C341.2, C342.2, C343.2, C344.2, C345.2, C346.2, C347.2, C360.2, C361.2, C362.2, C363.2, C364.2, C365.2, C366.2, C367.2, J1.A3 (GND), J1.A6 (GND), J1.A9 (GND), J1.A12 (GND), J1.A15 (GND), J1.A18 (GND), J1.A21 (GND), J1.A24 (GND), J1.A27 (GND), J1.A30 (GND), J1.A33 (GND), J1.A36 (GND), J1.A39 (GND), J1.A42 (GND), J1.A45 (GND), J1.A48 (GND), J1.A51 (GND), J1.A54 (GND), J1.A57 (GND), J1.B3 (GND), J1.B6 (GND), J1.B9 (GND), J1.B12 (GND), J1.B15 (GND), J1.B18 (GND), J1.B21 (GND), J1.B24 (GND), J1.B27 (GND), J1.B30 (GND), J1.B33 (GND), J1.B36 (GND), J1.B39 (GND), J1.B42 (GND), J1.B45 (GND), J1.B48 (GND), J1.B51 (GND), J1.B54 (GND), J1.B57 (GND), J1.C3 (GND), J1.C6 (GND), J1.C9 (GND), J1.C12 (GND), J1.C15 (GND), J1.C18 (GND), J1.C21 (GND), J1.C24 (GND), J1.C27 (GND), J1.C30 (GND), J1.C33 (GND), J1.C36 (GND), J1.C39 (GND), J1.C42 (GND), J1.C45 (GND), J1.C48 (GND), J1.C51 (GND), J1.C54 (GND), J1.C57 (GND), J1.D3 (GND), J1.D6 (GND), J1.D9 (GND), J1.D12 (GND), J1.D15 (GND), J1.D18 (GND), J1.D21 (GND), J1.D24 (GND), J1.D27 (GND), J1.D30 (GND), J1.D33 (GND), J1.D36 (GND), J1.D39 (GND), J1.D42 (GND), J1.D45 (GND), J1.D48 (GND), J1.D51 (GND), J1.D54 (GND), J1.D57 (GND), J6.A2 (GND), J6.A3 (GND), J6.A5 (GND), J6.A6 (GND), J6.A8 (GND), J6.A9 (GND), J6.A11 (GND), J6.A12 (GND), J6.A14 (GND), J6.A15 (GND), J6.A20 (GND), J6.A25 (GND), J6.A30 (GND), J6.A35 (GND), J6.A40 (GND), J6.A45 (GND), J6.A50 (GND), J6.A55 (GND), J6.B2 (GND), J6.B3 (GND), J6.B5 (GND), J6.B6 (GND), J6.B8 (GND), J6.B9 (GND), J6.B11 (GND), J6.B12 (GND), J6.B14 (GND), J6.B15 (GND), J6.B20 (GND), J6.B25 (GND), J6.B30 (GND), J6.B35 (GND), J6.B40 (GND), J6.B45 (GND), J6.B50 (GND), J6.B55 (GND), J6.C1 (GND), J6.C3 (GND), J6.C4 (GND), J6.C6 (GND), J6.C7 (GND), J6.C9 (GND), J6.C10 (GND), J6.C12 (GND), J6.C13 (GND), J6.C15 (GND), J6.C16 (GND), J6.C21 (GND), J6.C26 (GND), J6.C31 (GND), J6.C36 (GND), J6.C41 (GND), J6.C46 (GND), J6.C51 (GND), J6.D1 (GND), J6.D3 (GND), J6.D4 (GND), J6.D6 (GND), J6.D7 (GND), J6.D9 (GND), J6.D10 (GND), J6.D12 (GND), J6.D13 (GND), J6.D15 (GND), J6.D16 (GND), J6.D21 (GND), J6.D26 (GND), J6.D31 (GND), J6.D36 (GND), J6.D41 (GND), J6.D46 (GND), J6.D51 (GND), R303.2, R305.2, TP304.1, U301.3 (GND), U302.4 (GND), U302.7 (GND), U302.12 (GND), U304.4 (GND), U304.7 (GND), U304.12 (GND), U305.4 (GND), U305.7 (GND), U305.12 (GND), U306.4 (GND), U306.7 (GND), U306.12 (GND), U307.4 (GND), U307.7 (GND), U307.12 (GND), U308.4 (GND), U308.7 (GND), U308.12 (GND), U309.4 (GND), U309.7 (GND), U309.12 (GND), U310.4 (GND), U310.7 (GND), U310.12 (GND), U311.4 (GND), U311.7 (GND), U311.12 (GND), U312.1, U312.3 (GND), U320.B3 (GND), U320.C1 (VSSQ), U320.E5 (VSSQ), U321.B3 (GND), U321.C1 (VSSQ), U321.E5 (VSSQ), U322.B3 (GND), U322.C1 (VSSQ), U322.E5 (VSSQ), U323.B3 (GND), U323.C1 (VSSQ), U323.E5 (VSSQ), Y301.2 (GND), Y302.2 (GND)
I2S_BCLK: J1.B17 (I2S_BCLK)
I2S_DATA: J1.A4 (I2S_DATA)
I2S_DATA2: J1.B16 (I2S_DATA2)
I2S_LRCLK: J1.A2 (I2S_LRCLK)
JTAG_TCK: J6.D20 (JTAG_TCK)
JTAG_TDI: J6.D17 (JTAG_TDI)
JTAG_TDO: J6.D18 (JTAG_TDO)
JTAG_TMS: J6.D19 (JTAG_TMS)
L0Y0: R400.1, U304.3 (Y0)
L0Y1: R401.1, U304.16 (Y1)
L0Y2: R402.1, U304.13 (Y2)
L0Y3: R403.1, U304.15 (Y3)
L0Y4: R404.1, U304.6 (Y4)
L0Y5: R405.1, U304.11 (Y5)
L0Y6: R406.1, U304.8 (Y6)
L0Y7: R407.1, U304.9 (Y7)
L1Y0: R408.1, U305.3 (Y0)
L1Y1: R409.1, U305.16 (Y1)
L1Y2: R410.1, U305.13 (Y2)
L1Y3: R411.1, U305.15 (Y3)
L1Y4: R412.1, U305.6 (Y4)
L1Y5: R413.1, U305.11 (Y5)
L1Y6: R414.1, U305.8 (Y6)
L1Y7: R415.1, U305.9 (Y7)
L2Y0: R416.1, U306.3 (Y0)
L2Y1: R417.1, U306.16 (Y1)
L2Y2: R418.1, U306.13 (Y2)
L2Y3: R419.1, U306.15 (Y3)
L2Y4: R420.1, U306.6 (Y4)
L2Y5: R421.1, U306.11 (Y5)
L2Y6: R422.1, U306.8 (Y6)
L2Y7: R423.1, U306.9 (Y7)
L3Y0: R424.1, U307.3 (Y0)
L3Y1: R425.1, U307.16 (Y1)
L3Y2: R426.1, U307.13 (Y2)
L3Y3: R427.1, U307.15 (Y3)
L3Y4: R428.1, U307.6 (Y4)
L3Y5: R429.1, U307.11 (Y5)
L3Y6: R430.1, U307.8 (Y6)
L3Y7: R431.1, U307.9 (Y7)
L4Y0: R432.1, U308.3 (Y0)
L4Y1: R433.1, U308.16 (Y1)
L4Y2: R434.1, U308.13 (Y2)
L4Y3: R435.1, U308.15 (Y3)
L4Y4: R436.1, U308.6 (Y4)
L4Y5: R437.1, U308.11 (Y5)
L4Y6: R438.1, U308.8 (Y6)
L4Y7: R439.1, U308.9 (Y7)
L5Y0: R440.1, U309.3 (Y0)
L5Y1: R441.1, U309.16 (Y1)
L5Y2: R442.1, U309.13 (Y2)
L5Y3: R443.1, U309.15 (Y3)
L5Y4: R444.1, U309.6 (Y4)
L5Y5: R445.1, U309.11 (Y5)
L5Y6: R446.1, U309.8 (Y6)
L5Y7: R447.1, U309.9 (Y7)
L6Y0: R448.1, U310.3 (Y0)
L6Y1: R449.1, U310.16 (Y1)
L6Y2: R450.1, U310.13 (Y2)
L6Y3: R451.1, U310.15 (Y3)
L6Y4: R452.1, U310.6 (Y4)
L6Y5: R453.1, U310.11 (Y5)
L6Y6: R454.1, U310.8 (Y6)
L6Y7: R455.1, U310.9 (Y7)
L7Y0: R456.1, U311.3 (Y0)
L7Y1: R457.1, U311.16 (Y1)
L7Y2: R458.1, U311.13 (Y2)
L7Y3: R459.1, U311.15 (Y3)
L7Y4: R460.1, U311.6 (Y4)
L7Y5: R461.1, U311.11 (Y5)
L7Y6: R462.1, U311.8 (Y6)
L7Y7: R463.1, U311.9 (Y7)
LEAF0: R310.1, U302.3 (Y0)
LEAF0R: R310.2, U304.1 (CLKIN)
LEAF1: R311.1, U302.16 (Y1)
LEAF1R: R311.2, U305.1 (CLKIN)
LEAF2: R312.1, U302.13 (Y2)
LEAF2R: R312.2, U306.1 (CLKIN)
LEAF3: R313.1, U302.15 (Y3)
LEAF3R: R313.2, U307.1 (CLKIN)
LEAF4: R314.1, U302.6 (Y4)
LEAF4R: R314.2, U308.1 (CLKIN)
LEAF5: R315.1, U302.11 (Y5)
LEAF5R: R315.2, U309.1 (CLKIN)
LEAF6: R316.1, U302.8 (Y6)
LEAF6R: R316.2, U310.1 (CLKIN)
LEAF7: R317.1, U302.9 (Y7)
LEAF7R: R317.2, U311.1 (CLKIN)
LED_DBG0: J1.A10 (LED_DBG0)
LED_DBG1: J1.A11 (LED_DBG1)
LED_DBG2: J1.A13 (LED_DBG2)
LED_DBG3: J1.A14 (LED_DBG3)
MCLK01: R328.1, R400.2
MCLK02: R401.2
MCLK03: R402.2
MCLK04: R403.2
MCLK05: R404.2
MCLK06: R405.2
MCLK07: R406.2
MCLK08: R407.2
MCLK09: R408.2
MCLK10: R409.2
MCLK11: R410.2
MCLK12: R411.2
MCLK13: R412.2
MCLK14: R413.2
MCLK15: R414.2
MCLK16: R415.2
MCLK17: R416.2
MCLK18: R417.2
MCLK19: R418.2
MCLK20: R419.2
MCLK21: R420.2
MCLK22: R421.2
MCLK23: R422.2
MCLK24: R423.2
MCLK25: R424.2
MCLK26: R425.2
MCLK27: R426.2
MCLK28: R427.2
MCLK29: R428.2
MCLK30: R429.2
MCLK31: R430.2
MCLK32: R431.2
MCLK33: R432.2
MCLK34: R433.2
MCLK35: R434.2
MCLK36: R435.2
MCLK37: R436.2
MCLK38: R437.2
MCLK39: R438.2
MCLK40: R439.2
MCLK41: R440.2
MCLK42: R441.2
MCLK43: R442.2
MCLK44: R443.2
MCLK45: R444.2
MCLK46: R445.2
MCLK47: R446.2
MCLK48: R447.2
MCLK49: R448.2
MCLK50: R449.2
MCLK51: R450.2
MCLK52: R451.2
MCLK53: R452.2
MCLK54: R453.2
MCLK55: R454.2
MCLK56: R455.2
MCLK57: R456.2
MCLK58: R457.2
MCLK59: R458.2
MCLK60: R459.2
MCLK61: R460.2
MCLK62: R461.2
MCLK63: R462.2
MCLK64: R329.1, R463.2
MCLK_FPGA: J6.C30 (MCLK_FPGA), R304.2, R305.1, R327.1
OE: R307.2, U302.2 (1G), U304.2 (1G), U305.2 (1G), U306.2 (1G), U307.2 (1G), U308.2 (1G), U309.2 (1G), U310.2 (1G), U311.2 (1G)
PG_ALL: J1.B7 (PG_ALL)
RLY_LINE_MUTE: J1.A7 (RLY_LINE_MUTE)
ROOT_IN: R306.2, U302.1 (CLKIN)
SOM_PG: J6.D34 (SOM_PG)
SPI_CS_N: J1.C1 (SPI_CS_N)
SPI_MISO: J1.C4 (SPI_MISO)
SPI_MOSI: J1.C5 (SPI_MOSI)
SPI_SCLK: J1.C2 (SPI_SCLK)
TEST_LED: J1.D17 (TEST_LED)
TEST_SELECT_N: J1.D20 (TEST_SELECT_N)
TEST_STEP_N: J1.D19 (TEST_STEP_N)
TP_MCLK01: R328.2, TP301.1
TP_MCLK64: R329.2, TP302.1
TP_MCLK_FPGA: R327.2, TP300.1
V18: C360.1, C361.1, C362.1, C363.1, C364.1, C365.1, C366.1, C367.1, J1.A40 (VCCIO_70), J1.A41 (VCCIO_70), J1.C60 (VCCIO_69), J1.D1 (VCCIO_71), J1.D2 (VCCIO_71), J6.A60 (VCCIO_65_EX), R320.1, R321.1, R322.1, R323.1, R324.1, R325.1, U320.A4 (RESET#), U320.B4 (VCC), U320.D1 (VCCQ), U320.E4 (VCCQ), U321.A4 (RESET#), U321.B4 (VCC), U321.D1 (VCCQ), U321.E4 (VCCQ), U322.A4 (RESET#), U322.B4 (VCC), U322.D1 (VCCQ), U322.E4 (VCCQ), U323.A4 (RESET#), U323.B4 (VCC), U323.D1 (VCCQ), U323.E4 (VCCQ)
V33CLK: C301.1, C302.1, C303.1, C304.1, C320.1, C321.1, C322.1, C323.1, C324.1, C325.1, C326.1, C327.1, C328.1, C329.1, C330.1, C331.1, C332.1, C333.1, C334.1, C335.1, C336.1, C337.1, C338.1, C339.1, C340.1, C341.1, C342.1, C343.1, C344.1, C345.1, C346.1, C347.1, R307.1, U301.5 (VCC), U302.5 (VDD), U302.10 (VDD), U302.14 (VDD), U304.5 (VDD), U304.10 (VDD), U304.14 (VDD), U305.5 (VDD), U305.10 (VDD), U305.14 (VDD), U306.5 (VDD), U306.10 (VDD), U306.14 (VDD), U307.5 (VDD), U307.10 (VDD), U307.14 (VDD), U308.5 (VDD), U308.10 (VDD), U308.14 (VDD), U309.5 (VDD), U309.10 (VDD), U309.14 (VDD), U310.5 (VDD), U310.10 (VDD), U310.14 (VDD), U311.5 (VDD), U311.10 (VDD), U311.14 (VDD), U312.5 (VCC), Y301.4 (Vcc), Y302.4 (Vcc)
XO0: R301.1, Y301.3 (OUT)
XO1: R302.1, Y302.3 (OUT)
XOCLK: R301.2, R302.2, R306.1, U312.2

Notes on the sheet:
FPGA interface (bom 1.3): Alinx ACVU13P module, carrier connector J6 (cascode_l[63:0] -> DAT01..64, banks 64/65, LVCMOS18; mclk B65_L12_P GC LVCMOS18 single-ended + clk_sel B65_L16_P - moved off J1 2026-10-08 so the clock block lives on the analog edge). Pin map = Alinx/ACVU13P-Pin-Assignment-20260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
Clock tree (bom 1.1, item 15 option 2): no mux chip. Y301 (49.152) / Y302 (45.1584) CCHD-957 enabled one at a time via E/D (clk_sel -> Y302, !clk_sel -> Y301 through U301 LVC1G04; clk_sel pulled low = 48k family default), outputs joined through 33 R each on the XOCLK net -> root U302 (this channel;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
J1 control-plane pins (bank 71, xdc s4-7/10/5b) -> CTRL sheet: SPI_SCLK/CS_N/MOSI/MISO, FPGA_IRQ_N, EXT_RST_N (R27, new 2026-10-07), I2S_BCLK/LRCLK/DATA/DATA2 (H28, second AP source 2026-10-30), RLY_LINE_MUTE (-> OUT sheet unmute gate), LED_DBG0..3. relay_hp_mute (T28) / relay_hp_rails (N26) struck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
R channel: XOCLK -> R350 33 R -> U303 root -> U330..U337 -> MCLKR01..64 on the CLKR sheet (same tree, same V33CLK).
Coefficient flash (bom 18b): 4 x MX66UM2G45GXRI00 2 Gb 1.8 V x1 SPI NOR populated (U320-U323 = 8 Gb; 1-Gb same-land-pattern alternative is four chips / reduced library), x1 FAST READ4B 0Ch at 100 MHz with 8 dummy clocks; 2-Gb mode = 88 filters at 10M taps, 18-bit mirrored; 1-Gb mode = 44 complete f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
TEST POINTS (rule b): MCLK_FPGA / MCLK leaves through 1k -> 1.0 mm pad; CLK_SEL + GND on hook pads.
