ccroswhite/BFDAC/hw/kicad/iv.kicad_sch

## KiCad design hw/kicad/iv.kicad_sch (2026-11-04)

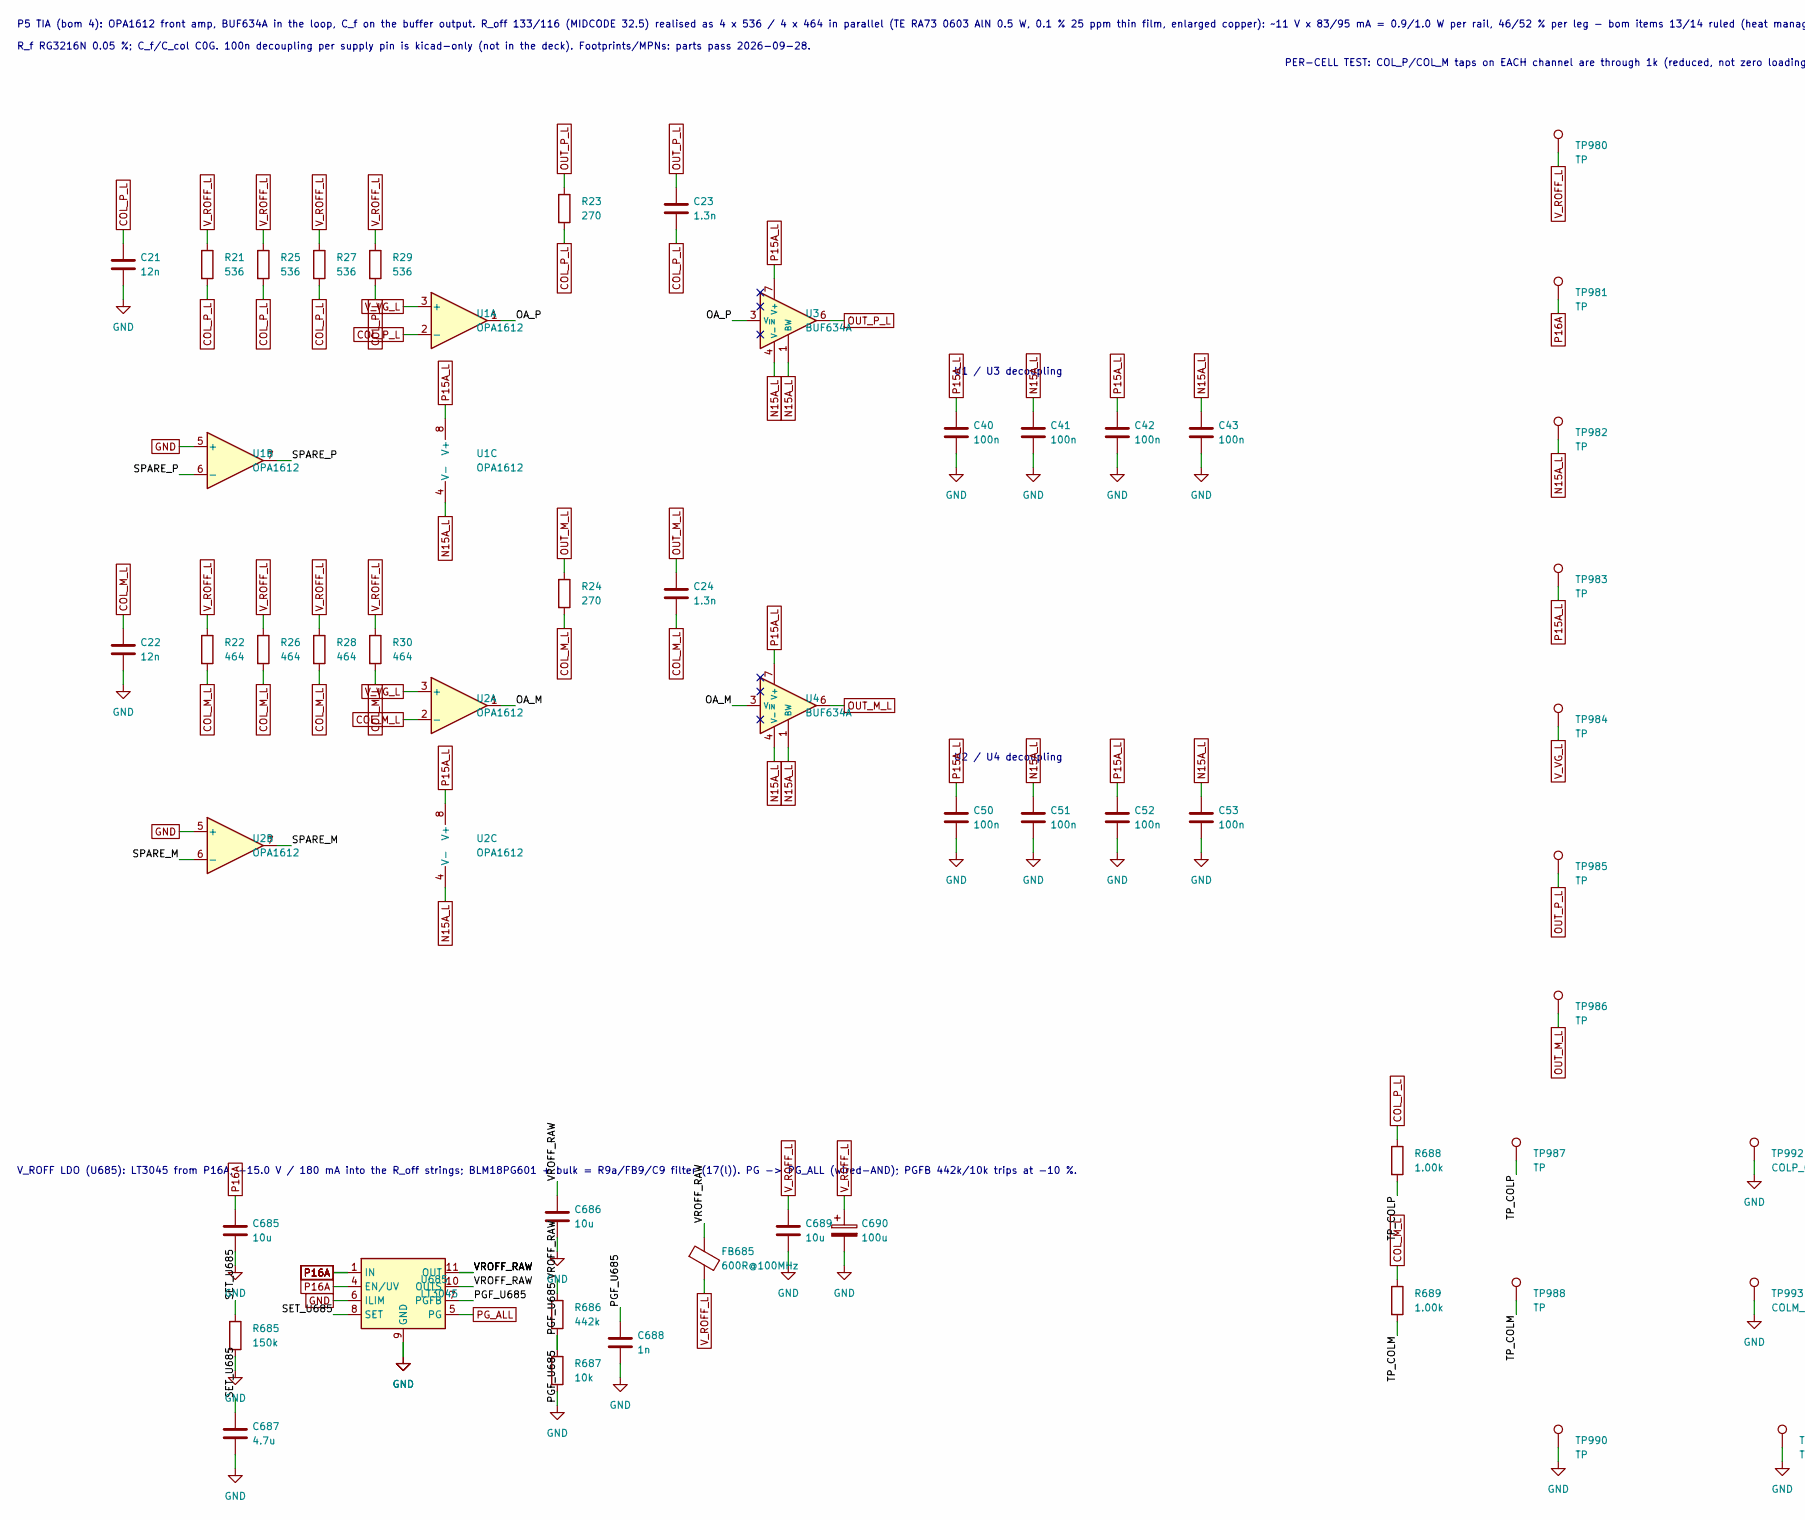
[picture p19: schematic iv.kicad_sch, part in row 1, column 1]

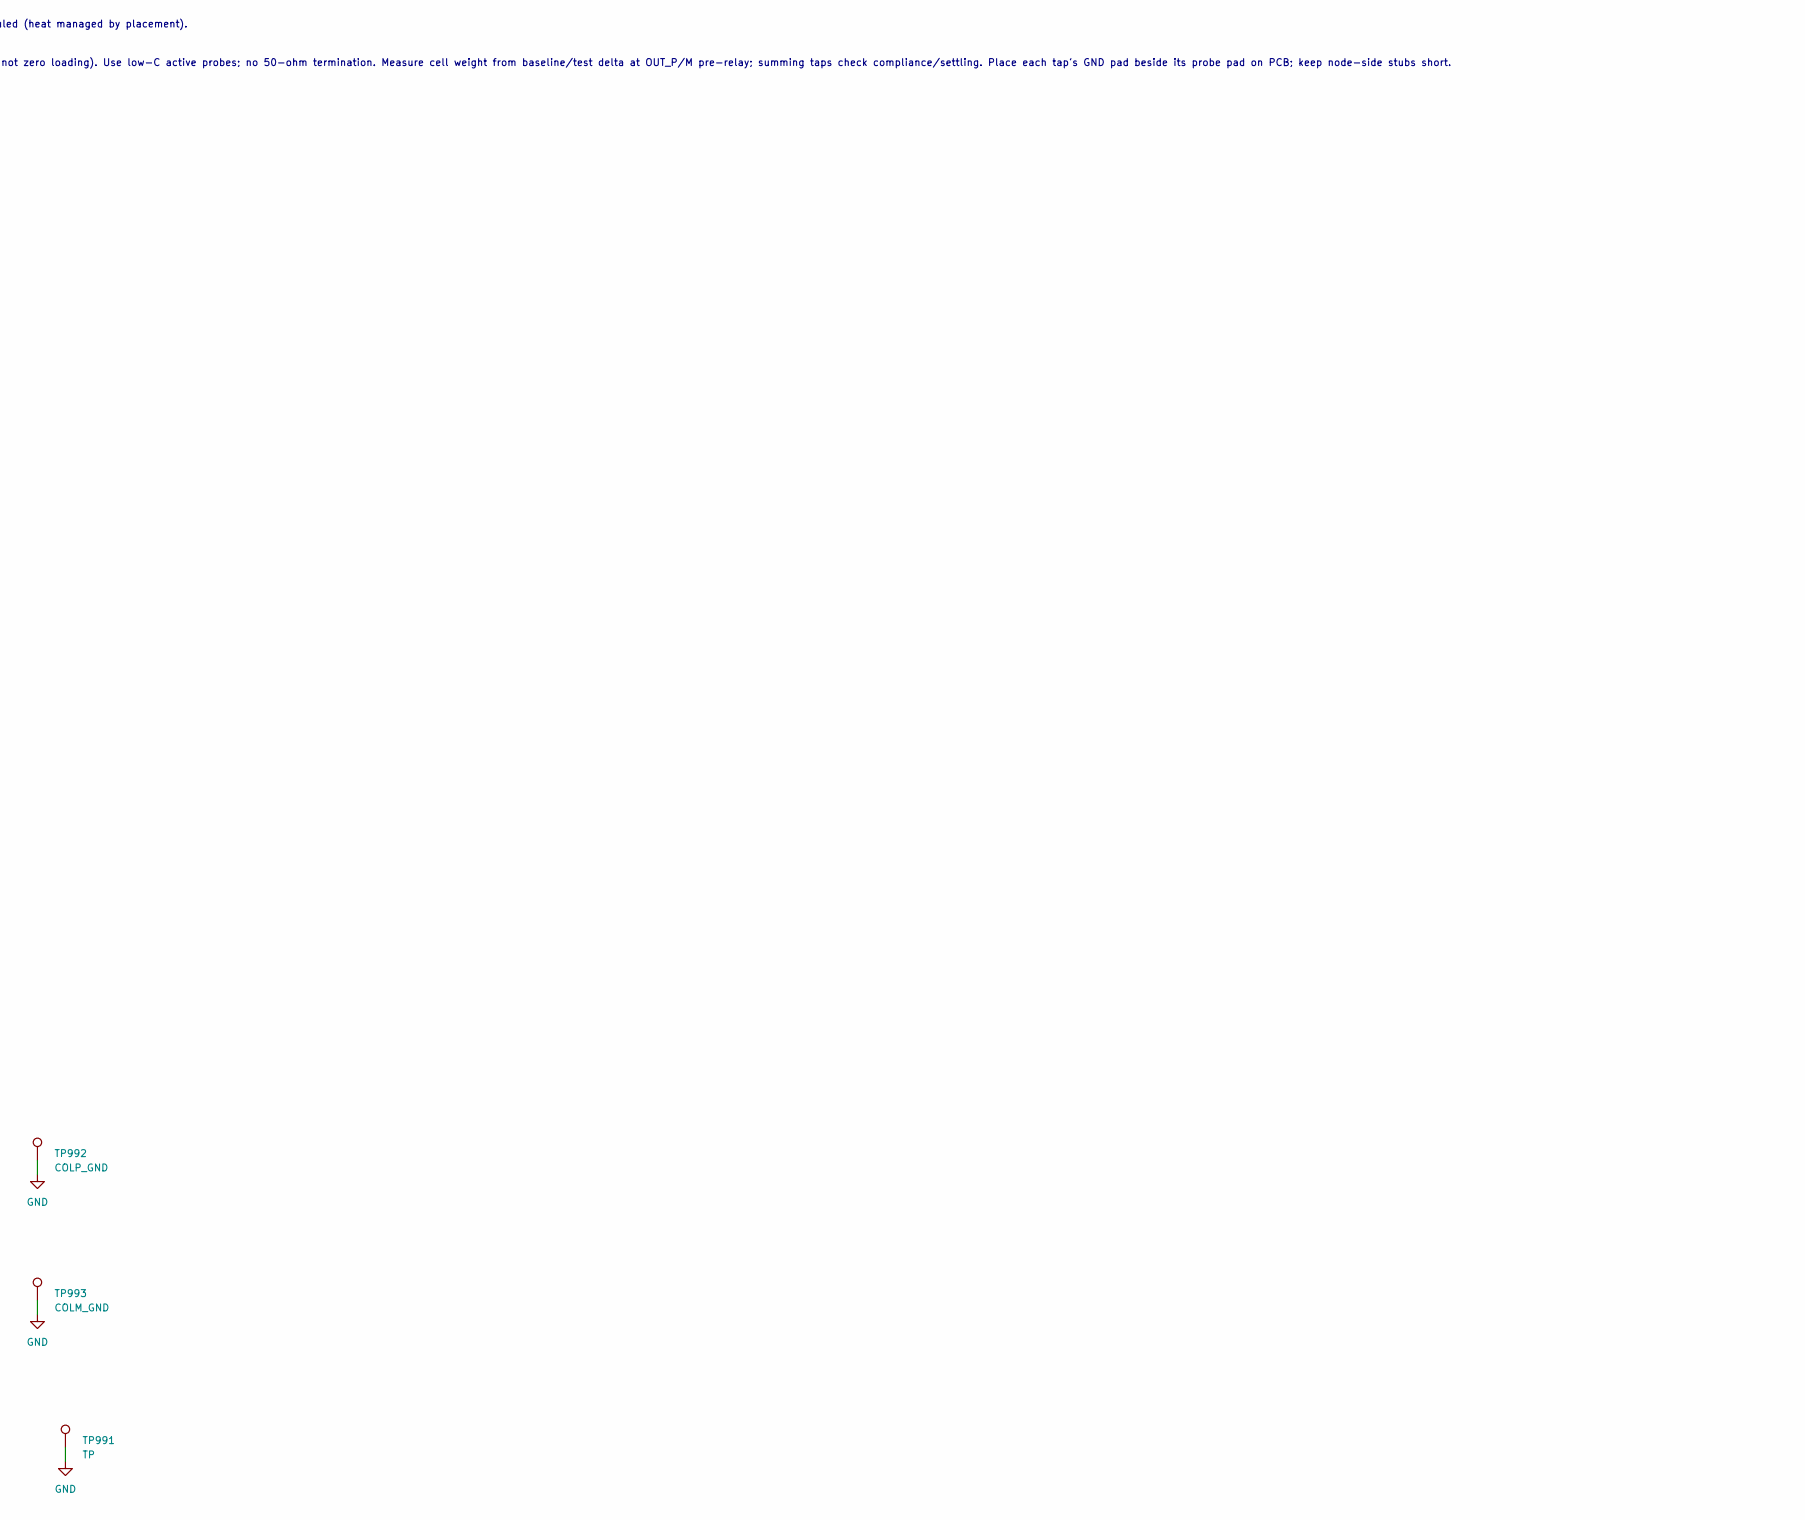
[picture p20: schematic iv.kicad_sch, part in row 1, column 2]

Parts:
C21, C22: 12n; C_0805_2012Metric; MPN GRM2165C1H123JA01D
C23, C24: 1.3n; C_0603_1608Metric; MPN GRM1885C1H132JA01D
C40, C41, C42, C43, C50, C51, C52, C53: 100n; C_0603_1608Metric; MPN GRM188R71H104KA93D
C685, C686, C689: 10u; C_1206_3216Metric; MPN GRM31CR71E106KA12L
C687: 4.7u; C_0805_2012Metric; MPN GRM21BR71E475KA73L
C688: 1n; C_0603_1608Metric; MPN GRM1885C1H102JA01D
C690: 100u; CP_Radial_D6.3mm_P2.50mm; MPN UKL1C101MED
FB685: 600R@100MHz; L_0603_1608Metric; MPN BLM18PG601SN1D
R21, R25, R27, R29: 536; R_0603_1608Metric; MPN RA73F1J536RBTD
R22, R26, R28, R30: 464; R_0603_1608Metric; MPN RA73F1J464RBTD
R23, R24: 270; R_1206_3216Metric; MPN RG3216N-2700-W-T1
R685: 150k; R_0603_1608Metric; MPN RG1608N-1503-W-T1
R686: 442k; R_0603_1608Metric; MPN RG1608N-4423-W-T1
R687: 10k; R_0603_1608Metric; MPN RG1608N-1002-W-T1
R688, R689: 1.00k; R_0603_1608Metric; MPN TNPW06031K00FEEA
TP980, TP981, TP982, TP983, TP984, TP990, TP991: TP; TestPoint_THTPad_2.0x2.0mm_Drill1.0mm
TP985, TP986, TP987, TP988: TP; TestPoint_Pad_1.0x1.0mm
TP992: COLP_GND; TestPoint_Pad_1.0x1.0mm
TP993: COLM_GND; TestPoint_Pad_1.0x1.0mm
U1, U2: OPA1612; TI_OPA1612_DRG_WSON-8_3x3mm_P0.5mm_EP1.2x2.0mm; MPN OPA1612AIDRGR
U3, U4: BUF634A; TI_BUF634A_DDA_HSOIC-8_P1.27mm_EP2.95x4.9mm; MPN BUF634AIDDAR
U685: LT3045; MSOP-12-1EP_3x4.039mm_P0.65mm_EP1.651x2.845mm_ThermalVias; MPN LT3045EMSE#PBF

Connections:
COL_M_L: C22.1, C24.2, R22.2, R24.2, R26.2, R28.2, R30.2, R689.1, U2.2 (-)
COL_P_L: C21.1, C23.2, R21.2, R23.2, R25.2, R27.2, R29.2, R688.1, U1.2 (-)
GND: C21.2, C22.2, C40.2, C41.2, C42.2, C43.2, C50.2, C51.2, C52.2, C53.2, C685.2, C686.2, C687.2, C688.2, C689.2, C690.2, R685.2, R687.2, TP990.1, TP991.1, TP992.1, TP993.1, U1.5 (+), U2.5 (+), U685.6 (ILIM), U685.9 (GND), U685.13 (GND)
N15A_L: C41.1, C43.1, C51.1, C53.1, TP982.1, U1.4 (V-), U2.4 (V-), U3.1 (BW), U3.4 (V-), U4.1 (BW), U4.4 (V-)
OA_M: U2.1, U4.3 (V_{IN})
OA_P: U1.1, U3.3 (V_{IN})
OUT_M_L: C24.1, R24.1, TP986.1, U4.6
OUT_P_L: C23.1, R23.1, TP985.1, U3.6
P15A_L: C40.1, C42.1, C50.1, C52.1, TP983.1, U1.8 (V+), U2.8 (V+), U3.7 (V+), U4.7 (V+)
P16A: C685.1, TP981.1, U685.1 (IN), U685.2 (IN), U685.3 (IN), U685.4 (EN/UV)
PGF_U685: C688.1, R686.2, R687.1, U685.7 (PGFB)
PG_ALL: U685.5 (PG)
SET_U685: C687.1, R685.1, U685.8 (SET)
SPARE_M: U2.6 (-), U2.7
SPARE_P: U1.6 (-), U1.7
TP_COLM: R689.2, TP988.1
TP_COLP: R688.2, TP987.1
VROFF_RAW: C686.1, FB685.1, R686.1, U685.10 (OUTS), U685.11 (OUT), U685.12 (OUT)
V_ROFF_L: C689.1, C690.1, FB685.2, R21.1, R22.1, R25.1, R26.1, R27.1, R28.1, R29.1, R30.1, TP980.1
V_VG_L: TP984.1, U1.3 (+), U2.3 (+)

Notes on the sheet:
P5 TIA (bom 4): OPA1612 front amp, BUF634A in the loop, C_f on the buffer output. R_off 133/116 (MIDCODE 32.5) realised as 4 x 536 / 4 x 464 in parallel (TE RA73 0603 AlN 0.5 W, 0.1 % 25 ppm thin film, enlarged copper): ~11 V x 83/95 mA = 0.9/1.0 W per rail, 46/52 % per leg - bom items 13/14 ruled 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
R_f RG3216N 0.05 %; C_f/C_col C0G. 100n decoupling per supply pin is kicad-only (not in the deck). Footprints/MPNs: parts pass 2026-09-28.
U1 / U3 decoupling
U2 / U4 decoupling
V_ROFF LDO (U685): LT3045 from P16A, +15.0 V / 180 mA into the R_off strings; BLM18PG601 + bulk = R9a/FB9/C9 filter (17(l)). PG -> PG_ALL (wired-AND); PGFB 442k/10k trips at -10 %.
PER-CELL TEST: COL_P/COL_M taps on EACH channel are through 1k (reduced, not zero loading). Use low-C active probes; no 50-ohm termination. Measure cell weight from baseline/test delta at OUT_P/M pre-relay; summing taps check compliance/settling. Place each tap's GND pad beside its probe pad on PCB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
