ccroswhite/BFDAC/hw/kicad/iv_r.kicad_sch

## KiCad design hw/kicad/iv_r.kicad_sch (2026-11-04)

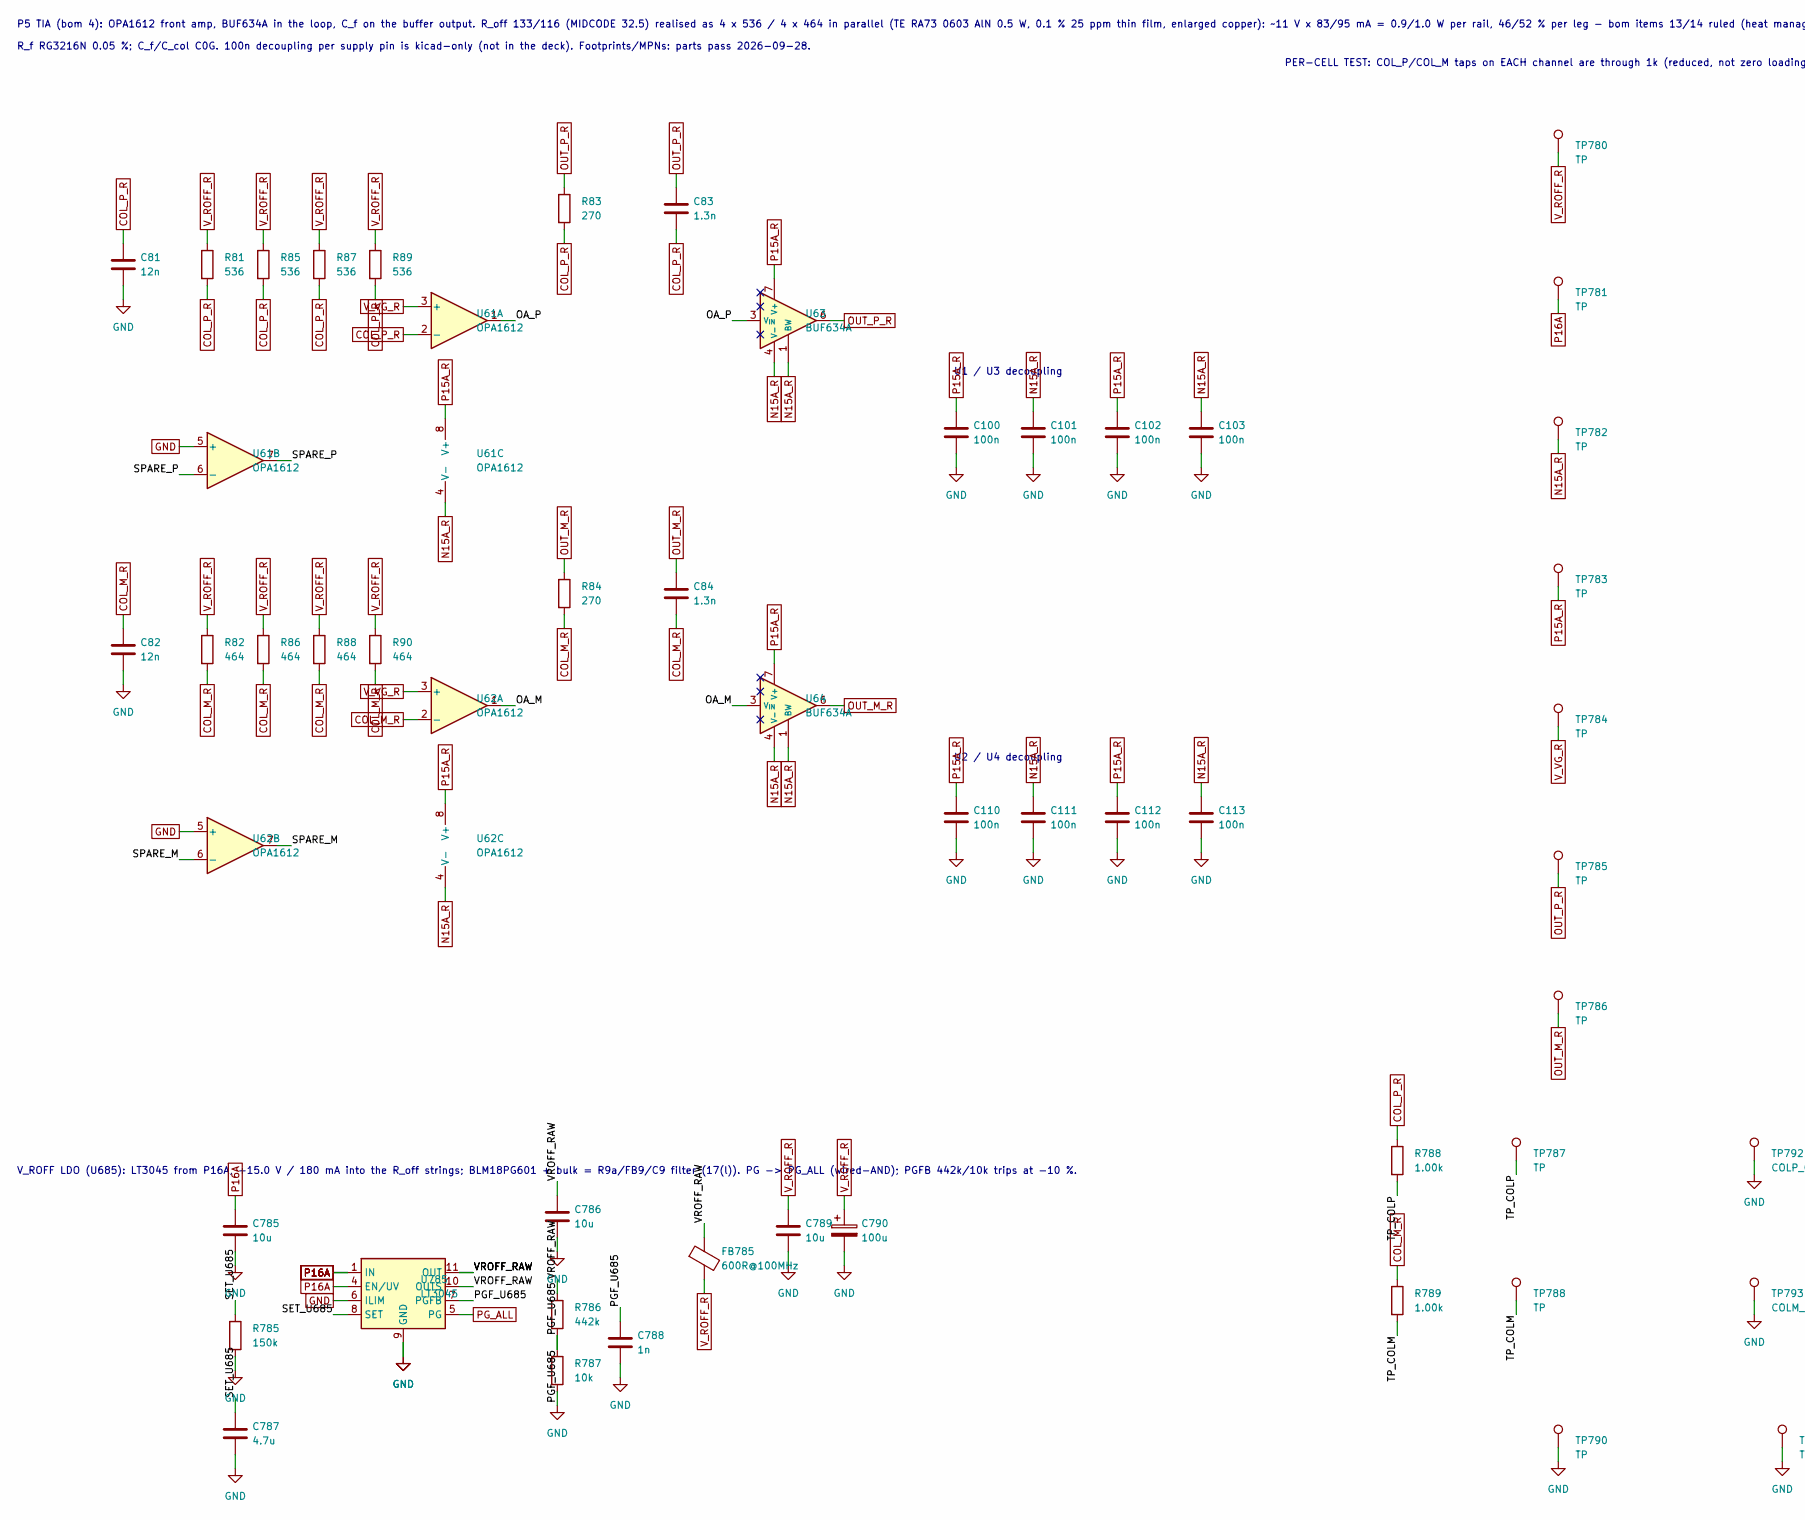
[picture p21: schematic iv_r.kicad_sch, part in row 1, column 1]

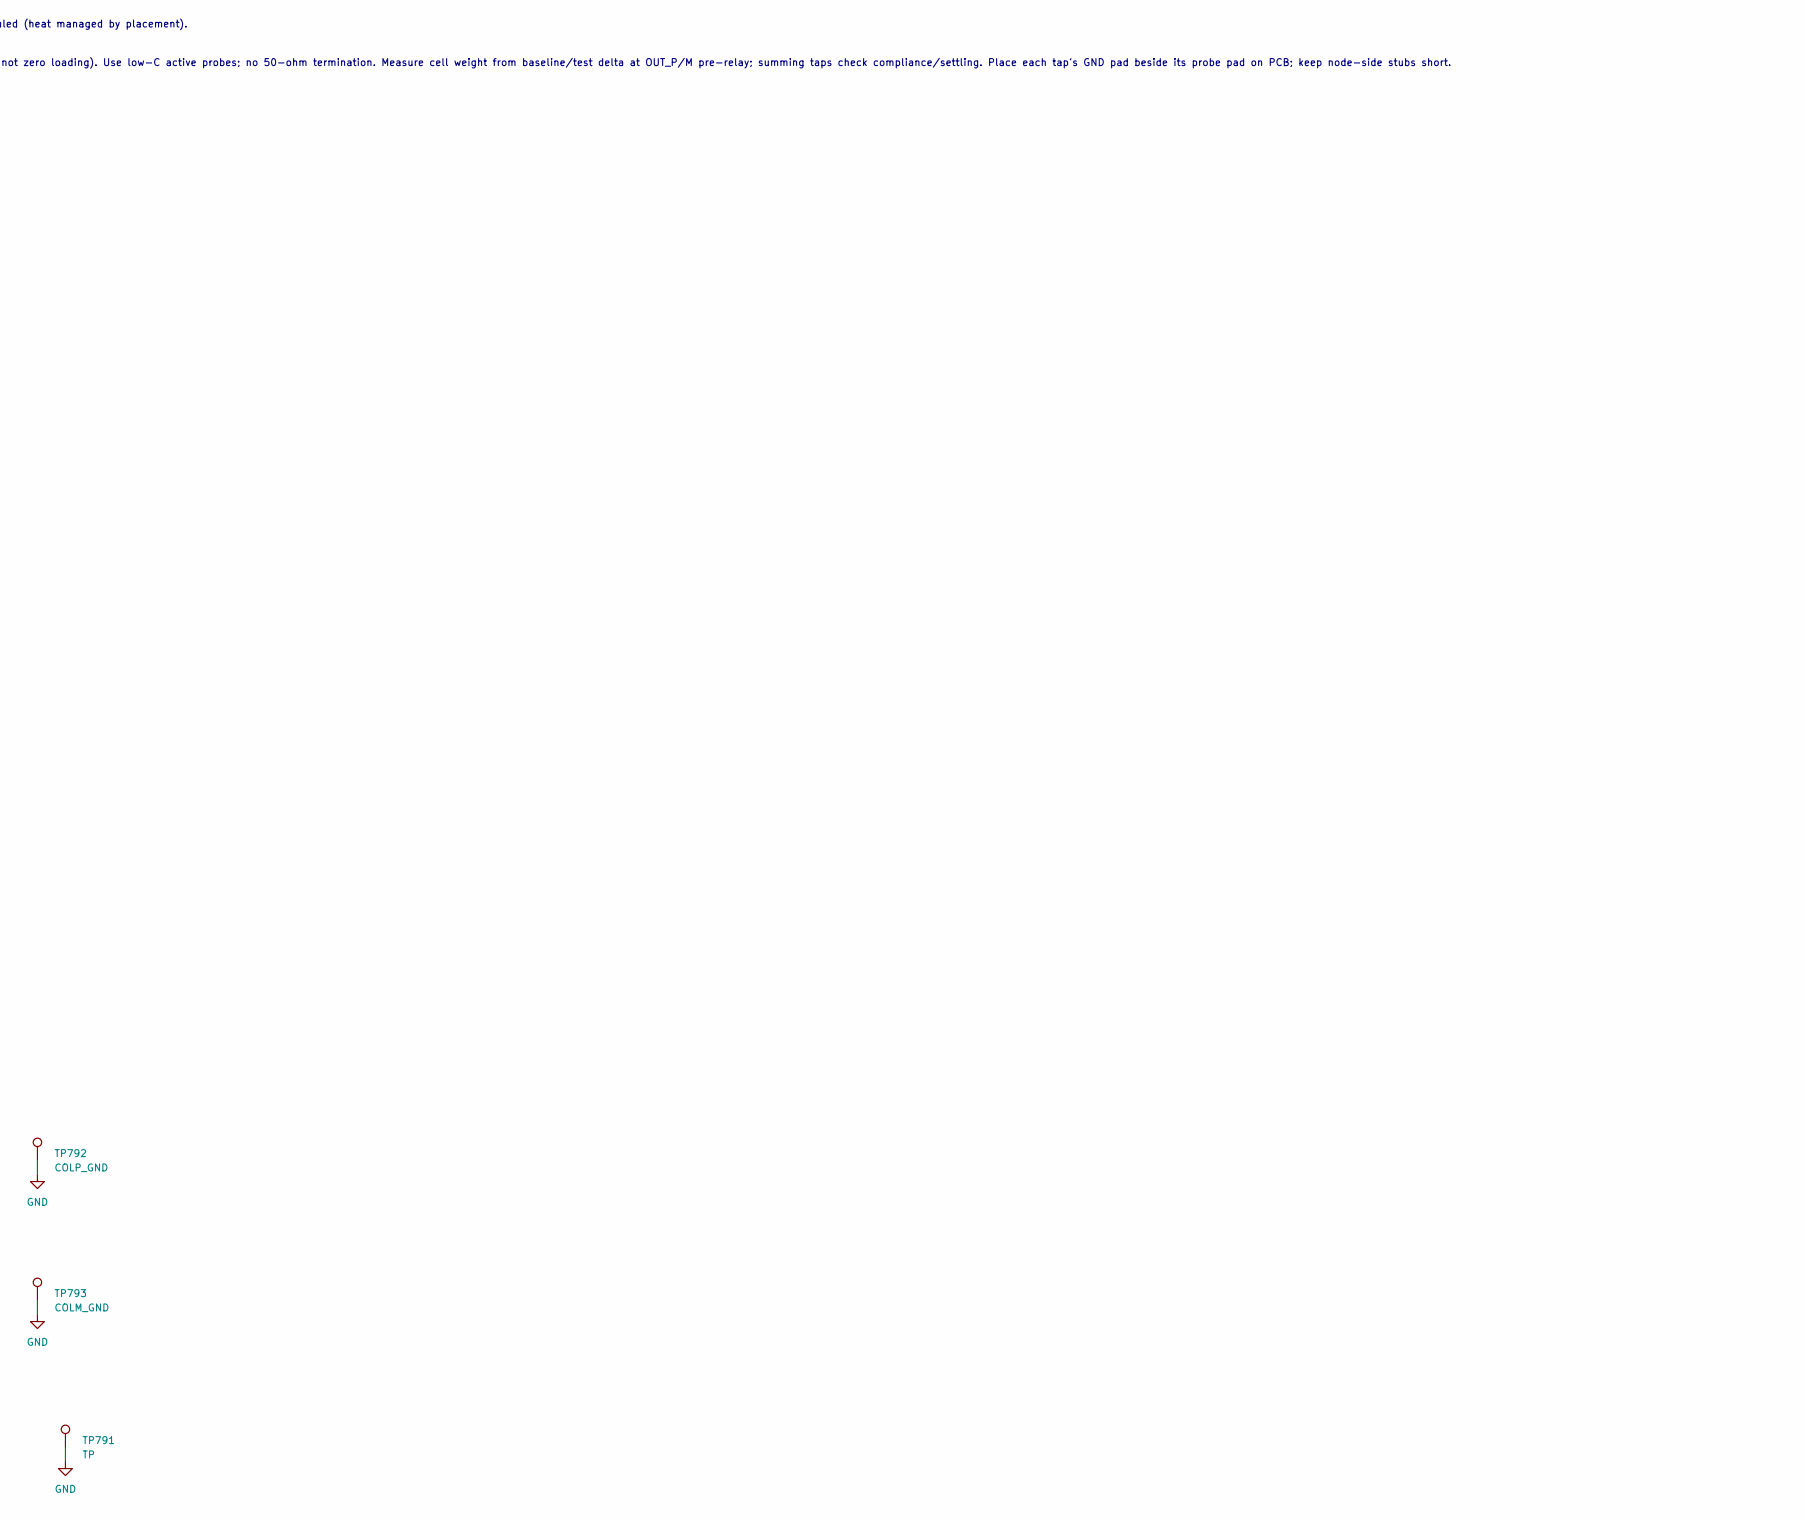
[picture p22: schematic iv_r.kicad_sch, part in row 1, column 2]

Parts:
C81, C82: 12n; C_0805_2012Metric; MPN GRM2165C1H123JA01D
C83, C84: 1.3n; C_0603_1608Metric; MPN GRM1885C1H132JA01D
C100, C101, C102, C103, C110, C111, C112, C113: 100n; C_0603_1608Metric; MPN GRM188R71H104KA93D
C785, C786, C789: 10u; C_1206_3216Metric; MPN GRM31CR71E106KA12L
C787: 4.7u; C_0805_2012Metric; MPN GRM21BR71E475KA73L
C788: 1n; C_0603_1608Metric; MPN GRM1885C1H102JA01D
C790: 100u; CP_Radial_D6.3mm_P2.50mm; MPN UKL1C101MED
FB785: 600R@100MHz; L_0603_1608Metric; MPN BLM18PG601SN1D
R81, R85, R87, R89: 536; R_0603_1608Metric; MPN RA73F1J536RBTD
R82, R86, R88, R90: 464; R_0603_1608Metric; MPN RA73F1J464RBTD
R83, R84: 270; R_1206_3216Metric; MPN RG3216N-2700-W-T1
R785: 150k; R_0603_1608Metric; MPN RG1608N-1503-W-T1
R786: 442k; R_0603_1608Metric; MPN RG1608N-4423-W-T1
R787: 10k; R_0603_1608Metric; MPN RG1608N-1002-W-T1
R788, R789: 1.00k; R_0603_1608Metric; MPN TNPW06031K00FEEA
TP780, TP781, TP782, TP783, TP784, TP790, TP791: TP; TestPoint_THTPad_2.0x2.0mm_Drill1.0mm
TP785, TP786, TP787, TP788: TP; TestPoint_Pad_1.0x1.0mm
TP792: COLP_GND; TestPoint_Pad_1.0x1.0mm
TP793: COLM_GND; TestPoint_Pad_1.0x1.0mm
U61, U62: OPA1612; TI_OPA1612_DRG_WSON-8_3x3mm_P0.5mm_EP1.2x2.0mm; MPN OPA1612AIDRGR
U63, U64: BUF634A; TI_BUF634A_DDA_HSOIC-8_P1.27mm_EP2.95x4.9mm; MPN BUF634AIDDAR
U785: LT3045; MSOP-12-1EP_3x4.039mm_P0.65mm_EP1.651x2.845mm_ThermalVias; MPN LT3045EMSE#PBF

Connections:
COL_M_R: C82.1, C84.2, R82.2, R84.2, R86.2, R88.2, R90.2, R789.1, U62.2 (-)
COL_P_R: C81.1, C83.2, R81.2, R83.2, R85.2, R87.2, R89.2, R788.1, U61.2 (-)
GND: C81.2, C82.2, C100.2, C101.2, C102.2, C103.2, C110.2, C111.2, C112.2, C113.2, C785.2, C786.2, C787.2, C788.2, C789.2, C790.2, R785.2, R787.2, TP790.1, TP791.1, TP792.1, TP793.1, U61.5 (+), U62.5 (+), U785.6 (ILIM), U785.9 (GND), U785.13 (GND)
N15A_R: C101.1, C103.1, C111.1, C113.1, TP782.1, U61.4 (V-), U62.4 (V-), U63.1 (BW), U63.4 (V-), U64.1 (BW), U64.4 (V-)
OA_M: U62.1, U64.3 (V_{IN})
OA_P: U61.1, U63.3 (V_{IN})
OUT_M_R: C84.1, R84.1, TP786.1, U64.6
OUT_P_R: C83.1, R83.1, TP785.1, U63.6
P15A_R: C100.1, C102.1, C110.1, C112.1, TP783.1, U61.8 (V+), U62.8 (V+), U63.7 (V+), U64.7 (V+)
P16A: C785.1, TP781.1, U785.1 (IN), U785.2 (IN), U785.3 (IN), U785.4 (EN/UV)
PGF_U685: C788.1, R786.2, R787.1, U785.7 (PGFB)
PG_ALL: U785.5 (PG)
SET_U685: C787.1, R785.1, U785.8 (SET)
SPARE_M: U62.6 (-), U62.7
SPARE_P: U61.6 (-), U61.7
TP_COLM: R789.2, TP788.1
TP_COLP: R788.2, TP787.1
VROFF_RAW: C786.1, FB785.1, R786.1, U785.10 (OUTS), U785.11 (OUT), U785.12 (OUT)
V_ROFF_R: C789.1, C790.1, FB785.2, R81.1, R82.1, R85.1, R86.1, R87.1, R88.1, R89.1, R90.1, TP780.1
V_VG_R: TP784.1, U61.3 (+), U62.3 (+)

Notes on the sheet:
P5 TIA (bom 4): OPA1612 front amp, BUF634A in the loop, C_f on the buffer output. R_off 133/116 (MIDCODE 32.5) realised as 4 x 536 / 4 x 464 in parallel (TE RA73 0603 AlN 0.5 W, 0.1 % 25 ppm thin film, enlarged copper): ~11 V x 83/95 mA = 0.9/1.0 W per rail, 46/52 % per leg - bom items 13/14 ruled 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
R_f RG3216N 0.05 %; C_f/C_col C0G. 100n decoupling per supply pin is kicad-only (not in the deck). Footprints/MPNs: parts pass 2026-09-28.
U1 / U3 decoupling
U2 / U4 decoupling
V_ROFF LDO (U685): LT3045 from P16A, +15.0 V / 180 mA into the R_off strings; BLM18PG601 + bulk = R9a/FB9/C9 filter (17(l)). PG -> PG_ALL (wired-AND); PGFB 442k/10k trips at -10 %.
PER-CELL TEST: COL_P/COL_M taps on EACH channel are through 1k (reduced, not zero loading). Use low-C active probes; no 50-ohm termination. Measure cell weight from baseline/test delta at OUT_P/M pre-relay; summing taps check compliance/settling. Place each tap's GND pad beside its probe pad on PCB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
