ccroswhite/BFDAC/hw/kicad/out.kicad_sch

## KiCad design hw/kicad/out.kicad_sch (2026-11-04)

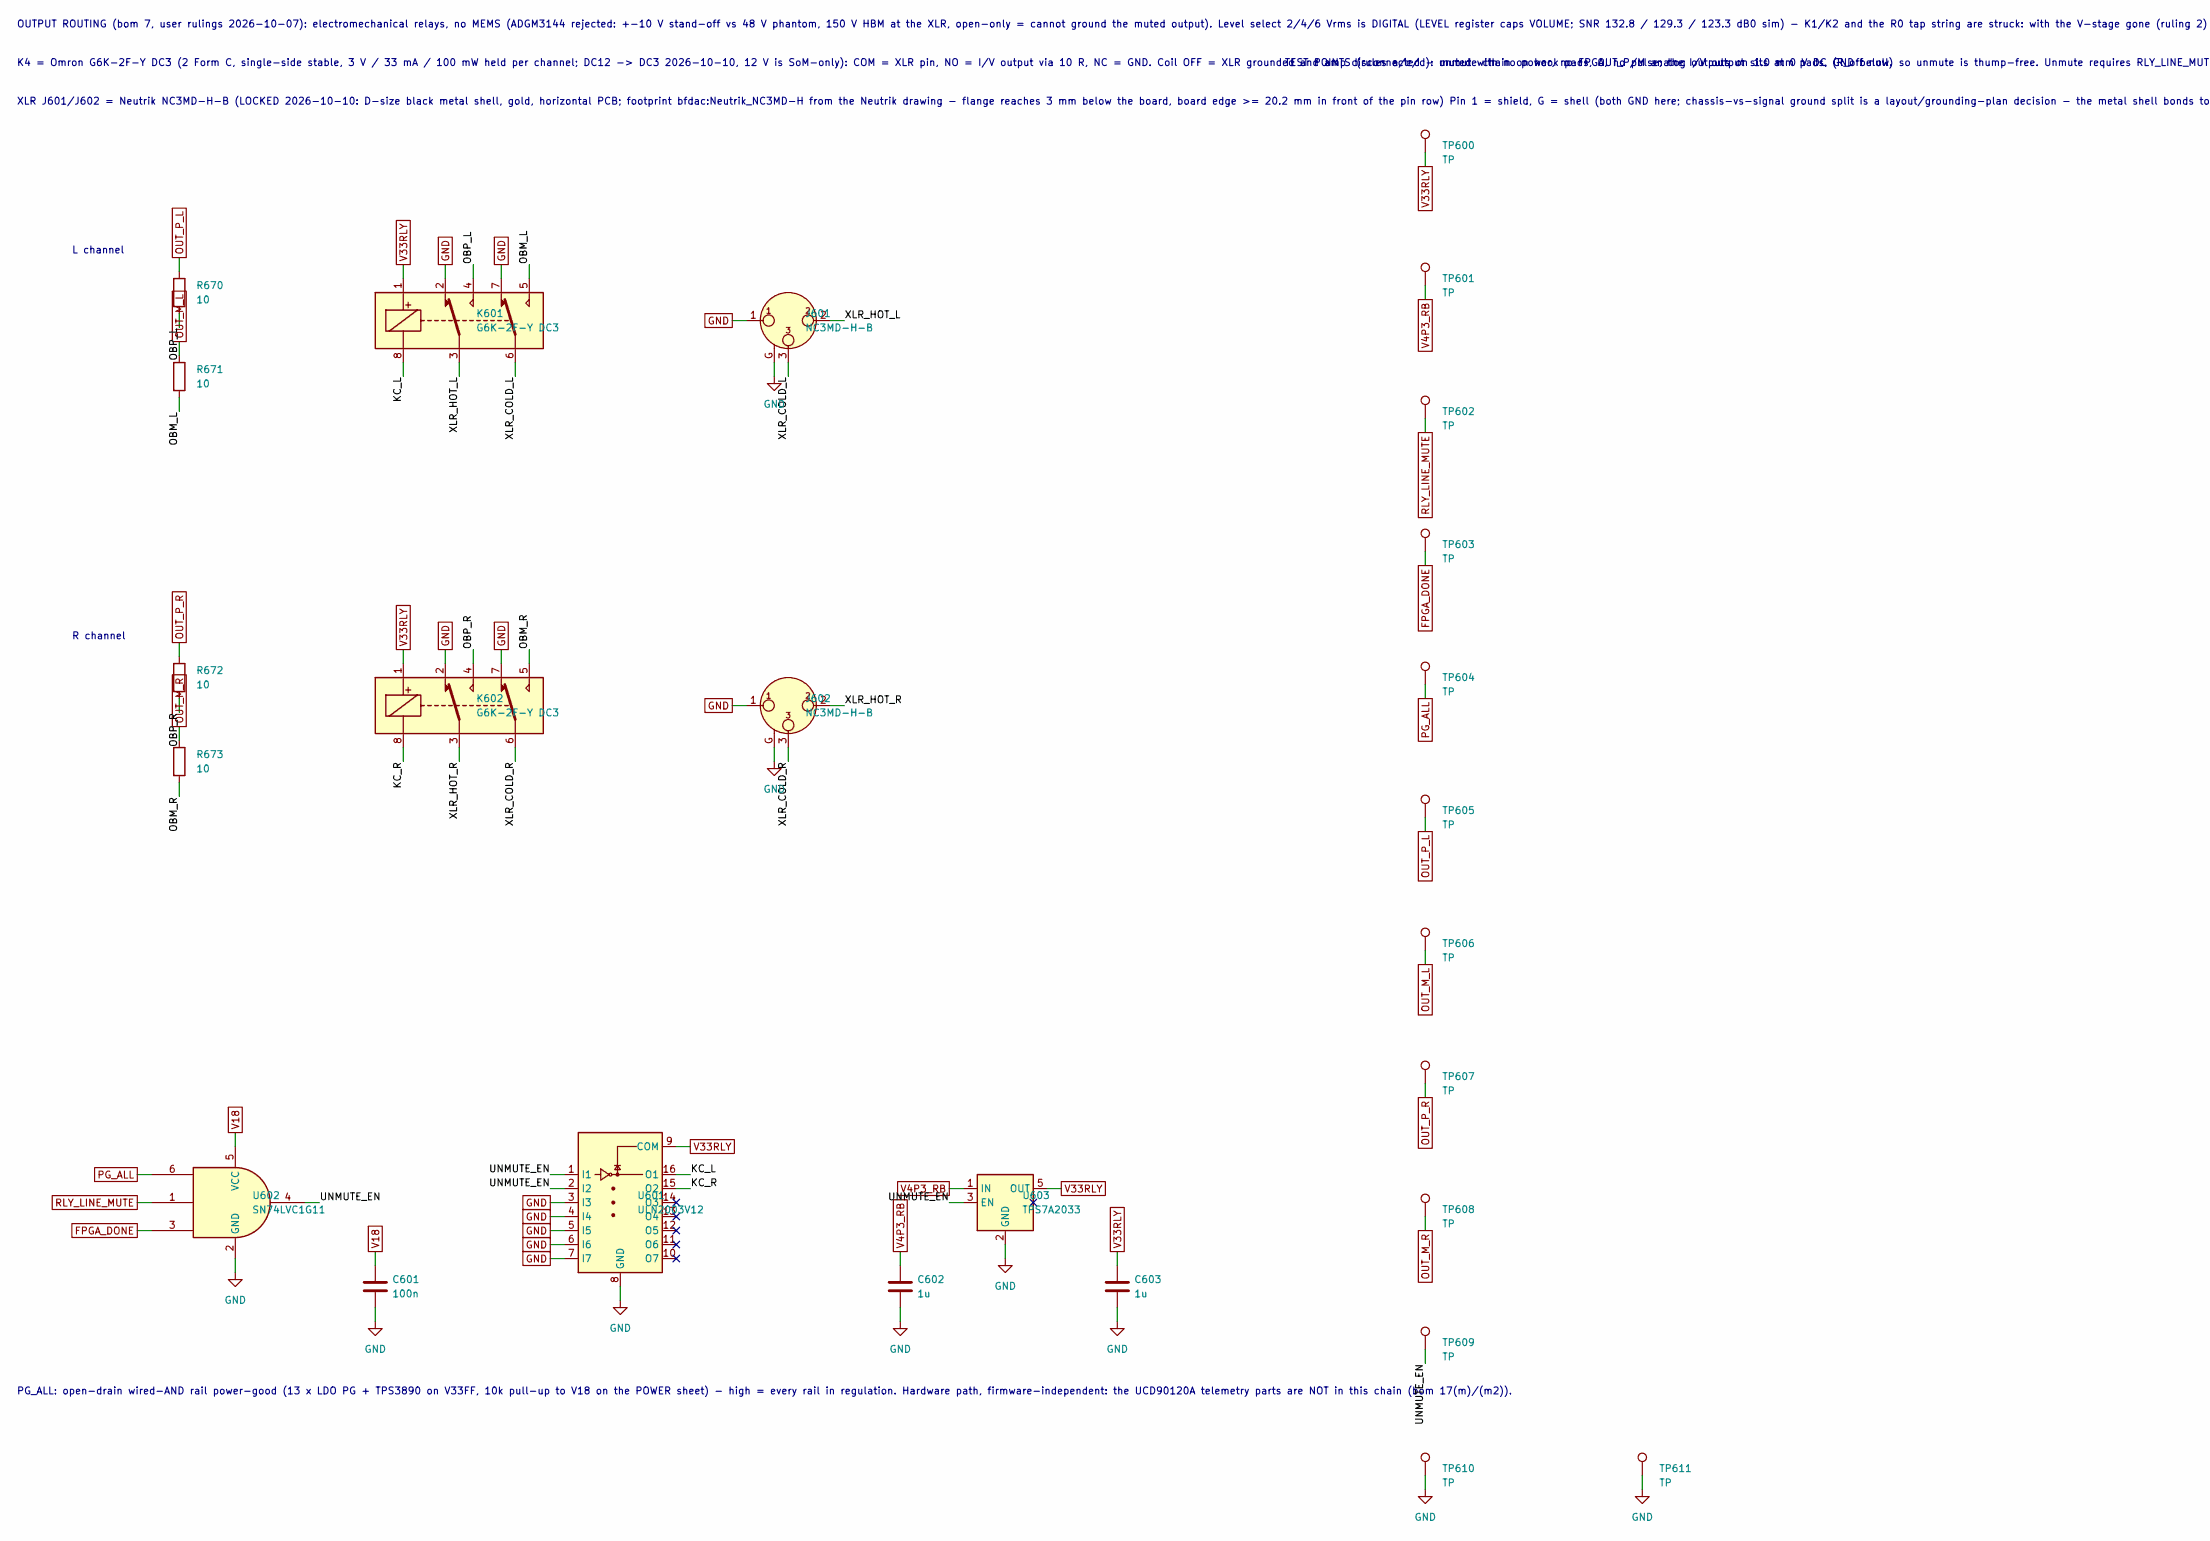
[picture p23: schematic out.kicad_sch, part in row 1, column 1]

Parts:
C601: 100n; C_0603_1608Metric; MPN GRM188R71C104KA01D
C602, C603: 1u; C_0603_1608Metric; MPN GRM188R61E105KA12D
J601, J602: NC3MD-H-B; Neutrik_NC3MD-H; MPN NC3MD-H-B
K601, K602: G6K-2F-Y DC3; Relay_DPDT_Omron_G6K-2F-Y; MPN G6K-2F-Y DC3
R670, R671, R672, R673: 10; R_0603_1608Metric; MPN TNPW060310R0BEEA
TP600, TP601, TP602, TP603, TP604, TP609, TP610, TP611: TP; TestPoint_THTPad_2.0x2.0mm_Drill1.0mm
TP605, TP606, TP607, TP608: TP; TestPoint_Pad_1.0x1.0mm
U601: ULN2003V12; SOIC-16_3.9x9.9mm_P1.27mm; MPN ULN2003V12DR
U602: SN74LVC1G11; SOT-23-6; MPN SN74LVC1G11DBVR
U603: TPS7A2033; SOT-23-5; MPN TPS7A2033PDBVR

Connections:
FPGA_DONE: TP603.1, U602.3
GND: C601.2, C602.2, C603.2, J601.1, J601.G, J602.1, J602.G, K601.2, K601.7, K602.2, K602.7, TP610.1, TP611.1, U601.3 (I3), U601.4 (I4), U601.5 (I5), U601.6 (I6), U601.7 (I7), U601.8 (GND), U602.2 (GND), U603.2 (GND)
KC_L: K601.8, U601.16 (O1)
KC_R: K602.8, U601.15 (O2)
OBM_L: K601.5, R671.2
OBM_R: K602.5, R673.2
OBP_L: K601.4, R670.2
OBP_R: K602.4, R672.2
OUT_M_L: R671.1, TP606.1
OUT_M_R: R673.1, TP608.1
OUT_P_L: R670.1, TP605.1
OUT_P_R: R672.1, TP607.1
PG_ALL: TP604.1, U602.6
RLY_LINE_MUTE: TP602.1, U602.1
UNMUTE_EN: TP609.1, U601.1 (I1), U601.2 (I2), U602.4, U603.3 (EN)
V4P3_RB: C602.1, TP601.1, U603.1 (IN)
V18: C601.1, U602.5 (VCC)
V33RLY: C603.1, K601.1, K602.1, TP600.1, U601.9 (COM), U603.5 (OUT)
XLR_COLD_L: J601.3, K601.6
XLR_COLD_R: J602.3, K602.6
XLR_HOT_L: J601.2, K601.3
XLR_HOT_R: J602.2, K602.3

Notes on the sheet:
OUTPUT ROUTING (bom 7, user rulings 2026-10-07): electromechanical relays, no MEMS (ADGM3144 rejected: +-10 V stand-off vs 48 V phantom, 150 V HBM at the XLR, open-only = cannot ground the muted output). Level select 2/4/6 Vrms is DIGITAL (LEVEL register caps VOLUME; SNR 132.8 / 129.3 / 123.3 dB0 s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
K4 = Omron G6K-2F-Y DC3 (2 Form C, single-side stable, 3 V / 33 mA / 100 mW held per channel; DC12 -> DC3 2026-10-10, 12 V is SoM-only): COM = XLR pin, NO = I/V output via 10 R, NC = GND. Coil OFF = XLR grounded and amp disconnected - muted with no power, no FPGA, no pulse; the I/V output sits at 0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
XLR J601/J602 = Neutrik NC3MD-H-B (LOCKED 2026-10-10: D-size black metal shell, gold, horizontal PCB; footprint bfdac:Neutrik_NC3MD-H from the Neutrik drawing - flange reaches 3 mm below the board, board edge >= 20.2 mm in front of the pin row) Pin 1 = shield, G = shell (both GND here; chassis-vs-s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
L channel
R channel
PG_ALL: open-drain wired-AND rail power-good (13 x LDO PG + TPS3890 on V33FF, 10k pull-up to V18 on the POWER sheet) - high = every rail in regulation. Hardware path, firmware-independent: the UCD90120A telemetry parts are NOT in this chain (bom 17(m)/(m2)).
TEST POINTS (rules a/c/d): unmute chain on hook pads, OUT_P/M analog outputs on 1.0 mm pads, GND below.
