ccroswhite/BFDAC/hw/kicad/power.kicad_sch

## KiCad design hw/kicad/power.kicad_sch (2026-11-04)

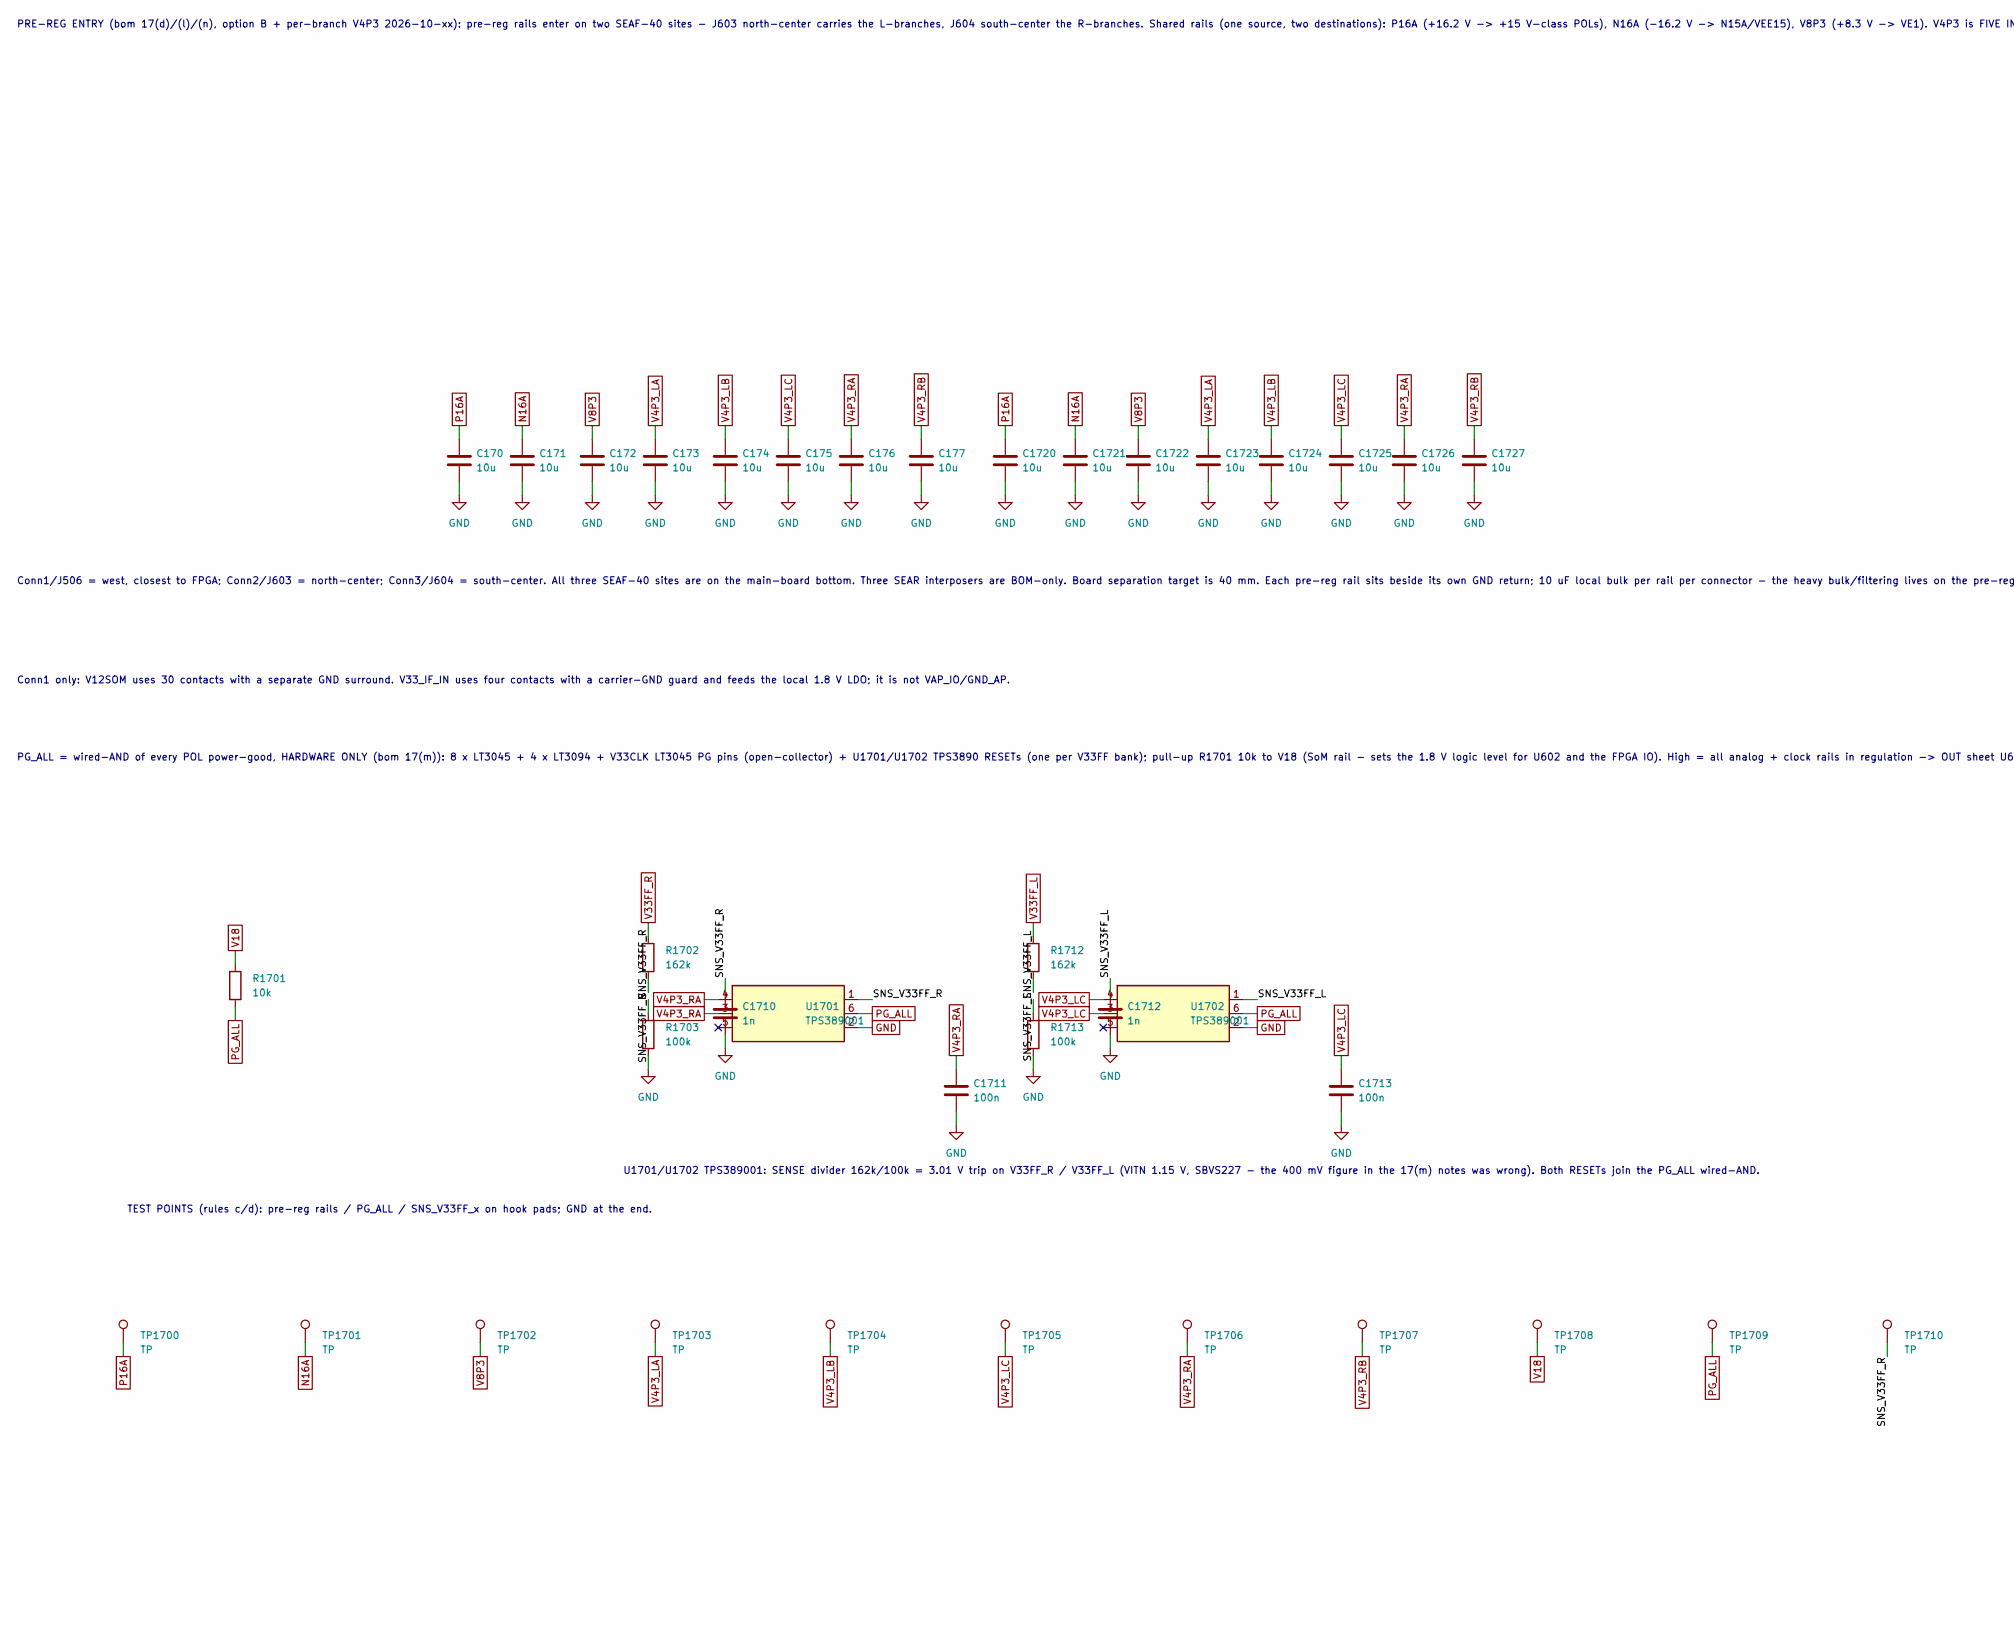
[picture p24: schematic power.kicad_sch, part in row 1, column 1]

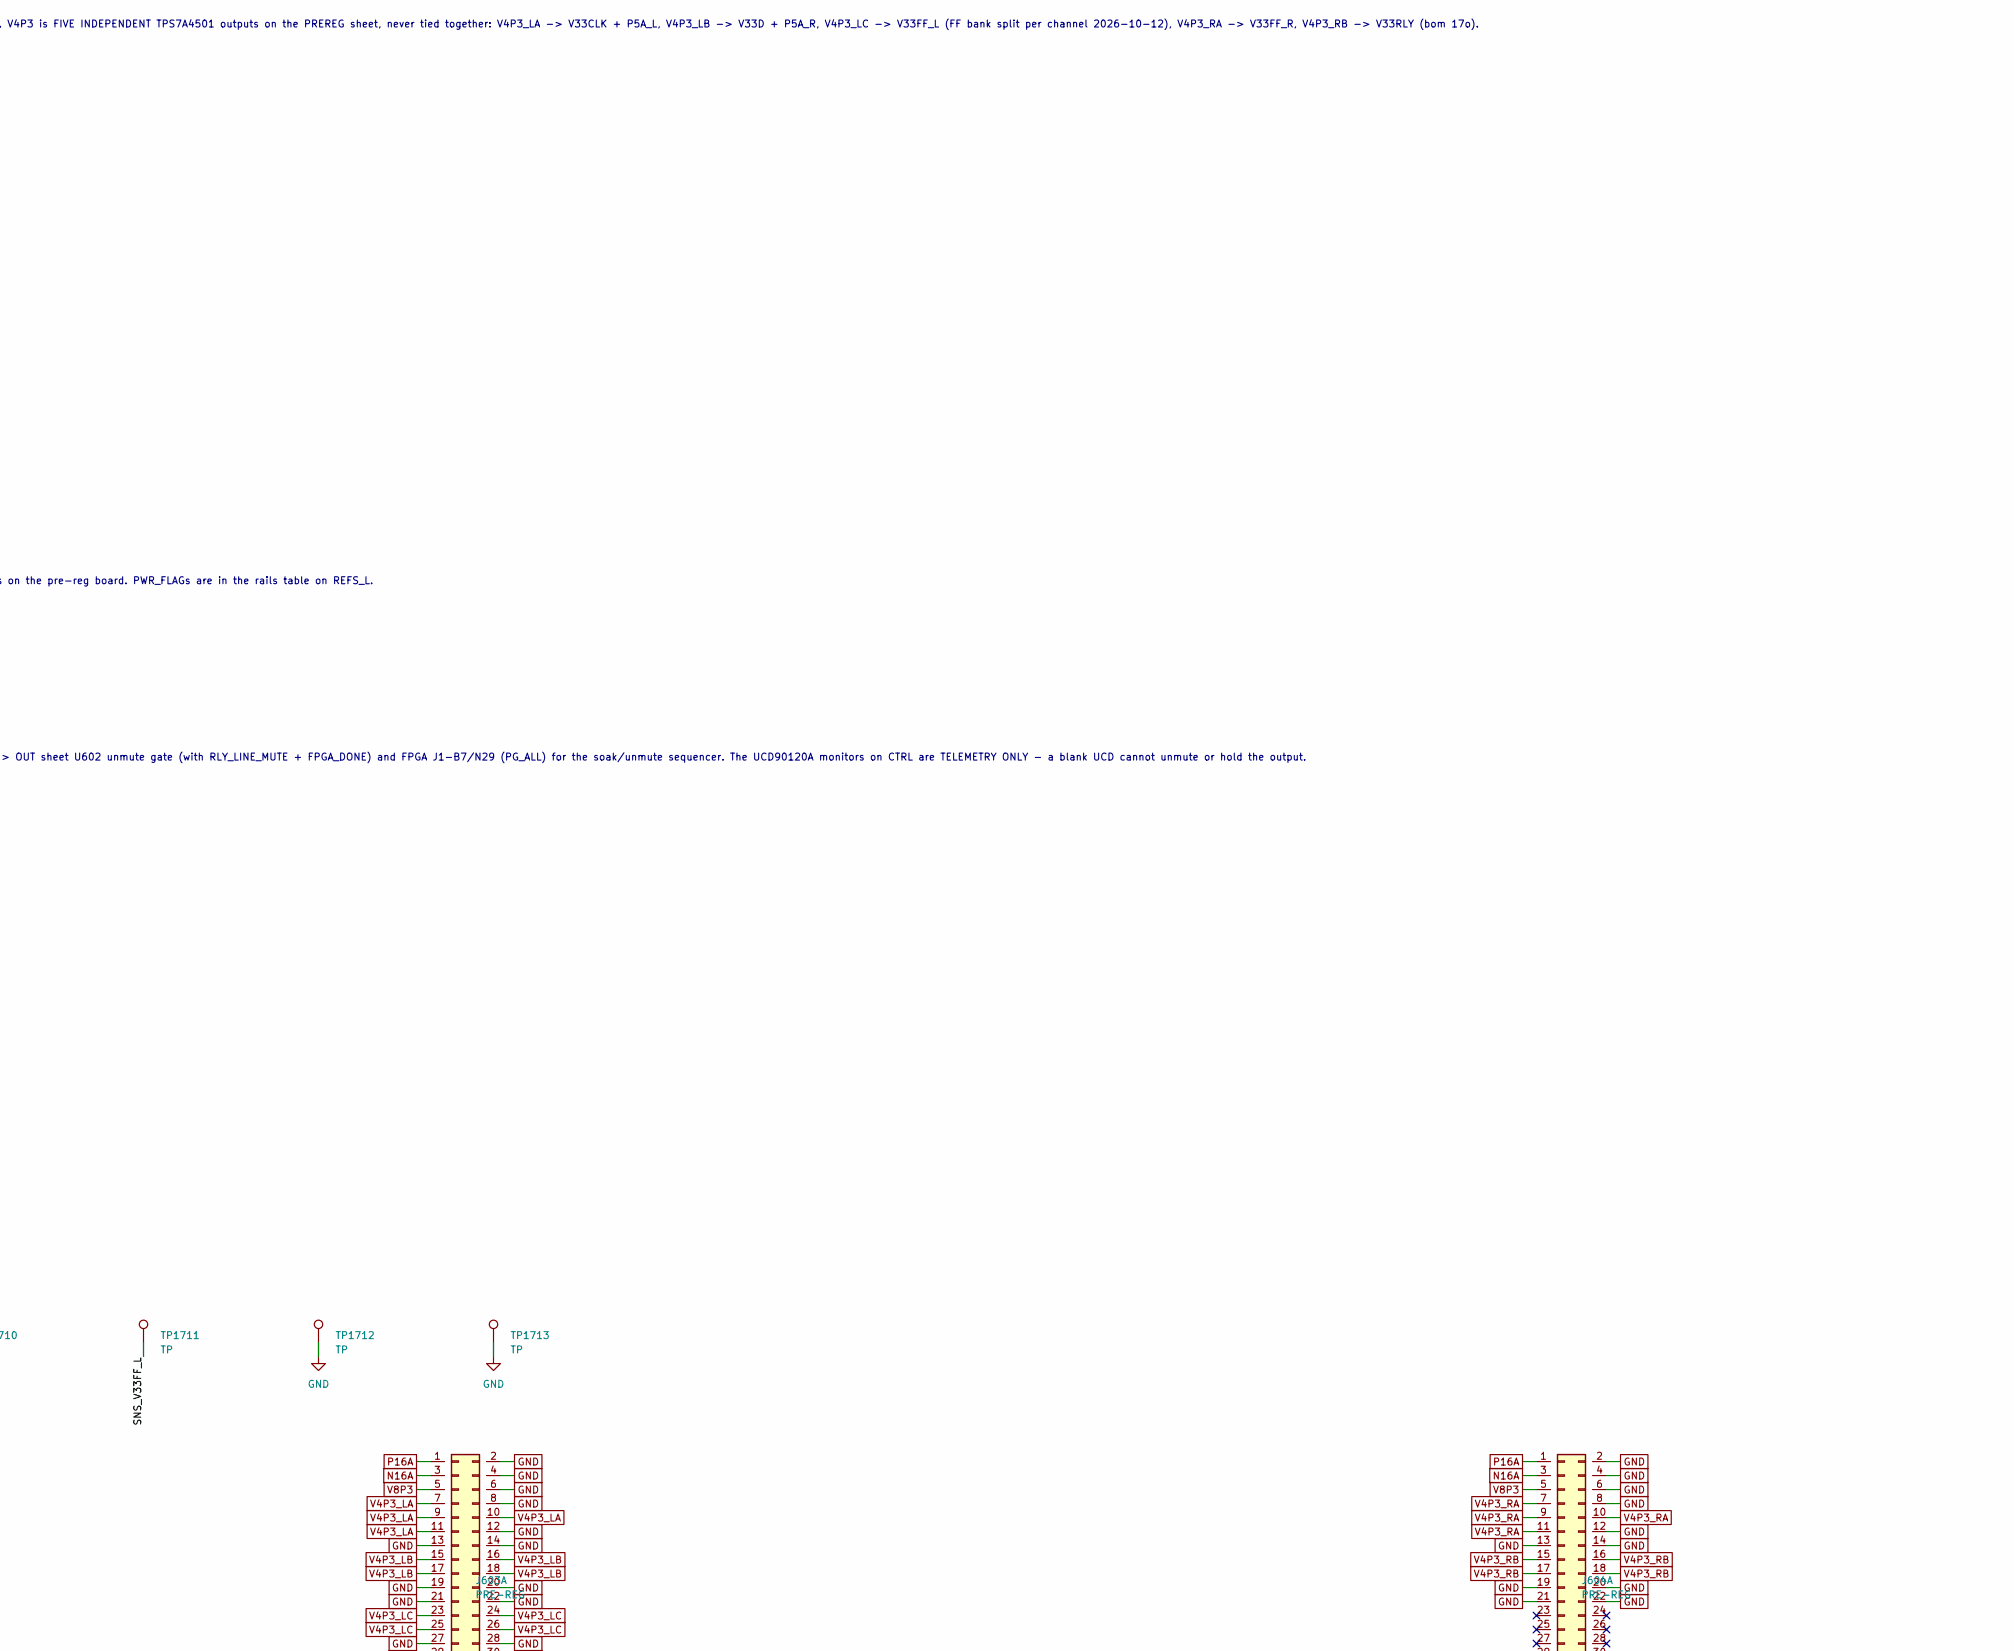
[picture p25: schematic power.kicad_sch, part in row 1, column 2]

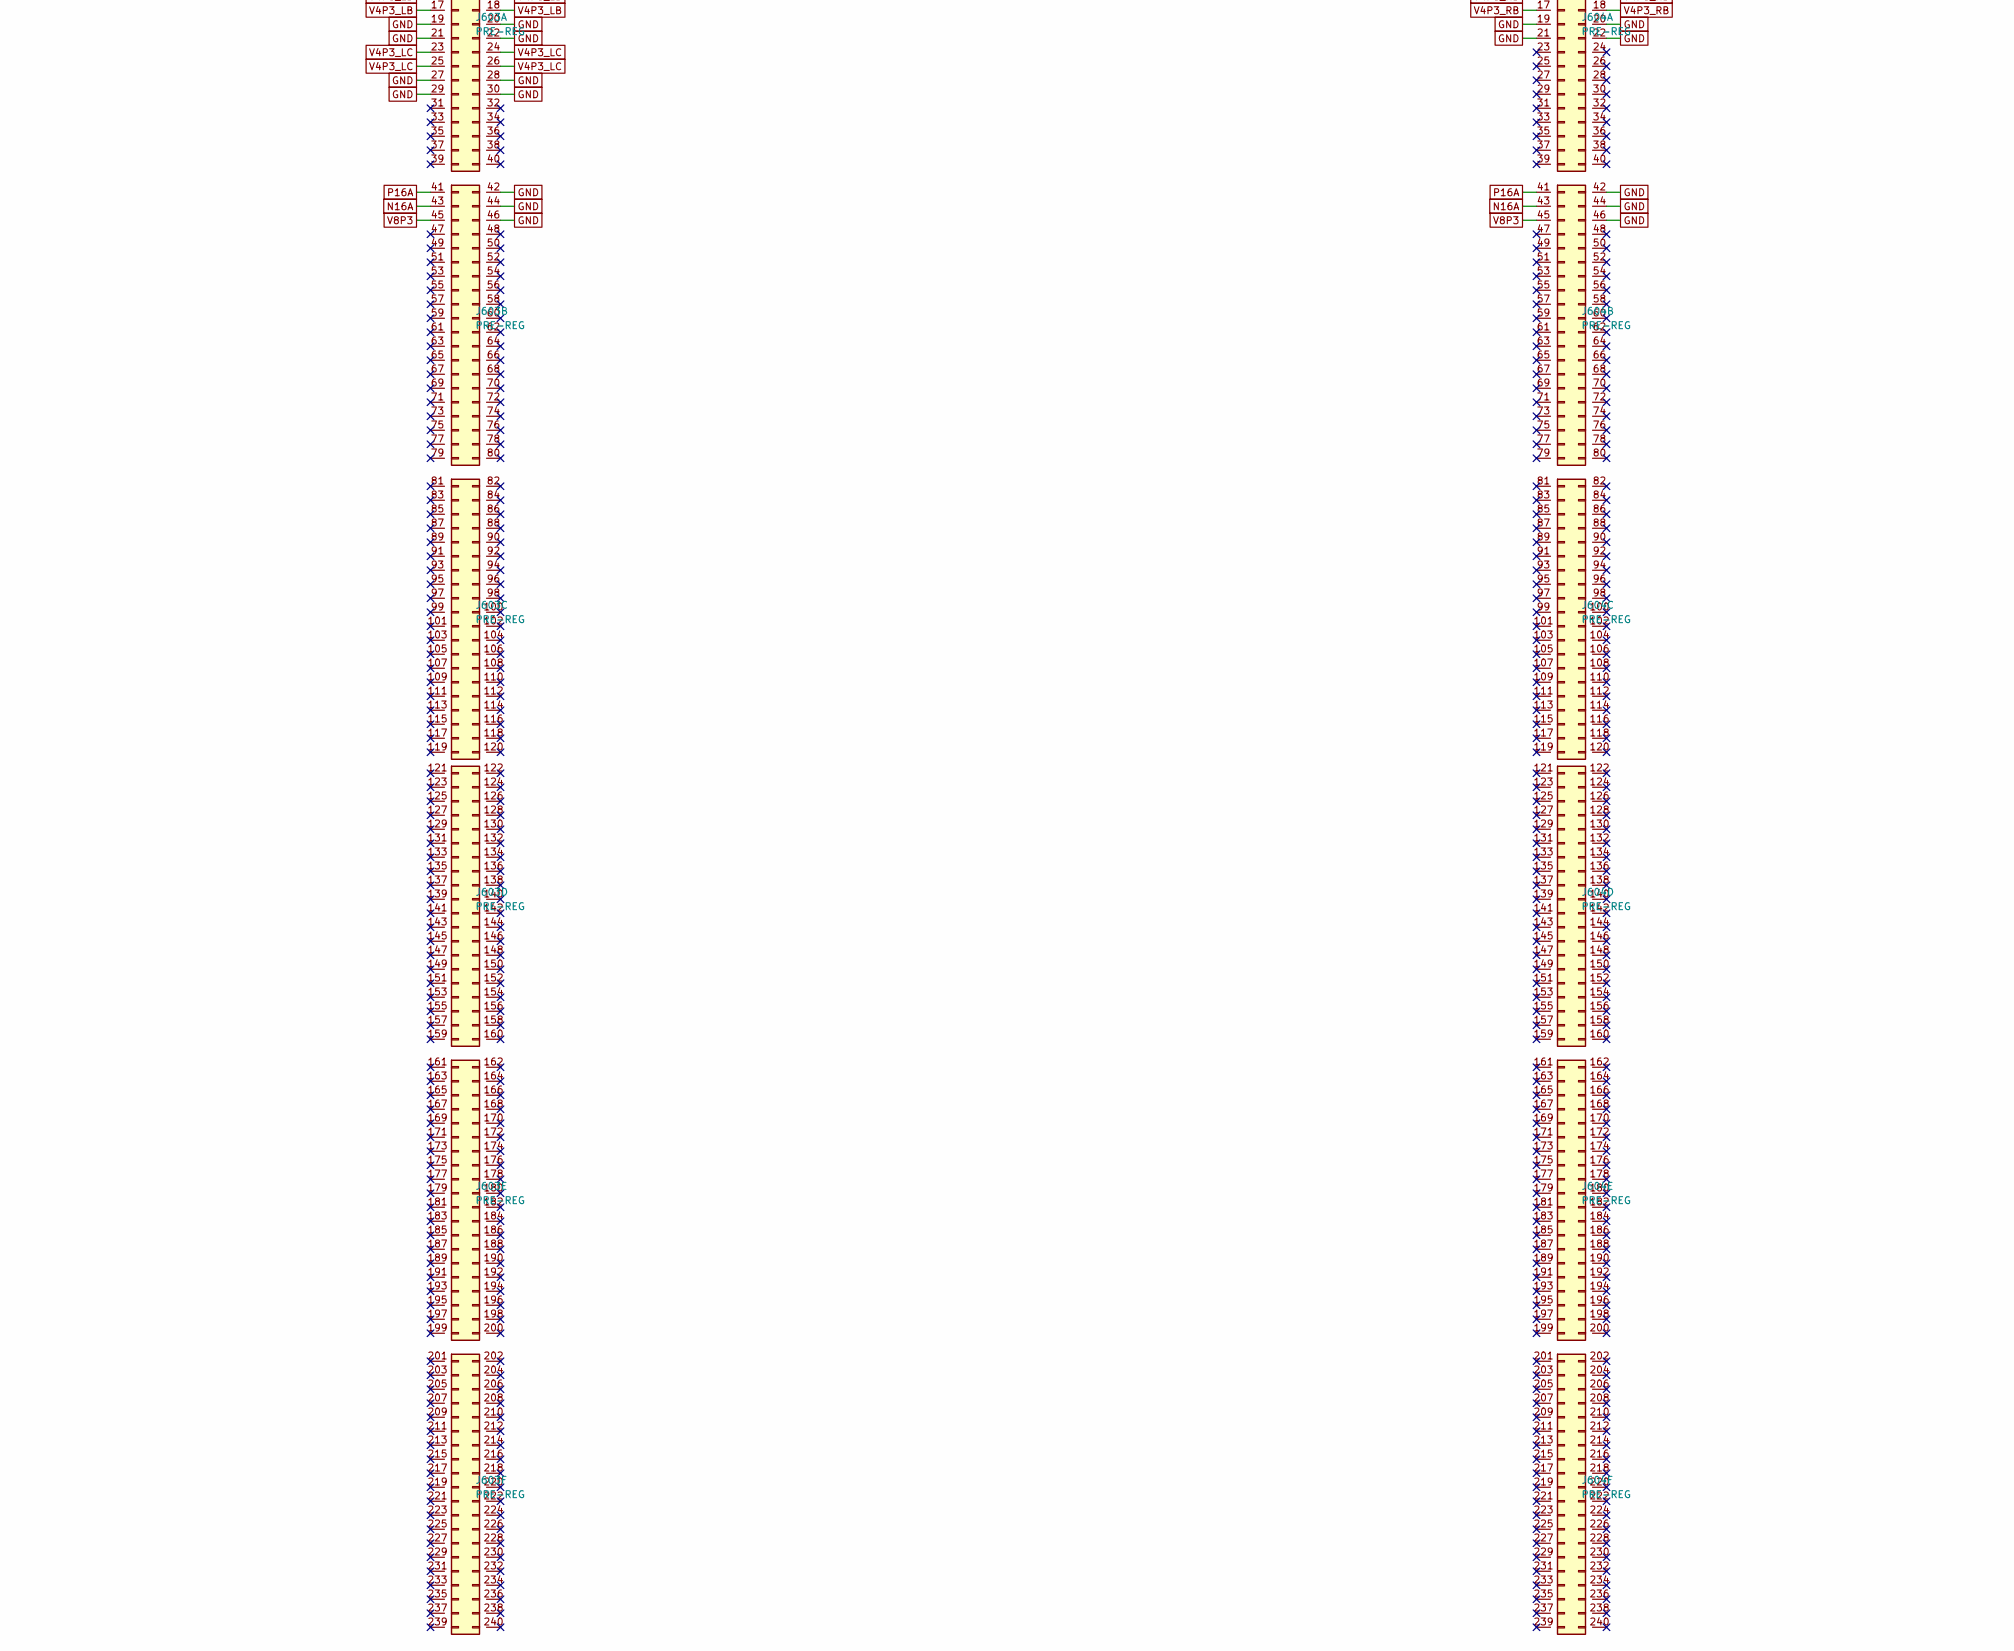
[picture p26: schematic power.kicad_sch, part in row 2, column 2]

Parts:
C170, C171, C172, C173, C174, C175, C176, C177, C1720, C1721, C1722, C1723, C1724, C1725, C1726, C1727: 10u; C_1206_3216Metric; MPN GRM31CR71E106KA12L
C1710, C1712: 1n; C_0603_1608Metric; MPN GRM1885C1H102JA01D
C1711, C1713: 100n; C_0603_1608Metric; MPN GRM188R71C104KA01D
J603, J604: PRE-REG; Samtec_SEAF-40-05.0-L-06-2-A_40x6_P1.27mm; MPN SEAF-40-05.0-L-06-2-A-K-TR
R1701: 10k; R_0603_1608Metric; MPN CRCW060310K0FKEA
R1702, R1712: 162k; R_0603_1608Metric; MPN RG1608N-1623-W-T1
R1703, R1713: 100k; R_0603_1608Metric; MPN RG1608N-1003-W-T1
TP1700, TP1701, TP1702, TP1703, TP1704, TP1705, TP1706, TP1707, TP1708, TP1709, TP1710, TP1711, TP1712, TP1713: TP; TestPoint_THTPad_2.0x2.0mm_Drill1.0mm
U1701, U1702: TPS389001; WSON-6_1.5x1.5mm_P0.5mm; MPN TPS389001DSET

Connections:
GND: C170.2, C171.2, C172.2, C173.2, C174.2, C175.2, C176.2, C177.2, C1710.2, C1711.2, C1712.2, C1713.2, C1720.2, C1721.2, C1722.2, C1723.2, C1724.2, C1725.2, C1726.2, C1727.2, J603.2 (A2), J603.4 (A4), J603.6 (A6), J603.8 (A8), J603.12 (A12), J603.13 (A13), J603.14 (A14), J603.19 (A19), J603.20 (A20), J603.21 (A21), J603.22 (A22), J603.27 (A27), J603.28 (A28), J603.29 (A29), J603.30 (A30), J603.42 (B2), J603.44 (B4), J603.46 (B6), J604.2 (A2), J604.4 (A4), J604.6 (A6), J604.8 (A8), J604.12 (A12), J604.13 (A13), J604.14 (A14), J604.19 (A19), J604.20 (A20), J604.21 (A21), J604.22 (A22), J604.42 (B2), J604.44 (B4), J604.46 (B6), R1703.2, R1713.2, TP1712.1, TP1713.1, U1701.2 (GND), U1702.2 (GND)
N16A: C171.1, C1721.1, J603.3 (A3), J603.43 (B3), J604.3 (A3), J604.43 (B3), TP1701.1
P16A: C170.1, C1720.1, J603.1 (A1), J603.41 (B1), J604.1 (A1), J604.41 (B1), TP1700.1
PG_ALL: R1701.2, TP1709.1, U1701.6 (RESET), U1702.6 (RESET)
SNS_V33FF_L: C1712.1, R1712.2, R1713.1, TP1711.1, U1702.1 (SENSE)
SNS_V33FF_R: C1710.1, R1702.2, R1703.1, TP1710.1, U1701.1 (SENSE)
V4P3_LA: C173.1, C1723.1, J603.7 (A7), J603.9 (A9), J603.10 (A10), J603.11 (A11), TP1703.1
V4P3_LB: C174.1, C1724.1, J603.15 (A15), J603.16 (A16), J603.17 (A17), J603.18 (A18), TP1704.1
V4P3_LC: C175.1, C1713.1, C1725.1, J603.23 (A23), J603.24 (A24), J603.25 (A25), J603.26 (A26), TP1705.1, U1702.3 (MR), U1702.4 (VDD)
V4P3_RA: C176.1, C1711.1, C1726.1, J604.7 (A7), J604.9 (A9), J604.10 (A10), J604.11 (A11), TP1706.1, U1701.3 (MR), U1701.4 (VDD)
V4P3_RB: C177.1, C1727.1, J604.15 (A15), J604.16 (A16), J604.17 (A17), J604.18 (A18), TP1707.1
V8P3: C172.1, C1722.1, J603.5 (A5), J603.45 (B5), J604.5 (A5), J604.45 (B5), TP1702.1
V18: R1701.1, TP1708.1
V33FF_L: R1712.1
V33FF_R: R1702.1

Notes on the sheet:
PRE-REG ENTRY (bom 17(d)/(l)/(n), option B + per-branch V4P3 2026-10-xx): pre-reg rails enter on two SEAF-40 sites - J603 north-center carries the L-branches, J604 south-center the R-branches. Shared rails (one source, two destinations): P16A (+16.2 V -> +15 V-class POLs), N16A (-16.2 V -> N15A/VEE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
Conn1/J506 = west, closest to FPGA; Conn2/J603 = north-center; Conn3/J604 = south-center. All three SEAF-40 sites are on the main-board bottom. Three SEAR interposers are BOM-only. Board separation target is 40 mm. Each pre-reg rail sits beside its own GND return; 10 uF local bulk per rail per conn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
Conn1 only: V12SOM uses 30 contacts with a separate GND surround. V33_IF_IN uses four contacts with a carrier-GND guard and feeds the local 1.8 V LDO; it is not VAP_IO/GND_AP.
PG_ALL = wired-AND of every POL power-good, HARDWARE ONLY (bom 17(m)): 8 x LT3045 + 4 x LT3094 + V33CLK LT3045 PG pins (open-collector) + U1701/U1702 TPS3890 RESETs (one per V33FF bank); pull-up R1701 10k to V18 (SoM rail - sets the 1.8 V logic level for U602 and the FPGA IO). High = all analog + c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
U1701/U1702 TPS389001: SENSE divider 162k/100k = 3.01 V trip on V33FF_R / V33FF_L (VITN 1.15 V, SBVS227 - the 400 mV figure in the 17(m) notes was wrong). Both RESETs join the PG_ALL wired-AND.
TEST POINTS (rules c/d): pre-reg rails / PG_ALL / SNS_V33FF_x on hook pads; GND at the end.
