ccroswhite/BFDAC/hw/kicad/prereg.kicad_sch

## KiCad design hw/kicad/prereg.kicad_sch (2026-11-04)

Schematic: prereg.kicad_sch

Parts:
C7701, C7702, C7703, C7711, C7712, C7713: 10000u; CP_Radial_D18.0mm_P7.50mm; MPN UPW1C103MHD
C7705, C7715, C7805, C7806, C7903: 1u; C_Rect_L7.2mm_W2.5mm_P5.00mm_FKS2_FKP2_MKS2_MKP2; MPN MKS2C051001K00JSSD
C7706, C7716, C7722, C7725, C7732, C7735, C7742, C7745, C7752, C7755, C7762, C7765, C7807, C7808, C7810, C7812, C7815, C7817, C7904, C7906, C7908: 100n; C_0603_1608Metric; MPN GRM188R71C104KA01D
C7721, C7723, C7724, C7731, C7733, C7734, C7741, C7743, C7744, C7751, C7753, C7754, C7761, C7763, C7764, C7905, C7907: 10u; C_1206_3216Metric; MPN GRM31CR71E106KA12L
C7726, C7736, C7746, C7756, C7766, C7813, C7818, C7909: 10n; C_0603_1608Metric; MPN GRM1885C1H103JA01D
C7771, C7772, C7773, C7774, C7781, C7782, C7783, C7784, C7841, C7842, C7843, C7844, C7941, C7942, C7943, C7944: 100n; C_0603_1608Metric; MPN GRM1885C2A104JA01D
C7801, C7802, C7803, C7804: 10000u; CP_Radial_D18.0mm_P7.50mm; MPN UPW1H103MHHD
C7809, C7811, C7814, C7816: 10u; C_1206_3216Metric; MPN GRM31CR71H106KA12L
C7901, C7902: 10000u; CP_Radial_D16.0mm_P7.50mm; MPN UPW1E103MHD
D7701, D7702, D7703, D7704, D7705, D7706, D7707, D7708, D7801, D7802, D7803, D7804, D7901, D7902, D7903, D7904: STPS10L60D; TO-220-2_Vertical; MPN STPS10L60D
J7703, J7704: PRE-REG; Samtec_SEAF-40-05.0-L-06-2-A_40x6_P1.27mm; MPN SEAF-40-05.0-L-06-2-A-K-TR
J7705: AP DIG + PWR; Samtec_SEAF-40-05.0-L-06-2-A_40x6_P1.27mm; MPN SEAF-40-05.0-L-06-2-A-K-TR
R7701, R7702: 1k; R_0603_1608Metric; MPN TNPW06031001FEEA
R7721, R7723, R7731, R7733, R7741: 25.5k; R_0603_1608Metric; MPN RG1608N-2552-W-T1
R7722, R7724, R7732, R7734, R7742, R7903: 10k; R_0603_1608Metric; MPN RG1608N-1002-W-T1
R7771, R7772, R7773, R7774, R7781, R7782, R7783, R7784, R7841, R7842, R7843, R7844, R7941, R7942, R7943, R7944: 22; R_0603_1608Metric; MPN TNPW060322R0FEEA
R7801, R7802, R7901: 2.4k; R_2010_5025Metric; MPN TNPW20102401FEEA
R7805, R7807: 240; R_0603_1608Metric; MPN RG1608N-2400-W-T1
R7806, R7808: 2.87k; R_0603_1608Metric; MPN RG1608N-2871-W-T1
R7809, R7810: 1.5k; R_2010_5025Metric; MPN TNPW20101501FEEA
R7902: 59k; R_0603_1608Metric; MPN RG1608N-5902-W-T1
R7904: 1k; R_2010_5025Metric; MPN TNPW20101001FEEA
TP7700, TP7701, TP7702, TP7703, TP7704, TP7705, TP7706, TP7707, TP7708, TP7709, TP7710, TP7711, TP7712, TP7713, TP7714, TP7715, TP7716, TP7717, TP7718, TP7719, TP7720, TP7721, TP7722: TP; TestPoint_THTPad_2.0x2.0mm_Drill1.0mm
U7701, U7702, U7703, U7704, U7705, U7901: TPS7A4501; TO-263-5_TabPin3; MPN TPS7A4501KTTR
U7801: LM317; TO-220-3_Vertical; MPN LM317KCSE3
U7802: LM337; TO-220-3_Vertical; MPN LM337KCSE3

Connections:
AC6_L1: C7771.1, D7701.2 (A), D7703.1 (K), R7773.2, TP7705.1
AC6_L2: C7772.1, D7702.2 (A), D7704.1 (K), R7774.2, TP7706.1
AC6_R1: C7781.1, D7705.2 (A), D7707.1 (K), R7783.2, TP7707.1
AC6_R2: C7782.1, D7706.2 (A), D7708.1 (K), R7784.2, TP7708.1
AC9_1: C7941.1, D7901.2 (A), D7903.1 (K), R7943.2, TP7711.1
AC9_2: C7942.1, D7902.2 (A), D7904.1 (K), R7944.2, TP7712.1
AC18_1: C7841.1, D7801.2 (A), D7803.1 (K), R7843.2, TP7709.1
AC18_4: C7842.1, D7802.2 (A), D7804.1 (K), R7844.2, TP7710.1
ADJ_U7701: C7726.1, R7721.2, R7722.1, U7701.5 (ADJ)
ADJ_U7702: C7736.1, R7731.2, R7732.1, U7702.5 (ADJ)
ADJ_U7703: C7746.1, R7723.2, R7724.1, U7703.5 (ADJ)
ADJ_U7704: C7756.1, R7733.2, R7734.1, U7704.5 (ADJ)
ADJ_U7705: C7766.1, R7741.2, R7742.1, U7705.5 (ADJ)
ADJ_U7801: C7813.1, R7805.2, R7806.1, U7801.1 (ADJ)
ADJ_U7802: C7818.1, R7807.2, R7808.1, U7802.1 (ADJ)
ADJ_U7901: C7909.1, R7902.2, R7903.1, U7901.5 (ADJ)
AP_I2S_BCLK: J7705.9 (A9)
AP_I2S_DATA: J7705.13 (A13)
AP_I2S_DATA2: J7705.27 (A27)
AP_I2S_LRCLK: J7705.11 (A11)
AP_IRQ_N: J7705.15 (A15)
AP_RST_N: J7705.17 (A17)
AP_SCL: J7705.21 (A21)
AP_SDA: J7705.19 (A19)
AP_SPI_CS_N: J7705.3 (A3)
AP_SPI_MISO: J7705.7 (A7)
AP_SPI_MOSI: J7705.5 (A5)
AP_SPI_SCLK: J7705.1 (A1)
GND: C7701.2, C7702.2, C7703.2, C7705.2, C7706.2, C7711.2, C7712.2, C7713.2, C7715.2, C7716.2, C7721.2, C7722.2, C7723.2, C7724.2, C7725.2, C7726.2, C7731.2, C7732.2, C7733.2, C7734.2, C7735.2, C7736.2, C7741.2, C7742.2, C7743.2, C7744.2, C7745.2, C7746.2, C7751.2, C7752.2, C7753.2, C7754.2, C7755.2, C7756.2, C7761.2, C7762.2, C7763.2, C7764.2, C7765.2, C7766.2, C7773.1, C7774.1, C7783.1, C7784.1, C7801.2, C7802.2, C7803.2, C7804.2, C7805.2, C7806.2, C7807.2, C7808.2, C7809.2, C7810.2, C7811.2, C7812.2, C7813.2, C7814.2, C7815.2, C7816.2, C7817.2, C7818.2, C7901.2, C7902.2, C7903.2, C7904.2, C7905.2, C7906.2, C7907.2, C7908.2, C7909.2, C7943.1, C7944.1, D7703.2 (A), D7704.2 (A), D7707.2 (A), D7708.2 (A), D7903.2 (A), D7904.2 (A), J7703.2 (A2), J7703.4 (A4), J7703.6 (A6), J7703.8 (A8), J7703.12 (A12), J7703.13 (A13), J7703.14 (A14), J7703.19 (A19), J7703.20 (A20), J7703.21 (A21), J7703.22 (A22), J7703.27 (A27), J7703.28 (A28), J7703.29 (A29), J7703.30 (A30), J7703.42 (B2), J7703.44 (B4), J7703.46 (B6), J7704.2 (A2), J7704.4 (A4), J7704.6 (A6), J7704.8 (A8), J7704.12 (A12), J7704.13 (A13), J7704.14 (A14), J7704.19 (A19), J7704.20 (A20), J7704.21 (A21), J7704.22 (A22), J7704.42 (B2), J7704.44 (B4), J7704.46 (B6), J7705.41 (B1), J7705.42 (B2), J7705.43 (B3), J7705.44 (B4), J7705.45 (B5), J7705.46 (B6), J7705.47 (B7), J7705.48 (B8), J7705.49 (B9), J7705.50 (B10), J7705.51 (B11), J7705.52 (B12), J7705.69 (B29), J7705.70 (B30), J7705.71 (B31), J7705.72 (B32), J7705.81 (C1), J7705.92 (C12), J7705.109 (C29), J7705.112 (C32), J7705.121 (D1), J7705.132 (D12), J7705.149 (D29), J7705.152 (D32), J7705.161 (E1), J7705.172 (E12), J7705.189 (E29), J7705.190 (E30), J7705.191 (E31), J7705.192 (E32), J7705.201 (F1), J7705.202 (F2), J7705.203 (F3), J7705.204 (F4), J7705.205 (F5), J7705.206 (F6), J7705.207 (F7), J7705.208 (F8), J7705.209 (F9), J7705.210 (F10), J7705.211 (F11), J7705.212 (F12), R7701.2, R7702.2, R7722.2, R7724.2, R7732.2, R7734.2, R7742.2, R7801.2, R7802.2, R7806.2, R7808.2, R7809.2, R7810.2, R7901.2, R7903.2, R7904.2, TP7721.1, TP7722.1, U7701.3 (GND), U7702.3 (GND), U7703.3 (GND), U7704.3 (GND), U7705.3 (GND), U7901.3 (GND)
GND_AP: J7705.2 (A2), J7705.4 (A4), J7705.6 (A6), J7705.8 (A8), J7705.10 (A10), J7705.12 (A12), J7705.14 (A14), J7705.16 (A16), J7705.18 (A18), J7705.20 (A20), J7705.22 (A22), J7705.24 (A24), J7705.26 (A26), J7705.28 (A28), J7705.29 (A29), J7705.30 (A30), J7705.31 (A31), J7705.32 (A32), J7705.33 (A33), J7705.34 (A34), J7705.35 (A35), J7705.36 (A36), J7705.37 (A37), J7705.38 (A38), J7705.39 (A39), J7705.40 (A40), J7705.53 (B13), J7705.54 (B14), J7705.55 (B15), J7705.56 (B16), J7705.57 (B17), J7705.58 (B18), J7705.59 (B19), J7705.60 (B20), J7705.61 (B21), J7705.62 (B22), J7705.63 (B23), J7705.64 (B24), J7705.65 (B25), J7705.66 (B26), J7705.67 (B27), J7705.68 (B28), J7705.73 (B33), J7705.75 (B35), J7705.77 (B37), J7705.79 (B39), J7705.93 (C13), J7705.94 (C14), J7705.95 (C15), J7705.96 (C16), J7705.97 (C17), J7705.98 (C18), J7705.99 (C19), J7705.100 (C20), J7705.101 (C21), J7705.102 (C22), J7705.103 (C23), J7705.104 (C24), J7705.105 (C25), J7705.106 (C26), J7705.107 (C27), J7705.108 (C28), J7705.113 (C33), J7705.114 (C34), J7705.115 (C35), J7705.116 (C36), J7705.117 (C37), J7705.118 (C38), J7705.119 (C39), J7705.120 (C40), J7705.133 (D13), J7705.134 (D14), J7705.135 (D15), J7705.136 (D16), J7705.137 (D17), J7705.138 (D18), J7705.139 (D19), J7705.140 (D20), J7705.141 (D21), J7705.142 (D22), J7705.143 (D23), J7705.144 (D24), J7705.145 (D25), J7705.146 (D26), J7705.147 (D27), J7705.148 (D28), J7705.153 (D33), J7705.154 (D34), J7705.155 (D35), J7705.156 (D36), J7705.157 (D37), J7705.158 (D38), J7705.159 (D39), J7705.160 (D40), J7705.173 (E13), J7705.174 (E14), J7705.175 (E15), J7705.176 (E16), J7705.177 (E17), J7705.178 (E18), J7705.179 (E19), J7705.180 (E20), J7705.181 (E21), J7705.182 (E22), J7705.183 (E23), J7705.184 (E24), J7705.185 (E25), J7705.186 (E26), J7705.187 (E27), J7705.188 (E28), J7705.193 (E33), J7705.194 (E34), J7705.195 (E35), J7705.196 (E36), J7705.197 (E37), J7705.198 (E38), J7705.199 (E39), J7705.200 (E40), J7705.213 (F13), J7705.214 (F14), J7705.215 (F15), J7705.216 (F16), J7705.217 (F17), J7705.218 (F18), J7705.219 (F19), J7705.220 (F20), J7705.221 (F21), J7705.222 (F22), J7705.223 (F23), J7705.224 (F24), J7705.225 (F25), J7705.226 (F26), J7705.227 (F27), J7705.228 (F28), J7705.229 (F29), J7705.230 (F30), J7705.231 (F31), J7705.232 (F32), J7705.233 (F33), J7705.234 (F34), J7705.235 (F35), J7705.236 (F36), J7705.237 (F37), J7705.238 (F38), J7705.239 (F39), J7705.240 (F40)
N16A: C7816.1, C7817.1, J7703.3 (A3), J7703.43 (B3), J7704.3 (A3), J7704.43 (B3), R7807.1, R7810.1, TP7714.1, U7802.3 (OUT)
P16A: C7811.1, C7812.1, J7703.1 (A1), J7703.41 (B1), J7704.1 (A1), J7704.41 (B1), R7805.1, R7809.1, TP7713.1, U7801.2 (OUT)
SN7771: C7771.2, R7771.1
SN7772: C7772.2, R7772.1
SN7773: C7773.2, R7773.1
SN7774: C7774.2, R7774.1
SN7781: C7781.2, R7781.1
SN7782: C7782.2, R7782.1
SN7783: C7783.2, R7783.1
SN7784: C7784.2, R7784.1
SN7841: C7841.2, R7841.1
SN7842: C7842.2, R7842.1
SN7843: C7843.2, R7843.1
SN7844: C7844.2, R7844.1
SN7941: C7941.2, R7941.1
SN7942: C7942.2, R7942.1
SN7943: C7943.2, R7943.1
SN7944: C7944.2, R7944.1
SOM_PG: J7705.23 (A23)
V4P3_LA: C7723.1, C7724.1, C7725.1, J7703.7 (A7), J7703.9 (A9), J7703.10 (A10), J7703.11 (A11), R7721.1, TP7716.1, U7701.4 (OUT)
V4P3_LB: C7733.1, C7734.1, C7735.1, J7703.15 (A15), J7703.16 (A16), J7703.17 (A17), J7703.18 (A18), R7731.1, TP7717.1, U7702.4 (OUT)
V4P3_LC: C7763.1, C7764.1, C7765.1, J7703.23 (A23), J7703.24 (A24), J7703.25 (A25), J7703.26 (A26), R7741.1, TP7718.1, U7705.4 (OUT)
V4P3_RA: C7743.1, C7744.1, C7745.1, J7704.7 (A7), J7704.9 (A9), J7704.10 (A10), J7704.11 (A11), R7723.1, TP7719.1, U7703.4 (OUT)
V4P3_RB: C7753.1, C7754.1, C7755.1, J7704.15 (A15), J7704.16 (A16), J7704.17 (A17), J7704.18 (A18), R7733.1, TP7720.1, U7704.4 (OUT)
V8P3: C7907.1, C7908.1, J7703.5 (A5), J7703.45 (B5), J7704.5 (A5), J7704.45 (B5), R7902.1, R7904.1, TP7715.1, U7901.4 (OUT)
V12SOM: J7705.82 (C2), J7705.83 (C3), J7705.84 (C4), J7705.85 (C5), J7705.86 (C6), J7705.87 (C7), J7705.88 (C8), J7705.89 (C9), J7705.90 (C10), J7705.91 (C11), J7705.122 (D2), J7705.123 (D3), J7705.124 (D4), J7705.125 (D5), J7705.126 (D6), J7705.127 (D7), J7705.128 (D8), J7705.129 (D9), J7705.130 (D10), J7705.131 (D11), J7705.162 (E2), J7705.163 (E3), J7705.164 (E4), J7705.165 (E5), J7705.166 (E6), J7705.167 (E7), J7705.168 (E8), J7705.169 (E9), J7705.170 (E10), J7705.171 (E11)
V33_IF_IN: J7705.110 (C30), J7705.111 (C31), J7705.150 (D30), J7705.151 (D31)
VAP_IO: J7705.25 (A25), J7705.74 (B34), J7705.76 (B36), J7705.78 (B38), J7705.80 (B40)
VRAW6_L: C7701.1, C7702.1, C7703.1, C7705.1, C7706.1, C7721.1, C7722.1, C7731.1, C7732.1, C7761.1, C7762.1, D7701.1 (K), D7702.1 (K), R7701.1, R7771.2, R7772.2, TP7700.1, U7701.1 (SHDN), U7701.2 (IN), U7702.1 (SHDN), U7702.2 (IN), U7705.1 (SHDN), U7705.2 (IN)
VRAW6_R: C7711.1, C7712.1, C7713.1, C7715.1, C7716.1, C7741.1, C7742.1, C7751.1, C7752.1, D7705.1 (K), D7706.1 (K), R7702.1, R7781.2, R7782.2, TP7701.1, U7703.1 (SHDN), U7703.2 (IN), U7704.1 (SHDN), U7704.2 (IN)
VRAW9: C7901.1, C7902.1, C7903.1, C7904.1, C7905.1, C7906.1, D7901.1 (K), D7902.1 (K), R7901.1, R7941.2, R7942.2, TP7704.1, U7901.1 (SHDN), U7901.2 (IN)
VRAW16N: C7803.1, C7804.1, C7806.1, C7808.1, C7814.1, C7815.1, C7843.1, C7844.1, D7803.2 (A), D7804.2 (A), R7802.1, TP7703.1, U7802.2 (IN)
VRAW16P: C7801.1, C7802.1, C7805.1, C7807.1, C7809.1, C7810.1, D7801.1 (K), D7802.1 (K), R7801.1, R7841.2, R7842.2, TP7702.1, U7801.3 (IN)

Notes on the sheet:
TUB 1 PRE-REGULATOR BOARD (bom 17o) - SEPARATE PCB: all symbols here are on_board=no. One 6 VAC / 20 VA R-core transformer per channel - THT, SOLDERED ON THIS BOARD (ACENTRY sheet); secondaries land directly on the bridge diodes (AC6_x1/AC6_x2 globals). Branches are NEVER paralleled: each TPS7A4501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
Reservoir sizing (per transformer, 2 A DC worst): 3 x 10,000 uF/16 V high-ripple 105 C = 30 mF; ~1 V pp ripple at 50 Hz/-10% line -> trough ~5.8 V vs the 4.8 V floor (4.3 V out + 0.5 V TPS7A4501 dropout budget). P16A/N16A/V8P3 stages are DRAWN below (bottom strip, 2026-10-28 - 115 V mains ruling). 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
SHARED-RAIL STAGES (bom 17o; 115 V mains ruling 2026-10-28): T902 2x18 VAC series-aided 18-0-18 (S2+S3 = CT = GND, tied at T902 on ACENTRY) -> bridge + snubbers -> +-24 V raw (2x10 mF/50 V per rail) -> U7801 LM317 = P16A +16.24 V, U7802 LM337 = N16A -16.24 V (240/2.87k on 1.25 V ref; 1.5k OUT bleed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
J7703/J7704 = pre-reg-board SEAF-40 mates (the SEAR-40-30.0-06-85 interposers plug these to main-board J603/J604). Pad map mirrors the main board: A branches on pads 7/9-11, B branches on pads 15-18, LC branch on pads 23-26 (J703 only), shared rails on 1/3/5 (+41/43/45).
J7705 = pre-reg-board SEAF-40 mate to Conn1/J506 (user ruling 2026-11-03: the pre-reg board mates ALL THREE main-board SEAFs through SEAR-40 interposers; SEAF sockets on both boards, male pins live on the riser/interposer card). Full 240-pad mirror of docs/SEAF_PIN_ASSIGNMENTS.md: V12SOM bank (30 p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
TEST POINTS: reservoirs / AC secondaries / all eight regulator outputs on hook pads; GND below.
