ccroswhite/BFDAC/hw/kicad/refs.kicad_sch

## KiCad design hw/kicad/refs.kicad_sch (2026-11-04)

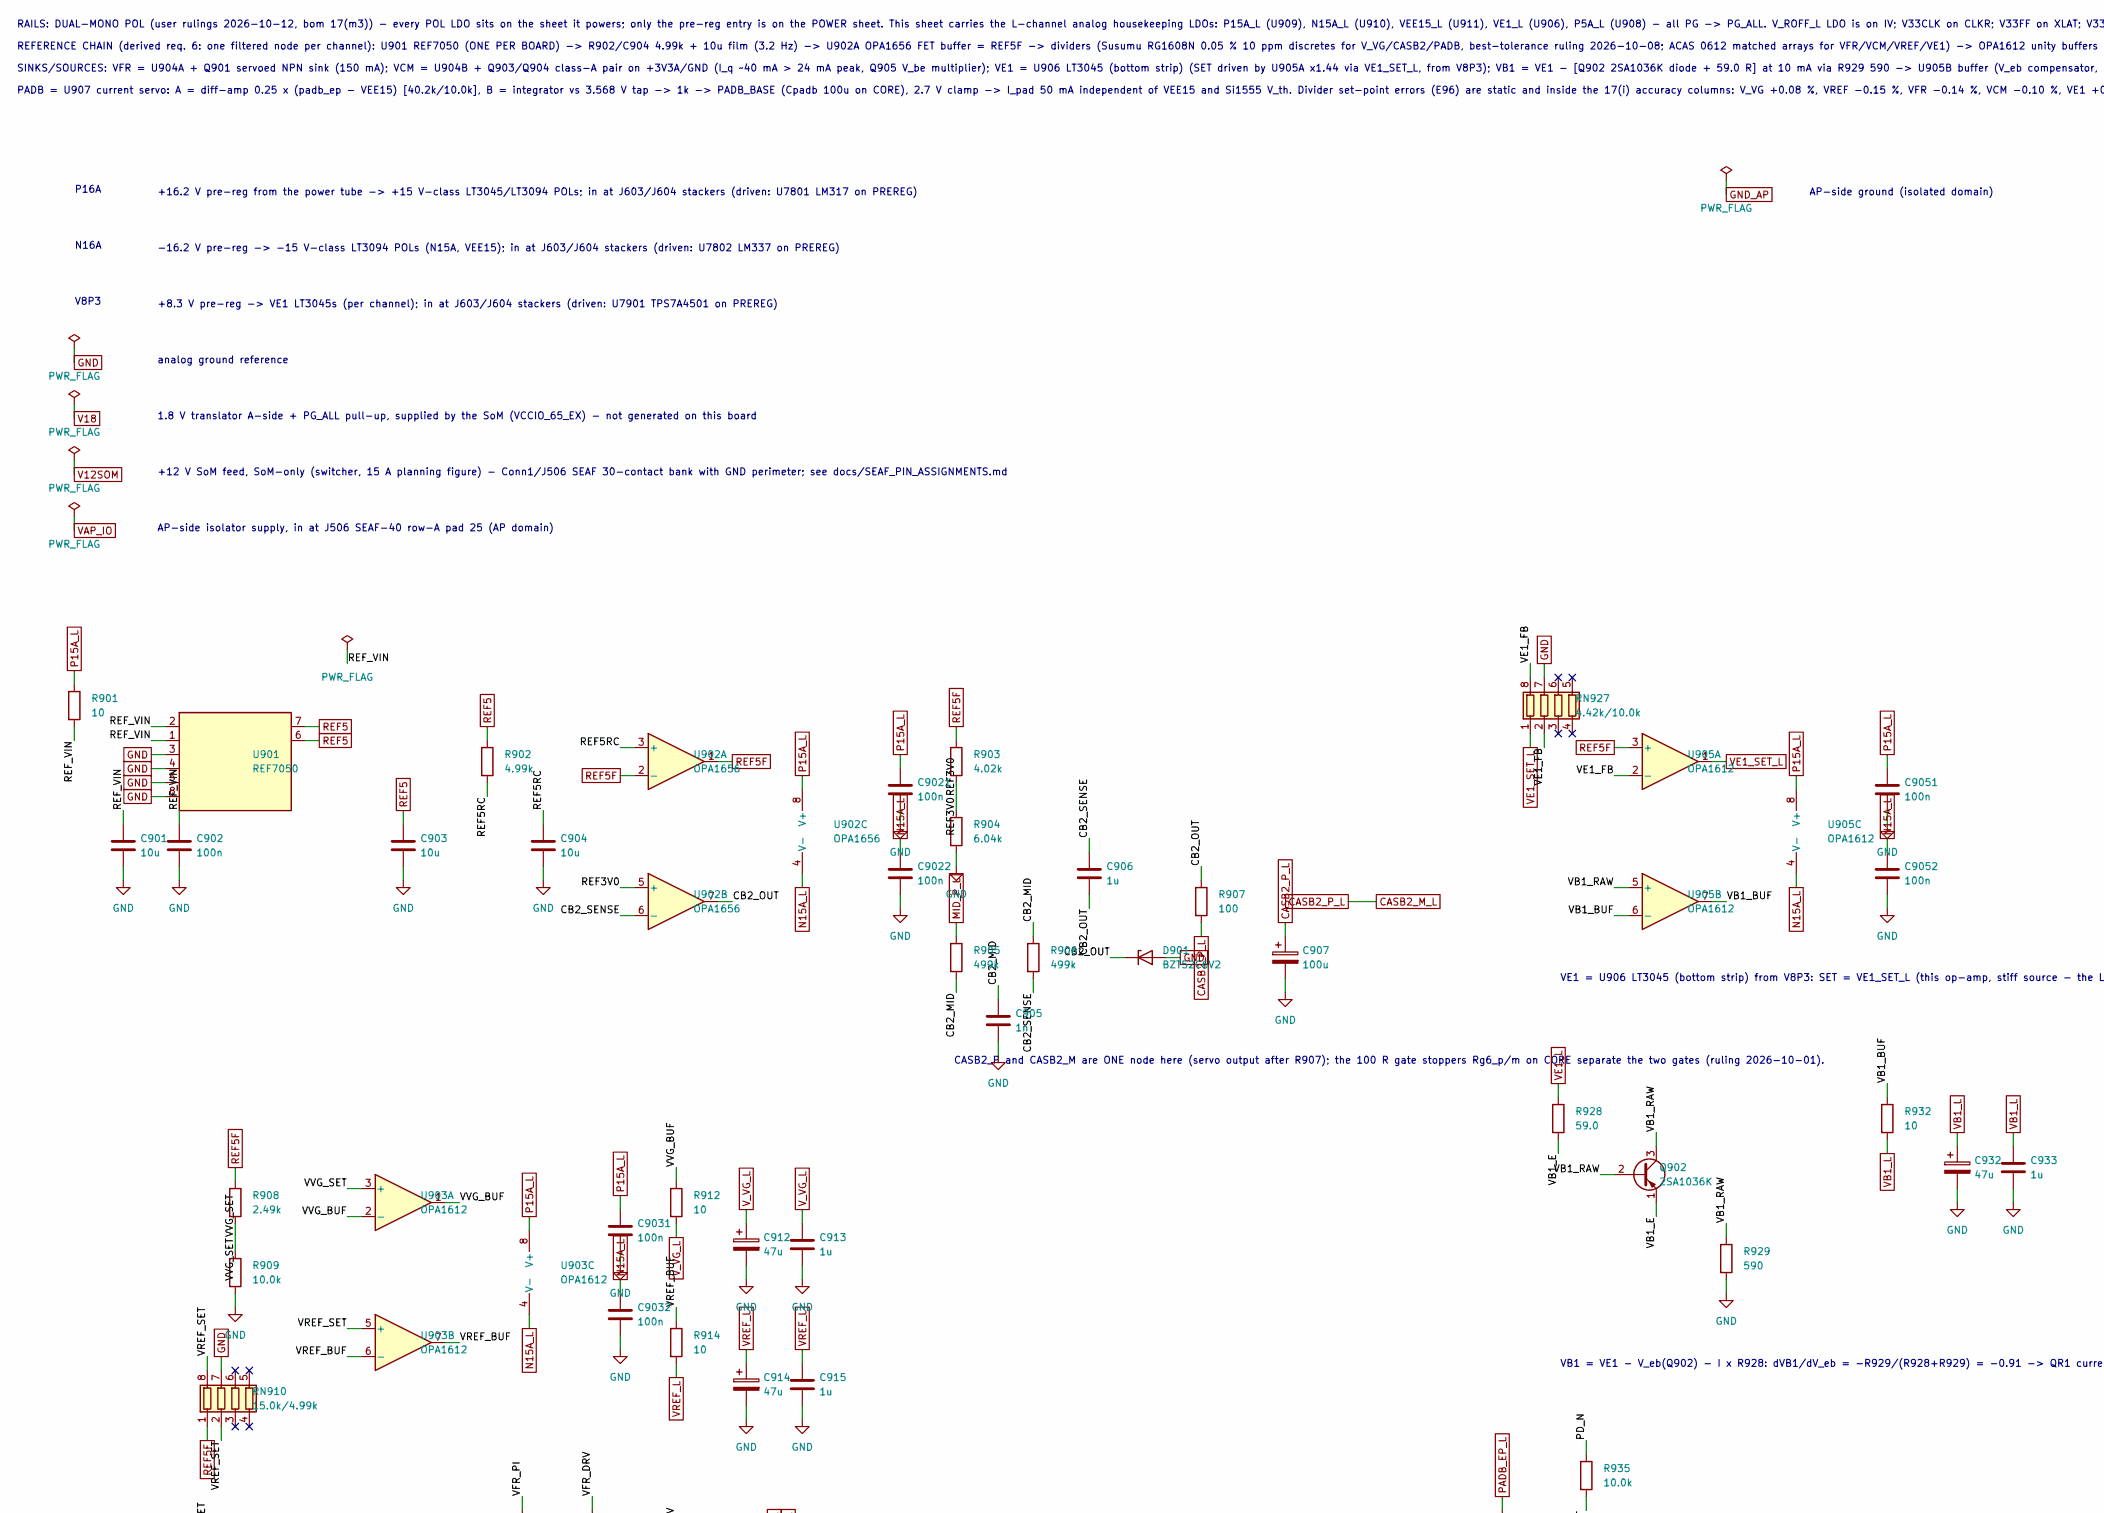
[picture p27: schematic refs.kicad_sch, part in row 1, column 1]

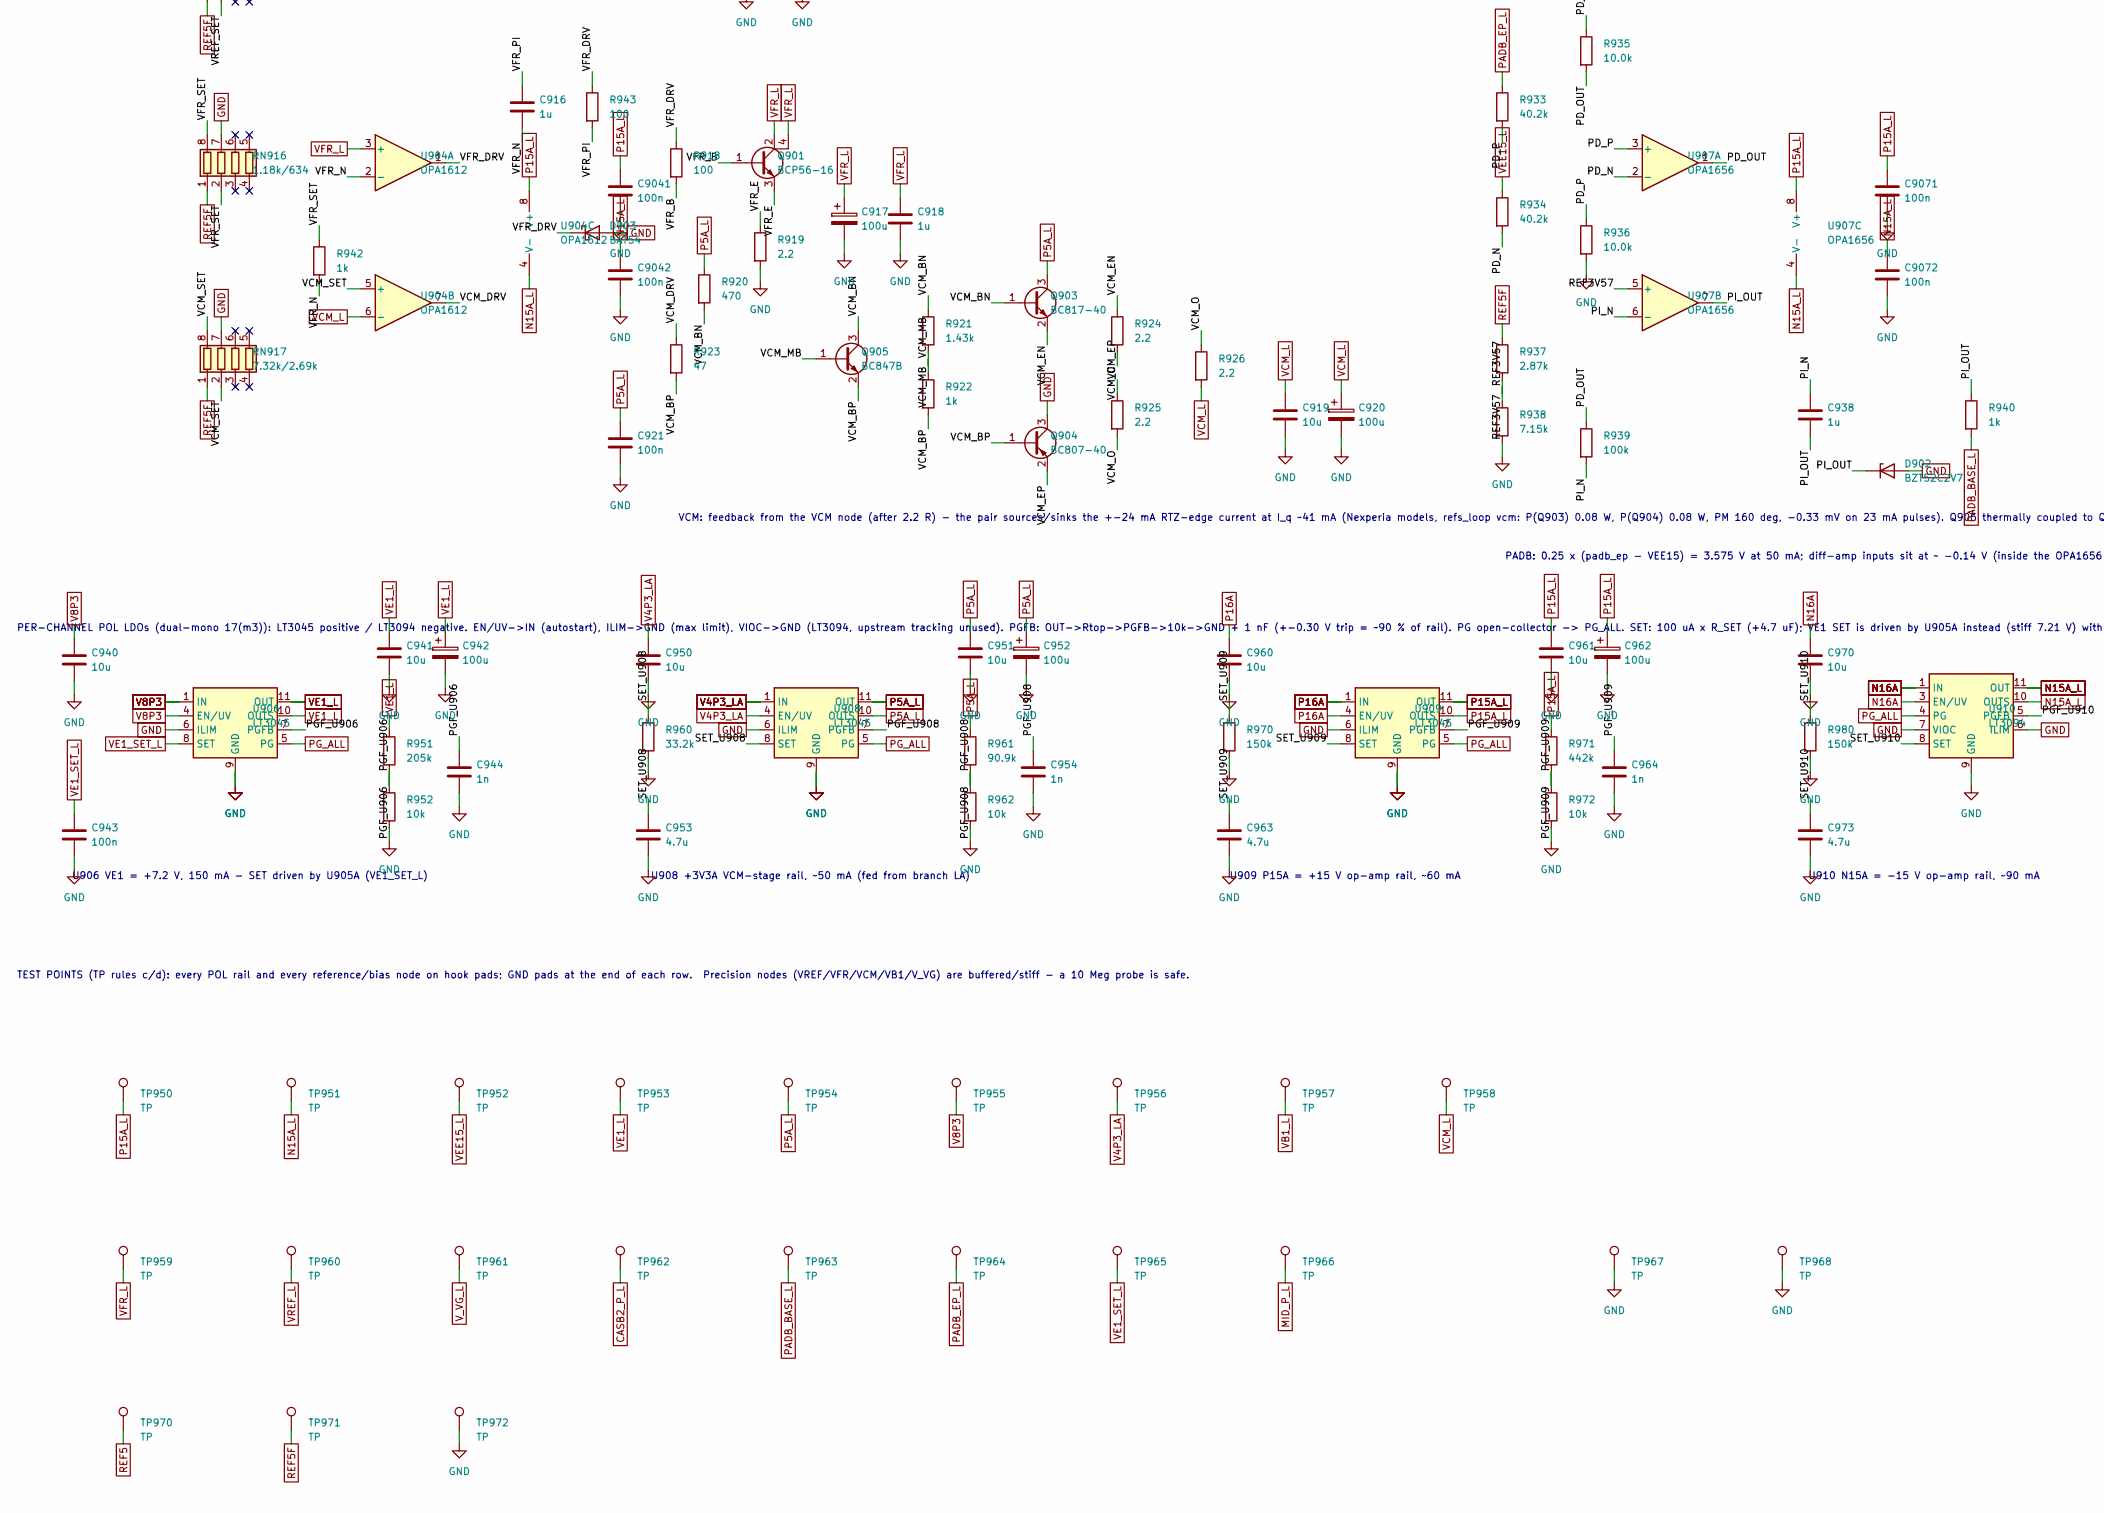
[picture p28: schematic refs.kicad_sch, part in row 2, column 1]

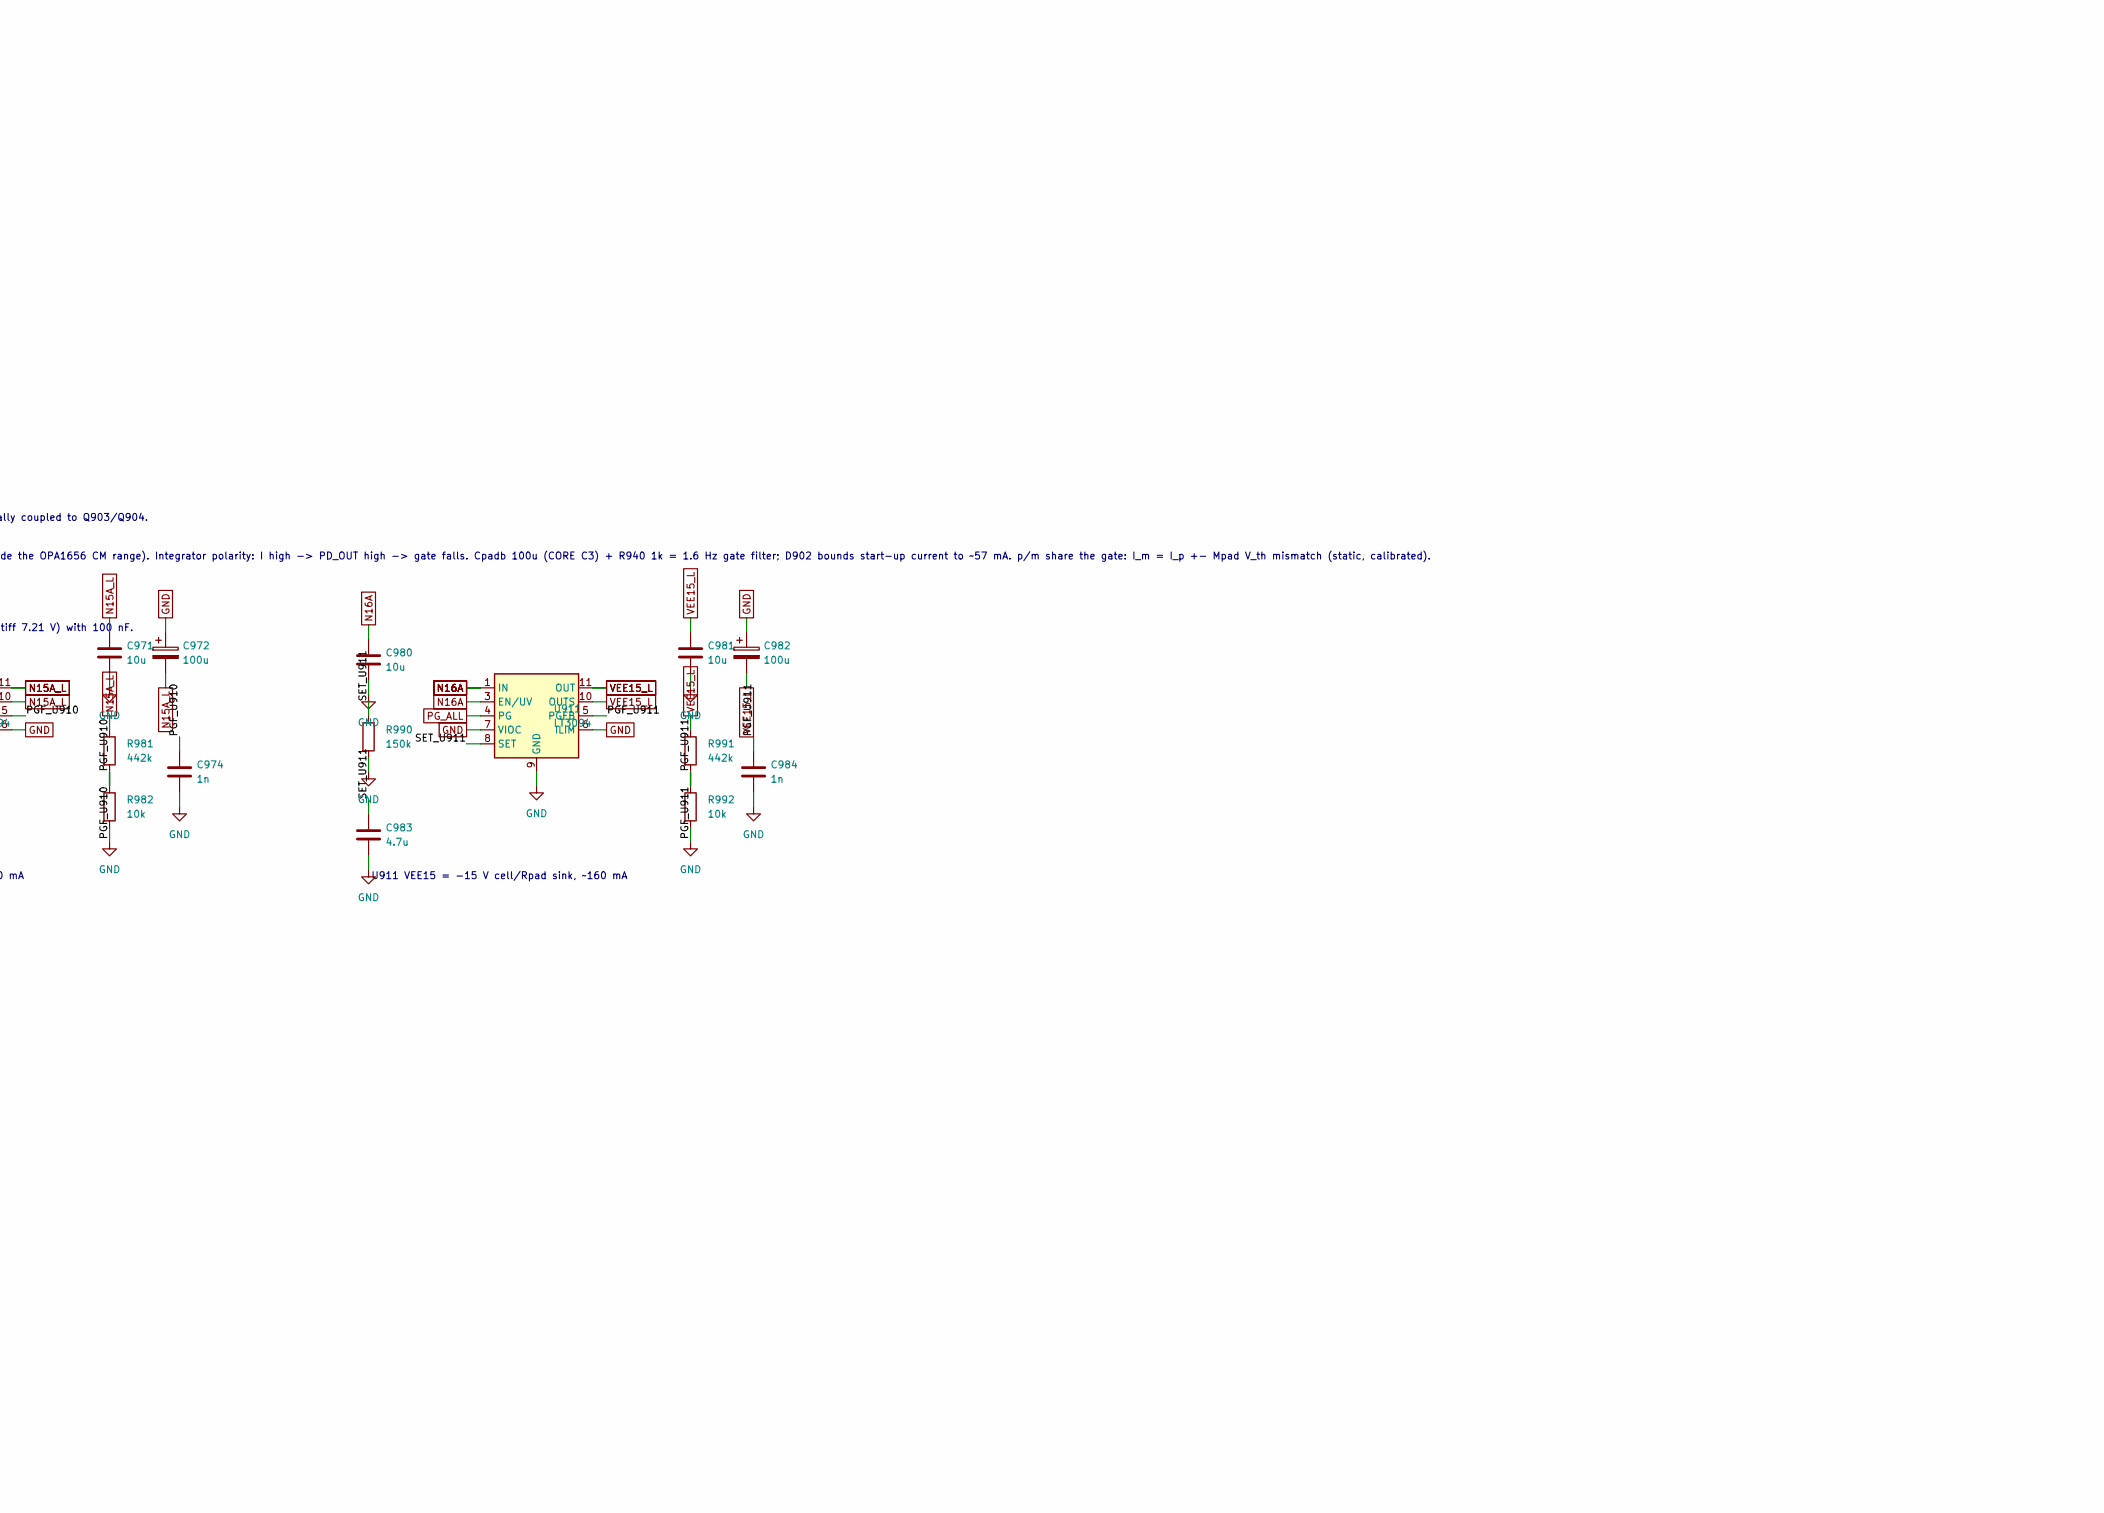
[picture p29: schematic refs.kicad_sch, part in row 2, column 2]

Parts:
C901, C903, C919, C940, C941, C950, C951, C960, C961, C970, C971, C980, C981: 10u; C_1206_3216Metric; MPN GRM31CR71E106KA12L
C902, C921, C943, C9021, C9022, C9031, C9032, C9041, C9042, C9051, C9052, C9071, C9072: 100n; C_0603_1608Metric; MPN GRM188R71H104KA93D
C904: 10u; C_Rect_L7.2mm_W7.2mm_P5.00mm_FKS2_FKP2_MKS2_MKP2; MPN MKS2B051001N00KSSD
C905, C944, C954, C964, C974, C984: 1n; C_0603_1608Metric; MPN GRM1885C1H102JA01D
C906, C916, C938: 1u; C_Rect_L7.2mm_W2.5mm_P5.00mm_FKS2_FKP2_MKS2_MKP2; MPN MKS2C041001F00KSSD
C907, C917, C920, C942, C952, C962, C972, C982: 100u; CP_Radial_D6.3mm_P2.50mm; MPN UKL1C101MED
C912, C914, C932: 47u; CP_Radial_D5.0mm_P2.50mm; MPN UKL1E470MDD
C913, C915, C918, C933: 1u; C_1206_3216Metric; MPN GRM31C5C1E105JA01L
C953, C963, C973, C983: 4.7u; C_0805_2012Metric; MPN GRM21BR71E475KA73L
D901: BZT52C6V2; D_SOD-123; MPN BZT52C6V2-7-F
D902: BZT52C2V7; D_SOD-123; MPN BZT52C2V7-7-F
D903: BAT54; SOT-23; MPN BAT54,215
Q901: BCP56-16; SOT-223; MPN BCP56-16,115
Q902: 2SA1036K; SC-59; MPN 2SA1036KT146Q
Q903: BC817-40; SOT-23; MPN BC817-40,215
Q904: BC807-40; SOT-23; MPN BC807-40,215
Q905: BC847B; SOT-23; MPN BC847B,215
R901, R912, R914, R932: 10; R_0603_1608Metric; MPN TNPW060310R0FEEA
R902: 4.99k; R_0603_1608Metric; MPN RG1608N-4991-W-T1
R903: 4.02k; R_0603_1608Metric; MPN RG1608N-4021-W-T1
R904: 6.04k; R_0603_1608Metric; MPN RG1608N-6041-W-T1
R905, R906: 499k; R_0603_1608Metric; MPN RG1608P-4993-B-T5
R907, R918: 100; R_0603_1608Metric; MPN RG1608N-1000-W-T1
R908: 2.49k; R_0603_1608Metric; MPN RG1608N-2491-W-T1
R909, R935, R936: 10.0k; R_0603_1608Metric; MPN RG1608N-1002-W-T1
R919, R924, R925, R926: 2.2; R_0603_1608Metric; MPN TNPW06032R20FEEA
R920: 470; R_0603_1608Metric; MPN TNPW0603470RFEEA
R921: 1.43k; R_0603_1608Metric; MPN TNPW06031K43FEEA
R922: 1k; R_0603_1608Metric; MPN TNPW06031K00FEEA
R923: 47; R_0603_1608Metric; MPN TNPW060347R0FEEA
R928: 59.0; R_0603_1608Metric; MPN RG1608N-59R0-W-T1
R929: 590; R_0603_1608Metric; MPN RG1608N-5900-W-T1
R933, R934: 40.2k; R_0603_1608Metric; MPN RG1608N-4022-W-T1
R937: 2.87k; R_0603_1608Metric; MPN RG1608N-2871-W-T1
R938: 7.15k; R_0603_1608Metric; MPN RG1608N-7151-W-T1
R939: 100k; R_0603_1608Metric; MPN RG1608N-1003-W-T1
R940, R942: 1k; R_0603_1608Metric; MPN RG1608N-1001-W-T1
R943: 100; R_0603_1608Metric; MPN TNPW0603100RFEEA
R951: 205k; R_0603_1608Metric; MPN RG1608N-2053-W-T1
R952, R962, R972, R982, R992: 10k; R_0603_1608Metric; MPN RG1608N-1002-W-T1
R960: 33.2k; R_0603_1608Metric; MPN RG1608N-3322-W-T1
R961: 90.9k; R_0603_1608Metric; MPN RG1608N-9092-W-T1
R970, R980, R990: 150k; R_0603_1608Metric; MPN RG1608N-1503-W-T1
R971, R981, R991: 442k; R_0603_1608Metric; MPN RG1608N-4423-W-T1
RN910: 15.0k/4.99k; R_Array_Convex_4x0612; MPN ACASA15024991P1AT
RN916: 1.18k/634; R_Array_Convex_4x0612; MPN ACASA11816340P1AT
RN917: 7.32k/2.69k; R_Array_Convex_4x0612; MPN ACASA73212691P1AT
RN927: 4.42k/10.0k; R_Array_Convex_4x0612; MPN ACASA44211002P1AT
TP950, TP951, TP952, TP953, TP954, TP955, TP956, TP957, TP958, TP959, TP960, TP961, TP962, TP963, TP964, TP965, TP966, TP967, TP968, TP970, TP971, TP972: TP; TestPoint_THTPad_2.0x2.0mm_Drill1.0mm
U901: REF7050; Analog_LCC-8_5x5mm_P1.27mm; MPN REF7050QFKHT
U902, U907: OPA1656; SOIC-8_3.9x4.9mm_P1.27mm; MPN OPA1656ID
U903, U904, U905: OPA1612; TI_OPA1612_DRG_WSON-8_3x3mm_P0.5mm_EP1.2x2.0mm; MPN OPA1612AIDRGR
U906, U908, U909: LT3045; MSOP-12-1EP_3x4.039mm_P0.65mm_EP1.651x2.845mm_ThermalVias; MPN LT3045EMSE#PBF
U910, U911: LT3094; MSOP-12-1EP_3x4.039mm_P0.65mm_EP1.651x2.845mm_ThermalVias; MPN LT3094EMSE#PBF

Connections:
CASB2_M_L: C907.1, R907.2, TP962.1
CB2_MID: C905.1, R905.2, R906.1
CB2_OUT: C906.2, D901.1 (K), R907.1, U902.7
CB2_SENSE: C906.1, R906.2, U902.6 (-)
GND: C901.2, C902.2, C903.2, C904.2, C905.2, C907.2, C912.2, C913.2, C914.2, C915.2, C917.2, C918.2, C919.2, C920.2, C921.2, C932.2, C933.2, C940.2, C941.2, C942.2, C943.2, C944.2, C950.2, C951.2, C952.2, C953.2, C954.2, C960.2, C961.2, C962.2, C963.2, C964.2, C970.2, C971.2, C972.1, C973.2, C974.2, C980.2, C981.2, C982.1, C983.2, C984.2, C9021.2, C9022.2, C9031.2, C9032.2, C9041.2, C9042.2, C9051.2, C9052.2, C9071.2, C9072.2, D901.2 (A), D902.2 (A), D903.2 (A), Q904.3 (C), R904.2, R909.2, R919.2, R929.2, R936.2, R938.2, R952.2, R960.2, R962.2, R970.2, R972.2, R980.2, R982.2, R990.2, R992.2, RN910.7 (R2.2), RN916.7 (R2.2), RN917.7 (R2.2), RN927.7 (R2.2), TP967.1, TP968.1, TP972.1, U901.3 (GND), U901.4 (GND), U901.5 (GND), U901.8 (GND), U906.6 (ILIM), U906.9 (GND), U906.13 (GND), U908.6 (ILIM), U908.9 (GND), U908.13 (GND), U909.6 (ILIM), U909.9 (GND), U909.13 (GND), U910.6 (ILIM), U910.7 (VIOC), U910.9 (GND), U911.6 (ILIM), U911.7 (VIOC), U911.9 (GND)
MID_P_L: R905.1, TP966.1
N15A_L: C971.1, C972.2, C9022.1, C9032.1, C9042.1, C9052.1, C9072.1, R981.1, TP951.1, U902.4 (V-), U903.4 (V-), U904.4 (V-), U905.4 (V-), U907.4 (V-), U910.10 (OUTS), U910.11 (OUT), U910.12 (OUT)
N16A: C970.1, C980.1, U910.1 (IN), U910.2 (IN), U910.3 (EN/UV), U910.13 (IN), U911.1 (IN), U911.2 (IN), U911.3 (EN/UV), U911.13 (IN)
P5A_L: C921.1, C951.1, C952.1, Q903.3 (C), R920.1, R961.1, TP954.1, U908.10 (OUTS), U908.11 (OUT), U908.12 (OUT)
P15A_L: C961.1, C962.1, C9021.1, C9031.1, C9041.1, C9051.1, C9071.1, R901.1, R971.1, TP950.1, U902.8 (V+), U903.8 (V+), U904.8 (V+), U905.8 (V+), U907.8 (V+), U909.10 (OUTS), U909.11 (OUT), U909.12 (OUT)
P16A: C960.1, U909.1 (IN), U909.2 (IN), U909.3 (IN), U909.4 (EN/UV)
PADB_BASE_L: R940.2, TP963.1
PADB_EP_L: R933.1, TP964.1
PD_N: R934.2, R935.1, U907.2 (-)
PD_OUT: R935.2, R939.1, U907.1
PD_P: R933.2, R936.1, U907.3 (+)
PGF_U906: C944.1, R951.2, R952.1, U906.7 (PGFB)
PGF_U908: C954.1, R961.2, R962.1, U908.7 (PGFB)
PGF_U909: C964.1, R971.2, R972.1, U909.7 (PGFB)
PGF_U910: C974.1, R981.2, R982.1, U910.5 (PGFB)
PGF_U911: C984.1, R991.2, R992.1, U911.5 (PGFB)
PG_ALL: U906.5 (PG), U908.5 (PG), U909.5 (PG), U910.4 (PG), U911.4 (PG)
PI_N: C938.1, R939.2, U907.6 (-)
PI_OUT: C938.2, D902.1 (K), R940.1, U907.7
REF3V0: R903.2, R904.1, U902.5 (+)
REF3V57: R937.2, R938.1, U907.5 (+)
REF5: C903.1, R902.1, TP970.1, U901.6 (OUTS), U901.7 (OUTF)
REF5F: R903.1, R908.1, R937.1, RN910.1 (R1.1), RN916.1 (R1.1), RN917.1 (R1.1), TP971.1, U902.1, U902.2 (-), U905.3 (+)
REF5RC: C904.1, R902.2, U902.3 (+)
REF_VIN: C901.1, C902.1, R901.2, U901.1 (EN), U901.2 (VIN)
SET_U908: C953.1, R960.1, U908.8 (SET)
SET_U909: C963.1, R970.1, U909.8 (SET)
SET_U910: C973.1, R980.1, U910.8 (SET)
SET_U911: C983.1, R990.1, U911.8 (SET)
V4P3_LA: C950.1, TP956.1, U908.1 (IN), U908.2 (IN), U908.3 (IN), U908.4 (EN/UV)
V8P3: C940.1, TP955.1, U906.1 (IN), U906.2 (IN), U906.3 (IN), U906.4 (EN/UV)
VB1_BUF: R932.1, U905.6 (-), U905.7
VB1_E: Q902.1 (E), R928.2
VB1_L: C932.1, C933.1, R932.2, TP957.1
VB1_RAW: Q902.2 (B), Q902.3 (C), R929.1, U905.5 (+)
VCM_BN: Q903.1 (B), Q905.3 (C), R920.2, R921.1
VCM_BP: Q904.1 (B), Q905.2 (E), R922.2, R923.2
VCM_DRV: R923.1, U904.7
VCM_EN: Q903.2 (E), R924.1
VCM_EP: Q904.2 (E), R925.1
VCM_L: C919.1, C920.1, R926.2, TP958.1, U904.6 (-)
VCM_MB: Q905.1 (B), R921.2, R922.1
VCM_O: R924.2, R925.2, R926.1
VCM_SET: RN917.2 (R2.1), RN917.8 (R1.2), U904.5 (+)
VE1_FB: RN927.2 (R2.1), RN927.8 (R1.2), U905.2 (-)
VE1_L: C941.1, C942.1, R928.1, R951.1, TP953.1, U906.10 (OUTS), U906.11 (OUT), U906.12 (OUT)
VE1_SET_L: C943.1, RN927.1 (R1.1), TP965.1, U905.1, U906.8 (SET)
VEE15_L: C981.1, C982.2, R934.1, R991.1, TP952.1, U911.10 (OUTS), U911.11 (OUT), U911.12 (OUT)
VFR_B: Q901.1 (B), R918.2
VFR_DRV: D903.1 (K), R918.1, R943.1, U904.1
VFR_E: Q901.3 (E), R919.1
VFR_L: C917.1, C918.1, Q901.2 (C), Q901.4 (C), TP959.1, U904.3 (+)
VFR_N: C916.2, R942.2, U904.2 (-)
VFR_PI: C916.1, R943.2
VFR_SET: R942.1, RN916.2 (R2.1), RN916.8 (R1.2)
VREF_BUF: R914.1, U903.6 (-), U903.7
VREF_L: C914.1, C915.1, R914.2, TP960.1
VREF_SET: RN910.2 (R2.1), RN910.8 (R1.2), U903.5 (+)
VVG_BUF: R912.1, U903.1, U903.2 (-)
VVG_SET: R908.2, R909.1, U903.3 (+)
V_VG_L: C912.1, C913.1, R912.2, TP961.1

Notes on the sheet:
RAILS: DUAL-MONO POL (user rulings 2026-10-12, bom 17(m3)) - every POL LDO sits on the sheet it powers; only the pre-reg entry is on the POWER sheet. This sheet carries the L-channel analog housekeeping LDOs: P15A_L (U909), N15A_L (U910), VEE15_L (U911), VE1_L (U906), P5A_L (U908) - all PG -> PG_AL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
REFERENCE CHAIN (derived req. 6: one filtered node per channel): U901 REF7050 (ONE PER BOARD) -> R902/C904 4.99k + 10u film (3.2 Hz) -> U902A OPA1656 FET buffer = REF5F -> dividers (Susumu RG1608N 0.05 % 10 ppm discretes for V_VG/CASB2/PADB, best-tolerance ruling 2026-10-08; ACAS 0612 matched array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
SINKS/SOURCES: VFR = U904A + Q901 servoed NPN sink (150 mA); VCM = U904B + Q903/Q904 class-A pair on +3V3A/GND (I_q ~40 mA > 24 mA peak, Q905 V_be multiplier); VE1 = U906 LT3045 (bottom strip) (SET driven by U905A x1.44 via VE1_SET_L, from V8P3); VB1 = VE1 - [Q902 2SA1036K diode + 59.0 R] at 10 mA 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
PADB = U907 current servo: A = diff-amp 0.25 x (padb_ep - VEE15) [40.2k/10.0k], B = integrator vs 3.568 V tap -> 1k -> PADB_BASE (Cpadb 100u on CORE), 2.7 V clamp -> I_pad 50 mA independent of VEE15 and Si1555 V_th. Divider set-point errors (E96) are static and inside the 17(i) accuracy columns: V_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
P16A
+16.2 V pre-reg from the power tube -> +15 V-class LT3045/LT3094 POLs; in at J603/J604 stackers (driven: U7801 LM317 on PREREG)
N16A
-16.2 V pre-reg -> -15 V-class LT3094 POLs (N15A, VEE15); in at J603/J604 stackers (driven: U7802 LM337 on PREREG)
V8P3
+8.3 V pre-reg -> VE1 LT3045s (per channel); in at J603/J604 stackers (driven: U7901 TPS7A4501 on PREREG)
analog ground reference
1.8 V translator A-side + PG_ALL pull-up, supplied by the SoM (VCCIO_65_EX) - not generated on this board
+12 V SoM feed, SoM-only (switcher, 15 A planning figure) - Conn1/J506 SEAF 30-contact bank with GND perimeter; see docs/SEAF_PIN_ASSIGNMENTS.md
AP-side isolator supply, in at J506 SEAF-40 row-A pad 25 (AP domain)
AP-side ground (isolated domain)
CASB2_P and CASB2_M are ONE node here (servo output after R907); the 100 R gate stoppers Rg6_p/m on CORE separate the two gates (ruling 2026-10-01).
VCM: feedback from the VCM node (after 2.2 R) - the pair sources/sinks the +-24 mA RTZ-edge current at I_q ~41 mA (Nexperia models, refs_loop vcm: P(Q903) 0.08 W, P(Q904) 0.08 W, PM 160 deg, -0.33 mV on 23 mA pulses). Q905 thermally coupled to Q903/Q904.
VE1 = U906 LT3045 (bottom strip) from V8P3: SET = VE1_SET_L (this op-amp, stiff source - the LT3045 reference-noise term is removed). (8.3 - 7.2) V x 150 mA = 0.17 W per channel (17(l) headroom table).
VB1 = VE1 - V_eb(Q902) - I x R928: dVB1/dV_eb = -R929/(R928+R929) = -0.91 -> QR1 current tempco +0.039 %/K vs +0.435 %/K fixed (11x, refs_loop vb1); static V_eb spread absorbed by the ID campaign.
PADB: 0.25 x (padb_ep - VEE15) = 3.575 V at 50 mA; diff-amp inputs sit at ~ -0.14 V (inside the OPA1656 CM range). Integrator polarity: I high -> PD_OUT high -> gate falls. Cpadb 100u (CORE C3) + R940 1k = 1.6 Hz gate filter; D902 bounds start-up current to ~57 mA. p/m share the gate: I_m = I_p +- 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
PER-CHANNEL POL LDOs (dual-mono 17(m3)): LT3045 positive / LT3094 negative. EN/UV->IN (autostart), ILIM->GND (max limit), VIOC->GND (LT3094, upstream tracking unused). PGFB: OUT->Rtop->PGFB->10k->GND + 1 nF (+-0.30 V trip = ~90 % of rail). PG open-collector -> PG_ALL. SET: 100 uA x R_SET (+4.7 uF);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
U906 VE1 = +7.2 V, 150 mA - SET driven by U905A (VE1_SET_L)
U908 +3V3A VCM-stage rail, ~50 mA (fed from branch LA)
U909 P15A = +15 V op-amp rail, ~60 mA
U910 N15A = -15 V op-amp rail, ~90 mA
U911 VEE15 = -15 V cell/Rpad sink, ~160 mA
TEST POINTS (TP rules c/d): every POL rail and every reference/bias node on hook pads; GND pads at the end of each row. Precision nodes (VREF/VFR/VCM/VB1/V_VG) are buffered/stiff - a 10 Meg probe is safe.
