ccroswhite/BFDAC/hw/kicad/refs_r.kicad_sch

## KiCad design hw/kicad/refs_r.kicad_sch (2026-11-04)

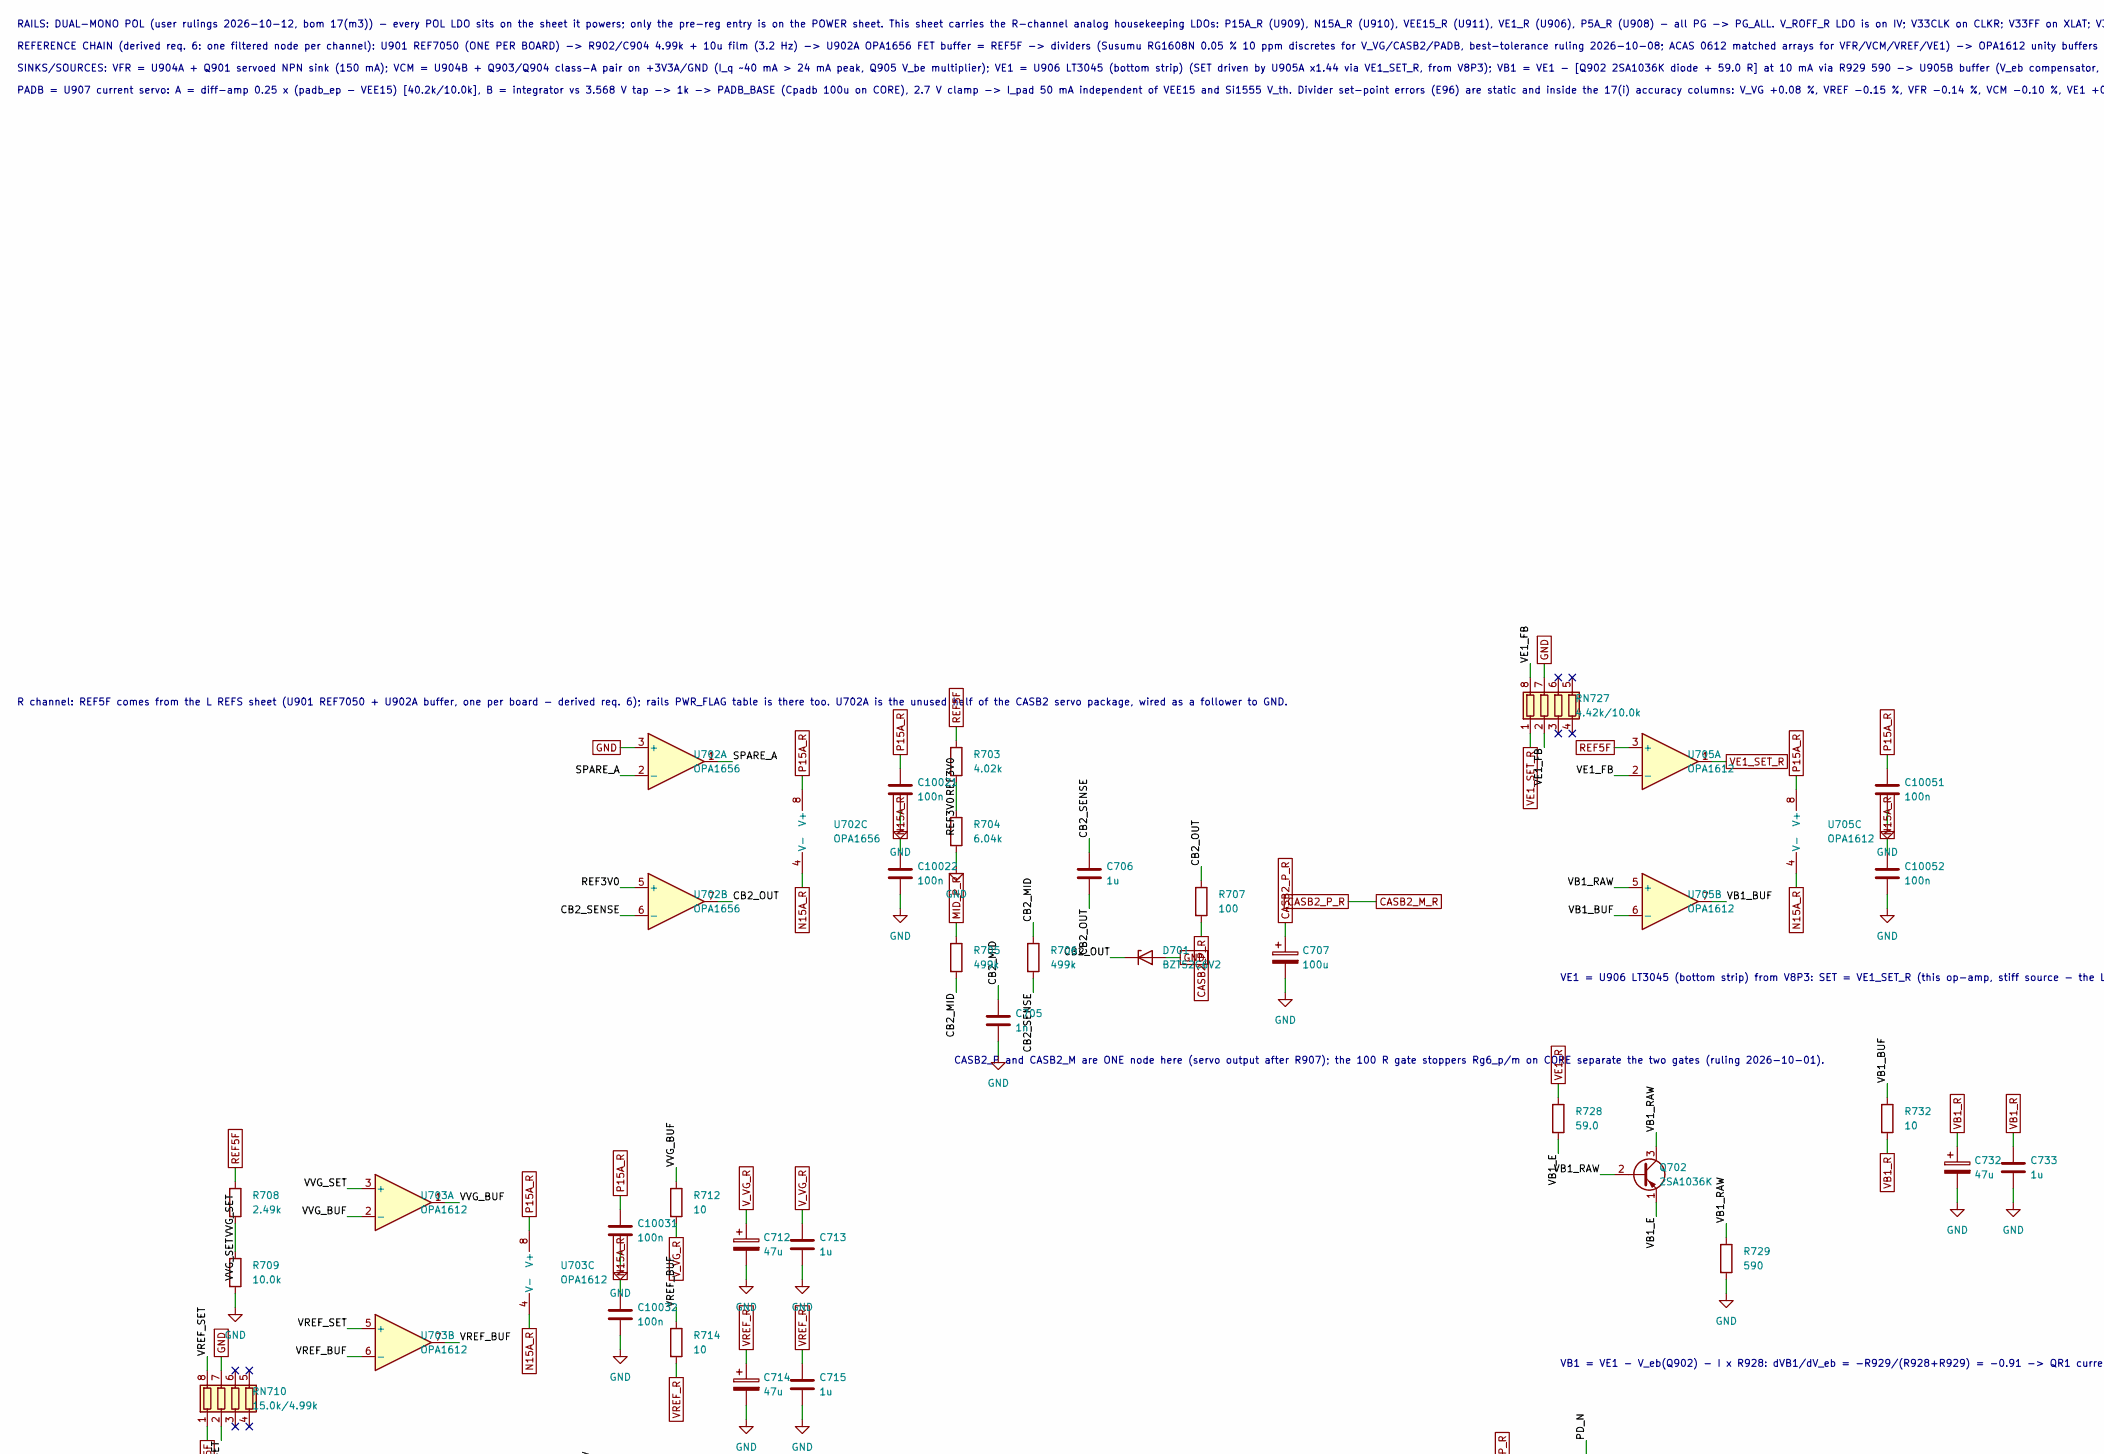
[picture p30: schematic refs_r.kicad_sch, part in row 1, column 1]

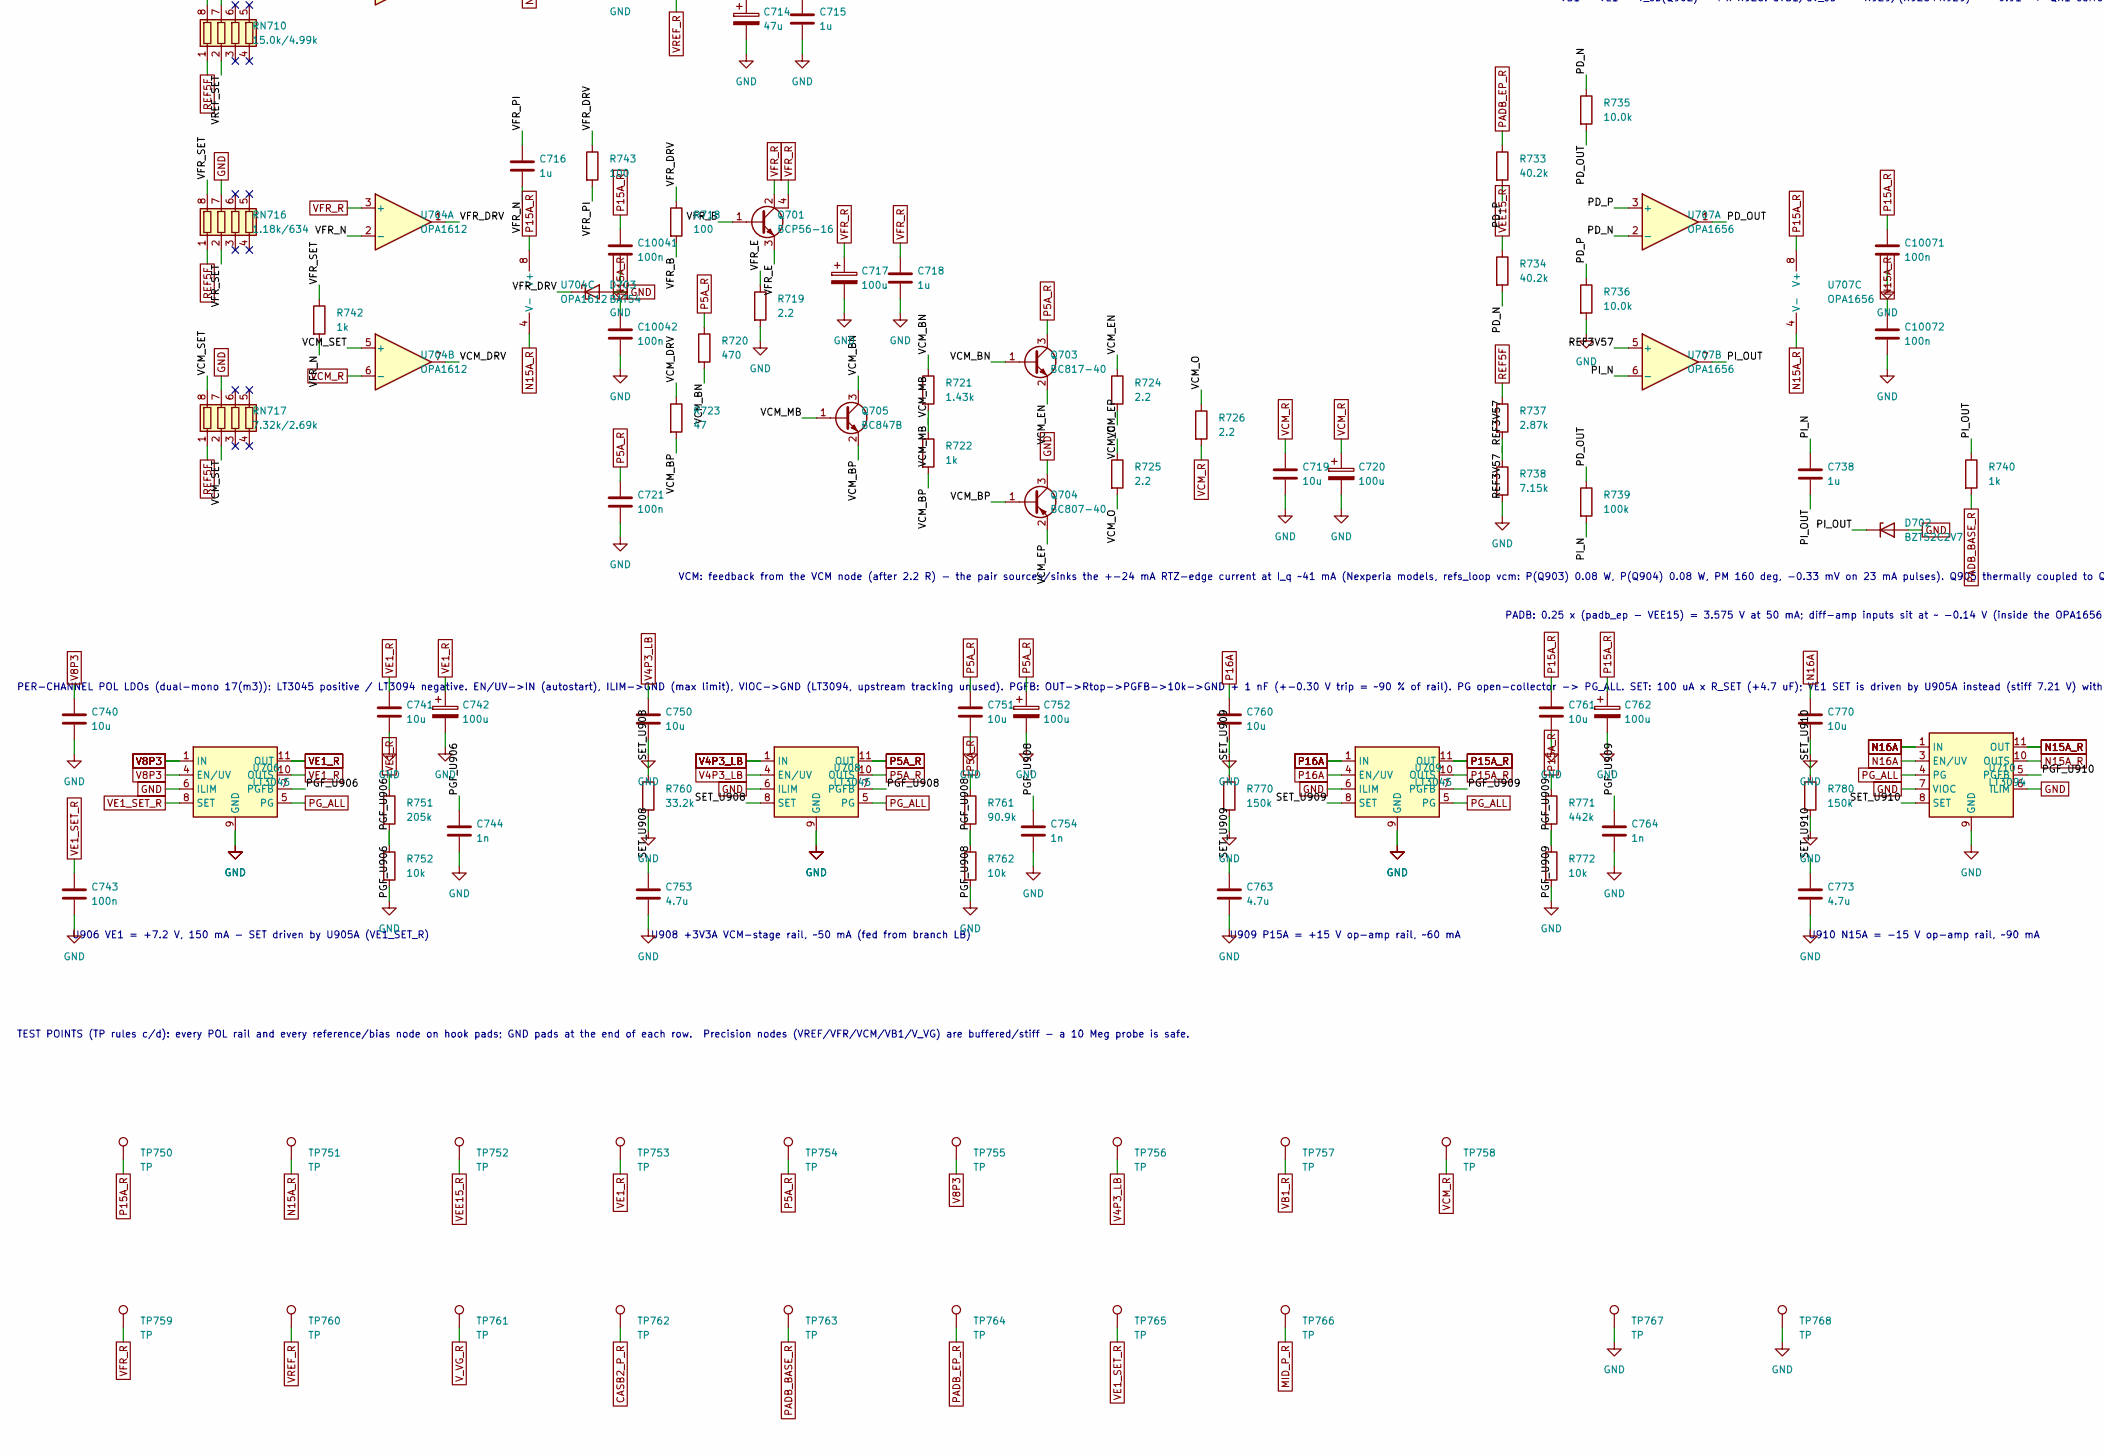
[picture p31: schematic refs_r.kicad_sch, part in row 2, column 1]

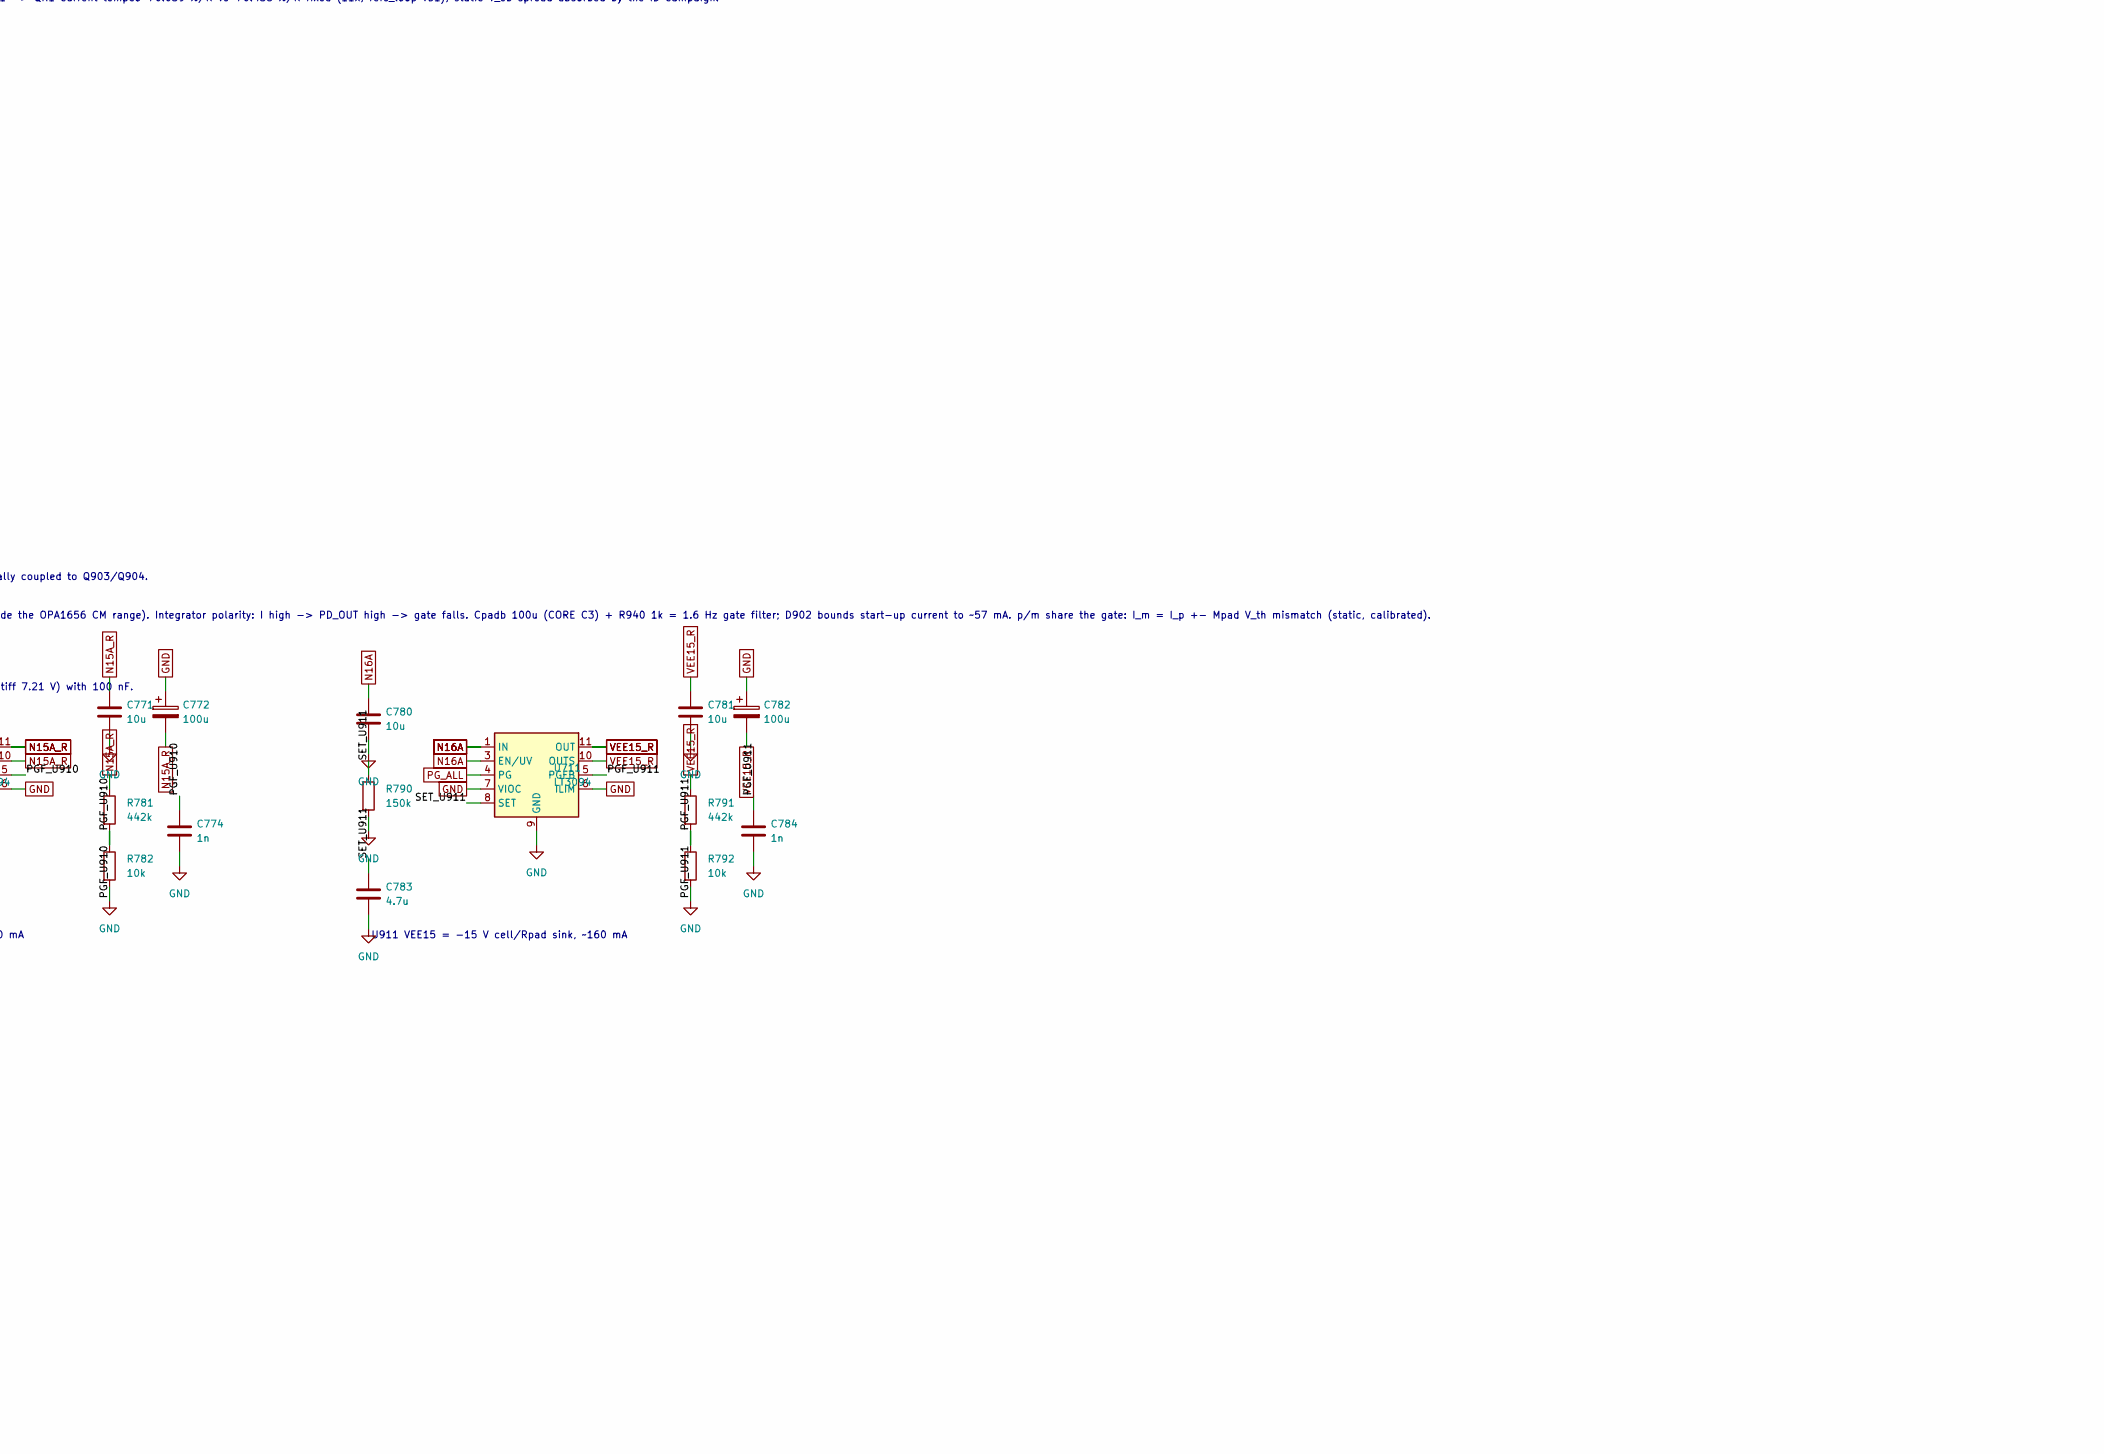
[picture p32: schematic refs_r.kicad_sch, part in row 2, column 2]

Parts:
C705, C744, C754, C764, C774, C784: 1n; C_0603_1608Metric; MPN GRM1885C1H102JA01D
C706, C716, C738: 1u; C_Rect_L7.2mm_W2.5mm_P5.00mm_FKS2_FKP2_MKS2_MKP2; MPN MKS2C041001F00KSSD
C707, C717, C720, C742, C752, C762, C772, C782: 100u; CP_Radial_D6.3mm_P2.50mm; MPN UKL1C101MED
C712, C714, C732: 47u; CP_Radial_D5.0mm_P2.50mm; MPN UKL1E470MDD
C713, C715, C718, C733: 1u; C_1206_3216Metric; MPN GRM31C5C1E105JA01L
C719, C740, C741, C750, C751, C760, C761, C770, C771, C780, C781: 10u; C_1206_3216Metric; MPN GRM31CR71E106KA12L
C721, C743, C10021, C10022, C10031, C10032, C10041, C10042, C10051, C10052, C10071, C10072: 100n; C_0603_1608Metric; MPN GRM188R71H104KA93D
C753, C763, C773, C783: 4.7u; C_0805_2012Metric; MPN GRM21BR71E475KA73L
D701: BZT52C6V2; D_SOD-123; MPN BZT52C6V2-7-F
D702: BZT52C2V7; D_SOD-123; MPN BZT52C2V7-7-F
D703: BAT54; SOT-23; MPN BAT54,215
Q701: BCP56-16; SOT-223; MPN BCP56-16,115
Q702: 2SA1036K; SC-59; MPN 2SA1036KT146Q
Q703: BC817-40; SOT-23; MPN BC817-40,215
Q704: BC807-40; SOT-23; MPN BC807-40,215
Q705: BC847B; SOT-23; MPN BC847B,215
R703: 4.02k; R_0603_1608Metric; MPN RG1608N-4021-W-T1
R704: 6.04k; R_0603_1608Metric; MPN RG1608N-6041-W-T1
R705, R706: 499k; R_0603_1608Metric; MPN RG1608P-4993-B-T5
R707, R718: 100; R_0603_1608Metric; MPN RG1608N-1000-W-T1
R708: 2.49k; R_0603_1608Metric; MPN RG1608N-2491-W-T1
R709, R735, R736: 10.0k; R_0603_1608Metric; MPN RG1608N-1002-W-T1
R712, R714, R732: 10; R_0603_1608Metric; MPN TNPW060310R0FEEA
R719, R724, R725, R726: 2.2; R_0603_1608Metric; MPN TNPW06032R20FEEA
R720: 470; R_0603_1608Metric; MPN TNPW0603470RFEEA
R721: 1.43k; R_0603_1608Metric; MPN TNPW06031K43FEEA
R722: 1k; R_0603_1608Metric; MPN TNPW06031K00FEEA
R723: 47; R_0603_1608Metric; MPN TNPW060347R0FEEA
R728: 59.0; R_0603_1608Metric; MPN RG1608N-59R0-W-T1
R729: 590; R_0603_1608Metric; MPN RG1608N-5900-W-T1
R733, R734: 40.2k; R_0603_1608Metric; MPN RG1608N-4022-W-T1
R737: 2.87k; R_0603_1608Metric; MPN RG1608N-2871-W-T1
R738: 7.15k; R_0603_1608Metric; MPN RG1608N-7151-W-T1
R739: 100k; R_0603_1608Metric; MPN RG1608N-1003-W-T1
R740, R742: 1k; R_0603_1608Metric; MPN RG1608N-1001-W-T1
R743: 100; R_0603_1608Metric; MPN TNPW0603100RFEEA
R751: 205k; R_0603_1608Metric; MPN RG1608N-2053-W-T1
R752, R762, R772, R782, R792: 10k; R_0603_1608Metric; MPN RG1608N-1002-W-T1
R760: 33.2k; R_0603_1608Metric; MPN RG1608N-3322-W-T1
R761: 90.9k; R_0603_1608Metric; MPN RG1608N-9092-W-T1
R770, R780, R790: 150k; R_0603_1608Metric; MPN RG1608N-1503-W-T1
R771, R781, R791: 442k; R_0603_1608Metric; MPN RG1608N-4423-W-T1
RN710: 15.0k/4.99k; R_Array_Convex_4x0612; MPN ACASA15024991P1AT
RN716: 1.18k/634; R_Array_Convex_4x0612; MPN ACASA11816340P1AT
RN717: 7.32k/2.69k; R_Array_Convex_4x0612; MPN ACASA73212691P1AT
RN727: 4.42k/10.0k; R_Array_Convex_4x0612; MPN ACASA44211002P1AT
TP750, TP751, TP752, TP753, TP754, TP755, TP756, TP757, TP758, TP759, TP760, TP761, TP762, TP763, TP764, TP765, TP766, TP767, TP768: TP; TestPoint_THTPad_2.0x2.0mm_Drill1.0mm
U702, U707: OPA1656; SOIC-8_3.9x4.9mm_P1.27mm; MPN OPA1656ID
U703, U704, U705: OPA1612; TI_OPA1612_DRG_WSON-8_3x3mm_P0.5mm_EP1.2x2.0mm; MPN OPA1612AIDRGR
U706, U708, U709: LT3045; MSOP-12-1EP_3x4.039mm_P0.65mm_EP1.651x2.845mm_ThermalVias; MPN LT3045EMSE#PBF
U710, U711: LT3094; MSOP-12-1EP_3x4.039mm_P0.65mm_EP1.651x2.845mm_ThermalVias; MPN LT3094EMSE#PBF

Connections:
CASB2_M_R: C707.1, R707.2, TP762.1
CB2_MID: C705.1, R705.2, R706.1
CB2_OUT: C706.2, D701.1 (K), R707.1, U702.7
CB2_SENSE: C706.1, R706.2, U702.6 (-)
GND: C705.2, C707.2, C712.2, C713.2, C714.2, C715.2, C717.2, C718.2, C719.2, C720.2, C721.2, C732.2, C733.2, C740.2, C741.2, C742.2, C743.2, C744.2, C750.2, C751.2, C752.2, C753.2, C754.2, C760.2, C761.2, C762.2, C763.2, C764.2, C770.2, C771.2, C772.1, C773.2, C774.2, C780.2, C781.2, C782.1, C783.2, C784.2, C10021.2, C10022.2, C10031.2, C10032.2, C10041.2, C10042.2, C10051.2, C10052.2, C10071.2, C10072.2, D701.2 (A), D702.2 (A), D703.2 (A), Q704.3 (C), R704.2, R709.2, R719.2, R729.2, R736.2, R738.2, R752.2, R760.2, R762.2, R770.2, R772.2, R780.2, R782.2, R790.2, R792.2, RN710.7 (R2.2), RN716.7 (R2.2), RN717.7 (R2.2), RN727.7 (R2.2), TP767.1, TP768.1, U702.3 (+), U706.6 (ILIM), U706.9 (GND), U706.13 (GND), U708.6 (ILIM), U708.9 (GND), U708.13 (GND), U709.6 (ILIM), U709.9 (GND), U709.13 (GND), U710.6 (ILIM), U710.7 (VIOC), U710.9 (GND), U711.6 (ILIM), U711.7 (VIOC), U711.9 (GND)
MID_P_R: R705.1, TP766.1
N15A_R: C771.1, C772.2, C10022.1, C10032.1, C10042.1, C10052.1, C10072.1, R781.1, TP751.1, U702.4 (V-), U703.4 (V-), U704.4 (V-), U705.4 (V-), U707.4 (V-), U710.10 (OUTS), U710.11 (OUT), U710.12 (OUT)
N16A: C770.1, C780.1, U710.1 (IN), U710.2 (IN), U710.3 (EN/UV), U710.13 (IN), U711.1 (IN), U711.2 (IN), U711.3 (EN/UV), U711.13 (IN)
P5A_R: C721.1, C751.1, C752.1, Q703.3 (C), R720.1, R761.1, TP754.1, U708.10 (OUTS), U708.11 (OUT), U708.12 (OUT)
P15A_R: C761.1, C762.1, C10021.1, C10031.1, C10041.1, C10051.1, C10071.1, R771.1, TP750.1, U702.8 (V+), U703.8 (V+), U704.8 (V+), U705.8 (V+), U707.8 (V+), U709.10 (OUTS), U709.11 (OUT), U709.12 (OUT)
P16A: C760.1, U709.1 (IN), U709.2 (IN), U709.3 (IN), U709.4 (EN/UV)
PADB_BASE_R: R740.2, TP763.1
PADB_EP_R: R733.1, TP764.1
PD_N: R734.2, R735.1, U707.2 (-)
PD_OUT: R735.2, R739.1, U707.1
PD_P: R733.2, R736.1, U707.3 (+)
PGF_U906: C744.1, R751.2, R752.1, U706.7 (PGFB)
PGF_U908: C754.1, R761.2, R762.1, U708.7 (PGFB)
PGF_U909: C764.1, R771.2, R772.1, U709.7 (PGFB)
PGF_U910: C774.1, R781.2, R782.1, U710.5 (PGFB)
PGF_U911: C784.1, R791.2, R792.1, U711.5 (PGFB)
PG_ALL: U706.5 (PG), U708.5 (PG), U709.5 (PG), U710.4 (PG), U711.4 (PG)
PI_N: C738.1, R739.2, U707.6 (-)
PI_OUT: C738.2, D702.1 (K), R740.1, U707.7
REF3V0: R703.2, R704.1, U702.5 (+)
REF3V57: R737.2, R738.1, U707.5 (+)
REF5F: R703.1, R708.1, R737.1, RN710.1 (R1.1), RN716.1 (R1.1), RN717.1 (R1.1), U705.3 (+)
SET_U908: C753.1, R760.1, U708.8 (SET)
SET_U909: C763.1, R770.1, U709.8 (SET)
SET_U910: C773.1, R780.1, U710.8 (SET)
SET_U911: C783.1, R790.1, U711.8 (SET)
SPARE_A: U702.1, U702.2 (-)
V4P3_LB: C750.1, TP756.1, U708.1 (IN), U708.2 (IN), U708.3 (IN), U708.4 (EN/UV)
V8P3: C740.1, TP755.1, U706.1 (IN), U706.2 (IN), U706.3 (IN), U706.4 (EN/UV)
VB1_BUF: R732.1, U705.6 (-), U705.7
VB1_E: Q702.1 (E), R728.2
VB1_R: C732.1, C733.1, R732.2, TP757.1
VB1_RAW: Q702.2 (B), Q702.3 (C), R729.1, U705.5 (+)
VCM_BN: Q703.1 (B), Q705.3 (C), R720.2, R721.1
VCM_BP: Q704.1 (B), Q705.2 (E), R722.2, R723.2
VCM_DRV: R723.1, U704.7
VCM_EN: Q703.2 (E), R724.1
VCM_EP: Q704.2 (E), R725.1
VCM_MB: Q705.1 (B), R721.2, R722.1
VCM_O: R724.2, R725.2, R726.1
VCM_R: C719.1, C720.1, R726.2, TP758.1, U704.6 (-)
VCM_SET: RN717.2 (R2.1), RN717.8 (R1.2), U704.5 (+)
VE1_FB: RN727.2 (R2.1), RN727.8 (R1.2), U705.2 (-)
VE1_R: C741.1, C742.1, R728.1, R751.1, TP753.1, U706.10 (OUTS), U706.11 (OUT), U706.12 (OUT)
VE1_SET_R: C743.1, RN727.1 (R1.1), TP765.1, U705.1, U706.8 (SET)
VEE15_R: C781.1, C782.2, R734.1, R791.1, TP752.1, U711.10 (OUTS), U711.11 (OUT), U711.12 (OUT)
VFR_B: Q701.1 (B), R718.2
VFR_DRV: D703.1 (K), R718.1, R743.1, U704.1
VFR_E: Q701.3 (E), R719.1
VFR_N: C716.2, R742.2, U704.2 (-)
VFR_PI: C716.1, R743.2
VFR_R: C717.1, C718.1, Q701.2 (C), Q701.4 (C), TP759.1, U704.3 (+)
VFR_SET: R742.1, RN716.2 (R2.1), RN716.8 (R1.2)
VREF_BUF: R714.1, U703.6 (-), U703.7
VREF_R: C714.1, C715.1, R714.2, TP760.1
VREF_SET: RN710.2 (R2.1), RN710.8 (R1.2), U703.5 (+)
VVG_BUF: R712.1, U703.1, U703.2 (-)
VVG_SET: R708.2, R709.1, U703.3 (+)
V_VG_R: C712.1, C713.1, R712.2, TP761.1

Notes on the sheet:
RAILS: DUAL-MONO POL (user rulings 2026-10-12, bom 17(m3)) - every POL LDO sits on the sheet it powers; only the pre-reg entry is on the POWER sheet. This sheet carries the R-channel analog housekeeping LDOs: P15A_R (U909), N15A_R (U910), VEE15_R (U911), VE1_R (U906), P5A_R (U908) - all PG -> PG_AL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
REFERENCE CHAIN (derived req. 6: one filtered node per channel): U901 REF7050 (ONE PER BOARD) -> R902/C904 4.99k + 10u film (3.2 Hz) -> U902A OPA1656 FET buffer = REF5F -> dividers (Susumu RG1608N 0.05 % 10 ppm discretes for V_VG/CASB2/PADB, best-tolerance ruling 2026-10-08; ACAS 0612 matched array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
SINKS/SOURCES: VFR = U904A + Q901 servoed NPN sink (150 mA); VCM = U904B + Q903/Q904 class-A pair on +3V3A/GND (I_q ~40 mA > 24 mA peak, Q905 V_be multiplier); VE1 = U906 LT3045 (bottom strip) (SET driven by U905A x1.44 via VE1_SET_R, from V8P3); VB1 = VE1 - [Q902 2SA1036K diode + 59.0 R] at 10 mA 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
PADB = U907 current servo: A = diff-amp 0.25 x (padb_ep - VEE15) [40.2k/10.0k], B = integrator vs 3.568 V tap -> 1k -> PADB_BASE (Cpadb 100u on CORE), 2.7 V clamp -> I_pad 50 mA independent of VEE15 and Si1555 V_th. Divider set-point errors (E96) are static and inside the 17(i) accuracy columns: V_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
R channel: REF5F comes from the L REFS sheet (U901 REF7050 + U902A buffer, one per board - derived req. 6); rails PWR_FLAG table is there too. U702A is the unused half of the CASB2 servo package, wired as a follower to GND.
CASB2_P and CASB2_M are ONE node here (servo output after R907); the 100 R gate stoppers Rg6_p/m on CORE separate the two gates (ruling 2026-10-01).
VCM: feedback from the VCM node (after 2.2 R) - the pair sources/sinks the +-24 mA RTZ-edge current at I_q ~41 mA (Nexperia models, refs_loop vcm: P(Q903) 0.08 W, P(Q904) 0.08 W, PM 160 deg, -0.33 mV on 23 mA pulses). Q905 thermally coupled to Q903/Q904.
VE1 = U906 LT3045 (bottom strip) from V8P3: SET = VE1_SET_R (this op-amp, stiff source - the LT3045 reference-noise term is removed). (8.3 - 7.2) V x 150 mA = 0.17 W per channel (17(l) headroom table).
VB1 = VE1 - V_eb(Q902) - I x R928: dVB1/dV_eb = -R929/(R928+R929) = -0.91 -> QR1 current tempco +0.039 %/K vs +0.435 %/K fixed (11x, refs_loop vb1); static V_eb spread absorbed by the ID campaign.
PADB: 0.25 x (padb_ep - VEE15) = 3.575 V at 50 mA; diff-amp inputs sit at ~ -0.14 V (inside the OPA1656 CM range). Integrator polarity: I high -> PD_OUT high -> gate falls. Cpadb 100u (CORE C3) + R940 1k = 1.6 Hz gate filter; D902 bounds start-up current to ~57 mA. p/m share the gate: I_m = I_p +- 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
PER-CHANNEL POL LDOs (dual-mono 17(m3)): LT3045 positive / LT3094 negative. EN/UV->IN (autostart), ILIM->GND (max limit), VIOC->GND (LT3094, upstream tracking unused). PGFB: OUT->Rtop->PGFB->10k->GND + 1 nF (+-0.30 V trip = ~90 % of rail). PG open-collector -> PG_ALL. SET: 100 uA x R_SET (+4.7 uF);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
U906 VE1 = +7.2 V, 150 mA - SET driven by U905A (VE1_SET_R)
U908 +3V3A VCM-stage rail, ~50 mA (fed from branch LB)
U909 P15A = +15 V op-amp rail, ~60 mA
U910 N15A = -15 V op-amp rail, ~90 mA
U911 VEE15 = -15 V cell/Rpad sink, ~160 mA
TEST POINTS (TP rules c/d): every POL rail and every reference/bias node on hook pads; GND pads at the end of each row. Precision nodes (VREF/VFR/VCM/VB1/V_VG) are buffered/stiff - a 10 Meg probe is safe.
