ccroswhite/BFDAC/hw/kicad/som.kicad_sch

## KiCad design hw/kicad/som.kicad_sch (2026-11-04)

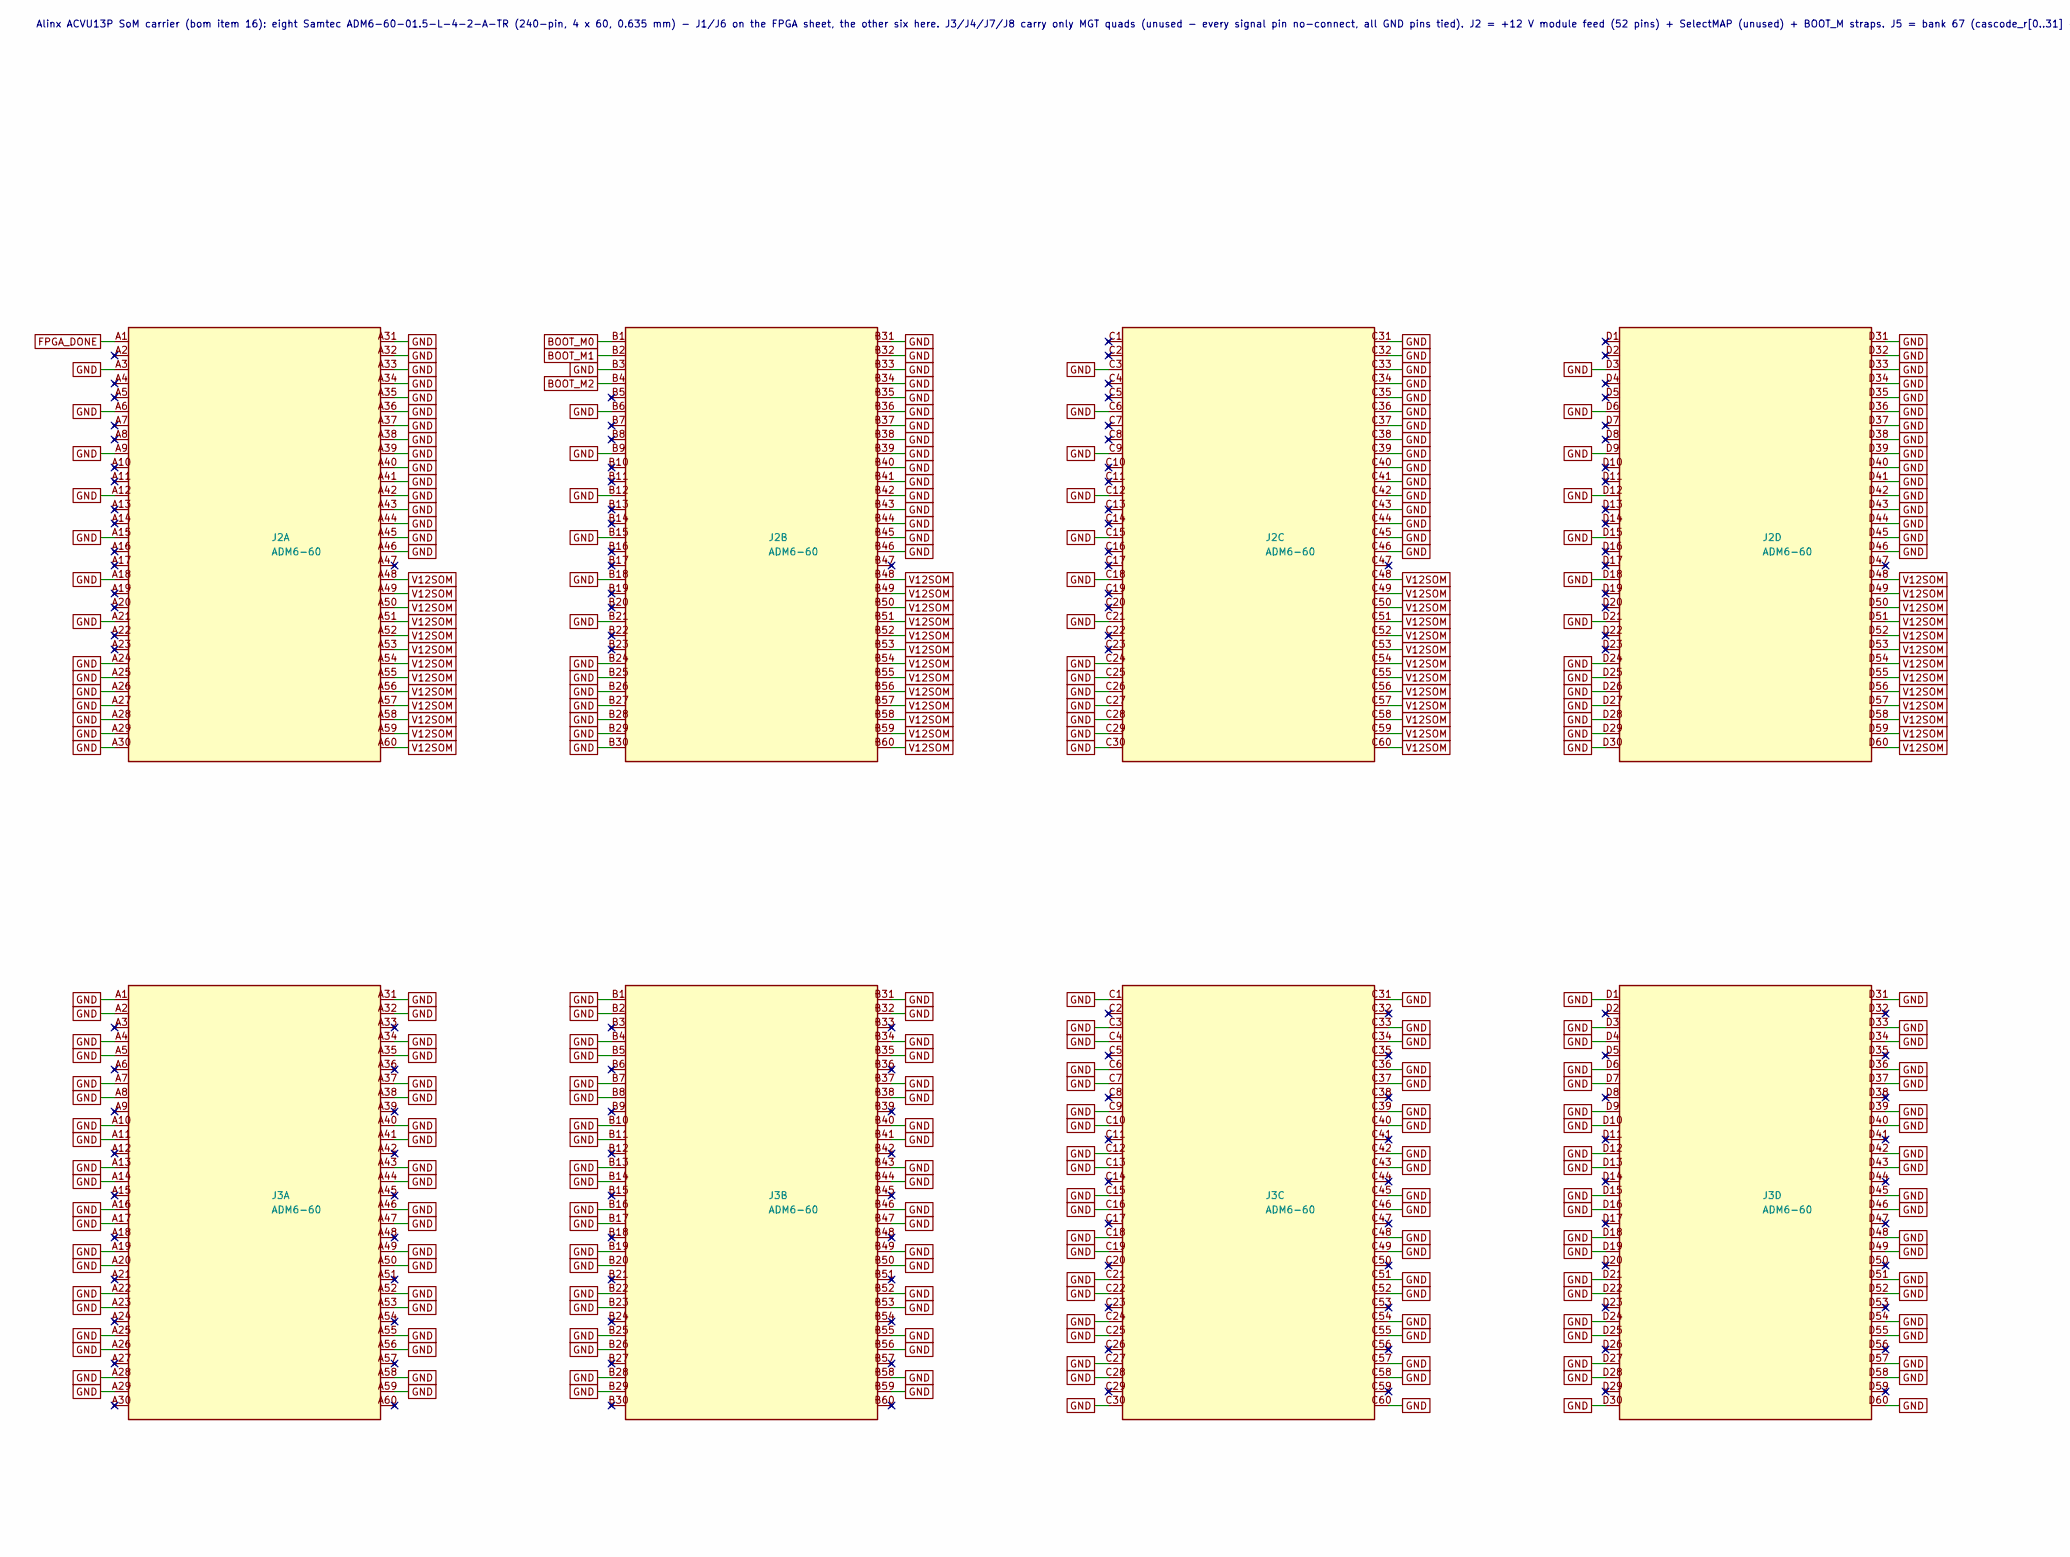
[picture p33: schematic som.kicad_sch, part in row 1, column 1]

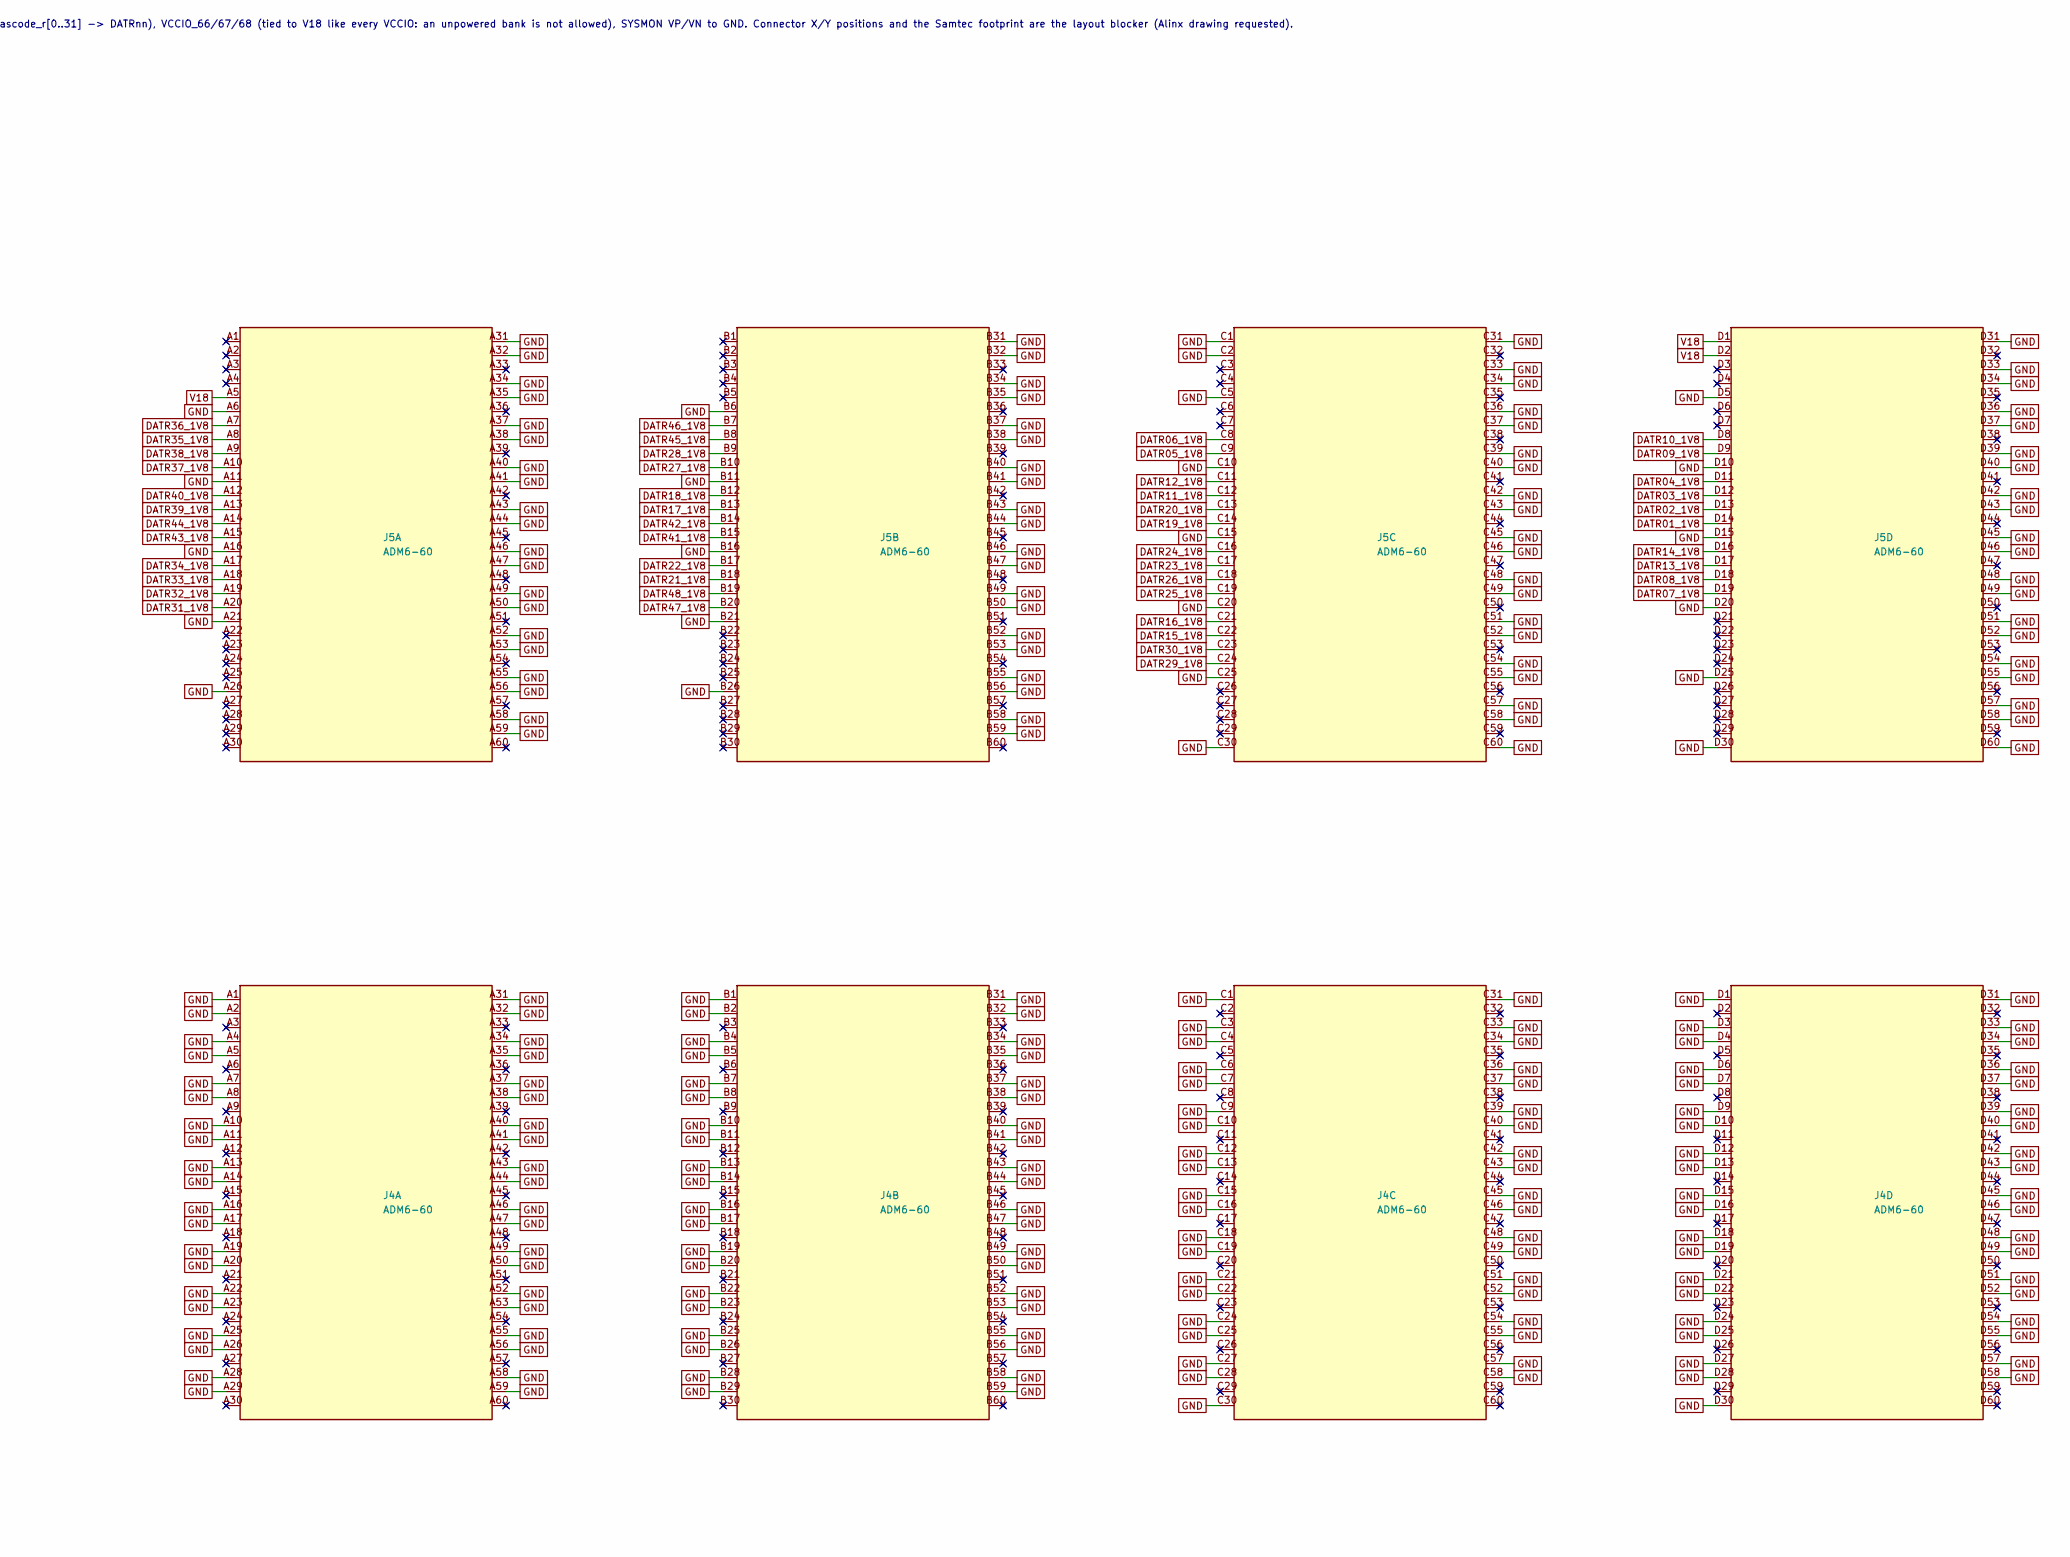
[picture p34: schematic som.kicad_sch, part in row 1, column 2]

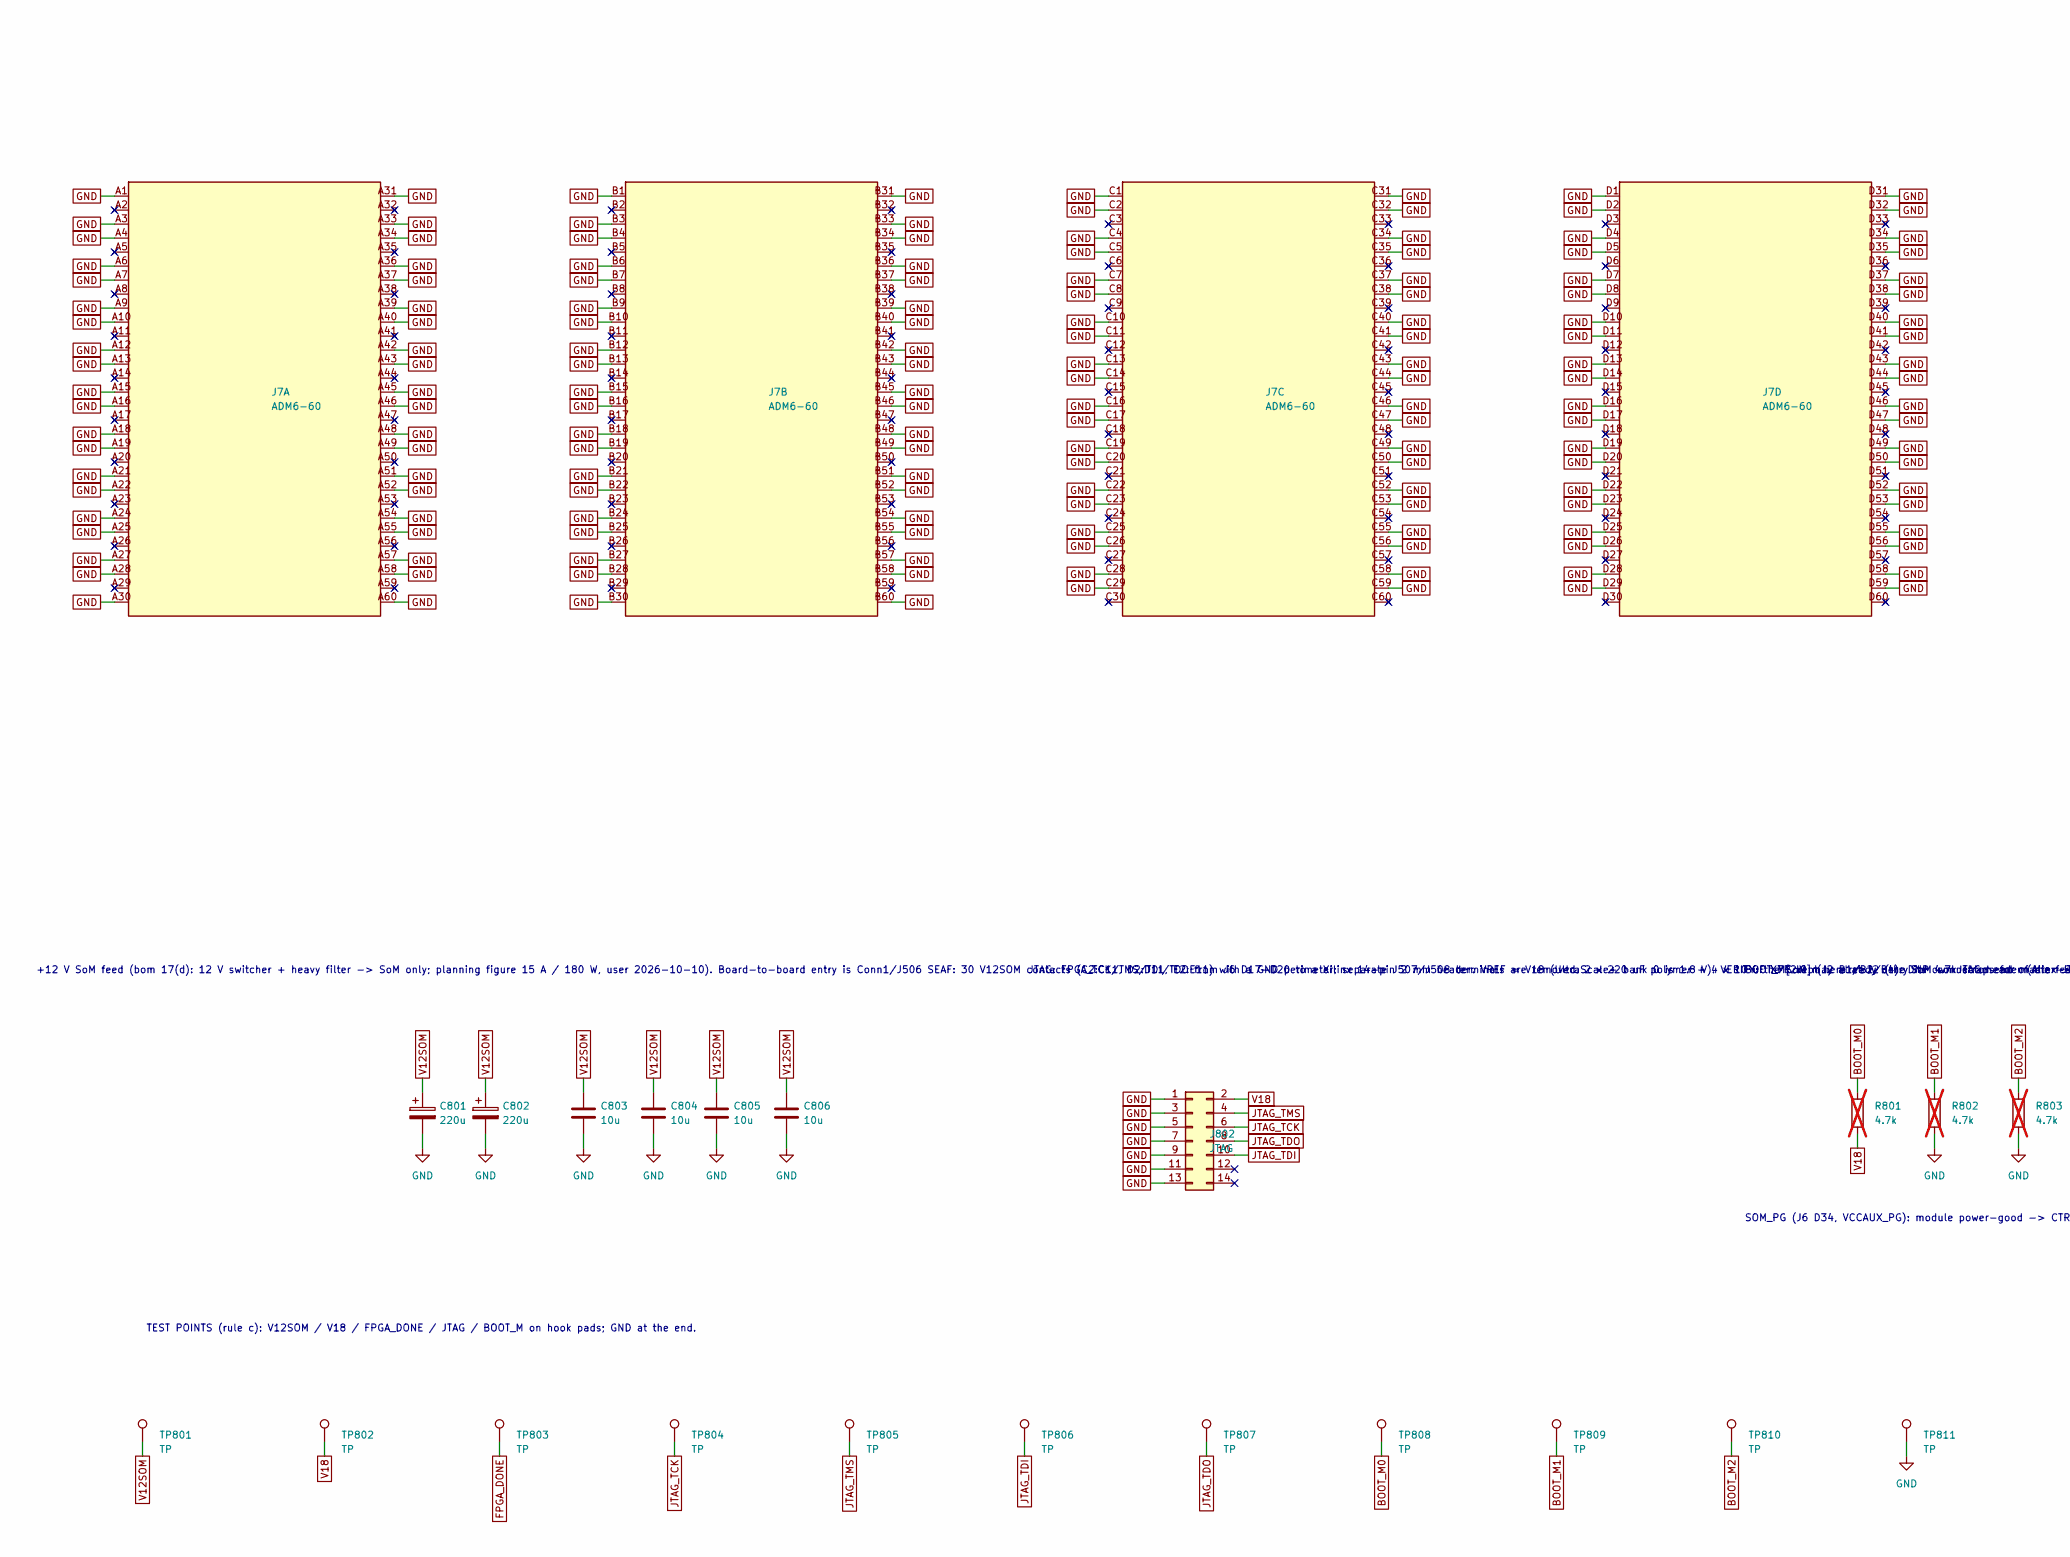
[picture p35: schematic som.kicad_sch, part in row 2, column 1]

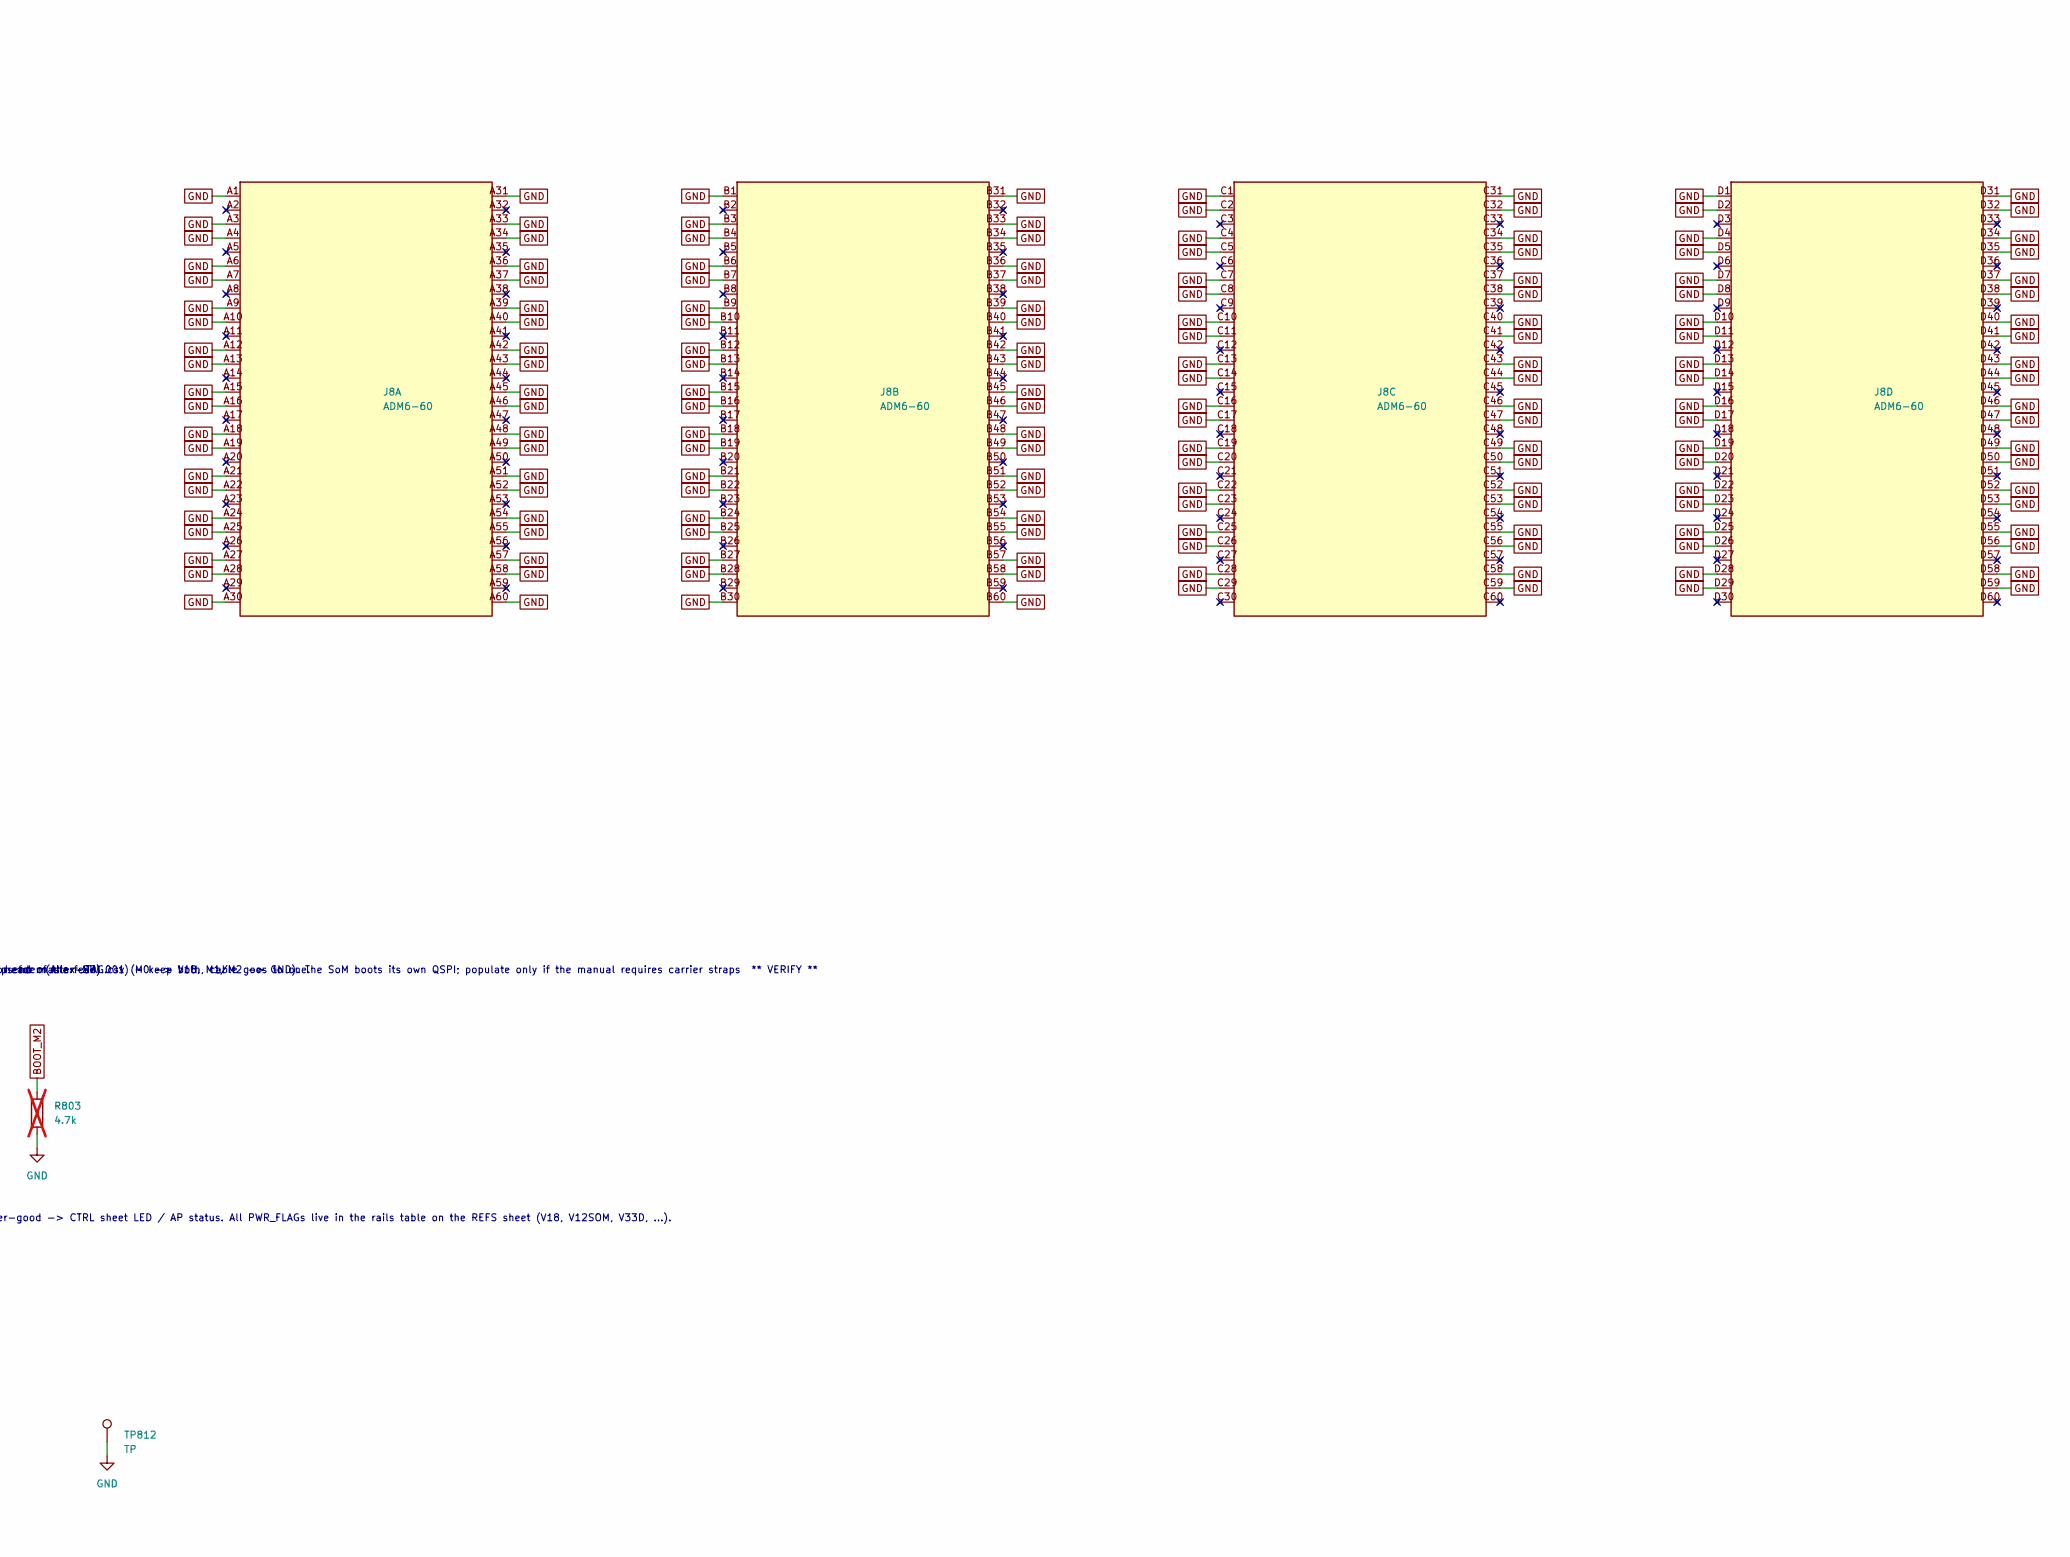
[picture p36: schematic som.kicad_sch, part in row 2, column 2]

Parts:
C801, C802: 220u; CP_Elec_8x10.5; MPN 25SVPF220M
C803, C804, C805, C806: 10u; C_1206_3216Metric; MPN GRM31CR71E106KA12L
J2, J3, J4, J5, J7, J8: ADM6-60; Samtec_ADM6-60-01.5-L-4-2-A; MPN ADM6-60-01.5-L-4-2-A-TR
J802: JTAG; PinHeader_2x07_P2.00mm_Vertical; MPN 87832-1420
R801, R802, R803: 4.7k; R_0603_1608Metric; MPN CRCW06034K70FKEA; not fitted
TP801, TP802, TP803, TP804, TP805, TP806, TP807, TP808, TP809, TP810, TP811, TP812: TP; TestPoint_THTPad_2.0x2.0mm_Drill1.0mm

Connections:
BOOT_M0: J2.B1 (BOOT_M0), R801.1, TP808.1
BOOT_M1: J2.B2 (BOOT_M1), R802.1, TP809.1
BOOT_M2: J2.B4 (BOOT_M2), R803.1, TP810.1
DATR01_1V8: J5.D14 (DATR01)
DATR02_1V8: J5.D13 (DATR02)
DATR03_1V8: J5.D12 (DATR03)
DATR04_1V8: J5.D11 (DATR04)
DATR05_1V8: J5.C9 (DATR05)
DATR06_1V8: J5.C8 (DATR06)
DATR07_1V8: J5.D19 (DATR07)
DATR08_1V8: J5.D18 (DATR08)
DATR09_1V8: J5.D9 (DATR09)
DATR10_1V8: J5.D8 (DATR10)
DATR11_1V8: J5.C12 (DATR11)
DATR12_1V8: J5.C11 (DATR12)
DATR13_1V8: J5.D17 (DATR13)
DATR14_1V8: J5.D16 (DATR14)
DATR15_1V8: J5.C22 (DATR15)
DATR16_1V8: J5.C21 (DATR16)
DATR17_1V8: J5.B13 (DATR17)
DATR18_1V8: J5.B12 (DATR18)
DATR19_1V8: J5.C14 (DATR19)
DATR20_1V8: J5.C13 (DATR20)
DATR21_1V8: J5.B18 (DATR21)
DATR22_1V8: J5.B17 (DATR22)
DATR23_1V8: J5.C17 (DATR23)
DATR24_1V8: J5.C16 (DATR24)
DATR25_1V8: J5.C19 (DATR25)
DATR26_1V8: J5.C18 (DATR26)
DATR27_1V8: J5.B10 (DATR27)
DATR28_1V8: J5.B9 (DATR28)
DATR29_1V8: J5.C24 (DATR29)
DATR30_1V8: J5.C23 (DATR30)
DATR31_1V8: J5.A20 (DATR31)
DATR32_1V8: J5.A19 (DATR32)
DATR33_1V8: J5.A18 (DATR33)
DATR34_1V8: J5.A17 (DATR34)
DATR35_1V8: J5.A8 (DATR35)
DATR36_1V8: J5.A7 (DATR36)
DATR37_1V8: J5.A10 (DATR37)
DATR38_1V8: J5.A9 (DATR38)
DATR39_1V8: J5.A13 (DATR39)
DATR40_1V8: J5.A12 (DATR40)
DATR41_1V8: J5.B15 (DATR41)
DATR42_1V8: J5.B14 (DATR42)
DATR43_1V8: J5.A15 (DATR43)
DATR44_1V8: J5.A14 (DATR44)
DATR45_1V8: J5.B8 (DATR45)
DATR46_1V8: J5.B7 (DATR46)
DATR47_1V8: J5.B20 (DATR47)
DATR48_1V8: J5.B19 (DATR48)
FPGA_DONE: J2.A1 (FPGA_DONE), TP803.1
GND: C801.2, C802.2, C803.2, C804.2, C805.2, C806.2, J2.A3 (GND), J2.A6 (GND), J2.A9 (GND), J2.A12 (GND), J2.A15 (GND), J2.A18 (GND), J2.A21 (GND), J2.A24 (GND), J2.A25 (GND), J2.A26 (GND), J2.A27 (GND), J2.A28 (GND), J2.A29 (GND), J2.A30 (GND), J2.A31 (GND), J2.A32 (GND), J2.A33 (GND), J2.A34 (GND), J2.A35 (GND), J2.A36 (GND), J2.A37 (GND), J2.A38 (GND), J2.A39 (GND), J2.A40 (GND), J2.A41 (GND), J2.A42 (GND), J2.A43 (GND), J2.A44 (GND), J2.A45 (GND), J2.A46 (GND), J2.B3 (GND), J2.B6 (GND), J2.B9 (GND), J2.B12 (GND), J2.B15 (GND), J2.B18 (GND), J2.B21 (GND), J2.B24 (GND), J2.B25 (GND), J2.B26 (GND), J2.B27 (GND), J2.B28 (GND), J2.B29 (GND), J2.B30 (GND), J2.B31 (GND), J2.B32 (GND), J2.B33 (GND), J2.B34 (GND), J2.B35 (GND), J2.B36 (GND), J2.B37 (GND), J2.B38 (GND), J2.B39 (GND), J2.B40 (GND), J2.B41 (GND), J2.B42 (GND), J2.B43 (GND), J2.B44 (GND), J2.B45 (GND), J2.B46 (GND), J2.C3 (GND), J2.C6 (GND), J2.C9 (GND), J2.C12 (GND), J2.C15 (GND), J2.C18 (GND), J2.C21 (GND), J2.C24 (GND), J2.C25 (GND), J2.C26 (GND), J2.C27 (GND), J2.C28 (GND), J2.C29 (GND), J2.C30 (GND), J2.C31 (GND), J2.C32 (GND), J2.C33 (GND), J2.C34 (GND), J2.C35 (GND), J2.C36 (GND), J2.C37 (GND), J2.C38 (GND), J2.C39 (GND), J2.C40 (GND), J2.C41 (GND), J2.C42 (GND), J2.C43 (GND), J2.C44 (GND), J2.C45 (GND), J2.C46 (GND), J2.D3 (GND), J2.D6 (GND), J2.D9 (GND), J2.D12 (GND), J2.D15 (GND), J2.D18 (GND), J2.D21 (GND), J2.D24 (GND), J2.D25 (GND), J2.D26 (GND), J2.D27 (GND), J2.D28 (GND), J2.D29 (GND), J2.D30 (GND), J2.D31 (GND), J2.D32 (GND), J2.D33 (GND), J2.D34 (GND), J2.D35 (GND), J2.D36 (GND), J2.D37 (GND), J2.D38 (GND), J2.D39 (GND), J2.D40 (GND), J2.D41 (GND), J2.D42 (GND), J2.D43 (GND), J2.D44 (GND), J2.D45 (GND), J2.D46 (GND), J3.A1 (GND), J3.A2 (GND), J3.A4 (GND), J3.A5 (GND), J3.A7 (GND), J3.A8 (GND), J3.A10 (GND), J3.A11 (GND), J3.A13 (GND), J3.A14 (GND), J3.A16 (GND), J3.A17 (GND), J3.A19 (GND), J3.A20 (GND), J3.A22 (GND), J3.A23 (GND), J3.A25 (GND), J3.A26 (GND), J3.A28 (GND), J3.A29 (GND), J3.A31 (GND), J3.A32 (GND), J3.A34 (GND), J3.A35 (GND), J3.A37 (GND), J3.A38 (GND), J3.A40 (GND), J3.A41 (GND), J3.A43 (GND), J3.A44 (GND), J3.A46 (GND), J3.A47 (GND), J3.A49 (GND), J3.A50 (GND), J3.A52 (GND), J3.A53 (GND), J3.A55 (GND), J3.A56 (GND), J3.A58 (GND), J3.A59 (GND), J3.B1 (GND), J3.B2 (GND), J3.B4 (GND), J3.B5 (GND), J3.B7 (GND), J3.B8 (GND), J3.B10 (GND), J3.B11 (GND), J3.B13 (GND), J3.B14 (GND), J3.B16 (GND), J3.B17 (GND), J3.B19 (GND), J3.B20 (GND), J3.B22 (GND), J3.B23 (GND), J3.B25 (GND), J3.B26 (GND), J3.B28 (GND), J3.B29 (GND), J3.B31 (GND), J3.B32 (GND), J3.B34 (GND), J3.B35 (GND), J3.B37 (GND), J3.B38 (GND), J3.B40 (GND), J3.B41 (GND), J3.B43 (GND), J3.B44 (GND), J3.B46 (GND), J3.B47 (GND), J3.B49 (GND), J3.B50 (GND), J3.B52 (GND), J3.B53 (GND), J3.B55 (GND), J3.B56 (GND), J3.B58 (GND), J3.B59 (GND), J3.C1 (GND), J3.C3 (GND), J3.C4 (GND), J3.C6 (GND), J3.C7 (GND), J3.C9 (GND), J3.C10 (GND), J3.C12 (GND), J3.C13 (GND), J3.C15 (GND), J3.C16 (GND), J3.C18 (GND), J3.C19 (GND), J3.C21 (GND), J3.C22 (GND), J3.C24 (GND), J3.C25 (GND), J3.C27 (GND), J3.C28 (GND), J3.C30 (GND), J3.C31 (GND), J3.C33 (GND), J3.C34 (GND), J3.C36 (GND), J3.C37 (GND), J3.C39 (GND), J3.C40 (GND), J3.C42 (GND), J3.C43 (GND), J3.C45 (GND), J3.C46 (GND), J3.C48 (GND), J3.C49 (GND), J3.C51 (GND), J3.C52 (GND), J3.C54 (GND), J3.C55 (GND), J3.C57 (GND), J3.C58 (GND), J3.C60 (GND), J3.D1 (GND), J3.D3 (GND), J3.D4 (GND), J3.D6 (GND), J3.D7 (GND), J3.D9 (GND), J3.D10 (GND), J3.D12 (GND), J3.D13 (GND), J3.D15 (GND), J3.D16 (GND), J3.D18 (GND), J3.D19 (GND), J3.D21 (GND), J3.D22 (GND), J3.D24 (GND), J3.D25 (GND), J3.D27 (GND), J3.D28 (GND), J3.D30 (GND), J3.D31 (GND), J3.D33 (GND), J3.D34 (GND), J3.D36 (GND), J3.D37 (GND), J3.D39 (GND), J3.D40 (GND), J3.D42 (GND), J3.D43 (GND), J3.D45 (GND), J3.D46 (GND), J3.D48 (GND), J3.D49 (GND), J3.D51 (GND), J3.D52 (GND), J3.D54 (GND), J3.D55 (GND), J3.D57 (GND), J3.D58 (GND), J3.D60 (GND), J4.A1 (GND), J4.A2 (GND), J4.A4 (GND), J4.A5 (GND), J4.A7 (GND), J4.A8 (GND), J4.A10 (GND), J4.A11 (GND), J4.A13 (GND), J4.A14 (GND), J4.A16 (GND), J4.A17 (GND), J4.A19 (GND), J4.A20 (GND), J4.A22 (GND), J4.A23 (GND), J4.A25 (GND), J4.A26 (GND), J4.A28 (GND), J4.A29 (GND), J4.A31 (GND), J4.A32 (GND), J4.A34 (GND), J4.A35 (GND), J4.A37 (GND), J4.A38 (GND), J4.A40 (GND), J4.A41 (GND), J4.A43 (GND), J4.A44 (GND), J4.A46 (GND), J4.A47 (GND), J4.A49 (GND), J4.A50 (GND), J4.A52 (GND), J4.A53 (GND), J4.A55 (GND), J4.A56 (GND), J4.A58 (GND), J4.A59 (GND), J4.B1 (GND), J4.B2 (GND), J4.B4 (GND), J4.B5 (GND), J4.B7 (GND), J4.B8 (GND), J4.B10 (GND), J4.B11 (GND), J4.B13 (GND), J4.B14 (GND), J4.B16 (GND), J4.B17 (GND), J4.B19 (GND), J4.B20 (GND), J4.B22 (GND), J4.B23 (GND), J4.B25 (GND), J4.B26 (GND), J4.B28 (GND), J4.B29 (GND), J4.B31 (GND), J4.B32 (GND), J4.B34 (GND), J4.B35 (GND), J4.B37 (GND), J4.B38 (GND), J4.B40 (GND), J4.B41 (GND), J4.B43 (GND), J4.B44 (GND), J4.B46 (GND), J4.B47 (GND), J4.B49 (GND), J4.B50 (GND), J4.B52 (GND), J4.B53 (GND), J4.B55 (GND), J4.B56 (GND), J4.B58 (GND), J4.B59 (GND), J4.C1 (GND), J4.C3 (GND), J4.C4 (GND), J4.C6 (GND), J4.C7 (GND), J4.C9 (GND), J4.C10 (GND), J4.C12 (GND), J4.C13 (GND), J4.C15 (GND), J4.C16 (GND), J4.C18 (GND), J4.C19 (GND), J4.C21 (GND), J4.C22 (GND), J4.C24 (GND), J4.C25 (GND), J4.C27 (GND), J4.C28 (GND), J4.C30 (GND), J4.C31 (GND), J4.C33 (GND), J4.C34 (GND), J4.C36 (GND), J4.C37 (GND), J4.C39 (GND), J4.C40 (GND), J4.C42 (GND), J4.C43 (GND), J4.C45 (GND), J4.C46 (GND), J4.C48 (GND), J4.C49 (GND), J4.C51 (GND), J4.C52 (GND), J4.C54 (GND), J4.C55 (GND), J4.C57 (GND), J4.C58 (GND), J4.D1 (GND), J4.D3 (GND), J4.D4 (GND), J4.D6 (GND), J4.D7 (GND), J4.D9 (GND), J4.D10 (GND), J4.D12 (GND), J4.D13 (GND), J4.D15 (GND), J4.D16 (GND), J4.D18 (GND), J4.D19 (GND), J4.D21 (GND), J4.D22 (GND), J4.D24 (GND), J4.D25 (GND), J4.D27 (GND), J4.D28 (GND), J4.D30 (GND), J4.D31 (GND), J4.D33 (GND), J4.D34 (GND), J4.D36 (GND), J4.D37 (GND), J4.D39 (GND), J4.D40 (GND), J4.D42 (GND), J4.D43 (GND), J4.D45 (GND), J4.D46 (GND), J4.D48 (GND), J4.D49 (GND), J4.D51 (GND), J4.D52 (GND), J4.D54 (GND), J4.D55 (GND), J4.D57 (GND), J4.D58 (GND), J5.A6 (GND), J5.A11 (GND), J5.A16 (GND), J5.A21 (GND), J5.A26 (GND), J5.A31 (GND), J5.A32 (GND), J5.A34 (GND), J5.A35 (GND), J5.A37 (GND), J5.A38 (GND), J5.A40 (GND), J5.A41 (GND), J5.A43 (GND), J5.A44 (GND), J5.A46 (GND), J5.A47 (GND), J5.A49 (GND), J5.A50 (GND), J5.A52 (GND), J5.A53 (GND), J5.A55 (GND), J5.A56 (GND), J5.A58 (GND), J5.A59 (GND), J5.B6 (GND), J5.B11 (GND), J5.B16 (GND), J5.B21 (GND), J5.B26 (GND), J5.B31 (GND), J5.B32 (GND), J5.B34 (GND), J5.B35 (GND), J5.B37 (GND), J5.B38 (GND), J5.B40 (GND), J5.B41 (GND), J5.B43 (GND), J5.B44 (GND), J5.B46 (GND), J5.B47 (GND), J5.B49 (GND), J5.B50 (GND), J5.B52 (GND), J5.B53 (GND), J5.B55 (GND), J5.B56 (GND), J5.B58 (GND), J5.B59 (GND), J5.C1 (FPGA_VP_IN), J5.C2 (FPGA_VN_IN), J5.C5 (GND), J5.C10 (GND), J5.C15 (GND), J5.C20 (GND), J5.C25 (GND), J5.C30 (GND), J5.C31 (GND), J5.C33 (GND), J5.C34 (GND), J5.C36 (GND), J5.C37 (GND), J5.C39 (GND), J5.C40 (GND), J5.C42 (GND), J5.C43 (GND), J5.C45 (GND), J5.C46 (GND), J5.C48 (GND), J5.C49 (GND), J5.C51 (GND), J5.C52 (GND), J5.C54 (GND), J5.C55 (GND), J5.C57 (GND), J5.C58 (GND), J5.C60 (GND), J5.D5 (GND), J5.D10 (GND), J5.D15 (GND), J5.D20 (GND), J5.D25 (GND), J5.D30 (GND), J5.D31 (GND), J5.D33 (GND), J5.D34 (GND), J5.D36 (GND), J5.D37 (GND), J5.D39 (GND), J5.D40 (GND), J5.D42 (GND), J5.D43 (GND), J5.D45 (GND), J5.D46 (GND), J5.D48 (GND), J5.D49 (GND), J5.D51 (GND), J5.D52 (GND), J5.D54 (GND), J5.D55 (GND), J5.D57 (GND), J5.D58 (GND), J5.D60 (GND), J7.A1 (GND), J7.A3 (GND), J7.A4 (GND), J7.A6 (GND), J7.A7 (GND), J7.A9 (GND), J7.A10 (GND), J7.A12 (GND), J7.A13 (GND), J7.A15 (GND), J7.A16 (GND), J7.A18 (GND), J7.A19 (GND), J7.A21 (GND), J7.A22 (GND), J7.A24 (GND), J7.A25 (GND), J7.A27 (GND), J7.A28 (GND), J7.A30 (GND), J7.A31 (GND), J7.A33 (GND), J7.A34 (GND), J7.A36 (GND), J7.A37 (GND), J7.A39 (GND), J7.A40 (GND), J7.A42 (GND), J7.A43 (GND), J7.A45 (GND), J7.A46 (GND), J7.A48 (GND), J7.A49 (GND), J7.A51 (GND), J7.A52 (GND), J7.A54 (GND), J7.A55 (GND), J7.A57 (GND), J7.A58 (GND), J7.A60 (GND), J7.B1 (GND), J7.B3 (GND), J7.B4 (GND), J7.B6 (GND), J7.B7 (GND), J7.B9 (GND), J7.B10 (GND), J7.B12 (GND), J7.B13 (GND), J7.B15 (GND), J7.B16 (GND), J7.B18 (GND), J7.B19 (GND), J7.B21 (GND), J7.B22 (GND), J7.B24 (GND), J7.B25 (GND), J7.B27 (GND), J7.B28 (GND), J7.B30 (GND), J7.B31 (GND), J7.B33 (GND), J7.B34 (GND), J7.B36 (GND), J7.B37 (GND), J7.B39 (GND), J7.B40 (GND), J7.B42 (GND), J7.B43 (GND), J7.B45 (GND), J7.B46 (GND), J7.B48 (GND), J7.B49 (GND), J7.B51 (GND), J7.B52 (GND), J7.B54 (GND), J7.B55 (GND), J7.B57 (GND), J7.B58 (GND), J7.B60 (GND), J7.C1 (GND), J7.C2 (GND), J7.C4 (GND), J7.C5 (GND), J7.C7 (GND), J7.C8 (GND), J7.C10 (GND), J7.C11 (GND), J7.C13 (GND), J7.C14 (GND), J7.C16 (GND), J7.C17 (GND), J7.C19 (GND), J7.C20 (GND), J7.C22 (GND), J7.C23 (GND), J7.C25 (GND), J7.C26 (GND), J7.C28 (GND), J7.C29 (GND), J7.C31 (GND), J7.C32 (GND), J7.C34 (GND), J7.C35 (GND), J7.C37 (GND), J7.C38 (GND), J7.C40 (GND), J7.C41 (GND), J7.C43 (GND), J7.C44 (GND), J7.C46 (GND), J7.C47 (GND), J7.C49 (GND), J7.C50 (GND), J7.C52 (GND), J7.C53 (GND), J7.C55 (GND), J7.C56 (GND), J7.C58 (GND), J7.C59 (GND), J7.D1 (GND), J7.D2 (GND), J7.D4 (GND), J7.D5 (GND), J7.D7 (GND), J7.D8 (GND), J7.D10 (GND), J7.D11 (GND), J7.D13 (GND), J7.D14 (GND), J7.D16 (GND), J7.D17 (GND), J7.D19 (GND), J7.D20 (GND), J7.D22 (GND), J7.D23 (GND), J7.D25 (GND), J7.D26 (GND), J7.D28 (GND), J7.D29 (GND), J7.D31 (GND), J7.D32 (GND), J7.D34 (GND), J7.D35 (GND), J7.D37 (GND), J7.D38 (GND), J7.D40 (GND), J7.D41 (GND), J7.D43 (GND), J7.D44 (GND), J7.D46 (GND), J7.D47 (GND), J7.D49 (GND), J7.D50 (GND), J7.D52 (GND), J7.D53 (GND), J7.D55 (GND), J7.D56 (GND), J7.D58 (GND), J7.D59 (GND), J8.A1 (GND), J8.A3 (GND), J8.A4 (GND), J8.A6 (GND), J8.A7 (GND), J8.A9 (GND), J8.A10 (GND), J8.A12 (GND), J8.A13 (GND), J8.A15 (GND), J8.A16 (GND), J8.A18 (GND), J8.A19 (GND), J8.A21 (GND), J8.A22 (GND), J8.A24 (GND), J8.A25 (GND), J8.A27 (GND), J8.A28 (GND), J8.A30 (GND), J8.A31 (GND), J8.A33 (GND), J8.A34 (GND), J8.A36 (GND), J8.A37 (GND), J8.A39 (GND), J8.A40 (GND), J8.A42 (GND), J8.A43 (GND), J8.A45 (GND), J8.A46 (GND), J8.A48 (GND), J8.A49 (GND), J8.A51 (GND), J8.A52 (GND), J8.A54 (GND), J8.A55 (GND), J8.A57 (GND), J8.A58 (GND), J8.A60 (GND), J8.B1 (GND), J8.B3 (GND), J8.B4 (GND), J8.B6 (GND), J8.B7 (GND), J8.B9 (GND), J8.B10 (GND), J8.B12 (GND), J8.B13 (GND), J8.B15 (GND), J8.B16 (GND), J8.B18 (GND), J8.B19 (GND), J8.B21 (GND), J8.B22 (GND), J8.B24 (GND), J8.B25 (GND), J8.B27 (GND), J8.B28 (GND), J8.B30 (GND), J8.B31 (GND), J8.B33 (GND), J8.B34 (GND), J8.B36 (GND), J8.B37 (GND), J8.B39 (GND), J8.B40 (GND), J8.B42 (GND), J8.B43 (GND), J8.B45 (GND), J8.B46 (GND), J8.B48 (GND), J8.B49 (GND), J8.B51 (GND), J8.B52 (GND), J8.B54 (GND), J8.B55 (GND), J8.B57 (GND), J8.B58 (GND), J8.B60 (GND), J8.C1 (GND), J8.C2 (GND), J8.C4 (GND), J8.C5 (GND), J8.C7 (GND), J8.C8 (GND), J8.C10 (GND), J8.C11 (GND), J8.C13 (GND), J8.C14 (GND), J8.C16 (GND), J8.C17 (GND), J8.C19 (GND), J8.C20 (GND), J8.C22 (GND), J8.C23 (GND), J8.C25 (GND), J8.C26 (GND), J8.C28 (GND), J8.C29 (GND), J8.C31 (GND), J8.C32 (GND), J8.C34 (GND), J8.C35 (GND), J8.C37 (GND), J8.C38 (GND), J8.C40 (GND), J8.C41 (GND), J8.C43 (GND), J8.C44 (GND), J8.C46 (GND), J8.C47 (GND), J8.C49 (GND), J8.C50 (GND), J8.C52 (GND), J8.C53 (GND), J8.C55 (GND), J8.C56 (GND), J8.C58 (GND), J8.C59 (GND), J8.D1 (GND), J8.D2 (GND), J8.D4 (GND), J8.D5 (GND), J8.D7 (GND), J8.D8 (GND), J8.D10 (GND), J8.D11 (GND), J8.D13 (GND), J8.D14 (GND), J8.D16 (GND), J8.D17 (GND), J8.D19 (GND), J8.D20 (GND), J8.D22 (GND), J8.D23 (GND), J8.D25 (GND), J8.D26 (GND), J8.D28 (GND), J8.D29 (GND), J8.D31 (GND), J8.D32 (GND), J8.D34 (GND), J8.D35 (GND), J8.D37 (GND), J8.D38 (GND), J8.D40 (GND), J8.D41 (GND), J8.D43 (GND), J8.D44 (GND), J8.D46 (GND), J8.D47 (GND), J8.D49 (GND), J8.D50 (GND), J8.D52 (GND), J8.D53 (GND), J8.D55 (GND), J8.D56 (GND), J8.D58 (GND), J8.D59 (GND), J802.1, J802.3, J802.5, J802.7, J802.9, J802.11, J802.13, R802.2, R803.2, TP811.1, TP812.1
JTAG_TCK: J802.6, TP804.1
JTAG_TDI: J802.10, TP806.1
JTAG_TDO: J802.8, TP807.1
JTAG_TMS: J802.4, TP805.1
V12SOM: C801.1, C802.1, C803.1, C804.1, C805.1, C806.1, J2.A48 (+12V), J2.A49 (+12V), J2.A50 (+12V), J2.A51 (+12V), J2.A52 (+12V), J2.A53 (+12V), J2.A54 (+12V), J2.A55 (+12V), J2.A56 (+12V), J2.A57 (+12V), J2.A58 (+12V), J2.A59 (+12V), J2.A60 (+12V), J2.B48 (+12V), J2.B49 (+12V), J2.B50 (+12V), J2.B51 (+12V), J2.B52 (+12V), J2.B53 (+12V), J2.B54 (+12V), J2.B55 (+12V), J2.B56 (+12V), J2.B57 (+12V), J2.B58 (+12V), J2.B59 (+12V), J2.B60 (+12V), J2.C48 (+12V), J2.C49 (+12V), J2.C50 (+12V), J2.C51 (+12V), J2.C52 (+12V), J2.C53 (+12V), J2.C54 (+12V), J2.C55 (+12V), J2.C56 (+12V), J2.C57 (+12V), J2.C58 (+12V), J2.C59 (+12V), J2.C60 (+12V), J2.D48 (+12V), J2.D49 (+12V), J2.D50 (+12V), J2.D51 (+12V), J2.D52 (+12V), J2.D53 (+12V), J2.D54 (+12V), J2.D55 (+12V), J2.D56 (+12V), J2.D57 (+12V), J2.D58 (+12V), J2.D59 (+12V), J2.D60 (+12V), TP801.1
V18: J5.A5 (VCCIO_68), J5.D1 (VCCIO_66), J5.D2 (VCCIO_67), J802.2, R801.2, TP802.1

Notes on the sheet:
Alinx ACVU13P SoM carrier (bom item 16): eight Samtec ADM6-60-01.5-L-4-2-A-TR (240-pin, 4 x 60, 0.635 mm) - J1/J6 on the FPGA sheet, the other six here. J3/J4/J7/J8 carry only MGT quads (unused - every signal pin no-connect, all GND pins tied). J2 = +12 V module feed (52 pins) + SelectMAP (unused) 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
+12 V SoM feed (bom 17(d): 12 V switcher + heavy filter -> SoM only; planning figure 15 A / 180 W, user 2026-10-10). Board-to-board entry is Conn1/J506 SEAF: 30 V12SOM contacts (C2:C11, D2:D11, E2:E11) with a GND perimeter; separate J507/J508 terminals are removed. 2 x 220 uF polymer + 4 x 10 uF X7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
JTAG: FPGA_TCK/TMS/TDI/TDO from J6 D17-D20 to a Xilinx 14-pin 2 mm header. VREF = V18 (UltraScale+ bank 0 is 1.8 V). VERIFY: the SoM may already carry its own JTAG header (Alinx JTAG.csv) - keep both, cable goes to one.
BOOT_M[2:0] (J2 B1/B2/B4): DNP 4.7k straps for master-SPI 001 (M0 -> V18, M1/M2 -> GND). The SoM boots its own QSPI; populate only if the manual requires carrier straps ** VERIFY **
SOM_PG (J6 D34, VCCAUX_PG): module power-good -> CTRL sheet LED / AP status. All PWR_FLAGs live in the rails table on the REFS sheet (V18, V12SOM, V33D, ...).
TEST POINTS (rule c): V12SOM / V18 / FPGA_DONE / JTAG / BOOT_M on hook pads; GND at the end.
