ccroswhite/BFDAC/hw/kicad/xlat.kicad_sch

## KiCad design hw/kicad/xlat.kicad_sch (2026-11-04)

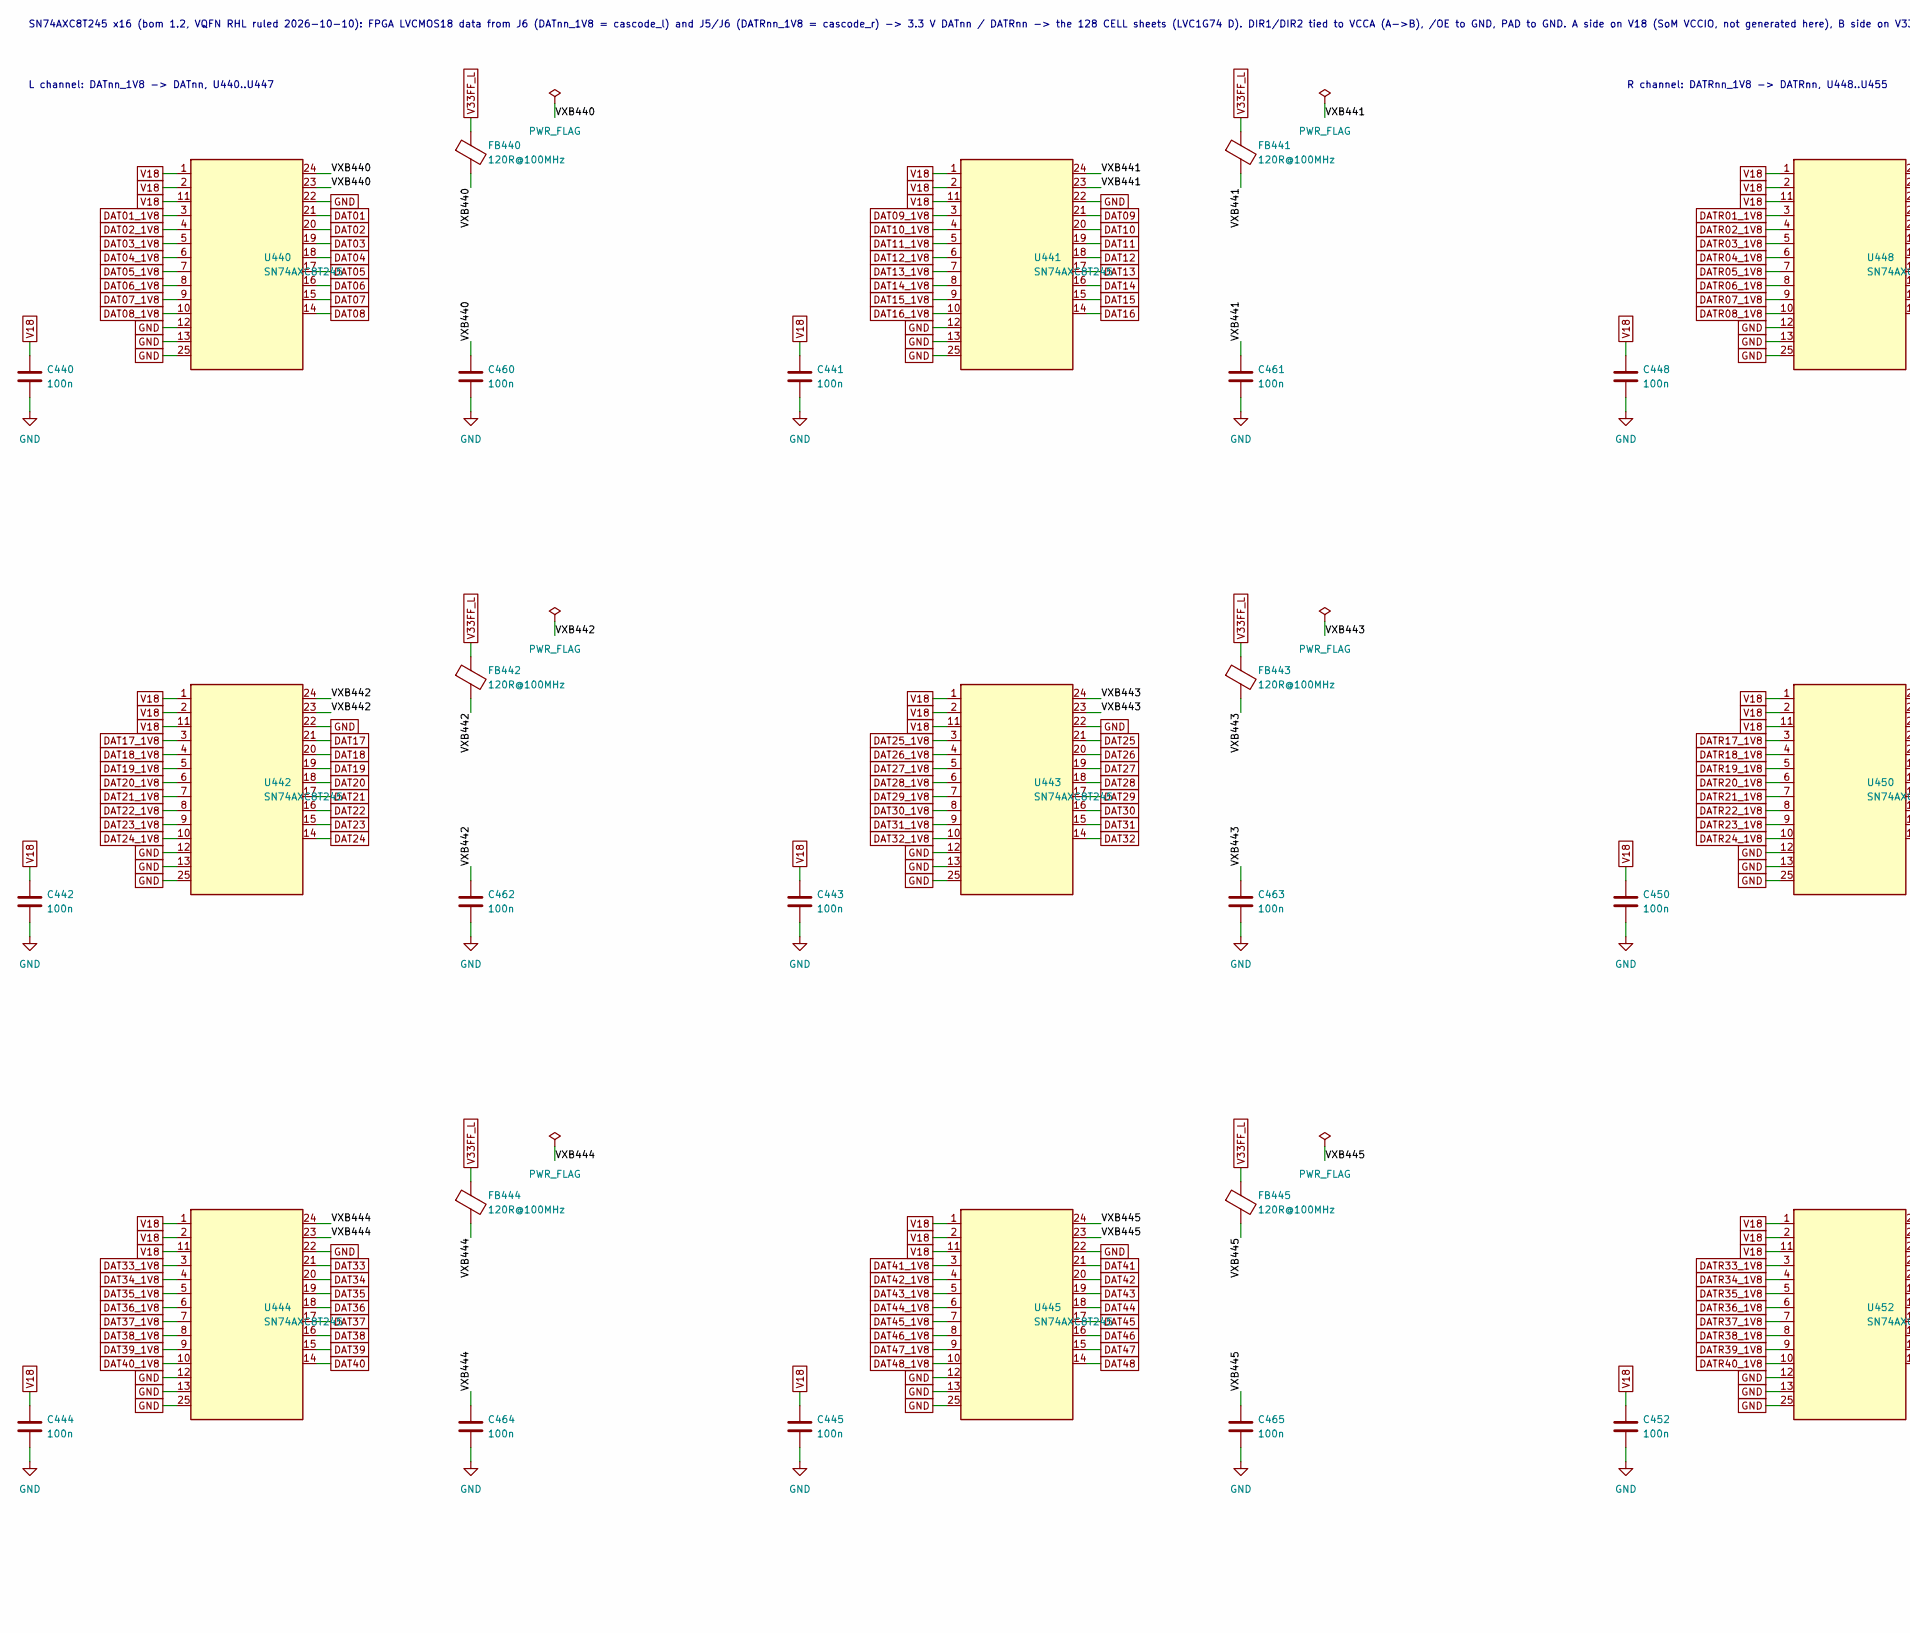
[picture p37: schematic xlat.kicad_sch, part in row 1, column 1]

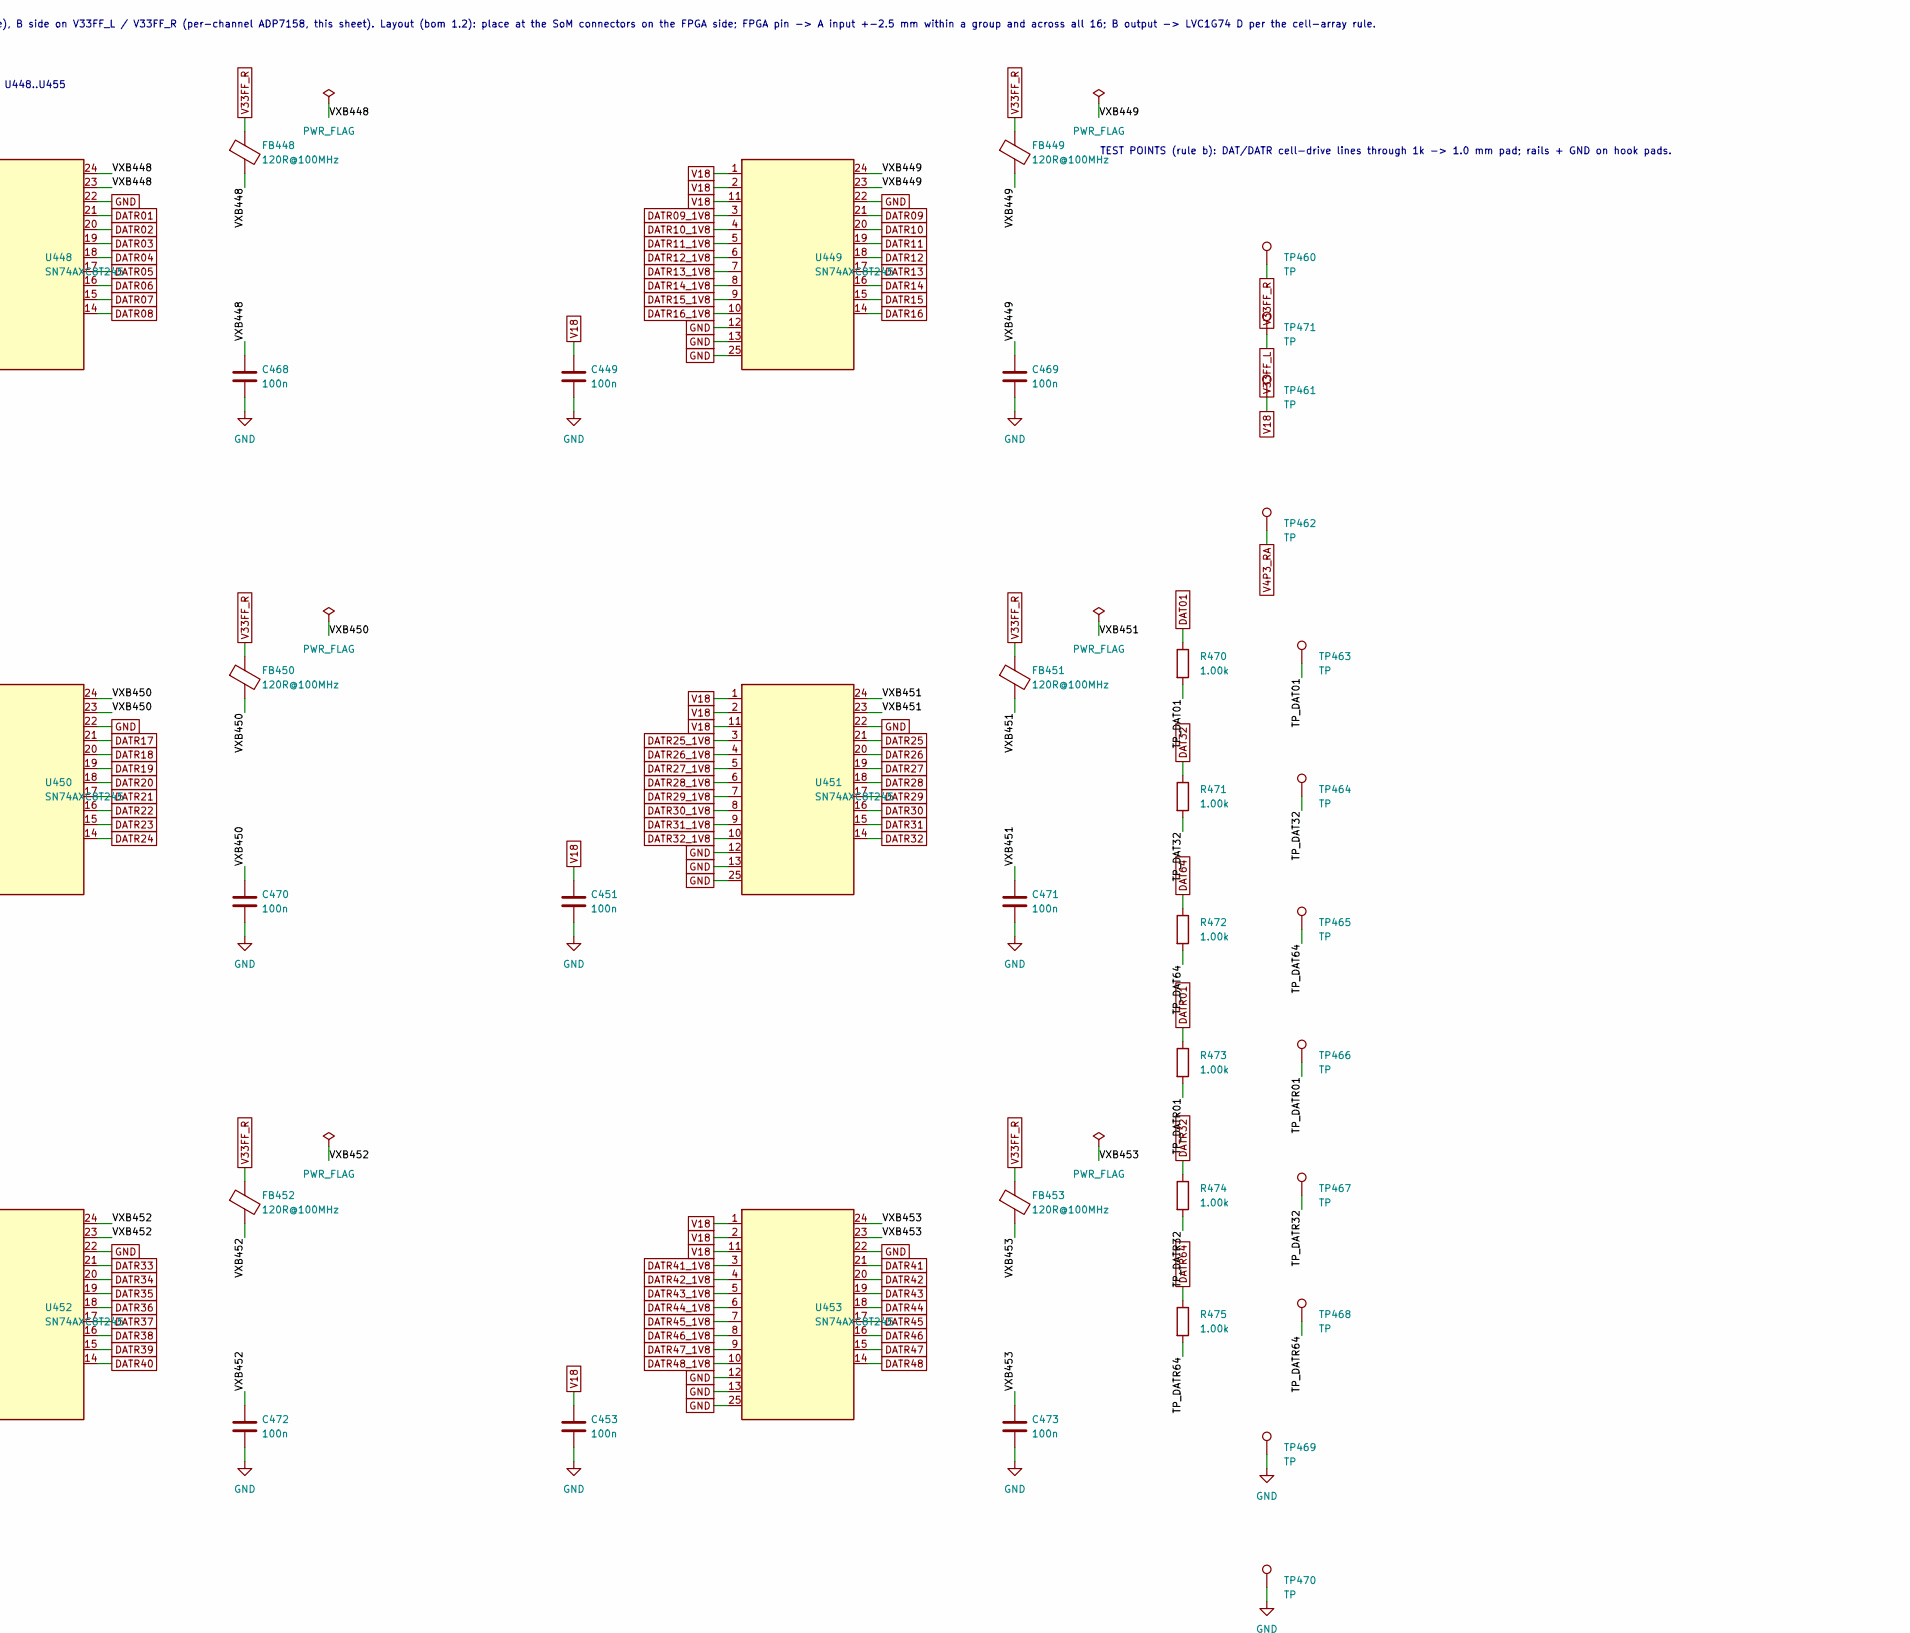
[picture p38: schematic xlat.kicad_sch, part in row 1, column 2]

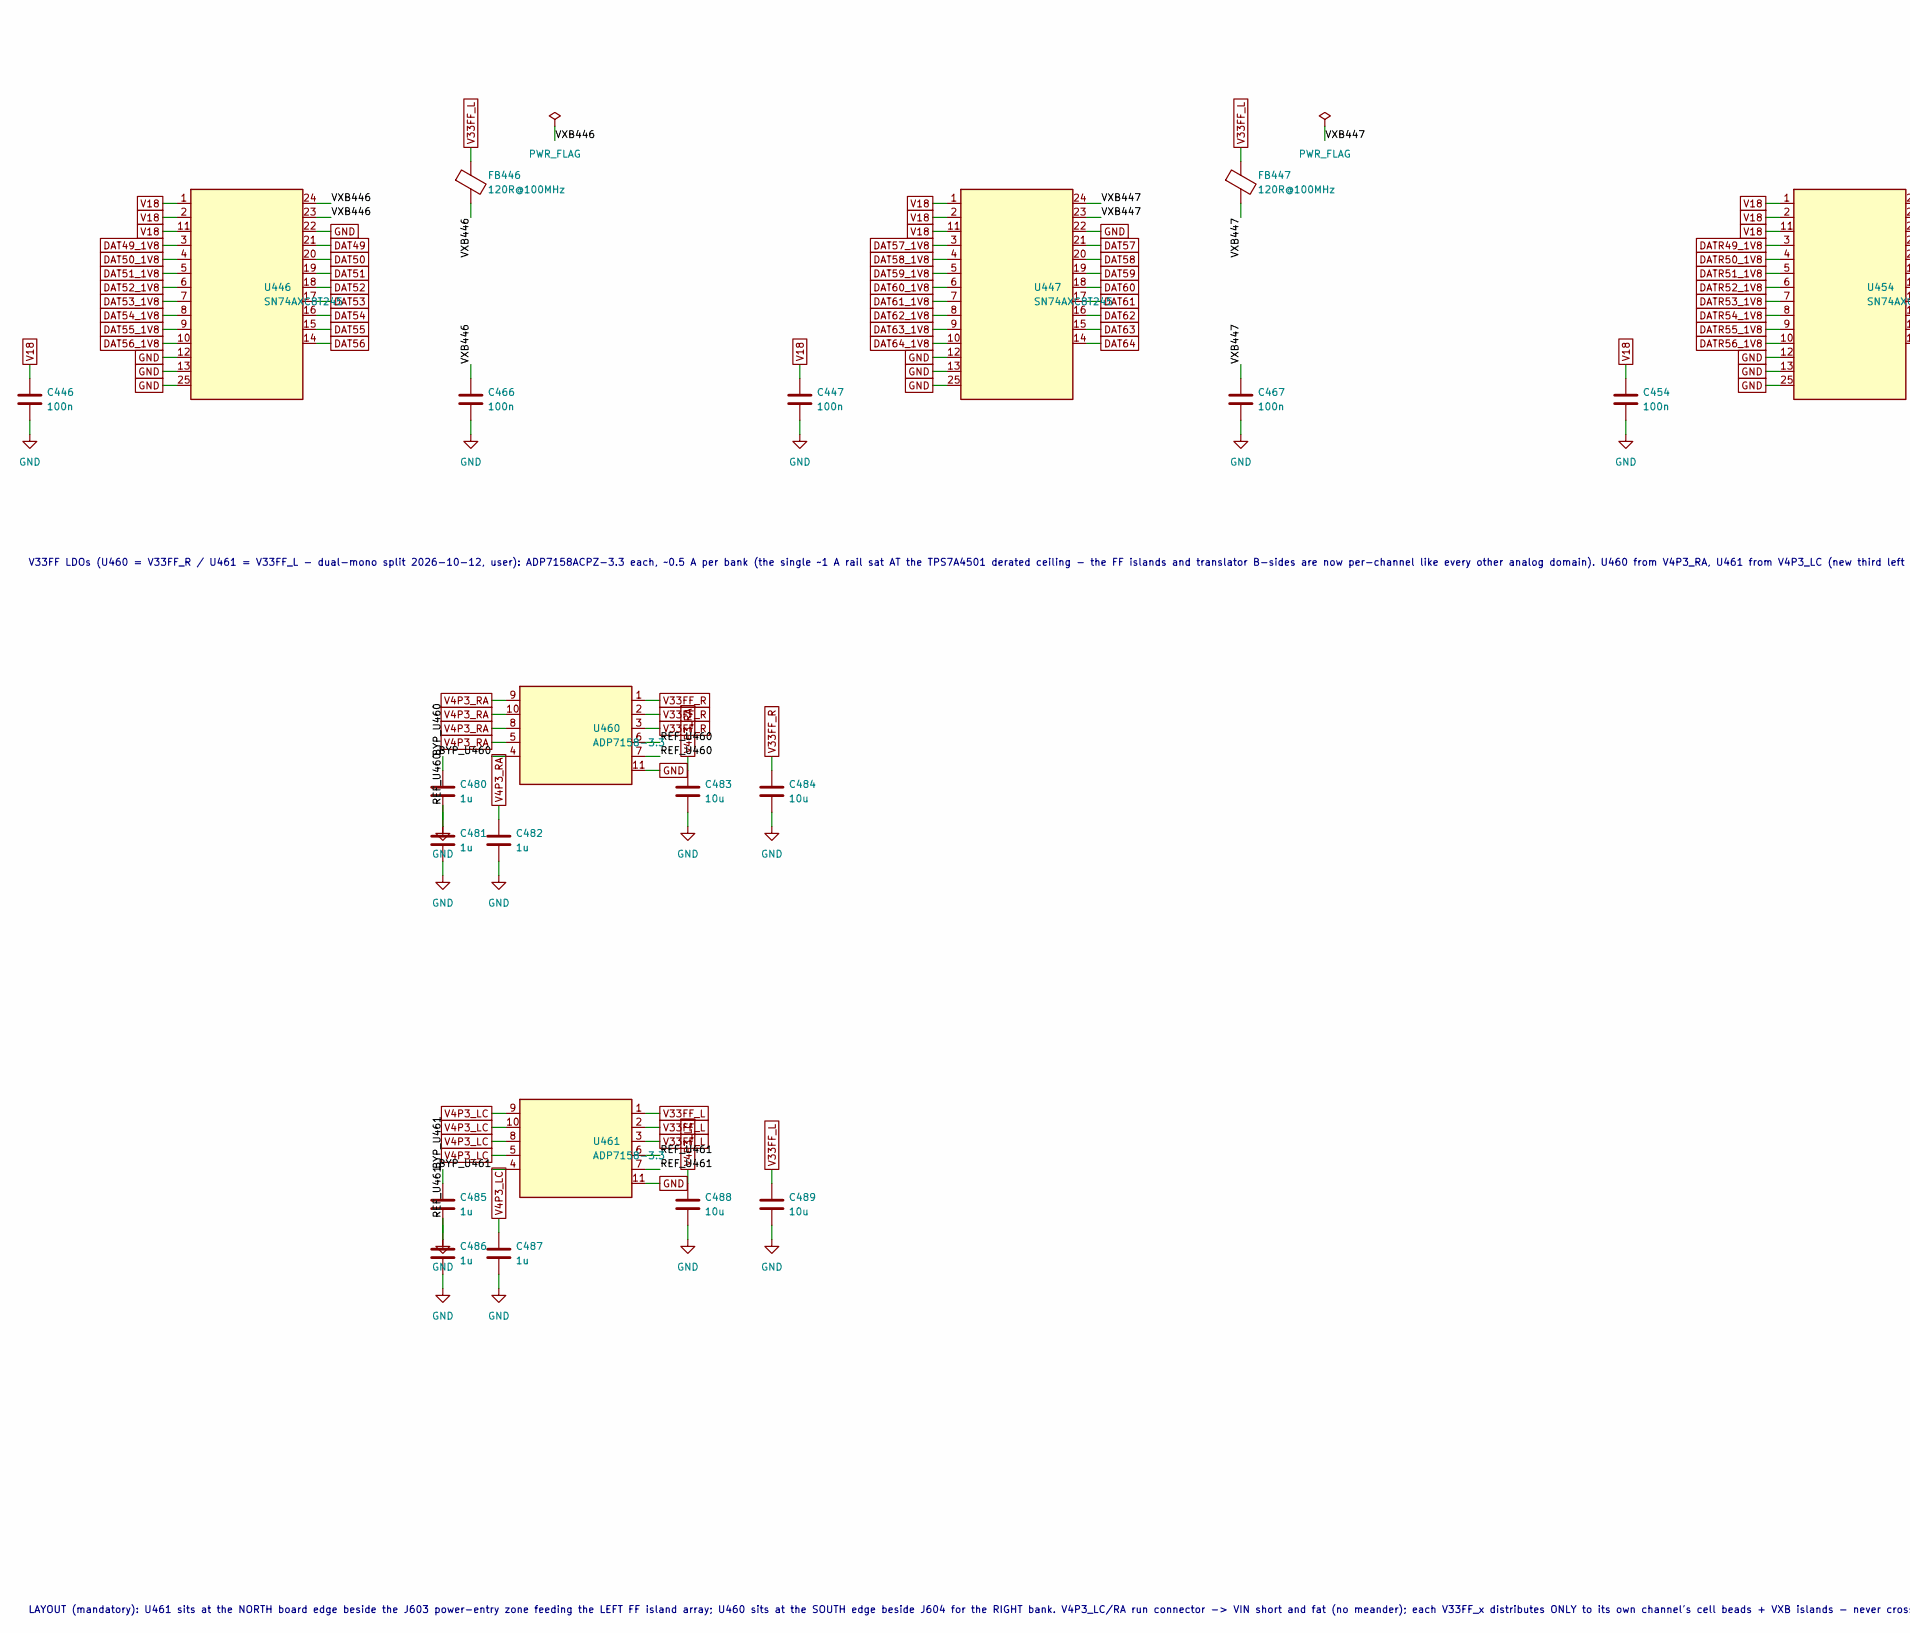
[picture p39: schematic xlat.kicad_sch, part in row 2, column 1]

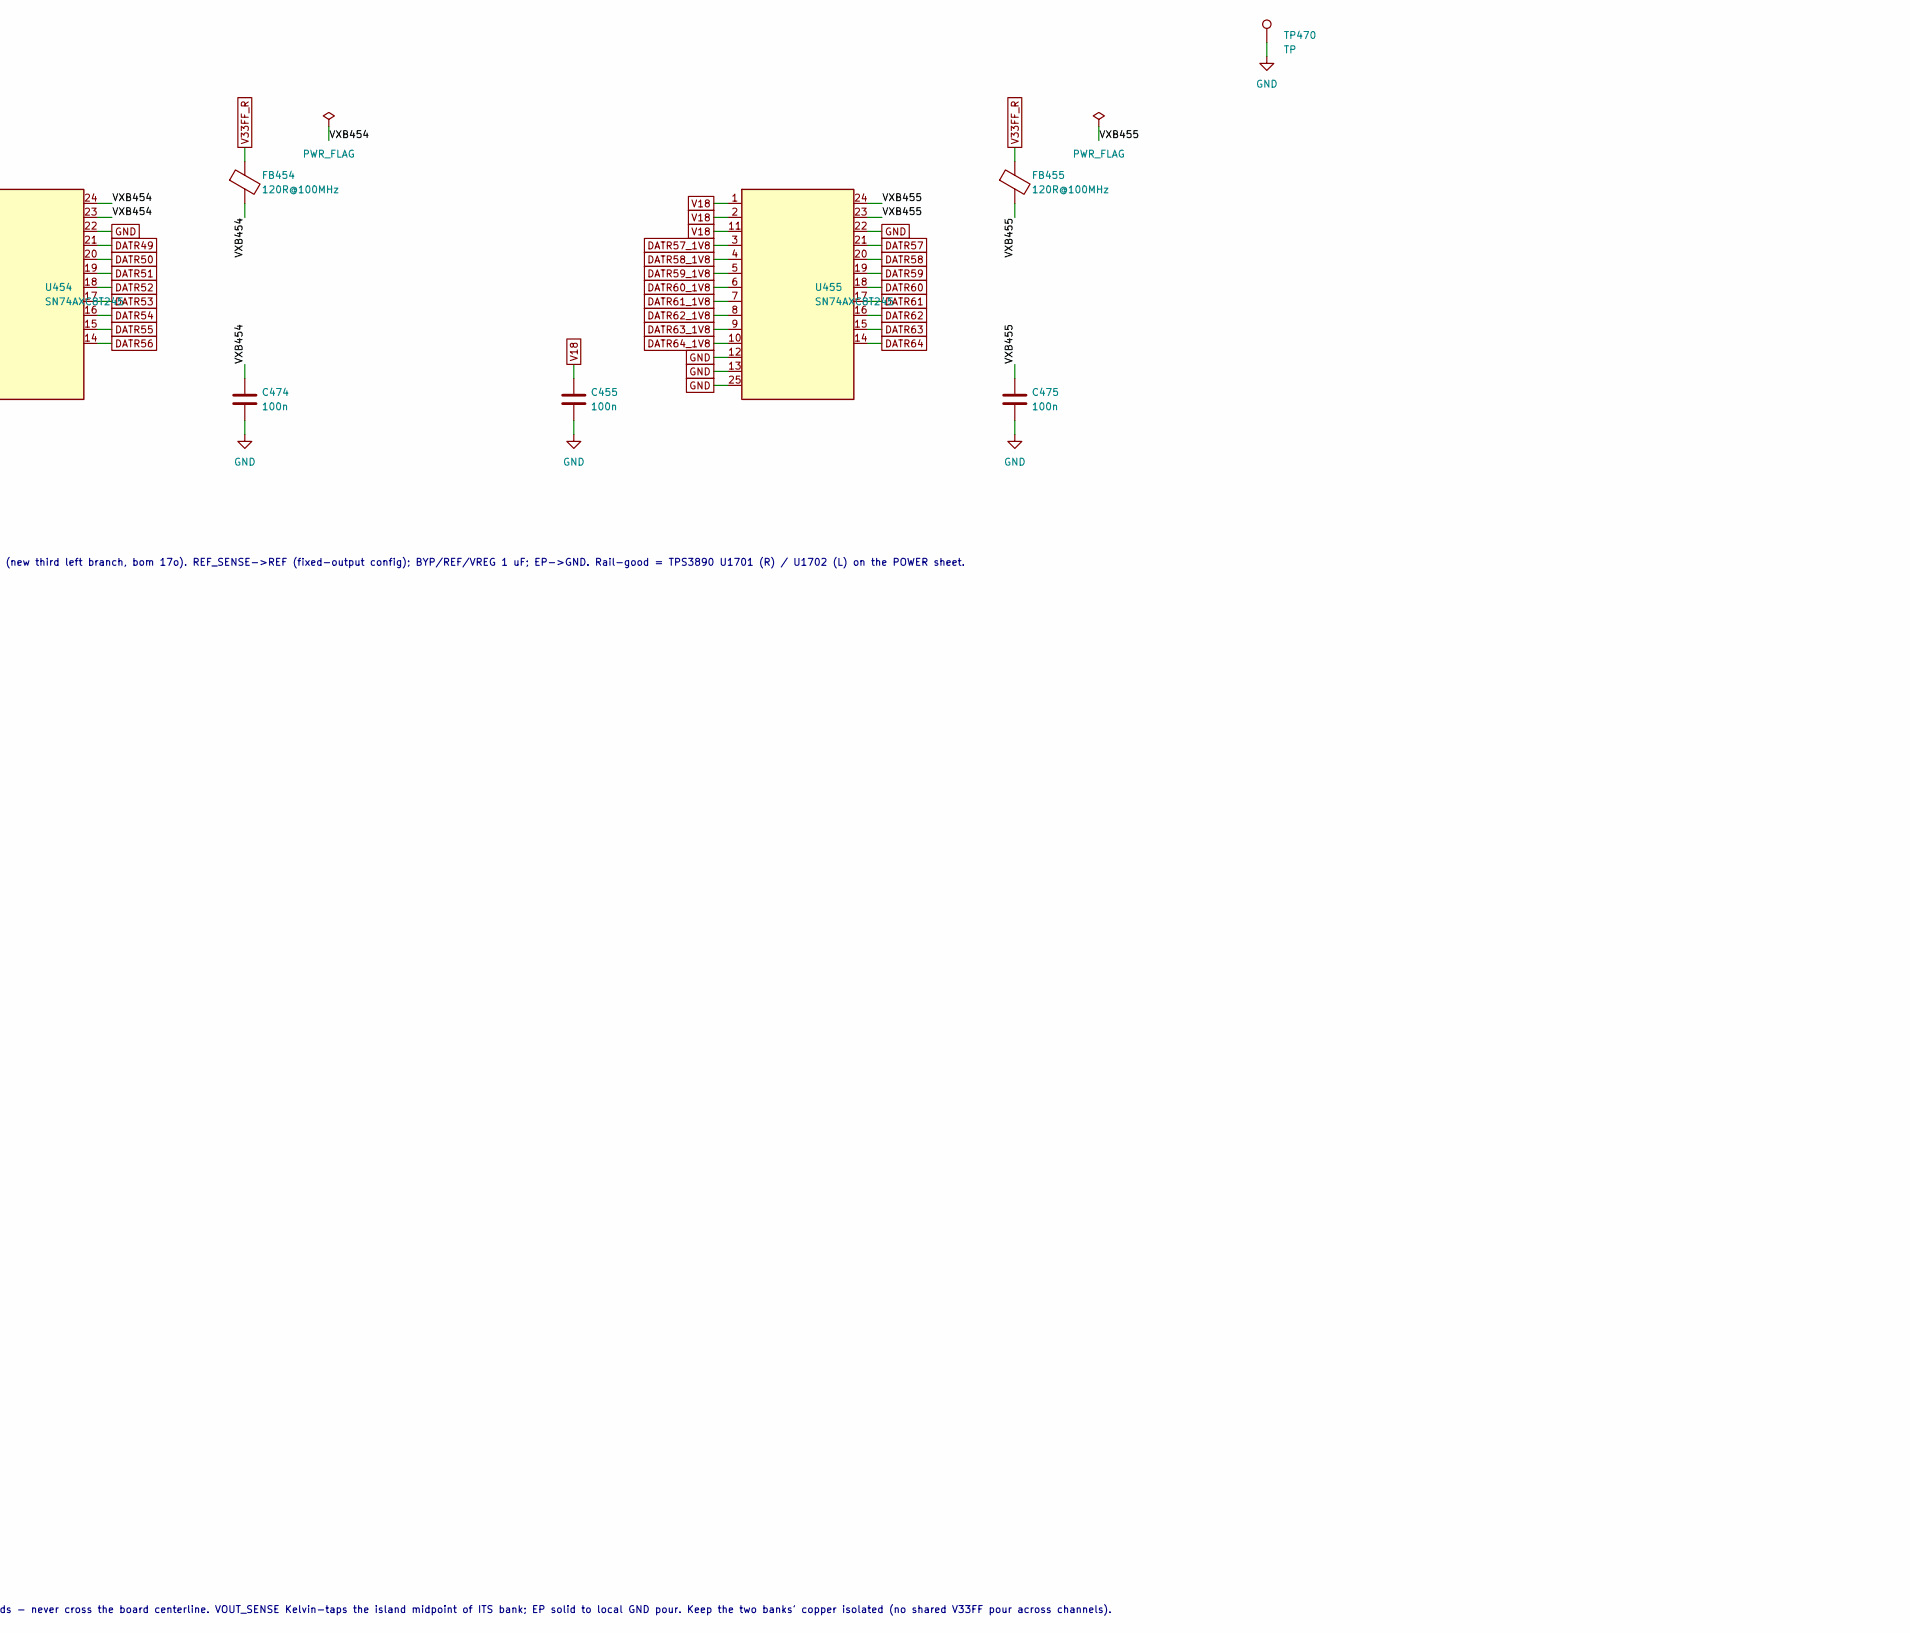
[picture p40: schematic xlat.kicad_sch, part in row 2, column 2]

Parts:
C440, C441, C442, C443, C444, C445, C446, C447, C448, C449, C450, C451, C452, C453, C454, C455, C460, C461, C462, C463, C464, C465, C466, C467, C468, C469, C470, C471, C472, C473, C474, C475: 100n; C_0603_1608Metric; MPN GRM188R71C104KA01D
C480, C481, C482, C485, C486, C487: 1u; C_0603_1608Metric; MPN GRM188R61E105KA12D
C483, C484, C488, C489: 10u; C_1206_3216Metric; MPN GRM31CR71E106KA12L
FB440, FB441, FB442, FB443, FB444, FB445, FB446, FB447, FB448, FB449, FB450, FB451, FB452, FB453, FB454, FB455: 120R@100MHz; L_0603_1608Metric; MPN BLM18PG121SN1D
R470, R471, R472, R473, R474, R475: 1.00k; R_0603_1608Metric; MPN TNPW06031K00FEEA
TP460, TP461, TP462, TP469, TP470, TP471: TP; TestPoint_THTPad_2.0x2.0mm_Drill1.0mm
TP463, TP464, TP465, TP466, TP467, TP468: TP; TestPoint_Pad_1.0x1.0mm
U440, U441, U442, U443, U444, U445, U446, U447, U448, U449, U450, U451, U452, U453, U454, U455: SN74AXC8T245; TI_RGY_VQFN-24_3.5x5.5mm_P0.5mm_EP; MPN SN74AXC8T245RHLR
U460, U461: ADP7158-3.3; ADI_CP-10-9_LFCSP-10; MPN ADP7158ACPZ-3.3-R7

Connections:
BYP_U460: C480.1, U460.4 (BYP)
BYP_U461: C485.1, U461.4 (BYP)
DAT01: R470.1, U440.21 (B1)
DAT01_1V8: U440.3 (A1)
DAT02: U440.20 (B2)
DAT02_1V8: U440.4 (A2)
DAT03: U440.19 (B3)
DAT03_1V8: U440.5 (A3)
DAT04: U440.18 (B4)
DAT04_1V8: U440.6 (A4)
DAT05: U440.17 (B5)
DAT05_1V8: U440.7 (A5)
DAT06: U440.16 (B6)
DAT06_1V8: U440.8 (A6)
DAT07: U440.15 (B7)
DAT07_1V8: U440.9 (A7)
DAT08: U440.14 (B8)
DAT08_1V8: U440.10 (A8)
DAT09: U441.21 (B1)
DAT09_1V8: U441.3 (A1)
DAT10: U441.20 (B2)
DAT10_1V8: U441.4 (A2)
DAT11: U441.19 (B3)
DAT11_1V8: U441.5 (A3)
DAT12: U441.18 (B4)
DAT12_1V8: U441.6 (A4)
DAT13: U441.17 (B5)
DAT13_1V8: U441.7 (A5)
DAT14: U441.16 (B6)
DAT14_1V8: U441.8 (A6)
DAT15: U441.15 (B7)
DAT15_1V8: U441.9 (A7)
DAT16: U441.14 (B8)
DAT16_1V8: U441.10 (A8)
DAT17: U442.21 (B1)
DAT17_1V8: U442.3 (A1)
DAT18: U442.20 (B2)
DAT18_1V8: U442.4 (A2)
DAT19: U442.19 (B3)
DAT19_1V8: U442.5 (A3)
DAT20: U442.18 (B4)
DAT20_1V8: U442.6 (A4)
DAT21: U442.17 (B5)
DAT21_1V8: U442.7 (A5)
DAT22: U442.16 (B6)
DAT22_1V8: U442.8 (A6)
DAT23: U442.15 (B7)
DAT23_1V8: U442.9 (A7)
DAT24: U442.14 (B8)
DAT24_1V8: U442.10 (A8)
DAT25: U443.21 (B1)
DAT25_1V8: U443.3 (A1)
DAT26: U443.20 (B2)
DAT26_1V8: U443.4 (A2)
DAT27: U443.19 (B3)
DAT27_1V8: U443.5 (A3)
DAT28: U443.18 (B4)
DAT28_1V8: U443.6 (A4)
DAT29: U443.17 (B5)
DAT29_1V8: U443.7 (A5)
DAT30: U443.16 (B6)
DAT30_1V8: U443.8 (A6)
DAT31: U443.15 (B7)
DAT31_1V8: U443.9 (A7)
DAT32: R471.1, U443.14 (B8)
DAT32_1V8: U443.10 (A8)
DAT33: U444.21 (B1)
DAT33_1V8: U444.3 (A1)
DAT34: U444.20 (B2)
DAT34_1V8: U444.4 (A2)
DAT35: U444.19 (B3)
DAT35_1V8: U444.5 (A3)
DAT36: U444.18 (B4)
DAT36_1V8: U444.6 (A4)
DAT37: U444.17 (B5)
DAT37_1V8: U444.7 (A5)
DAT38: U444.16 (B6)
DAT38_1V8: U444.8 (A6)
DAT39: U444.15 (B7)
DAT39_1V8: U444.9 (A7)
DAT40: U444.14 (B8)
DAT40_1V8: U444.10 (A8)
DAT41: U445.21 (B1)
DAT41_1V8: U445.3 (A1)
DAT42: U445.20 (B2)
DAT42_1V8: U445.4 (A2)
DAT43: U445.19 (B3)
DAT43_1V8: U445.5 (A3)
DAT44: U445.18 (B4)
DAT44_1V8: U445.6 (A4)
DAT45: U445.17 (B5)
DAT45_1V8: U445.7 (A5)
DAT46: U445.16 (B6)
DAT46_1V8: U445.8 (A6)
DAT47: U445.15 (B7)
DAT47_1V8: U445.9 (A7)
DAT48: U445.14 (B8)
DAT48_1V8: U445.10 (A8)
DAT49: U446.21 (B1)
DAT49_1V8: U446.3 (A1)
DAT50: U446.20 (B2)
DAT50_1V8: U446.4 (A2)
DAT51: U446.19 (B3)
DAT51_1V8: U446.5 (A3)
DAT52: U446.18 (B4)
DAT52_1V8: U446.6 (A4)
DAT53: U446.17 (B5)
DAT53_1V8: U446.7 (A5)
DAT54: U446.16 (B6)
DAT54_1V8: U446.8 (A6)
DAT55: U446.15 (B7)
DAT55_1V8: U446.9 (A7)
DAT56: U446.14 (B8)
DAT56_1V8: U446.10 (A8)
DAT57: U447.21 (B1)
DAT57_1V8: U447.3 (A1)
DAT58: U447.20 (B2)
DAT58_1V8: U447.4 (A2)
DAT59: U447.19 (B3)
DAT59_1V8: U447.5 (A3)
DAT60: U447.18 (B4)
DAT60_1V8: U447.6 (A4)
DAT61: U447.17 (B5)
DAT61_1V8: U447.7 (A5)
DAT62: U447.16 (B6)
DAT62_1V8: U447.8 (A6)
DAT63: U447.15 (B7)
DAT63_1V8: U447.9 (A7)
DAT64: R472.1, U447.14 (B8)
DAT64_1V8: U447.10 (A8)
DATR01: R473.1, U448.21 (B1)
DATR01_1V8: U448.3 (A1)
DATR02: U448.20 (B2)
DATR02_1V8: U448.4 (A2)
DATR03: U448.19 (B3)
DATR03_1V8: U448.5 (A3)
DATR04: U448.18 (B4)
DATR04_1V8: U448.6 (A4)
DATR05: U448.17 (B5)
DATR05_1V8: U448.7 (A5)
DATR06: U448.16 (B6)
DATR06_1V8: U448.8 (A6)
DATR07: U448.15 (B7)
DATR07_1V8: U448.9 (A7)
DATR08: U448.14 (B8)
DATR08_1V8: U448.10 (A8)
DATR09: U449.21 (B1)
DATR09_1V8: U449.3 (A1)
DATR10: U449.20 (B2)
DATR10_1V8: U449.4 (A2)
DATR11: U449.19 (B3)
DATR11_1V8: U449.5 (A3)
DATR12: U449.18 (B4)
DATR12_1V8: U449.6 (A4)
DATR13: U449.17 (B5)
DATR13_1V8: U449.7 (A5)
DATR14: U449.16 (B6)
DATR14_1V8: U449.8 (A6)
DATR15: U449.15 (B7)
DATR15_1V8: U449.9 (A7)
DATR16: U449.14 (B8)
DATR16_1V8: U449.10 (A8)
DATR17: U450.21 (B1)
DATR17_1V8: U450.3 (A1)
DATR18: U450.20 (B2)
DATR18_1V8: U450.4 (A2)
DATR19: U450.19 (B3)
DATR19_1V8: U450.5 (A3)
DATR20: U450.18 (B4)
DATR20_1V8: U450.6 (A4)
DATR21: U450.17 (B5)
DATR21_1V8: U450.7 (A5)
DATR22: U450.16 (B6)
DATR22_1V8: U450.8 (A6)
DATR23: U450.15 (B7)
DATR23_1V8: U450.9 (A7)
DATR24: U450.14 (B8)
DATR24_1V8: U450.10 (A8)
DATR25: U451.21 (B1)
DATR25_1V8: U451.3 (A1)
DATR26: U451.20 (B2)
DATR26_1V8: U451.4 (A2)
DATR27: U451.19 (B3)
DATR27_1V8: U451.5 (A3)
DATR28: U451.18 (B4)
DATR28_1V8: U451.6 (A4)
DATR29: U451.17 (B5)
DATR29_1V8: U451.7 (A5)
DATR30: U451.16 (B6)
DATR30_1V8: U451.8 (A6)
DATR31: U451.15 (B7)
DATR31_1V8: U451.9 (A7)
DATR32: R474.1, U451.14 (B8)
DATR32_1V8: U451.10 (A8)
DATR33: U452.21 (B1)
DATR33_1V8: U452.3 (A1)
DATR34: U452.20 (B2)
DATR34_1V8: U452.4 (A2)
DATR35: U452.19 (B3)
DATR35_1V8: U452.5 (A3)
DATR36: U452.18 (B4)
DATR36_1V8: U452.6 (A4)
DATR37: U452.17 (B5)
DATR37_1V8: U452.7 (A5)
DATR38: U452.16 (B6)
DATR38_1V8: U452.8 (A6)
DATR39: U452.15 (B7)
DATR39_1V8: U452.9 (A7)
DATR40: U452.14 (B8)
DATR40_1V8: U452.10 (A8)
DATR41: U453.21 (B1)
DATR41_1V8: U453.3 (A1)
DATR42: U453.20 (B2)
DATR42_1V8: U453.4 (A2)
DATR43: U453.19 (B3)
DATR43_1V8: U453.5 (A3)
DATR44: U453.18 (B4)
DATR44_1V8: U453.6 (A4)
DATR45: U453.17 (B5)
DATR45_1V8: U453.7 (A5)
DATR46: U453.16 (B6)
DATR46_1V8: U453.8 (A6)
DATR47: U453.15 (B7)
DATR47_1V8: U453.9 (A7)
DATR48: U453.14 (B8)
DATR48_1V8: U453.10 (A8)
DATR49: U454.21 (B1)
DATR49_1V8: U454.3 (A1)
DATR50: U454.20 (B2)
DATR50_1V8: U454.4 (A2)
DATR51: U454.19 (B3)
DATR51_1V8: U454.5 (A3)
DATR52: U454.18 (B4)
DATR52_1V8: U454.6 (A4)
DATR53: U454.17 (B5)
DATR53_1V8: U454.7 (A5)
DATR54: U454.16 (B6)
DATR54_1V8: U454.8 (A6)
DATR55: U454.15 (B7)
DATR55_1V8: U454.9 (A7)
DATR56: U454.14 (B8)
DATR56_1V8: U454.10 (A8)
DATR57: U455.21 (B1)
DATR57_1V8: U455.3 (A1)
DATR58: U455.20 (B2)
DATR58_1V8: U455.4 (A2)
DATR59: U455.19 (B3)
DATR59_1V8: U455.5 (A3)
DATR60: U455.18 (B4)
DATR60_1V8: U455.6 (A4)
DATR61: U455.17 (B5)
DATR61_1V8: U455.7 (A5)
DATR62: U455.16 (B6)
DATR62_1V8: U455.8 (A6)
DATR63: U455.15 (B7)
DATR63_1V8: U455.9 (A7)
DATR64: R475.1, U455.14 (B8)
DATR64_1V8: U455.10 (A8)
GND: C440.2, C441.2, C442.2, C443.2, C444.2, C445.2, C446.2, C447.2, C448.2, C449.2, C450.2, C451.2, C452.2, C453.2, C454.2, C455.2, C460.2, C461.2, C462.2, C463.2, C464.2, C465.2, C466.2, C467.2, C468.2, C469.2, C470.2, C471.2, C472.2, C473.2, C474.2, C475.2, C480.2, C481.2, C482.2, C483.2, C484.2, C485.2, C486.2, C487.2, C488.2, C489.2, TP469.1, TP470.1, U440.12 (GND), U440.13 (GND), U440.22 (~OE), U440.25 (PAD), U441.12 (GND), U441.13 (GND), U441.22 (~OE), U441.25 (PAD), U442.12 (GND), U442.13 (GND), U442.22 (~OE), U442.25 (PAD), U443.12 (GND), U443.13 (GND), U443.22 (~OE), U443.25 (PAD), U444.12 (GND), U444.13 (GND), U444.22 (~OE), U444.25 (PAD), U445.12 (GND), U445.13 (GND), U445.22 (~OE), U445.25 (PAD), U446.12 (GND), U446.13 (GND), U446.22 (~OE), U446.25 (PAD), U447.12 (GND), U447.13 (GND), U447.22 (~OE), U447.25 (PAD), U448.12 (GND), U448.13 (GND), U448.22 (~OE), U448.25 (PAD), U449.12 (GND), U449.13 (GND), U449.22 (~OE), U449.25 (PAD), U450.12 (GND), U450.13 (GND), U450.22 (~OE), U450.25 (PAD), U451.12 (GND), U451.13 (GND), U451.22 (~OE), U451.25 (PAD), U452.12 (GND), U452.13 (GND), U452.22 (~OE), U452.25 (PAD), U453.12 (GND), U453.13 (GND), U453.22 (~OE), U453.25 (PAD), U454.12 (GND), U454.13 (GND), U454.22 (~OE), U454.25 (PAD), U455.12 (GND), U455.13 (GND), U455.22 (~OE), U455.25 (PAD), U460.11 (EP), U461.11 (EP)
REF_U460: C481.1, U460.6 (REF_SENSE), U460.7 (REF)
REF_U461: C486.1, U461.6 (REF_SENSE), U461.7 (REF)
TP_DAT01: R470.2, TP463.1
TP_DAT32: R471.2, TP464.1
TP_DAT64: R472.2, TP465.1
TP_DATR01: R473.2, TP466.1
TP_DATR32: R474.2, TP467.1
TP_DATR64: R475.2, TP468.1
V4P3_LC: C487.1, C488.1, U461.5 (EN), U461.8 (VREG), U461.9 (VIN), U461.10 (VIN)
V4P3_RA: C482.1, C483.1, TP462.1, U460.5 (EN), U460.8 (VREG), U460.9 (VIN), U460.10 (VIN)
V18: C440.1, C441.1, C442.1, C443.1, C444.1, C445.1, C446.1, C447.1, C448.1, C449.1, C450.1, C451.1, C452.1, C453.1, C454.1, C455.1, TP461.1, U440.1 (VCCA), U440.2 (DIR1), U440.11 (DIR2), U441.1 (VCCA), U441.2 (DIR1), U441.11 (DIR2), U442.1 (VCCA), U442.2 (DIR1), U442.11 (DIR2), U443.1 (VCCA), U443.2 (DIR1), U443.11 (DIR2), U444.1 (VCCA), U444.2 (DIR1), U444.11 (DIR2), U445.1 (VCCA), U445.2 (DIR1), U445.11 (DIR2), U446.1 (VCCA), U446.2 (DIR1), U446.11 (DIR2), U447.1 (VCCA), U447.2 (DIR1), U447.11 (DIR2), U448.1 (VCCA), U448.2 (DIR1), U448.11 (DIR2), U449.1 (VCCA), U449.2 (DIR1), U449.11 (DIR2), U450.1 (VCCA), U450.2 (DIR1), U450.11 (DIR2), U451.1 (VCCA), U451.2 (DIR1), U451.11 (DIR2), U452.1 (VCCA), U452.2 (DIR1), U452.11 (DIR2), U453.1 (VCCA), U453.2 (DIR1), U453.11 (DIR2), U454.1 (VCCA), U454.2 (DIR1), U454.11 (DIR2), U455.1 (VCCA), U455.2 (DIR1), U455.11 (DIR2)
V33FF_L: C489.1, FB440.1, FB441.1, FB442.1, FB443.1, FB444.1, FB445.1, FB446.1, FB447.1, TP471.1, U461.1 (VOUT), U461.2 (VOUT), U461.3 (VOUT_SENSE)
V33FF_R: C484.1, FB448.1, FB449.1, FB450.1, FB451.1, FB452.1, FB453.1, FB454.1, FB455.1, TP460.1, U460.1 (VOUT), U460.2 (VOUT), U460.3 (VOUT_SENSE)
VXB440: C460.1, FB440.2, U440.23 (VCCB), U440.24 (VCCB)
VXB441: C461.1, FB441.2, U441.23 (VCCB), U441.24 (VCCB)
VXB442: C462.1, FB442.2, U442.23 (VCCB), U442.24 (VCCB)
VXB443: C463.1, FB443.2, U443.23 (VCCB), U443.24 (VCCB)
VXB444: C464.1, FB444.2, U444.23 (VCCB), U444.24 (VCCB)
VXB445: C465.1, FB445.2, U445.23 (VCCB), U445.24 (VCCB)
VXB446: C466.1, FB446.2, U446.23 (VCCB), U446.24 (VCCB)
VXB447: C467.1, FB447.2, U447.23 (VCCB), U447.24 (VCCB)
VXB448: C468.1, FB448.2, U448.23 (VCCB), U448.24 (VCCB)
VXB449: C469.1, FB449.2, U449.23 (VCCB), U449.24 (VCCB)
VXB450: C470.1, FB450.2, U450.23 (VCCB), U450.24 (VCCB)
VXB451: C471.1, FB451.2, U451.23 (VCCB), U451.24 (VCCB)
VXB452: C472.1, FB452.2, U452.23 (VCCB), U452.24 (VCCB)
VXB453: C473.1, FB453.2, U453.23 (VCCB), U453.24 (VCCB)
VXB454: C474.1, FB454.2, U454.23 (VCCB), U454.24 (VCCB)
VXB455: C475.1, FB455.2, U455.23 (VCCB), U455.24 (VCCB)

Notes on the sheet:
SN74AXC8T245 x16 (bom 1.2, VQFN RHL ruled 2026-10-10): FPGA LVCMOS18 data from J6 (DATnn_1V8 = cascode_l) and J5/J6 (DATRnn_1V8 = cascode_r) -> 3.3 V DATnn / DATRnn -> the 128 CELL sheets (LVC1G74 D). DIR1/DIR2 tied to VCCA (A->B), /OE to GND, PAD to GND. A side on V18 (SoM VCCIO, not generated her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
L channel: DATnn_1V8 -> DATnn, U440..U447
R channel: DATRnn_1V8 -> DATRnn, U448..U455
V33FF LDOs (U460 = V33FF_R / U461 = V33FF_L - dual-mono split 2026-10-12, user): ADP7158ACPZ-3.3 each, ~0.5 A per bank (the single ~1 A rail sat AT the TPS7A4501 derated ceiling - the FF islands and translator B-sides are now per-channel like every other analog domain). U460 from V4P3_RA, U461 from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
LAYOUT (mandatory): U461 sits at the NORTH board edge beside the J603 power-entry zone feeding the LEFT FF island array; U460 sits at the SOUTH edge beside J604 for the RIGHT bank. V4P3_LC/RA run connector -> VIN short and fat (no meander); each V33FF_x distributes ONLY to its own channel's cell be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
TEST POINTS (rule b): DAT/DATR cell-drive lines through 1k -> 1.0 mm pad; rails + GND on hook pads.
