ccroswhite/BFDAC/.Xil/Vivado-7120-csc3/dcp0/artix_dac_top_early.xdc

set_property SRC_FILE_INFO {cfile:c:/Users/ccros/BFDAC-Xilinx/BFDAC-Xilinx.gen/sources_1/ip/ddr4_0/bd_0/ip/ip_0/bd_9054_microblaze_I_0.xdc rfile:../../BFDAC-Xilinx.gen/sources_1/ip/ddr4_0/bd_0/ip/ip_0/bd_9054_microblaze_I_0.xdc id:1 order:EARLY scoped_inst:u_ddr4_if/u_ddr4/inst/u_ddr4_mem_intfc/u_ddr_cal_riu/mcs0/inst/microblaze_I/U0 rxprname:$PGENDIR/sources_1/ip/ddr4_0/bd_0/ip/ip_0/bd_9054_microblaze_I_0.xdc} [current_design]
set_property SRC_FILE_INFO {cfile:c:/Users/ccros/BFDAC-Xilinx/BFDAC-Xilinx.gen/sources_1/ip/ddr4_0/bd_0/ip/ip_2/bd_9054_ilmb_0.xdc rfile:../../BFDAC-Xilinx.gen/sources_1/ip/ddr4_0/bd_0/ip/ip_2/bd_9054_ilmb_0.xdc id:2 order:EARLY scoped_inst:u_ddr4_if/u_ddr4/inst/u_ddr4_mem_intfc/u_ddr_cal_riu/mcs0/inst/ilmb/U0 rxprname:$PGENDIR/sources_1/ip/ddr4_0/bd_0/ip/ip_2/bd_9054_ilmb_0.xdc} [current_design]
set_property SRC_FILE_INFO {cfile:c:/Users/ccros/BFDAC-Xilinx/BFDAC-Xilinx.gen/sources_1/ip/ddr4_0/bd_0/ip/ip_3/bd_9054_dlmb_0.xdc rfile:../../BFDAC-Xilinx.gen/sources_1/ip/ddr4_0/bd_0/ip/ip_3/bd_9054_dlmb_0.xdc id:3 order:EARLY scoped_inst:u_ddr4_if/u_ddr4/inst/u_ddr4_mem_intfc/u_ddr_cal_riu/mcs0/inst/dlmb/U0 rxprname:$PGENDIR/sources_1/ip/ddr4_0/bd_0/ip/ip_3/bd_9054_dlmb_0.xdc} [current_design]
set_property SRC_FILE_INFO {cfile:c:/Users/ccros/BFDAC-Xilinx/BFDAC-Xilinx.gen/sources_1/ip/ddr4_0/par/ddr4_0.xdc rfile:../../BFDAC-Xilinx.gen/sources_1/ip/ddr4_0/par/ddr4_0.xdc id:4 order:EARLY scoped_inst:u_ddr4_if/u_ddr4/inst rxprname:$PGENDIR/sources_1/ip/ddr4_0/par/ddr4_0.xdc} [current_design]
set_property src_info {type:PI file:{} line:-1 export:NONE save:INPUT read:READ} [current_design]
set_property TOOL_DERIVED_CLK_NAMES 1:0:CLKIN1:CLKFBOUT:clk_45m:mmcm_fb_out::1:0:CLKIN1:CLKFBOUT:clk_49m:mmcm_fb_out_1::1:0:CLKIN1:CLKOUT0:clk_45m:dsp_clk_unbuf::1:0:CLKIN1:CLKOUT0:clk_49m:dsp_clk_unbuf_1::1:0:CLKIN1:CLKOUT1:clk_45m:lvds_clk_unbuf::1:0:CLKIN1:CLKOUT1:clk_49m:lvds_clk_unbuf_1 [get_cells u_clk_gen/u_mmcm]
set_property src_info {type:PI file:{} line:-1 export:NONE save:INPUT read:READ} [current_design]
set_property TOOL_DERIVED_CLK_NAMES 1:0:CLKIN1:CLKOUT0:ddr4_refclkp:mmcm_clkout0::1:0:CLKIN1:CLKOUT1:ddr4_refclkp:mmcm_clkout1::1:0:CLKIN1:CLKOUT2:ddr4_refclkp:mmcm_clkout2::1:0:CLKIN1:CLKOUT3:ddr4_refclkp:mmcm_clkout3::1:0:CLKIN1:CLKOUT4:ddr4_refclkp:mmcm_clkout4::1:0:CLKIN1:CLKOUT5:ddr4_refclkp:mmcm_clkout5::1:0:CLKIN1:CLKOUT6:ddr4_refclkp:mmcm_clkout6 [get_cells u_ddr4_if/u_ddr4/inst/u_ddr4_infrastructure/gen_mmcme4.u_mmcme_adv_inst]
set_property src_info {type:PI file:{} line:-1 export:NONE save:INPUT read:READ} [current_design]
set_property TOOL_DERIVED_CLK_NAMES {1:0:CLKIN:CLKOUTPHY:mmcm_clkout0:pll_clk[0]} [get_cells {u_ddr4_if/u_ddr4/inst/u_ddr4_mem_intfc/u_mig_ddr4_phy/inst/u_ddr4_phy_pll/plle_loop[0].gen_plle4.PLLE4_BASE_INST_OTHER}]
set_property src_info {type:PI file:{} line:-1 export:NONE save:INPUT read:READ} [current_design]
set_property TOOL_DERIVED_CLK_NAMES {1:1:u_ddr4_if/u_ddr4/inst/u_ddr4_mem_intfc/u_mig_ddr4_phy/inst/u_ddr4_phy_pll/plle_loop[0].gen_plle4.PLLE4_BASE_INST_OTHER/CLKOUTPHY:DIV:pll_clk[0]:pll_clk[0]_DIV} [current_design]
current_instance u_ddr4_if/u_ddr4/inst/u_ddr4_mem_intfc/u_ddr_cal_riu/mcs0/inst/microblaze_I/U0
set_property src_info {type:SCOPED_XDC file:1 line:1 export:INPUT save:INPUT read:READ} [current_design]
set_false_path -through [get_ports -scoped_to_current_instance Reset]
set_property src_info {type:SCOPED_XDC file:1 line:2 export:INPUT save:INPUT read:READ} [current_design]

set_property src_info {type:SCOPED_XDC file:1 line:3 export:INPUT save:INPUT read:READ} [current_design]
# Waivers for FPU and hardware multiplier
set_property src_info {type:SCOPED_XDC file:1 line:4 export:INPUT save:INPUT read:READ} [current_design]
create_waiver -type DRC -id {DPIP-1} -user "microblaze" -desc "Non-pipelined by design" -tags "12436" -scope -internal -objects [get_cells -hierarchical *DSP48E1_I1] -objects [get_pins -quiet -filter {REF_PIN_NAME=~A[*]} -of [get_cells -hierarchical *DSP48E1_I1]] -timestamp "Mon Jun  1 02:29:38 GMT 2026"
set_property src_info {type:SCOPED_XDC file:1 line:7 export:INPUT save:INPUT read:READ} [current_design]
create_waiver -type DRC -id {DPIP-1} -user "microblaze" -desc "Non-pipelined by design" -tags "12436" -scope -internal -objects [get_cells -hierarchical *DSP48E1_I1] -objects [get_pins -quiet -filter {REF_PIN_NAME=~B[*]} -of [get_cells -hierarchical *DSP48E1_I1]] -timestamp "Mon Jun  1 02:29:38 GMT 2026"
set_property src_info {type:SCOPED_XDC file:1 line:10 export:INPUT save:INPUT read:READ} [current_design]
create_waiver -type DRC -id {DPIP-2} -user "microblaze" -desc "Non-pipelined by design" -tags "12436" -scope -internal -objects [get_cells -hierarchical *DSP48E1_I1] -objects [get_pins -quiet -filter {REF_PIN_NAME=~A[*]} -of [get_cells -hierarchical *DSP48E1_I1]] -timestamp "Mon Jun  1 02:29:38 GMT 2026"
set_property src_info {type:SCOPED_XDC file:1 line:13 export:INPUT save:INPUT read:READ} [current_design]
create_waiver -type DRC -id {DPIP-2} -user "microblaze" -desc "Non-pipelined by design" -tags "12436" -scope -internal -objects [get_cells -hierarchical *DSP48E1_I1] -objects [get_pins -quiet -filter {REF_PIN_NAME=~B[*]} -of [get_cells -hierarchical *DSP48E1_I1]] -timestamp "Mon Jun  1 02:29:38 GMT 2026"
set_property src_info {type:SCOPED_XDC file:1 line:16 export:INPUT save:INPUT read:READ} [current_design]
create_waiver -type DRC -id {DPOP-1} -user "microblaze" -desc "Non-pipelined by design" -tags "12436" -scope -internal -objects [get_cells -hierarchical *DSP48E1_I1] -objects [get_pins -quiet -filter REF_PIN_NAME=~P* -of [get_cells -hierarchical *DSP48E1_I1]] -timestamp "Mon Jun  1 02:29:38 GMT 2026"
set_property src_info {type:SCOPED_XDC file:1 line:19 export:INPUT save:INPUT read:READ} [current_design]
create_waiver -type DRC -id {DPOP-2} -user "microblaze" -desc "Non-pipelined by design" -tags "12436" -scope -internal -objects [get_cells -hierarchical *DSP48E1_I1] -objects [get_pins -quiet -filter REF_PIN_NAME=~P* -of [get_cells -hierarchical *DSP48E1_I1]] -timestamp "Mon Jun  1 02:29:38 GMT 2026"
set_property src_info {type:SCOPED_XDC file:1 line:22 export:INPUT save:INPUT read:READ} [current_design]
create_waiver -type DRC -id {DPOP-3} -user "microblaze" -desc "Non-pipelined by design" -tags "12436" -scope -internal -objects [get_cells -hierarchical *DSP48E1_I1] -objects [get_pins -quiet -filter {REF_PIN_NAME=~P[*]} -of [get_cells -hierarchical *DSP48E1_I1]] -timestamp "Mon Jun  1 02:29:38 GMT 2026"
set_property src_info {type:SCOPED_XDC file:1 line:25 export:INPUT save:INPUT read:READ} [current_design]
create_waiver -type DRC -id {DPOP-3} -user "microblaze" -desc "Non-pipelined by design" -tags "12436" -scope -internal -objects [get_cells -hierarchical *DSP48E1_I1] -objects [get_pins -quiet -filter REF_PIN_NAME=~PATTERN* -of [get_cells -hierarchical *DSP48E1_I1]] -timestamp "Mon Jun  1 02:29:38 GMT 2026"
set_property src_info {type:SCOPED_XDC file:1 line:28 export:INPUT save:INPUT read:READ} [current_design]
create_waiver -type DRC -id {DPOP-3} -user "microblaze" -desc "Non-pipelined by design" -tags "12436" -scope -internal -objects [get_cells -hierarchical *DSP48E1_I1] -objects [get_pins -quiet -filter REF_PIN_NAME=~*OUT* -of [get_cells -hierarchical *DSP48E1_I1]] -timestamp "Mon Jun  1 02:29:38 GMT 2026"
set_property src_info {type:SCOPED_XDC file:1 line:31 export:INPUT save:INPUT read:READ} [current_design]
create_waiver -type DRC -id {DPOP-4} -user "microblaze" -desc "Non-pipelined by design" -tags "12436" -scope -internal -objects [get_cells -hierarchical *DSP48E1_I1] -objects [get_pins -quiet -filter {REF_PIN_NAME=~P[*]} -of [get_cells -hierarchical *DSP48E1_I1]] -timestamp "Mon Jun  1 02:29:38 GMT 2026"
set_property src_info {type:SCOPED_XDC file:1 line:34 export:INPUT save:INPUT read:READ} [current_design]
create_waiver -type DRC -id {DPOP-4} -user "microblaze" -desc "Non-pipelined by design" -tags "12436" -scope -internal -objects [get_cells -hierarchical *DSP48E1_I1] -objects [get_pins -quiet -filter REF_PIN_NAME=~PATTERN* -of [get_cells -hierarchical *DSP48E1_I1]] -timestamp "Mon Jun  1 02:29:38 GMT 2026"
set_property src_info {type:SCOPED_XDC file:1 line:37 export:INPUT save:INPUT read:READ} [current_design]
create_waiver -type DRC -id {DPOP-4} -user "microblaze" -desc "Non-pipelined by design" -tags "12436" -scope -internal -objects [get_cells -hierarchical *DSP48E1_I1] -objects [get_pins -quiet -filter REF_PIN_NAME=~*OUT* -of [get_cells -hierarchical *DSP48E1_I1]] -timestamp "Mon Jun  1 02:29:38 GMT 2026"
set_property src_info {type:SCOPED_XDC file:1 line:40 export:INPUT save:INPUT read:READ} [current_design]

current_instance -quiet
current_instance u_ddr4_if/u_ddr4/inst/u_ddr4_mem_intfc/u_ddr_cal_riu/mcs0/inst/ilmb/U0
set_property src_info {type:SCOPED_XDC file:2 line:1 export:INPUT save:INPUT read:READ} [current_design]
set_false_path -through [get_ports -scoped_to_current_instance SYS_Rst]
set_property src_info {type:SCOPED_XDC file:2 line:2 export:INPUT save:INPUT read:READ} [current_design]

current_instance -quiet
current_instance u_ddr4_if/u_ddr4/inst/u_ddr4_mem_intfc/u_ddr_cal_riu/mcs0/inst/dlmb/U0
set_property src_info {type:SCOPED_XDC file:3 line:1 export:INPUT save:INPUT read:READ} [current_design]
set_false_path -through [get_ports -scoped_to_current_instance SYS_Rst]
set_property src_info {type:SCOPED_XDC file:3 line:2 export:INPUT save:INPUT read:READ} [current_design]

set_property src_info {type:SCOPED_XDC file:4 line:1 export:INPUT save:INPUT read:READ} [current_design]
## please copy over all contents of the XDC when it is merged with othe XDC files ##
set_property src_info {type:SCOPED_XDC file:4 line:2 export:INPUT save:INPUT read:READ} [current_design]

set_property src_info {type:SCOPED_XDC file:4 line:3 export:INPUT save:INPUT read:READ} [current_design]
## Clock constraint for input system clock which drives MMCM for the design
set_property src_info {type:SCOPED_XDC file:4 line:4 export:INPUT save:INPUT read:READ} [current_design]

set_property src_info {type:SCOPED_XDC file:4 line:5 export:INPUT save:INPUT read:READ} [current_design]
## The frequency of the input clock is as per GUI selected input clock period
set_property src_info {type:SCOPED_XDC file:4 line:6 export:INPUT save:INPUT read:READ} [current_design]

current_instance -quiet
set_property src_info {type:SCOPED_XDC file:4 line:7 export:INPUT save:INPUT read:READ} [current_design]
create_clock -period 9.996 [get_ports ddr4_refclkp]
set_property src_info {type:SCOPED_XDC file:4 line:8 export:INPUT save:INPUT read:READ} [current_design]

set_property src_info {type:SCOPED_XDC file:4 line:9 export:INPUT save:INPUT read:READ} [current_design]

set_property src_info {type:SCOPED_XDC file:4 line:10 export:INPUT save:INPUT read:READ} [current_design]
## Below pin LOC constraints are for system clock and system reset and
set_property src_info {type:SCOPED_XDC file:4 line:11 export:INPUT save:INPUT read:READ} [current_design]

set_property src_info {type:SCOPED_XDC file:4 line:12 export:INPUT save:INPUT read:READ} [current_design]
## memory related pins
set_property src_info {type:SCOPED_XDC file:4 line:13 export:INPUT save:INPUT read:READ} [current_design]

set_property src_info {type:SCOPED_XDC file:4 line:14 export:INPUT save:INPUT read:READ} [current_design]
set_property OUTPUT_IMPEDANCE RDRV_40_40 [get_ports {ddr4_dq[13]}]
set_property src_info {type:SCOPED_XDC file:4 line:15 export:INPUT save:INPUT read:READ} [current_design]
set_property OUTPUT_IMPEDANCE RDRV_40_40 [get_ports {ddr4_dq[15]}]
set_property src_info {type:SCOPED_XDC file:4 line:16 export:INPUT save:INPUT read:READ} [current_design]
set_property OUTPUT_IMPEDANCE RDRV_40_40 [get_ports {ddr4_dq[8]}]
set_property src_info {type:SCOPED_XDC file:4 line:17 export:INPUT save:INPUT read:READ} [current_design]
set_property OUTPUT_IMPEDANCE RDRV_40_40 [get_ports {ddr4_dq[10]}]
set_property src_info {type:SCOPED_XDC file:4 line:18 export:INPUT save:INPUT read:READ} [current_design]
set_property OUTPUT_IMPEDANCE RDRV_40_40 [get_ports {ddr4_ck_t[0]}]
set_property src_info {type:SCOPED_XDC file:4 line:19 export:INPUT save:INPUT read:READ} [current_design]
set_property OUTPUT_IMPEDANCE RDRV_40_40 [get_ports {ddr4_dqs_t[1]}]
set_property src_info {type:SCOPED_XDC file:4 line:20 export:INPUT save:INPUT read:READ} [current_design]
set_property OUTPUT_IMPEDANCE RDRV_40_40 [get_ports {ddr4_dq[9]}]
set_property src_info {type:SCOPED_XDC file:4 line:21 export:INPUT save:INPUT read:READ} [current_design]
set_property OUTPUT_IMPEDANCE RDRV_40_40 [get_ports {ddr4_dq[11]}]
set_property src_info {type:SCOPED_XDC file:4 line:22 export:INPUT save:INPUT read:READ} [current_design]
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

set_property src_info {type:SCOPED_XDC file:4 line:64 export:INPUT save:INPUT read:READ} [current_design]

set_property src_info {type:SCOPED_XDC file:4 line:65 export:INPUT save:INPUT read:READ} [current_design]

set_property src_info {type:SCOPED_XDC file:4 line:80 export:INPUT save:INPUT read:READ} [current_design]
set_property DRIVE 8 [get_ports ddr4_reset_n]
set_property src_info {type:SCOPED_XDC file:4 line:81 export:INPUT save:INPUT read:READ} [current_design]

set_property src_info {type:SCOPED_XDC file:4 line:119 export:INPUT save:INPUT read:READ} [current_design]

set_property src_info {type:SCOPED_XDC file:4 line:120 export:INPUT save:INPUT read:READ} [current_design]

set_property src_info {type:SCOPED_XDC file:4 line:121 export:INPUT save:INPUT read:READ} [current_design]
## These signals once asserted, stays asserted for multiple clock cycles.
set_property src_info {type:SCOPED_XDC file:4 line:122 export:INPUT save:INPUT read:READ} [current_design]

set_property src_info {type:SCOPED_XDC file:4 line:123 export:INPUT save:INPUT read:READ} [current_design]
## False path constraint is added to improve the HOLD timing.
set_property src_info {type:SCOPED_XDC file:4 line:124 export:INPUT save:INPUT read:READ} [current_design]

current_instance u_ddr4_if/u_ddr4/inst
set_property src_info {type:SCOPED_XDC file:4 line:125 export:INPUT save:INPUT read:READ} [current_design]
set_false_path -hold -to [get_pins */*/*/*/*/*.u_xiphy_control/xiphy_control/RIU_ADDR*]
set_property src_info {type:SCOPED_XDC file:4 line:126 export:INPUT save:INPUT read:READ} [current_design]
set_false_path -hold -to [get_pins */*/*/*/*/*.u_xiphy_control/xiphy_control/RIU_WR_DATA*]
set_property src_info {type:SCOPED_XDC file:4 line:127 export:INPUT save:INPUT read:READ} [current_design]

set_property src_info {type:SCOPED_XDC file:4 line:128 export:INPUT save:INPUT read:READ} [current_design]

current_instance -quiet
set_property src_info {type:SCOPED_XDC file:4 line:129 export:INPUT save:INPUT read:READ} [current_design]
set_property SLEW FAST [get_ports {ddr4_addr[16]}]
set_property src_info {type:SCOPED_XDC file:4 line:129 export:INPUT save:INPUT read:READ} [current_design]
set_property SLEW FAST [get_ports {ddr4_addr[15]}]
set_property src_info {type:SCOPED_XDC file:4 line:129 export:INPUT save:INPUT read:READ} [current_design]
set_property SLEW FAST [get_ports {ddr4_addr[14]}]
set_property src_info {type:SCOPED_XDC file:4 line:129 export:INPUT save:INPUT read:READ} [current_design]
set_property SLEW FAST [get_ports {ddr4_addr[13]}]
set_property src_info {type:SCOPED_XDC file:4 line:129 export:INPUT save:INPUT read:READ} [current_design]
set_property SLEW FAST [get_ports {ddr4_addr[12]}]
set_property src_info {type:SCOPED_XDC file:4 line:129 export:INPUT save:INPUT read:READ} [current_design]
set_property SLEW FAST [get_ports {ddr4_addr[11]}]
set_property src_info {type:SCOPED_XDC file:4 line:129 export:INPUT save:INPUT read:READ} [current_design]
set_property SLEW FAST [get_ports {ddr4_addr[10]}]
set_property src_info {type:SCOPED_XDC file:4 line:129 export:INPUT save:INPUT read:READ} [current_design]
set_property SLEW FAST [get_ports {ddr4_addr[9]}]
set_property src_info {type:SCOPED_XDC file:4 line:129 export:INPUT save:INPUT read:READ} [current_design]
set_property SLEW FAST [get_ports {ddr4_addr[8]}]
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
set_property DATA_RATE DDR [get_ports {ddr4_dqs_c[1]}]
set_property src_info {type:SCOPED_XDC file:4 line:143 export:INPUT save:INPUT read:READ} [current_design]
set_property DATA_RATE DDR [get_ports {ddr4_dqs_c[0]}]
set_property src_info {type:SCOPED_XDC file:4 line:143 export:INPUT save:INPUT read:READ} [current_design]
set_property DATA_RATE DDR [get_ports {ddr4_ck_t[0]}]
set_property src_info {type:SCOPED_XDC file:4 line:143 export:INPUT save:INPUT read:READ} [current_design]
set_property DATA_RATE DDR [get_ports {ddr4_ck_c[0]}]
set_property src_info {type:SCOPED_XDC file:4 line:144 export:INPUT save:INPUT read:READ} [current_design]
## Multi-cycle path constraints for Fabric - RIU clock domain crossing signals
current_instance u_ddr4_if/u_ddr4/inst
set_property src_info {type:SCOPED_XDC file:4 line:145 export:INPUT save:INPUT read:READ} [current_design]
set_max_delay -datapath_only -from [get_pins */*/*/u_ddr_cal_addr_decode/io_ready_lvl_reg/C] -to [get_pins {*/u_io_ready_lvl_sync/SYNC[*].sync_reg_reg[0]/D}] 5.000
set_property src_info {type:SCOPED_XDC file:4 line:146 export:INPUT save:INPUT read:READ} [current_design]
set_max_delay -datapath_only -from [get_pins {*/*/*/u_ddr_cal_addr_decode/io_read_data_reg[*]/C}] -to [get_pins {*/u_io_read_data_sync/SYNC[*].sync_reg_reg[0]/D}] 5.000
set_property src_info {type:SCOPED_XDC file:4 line:147 export:INPUT save:INPUT read:READ} [current_design]
set_max_delay -datapath_only -from [get_pins */*/*/phy_ready_riuclk_reg/C] -to [get_pins {*/u_phy2clb_phy_ready_sync/SYNC[*].sync_reg_reg[0]/D}] 3.000
set_property src_info {type:SCOPED_XDC file:4 line:148 export:INPUT save:INPUT read:READ} [current_design]
set_max_delay -datapath_only -from [get_pins */*/*/bisc_complete_riuclk_reg/C] -to [get_pins {*/u_phy2clb_bisc_complete_sync/SYNC[*].sync_reg_reg[0]/D}] 3.000
set_property src_info {type:SCOPED_XDC file:4 line:149 export:INPUT save:INPUT read:READ} [current_design]
set_max_delay -datapath_only -from [get_pins */*/io_addr_strobe_lvl_riuclk_reg/C] -to [get_pins {*/u_io_addr_strobe_lvl_sync/SYNC[*].sync_reg_reg[0]/D}] 3.000
set_property src_info {type:SCOPED_XDC file:4 line:150 export:INPUT save:INPUT read:READ} [current_design]
set_max_delay -datapath_only -from [get_pins */*/io_write_strobe_riuclk_reg/C] -to [get_pins {*/u_io_write_strobe_sync/SYNC[*].sync_reg_reg[0]/D}] 3.000
set_property src_info {type:SCOPED_XDC file:4 line:151 export:INPUT save:INPUT read:READ} [current_design]
set_max_delay -datapath_only -from [get_pins {*/*/io_address_riuclk_reg[*]/C}] -to [get_pins {*/u_io_addr_sync/SYNC[*].sync_reg_reg[0]/D}] 3.000
set_property src_info {type:SCOPED_XDC file:4 line:152 export:INPUT save:INPUT read:READ} [current_design]
set_max_delay -datapath_only -from [get_pins {*/*/io_write_data_riuclk_reg[*]/C}] -to [get_pins {*/u_io_write_data_sync/SYNC[*].sync_reg_reg[0]/D}] 3.000
set_property src_info {type:SCOPED_XDC file:4 line:153 export:INPUT save:INPUT read:READ} [current_design]
set_max_delay -datapath_only -from [get_pins */en_vtc_in_reg/C] -to [get_pins {*/u_en_vtc_sync/SYNC[*].sync_reg_reg[0]/D}] 10.000
set_property src_info {type:SCOPED_XDC file:4 line:154 export:INPUT save:INPUT read:READ} [current_design]
set_max_delay -datapath_only -from [get_pins {*/*/riu2clb_valid_r1_riuclk_reg[*]/C}] -to [get_pins {*/u_riu2clb_valid_sync/SYNC[*].sync_reg_reg[0]/D}] 10.000
set_property src_info {type:SCOPED_XDC file:4 line:155 export:INPUT save:INPUT read:READ} [current_design]
set_max_delay -datapath_only -from [get_pins {*/*/*/phy2clb_fixdly_rdy_low_riuclk_int_reg[*]/C}] -to [get_pins {*/u_phy2clb_fixdly_rdy_low/SYNC[*].sync_reg_reg[0]/D}] 10.000
set_property src_info {type:SCOPED_XDC file:4 line:156 export:INPUT save:INPUT read:READ} [current_design]
set_max_delay -datapath_only -from [get_pins {*/*/*/phy2clb_fixdly_rdy_upp_riuclk_int_reg[*]/C}] -to [get_pins {*/u_phy2clb_fixdly_rdy_upp/SYNC[*].sync_reg_reg[0]/D}] 10.000
set_property src_info {type:SCOPED_XDC file:4 line:157 export:INPUT save:INPUT read:READ} [current_design]
set_max_delay -datapath_only -from [get_pins {*/*/*/phy2clb_phy_rdy_low_riuclk_int_reg[*]/C}] -to [get_pins {*/u_phy2clb_phy_rdy_low/SYNC[*].sync_reg_reg[0]/D}] 10.000
set_property src_info {type:SCOPED_XDC file:4 line:158 export:INPUT save:INPUT read:READ} [current_design]
set_max_delay -datapath_only -from [get_pins {*/*/*/phy2clb_phy_rdy_upp_riuclk_int_reg[*]/C}] -to [get_pins {*/u_phy2clb_phy_rdy_upp/SYNC[*].sync_reg_reg[0]/D}] 10.000
set_property src_info {type:SCOPED_XDC file:4 line:159 export:INPUT save:INPUT read:READ} [current_design]
set_max_delay -datapath_only -from [get_pins */rst_r1_reg/C] -to [get_pins {*/u_fab_rst_sync/SYNC[*].sync_reg_reg[0]/D}] 10.000
set_property src_info {type:SCOPED_XDC file:4 line:160 export:INPUT save:INPUT read:READ} [current_design]
set_max_delay -datapath_only -from [get_pins */*/*/clb2phy_t_b_addr_riuclk_reg/C] -to [get_pins {*/*/*/clb2phy_t_b_addr_i_reg[0]/D}] 3.000
set_property src_info {type:SCOPED_XDC file:4 line:161 export:INPUT save:INPUT read:READ} [current_design]
set_max_delay -datapath_only -from [get_pins */*/*/*/slave_en_lvl_reg/C] -to [get_pins {*/*/*/*/u_slave_en_sync/SYNC[*].sync_reg_reg[0]/D}] 3.000
set_property src_info {type:SCOPED_XDC file:4 line:162 export:INPUT save:INPUT read:READ} [current_design]
set_max_delay -datapath_only -from [get_pins */*/*/*/slave_we_r_reg/C] -to [get_pins {*/*/*/*/u_slave_we_sync/SYNC[*].sync_reg_reg[0]/D}] 3.000
set_property src_info {type:SCOPED_XDC file:4 line:163 export:INPUT save:INPUT read:READ} [current_design]
set_max_delay -datapath_only -from [get_pins {*/*/*/*/slave_addr_r_reg[*]/C}] -to [get_pins {*/*/*/*/u_slave_addr_sync/SYNC[*].sync_reg_reg[0]/D}] 3.000
set_property src_info {type:SCOPED_XDC file:4 line:164 export:INPUT save:INPUT read:READ} [current_design]
set_max_delay -datapath_only -from [get_pins {*/*/*/*/slave_di_r_reg[*]/C}] -to [get_pins {*/*/*/*/u_slave_di_sync/SYNC[*].sync_reg_reg[0]/D}] 3.000
set_property src_info {type:SCOPED_XDC file:4 line:165 export:INPUT save:INPUT read:READ} [current_design]
set_max_delay -datapath_only -from [get_pins */*/*/*/slave_rdy_cptd_sclk_reg/C] -to [get_pins {*/*/*/*/u_slave_rdy_cptd_sync/SYNC[*].sync_reg_reg[0]/D}] 3.000
set_property src_info {type:SCOPED_XDC file:4 line:166 export:INPUT save:INPUT read:READ} [current_design]
set_max_delay -datapath_only -from [get_pins */*/*/*/slave_rdy_lvl_fclk_reg/C] -to [get_pins {*/*/*/*/u_slave_rdy_sync/SYNC[*].sync_reg_reg[0]/D}] 12.000
set_property src_info {type:SCOPED_XDC file:4 line:167 export:INPUT save:INPUT read:READ} [current_design]
set_max_delay -datapath_only -from [get_pins {*/*/*/*/slave_do_fclk_reg[*]/C}] -to [get_pins {*/*/*/*/u_slave_do_sync/SYNC[*].sync_reg_reg[0]/D}] 12.000
set_property src_info {type:SCOPED_XDC file:4 line:168 export:INPUT save:INPUT read:READ} [current_design]
set_false_path -through [get_pins u_ddr4_infrastructure/sys_rst]
set_property src_info {type:SCOPED_XDC file:4 line:169 export:INPUT save:INPUT read:READ} [current_design]
set_false_path -from [get_pins */input_rst_design_reg/C] -to [get_pins {*/rst_div_sync_r_reg[0]/D}]
set_property src_info {type:SCOPED_XDC file:4 line:170 export:INPUT save:INPUT read:READ} [current_design]
set_false_path -from [get_pins */input_rst_design_reg/C] -to [get_pins {*/rst_riu_sync_r_reg[0]/D}]
set_property src_info {type:SCOPED_XDC file:4 line:171 export:INPUT save:INPUT read:READ} [current_design]
set_false_path -from [get_pins */input_rst_design_reg/C] -to [get_pins {*/rst_mb_sync_r_reg[0]/D}]
set_property src_info {type:SCOPED_XDC file:4 line:172 export:INPUT save:INPUT read:READ} [current_design]
set_false_path -from [get_pins */rst_async_riu_div_reg/C] -to [get_pins {*/rst_div_sync_r_reg[0]/D}]
set_property src_info {type:SCOPED_XDC file:4 line:173 export:INPUT save:INPUT read:READ} [current_design]
set_false_path -from [get_pins */rst_async_mb_reg/C] -to [get_pins {*/rst_mb_sync_r_reg[0]/D}]
set_property src_info {type:SCOPED_XDC file:4 line:174 export:INPUT save:INPUT read:READ} [current_design]
set_false_path -from [get_pins */rst_async_riu_div_reg/C] -to [get_pins {*/rst_riu_sync_r_reg[0]/D}]
set_property src_info {type:SCOPED_XDC file:4 line:175 export:INPUT save:INPUT read:READ} [current_design]
create_waiver -type METHODOLOGY -id {CLKC-55} -user "DDR4" -desc "Clocking Primitives will be Auto-Placed" -tags "1010162" -scope -internal -objects [get_cells -hierarchical *gen_mmcme*.u_mmcme_adv_inst* -filter {NAME =~ *inst/u_ddr4_infrastructure*}] -timestamp "Mon Jun  1 02:29:50 GMT 2026"
set_property src_info {type:SCOPED_XDC file:4 line:176 export:INPUT save:INPUT read:READ} [current_design]
create_waiver -type METHODOLOGY -id {CLKC-56} -user "DDR4" -desc "Clocking Primitives will be Auto-Placed" -tags "1010162" -scope -internal -objects [get_cells -hierarchical *gen_mmcme*.u_mmcme_adv_inst* -filter {NAME =~ *inst/u_ddr4_infrastructure*}] -timestamp "Mon Jun  1 02:29:50 GMT 2026"
set_property src_info {type:SCOPED_XDC file:4 line:177 export:INPUT save:INPUT read:READ} [current_design]
create_waiver -type METHODOLOGY -id {CLKC-57} -user "DDR4" -desc "Clocking Primitives will be Auto-Placed" -tags "1010162" -scope -internal -objects [get_cells -hierarchical {*plle_loop[*].gen_plle*.PLLE*_BASE_INST_OTHER*} -filter {NAME =~ *inst/u_ddr4_phy_pll*}] -timestamp "Mon Jun  1 02:29:50 GMT 2026"
set_property src_info {type:SCOPED_XDC file:4 line:178 export:INPUT save:INPUT read:READ} [current_design]
create_waiver -type METHODOLOGY -id {CLKC-58} -user "DDR4" -desc "Clocking Primitives will be Auto-Placed" -tags "1010162" -scope -internal -objects [get_cells -hierarchical {*plle_loop[*].gen_plle*.PLLE*_BASE_INST_OTHER*} -filter {NAME =~ *inst/u_ddr4_phy_pll*}] -timestamp "Mon Jun  1 02:29:50 GMT 2026"
set_property src_info {type:SCOPED_XDC file:4 line:179 export:INPUT save:INPUT read:READ} [current_design]
create_waiver -type METHODOLOGY -id {CLKC-40} -user "DDR4" -desc "MMCM is driven through a BUFGCE" -tags "1010162" -scope -internal -objects [get_cells -hierarchical *gen_mmcme*.u_mmcme_adv_inst* -filter {NAME =~ *inst/u_ddr4_infrastructure*}] -timestamp "Mon Jun  1 02:29:51 GMT 2026"
set_property src_info {type:SCOPED_XDC file:4 line:180 export:INPUT save:INPUT read:READ} [current_design]
## These below commands are used to create Interface ports for controller.
set_property src_info {type:SCOPED_XDC file:4 line:181 export:INPUT save:INPUT read:READ} [current_design]

current_instance -quiet
set_property src_info {type:SCOPED_XDC file:4 line:182 export:INPUT save:INPUT read:READ} [current_design]
create_interface interface_ddr4_0
set_property src_info {type:SCOPED_XDC file:4 line:182 export:INPUT save:INPUT read:READ} [current_design]
set_property INTERFACE interface_ddr4_0 [get_ports { ddr4_dq[15] ddr4_dq[14] ddr4_dq[13] ddr4_dq[12] ddr4_dq[11] ddr4_dq[10] ddr4_dq[9] ddr4_dq[8] ddr4_dq[7] ddr4_dq[6] ddr4_dq[5] ddr4_dq[4] ddr4_dq[3] ddr4_dq[2] ddr4_dq[1] ddr4_dq[0] ddr4_ck_t[0] ddr4_ck_c[0] ddr4_dqs_t[1] ddr4_dqs_t[0] ddr4_dqs_c[1] ddr4_dqs_c[0] ddr4_addr[16] ddr4_addr[15] ddr4_addr[14] ddr4_addr[13] ddr4_addr[12] ddr4_addr[11] ddr4_addr[10] ddr4_addr[9] ddr4_addr[8] ddr4_addr[7] ddr4_addr[6] ddr4_addr[5] ddr4_addr[4] ddr4_addr[3] ddr4_addr[2] ddr4_addr[1] ddr4_addr[0] ddr4_bg[0] ddr4_cs_n[0] ddr4_ba[1] ddr4_ba[0] ddr4_cke[0] ddr4_dm_dbi_n[1] ddr4_dm_dbi_n[0] ddr4_odt[0] ddr4_reset_n ddr4_refclkp ddr4_refclkn ddr4_act_n }]
set_property src_info {type:SCOPED_XDC file:4 line:184 export:INPUT save:INPUT read:READ} [current_design]
