ccroswhite/BFDAC/Xilinx/Testbench/tb_vu13p_mig.sv

`timescale 1ns / 1ps

// =============================================================================
// tb_vu13p_mig — FULL TOP with the REAL DDR4 MIG (ddr4_0, Simulation_Mode=BFM)
// and the Micron DDR4 SDRAM model (2026-09-04, plan Step 4.4 residue).
//
// This is the only simulation of the true boot chain on the real MIG:
//   STARTUPE3.EOS && init_calib_complete
//     -> qspi_boot_loader reads the record chain from Flash 1 (behavioral
//        SPI flash below; SCK tapped hierarchically because CCLK is a
//        dedicated config pin, not a user I/O)
//     -> AXI write (128 b) -> axi_dwc_coef (512 b) -> ddr4_0 -> Micron model
//     -> ARM (SPI) builds a 1-entry list and commits -> coef_bank_loader
//        walks the DDR4 directory, streams the bank back over AXI read
//     -> FIR bank written, bank_valid, COEF_STATUS[12]
//
// Boot image staged in flash (records are packed, 16 B header each):
//   rec A @0x00 : dest DIR_BASE_ADDR (0x3FFF_0000), 64 B = entry 0 + terminator
//   rec B @0x50 : dest BANK_DDR4 (0x0010_0000), BANK_SIZE (16 KB) of coefficients,
//                 word k (mac = k / COEF_DEPTH, idx = k % COEF_DEPTH) = k
//   then erased flash (0xFF) = end of chain
//
// Tests:
//   T1 MIG calibration completes (led_debug[2] / init_calib_complete)
//   T2 boot loader: boot_done, boot_ok, 2 records, no CRC/AXI fail
//   T3 list commit -> directory load by ID -> every coefficient matches the
//      DDR4 image (NUM_MACS*COEF_DEPTH writes, 0 mismatches), bank_valid,
//      COEF_STATUS[12]=1, no load_err
//   T4 FILTER_SELECT_ID with an unknown ID -> sticky[6], CMD_ERR reason
//      FILT_NOTFOUND, bank still valid (previous filter keeps playing)
//
// Geometry: NUM_MACS=4, TAPS_PER_PHASE=64 -> COEF_DEPTH=1024, bank = 16 KB
// (the loader's minimum: COEF_DEPTH must be a multiple of the 1024-coef burst).
// Runner: Testbench/run_tb_mig.ps1 (needs sim_mig/ from
// scripts/gen_ddr4_example.tcl for the Micron model + IP compile lists).
// =============================================================================
import arch_package::*;

// xsim has no `tran`; the reference sim_tb_top shorts DQ/DQS/DM with this.
module short(in1, in1);
    inout in1;
endmodule

module tb_vu13p_mig;

    localparam real P200 = 5.0;       // 200 MHz system clock
    localparam real PREF = 4.998;     // MIG C0_SYS_CLK (200.08 MHz, 4998 ps)
    localparam real P49  = 20.345;    // 49.152 MHz
    localparam real P45  = 22.151;    // 45.1584 MHz

    localparam int NUM_MACS       = 4;
    localparam int TAPS_PER_PHASE = 64;   // loader minimum: COEF_DEPTH = one 1024-coef burst
    localparam int COEF_DEPTH     = 16 * TAPS_PER_PHASE;             // 1024
    localparam logic [31:0] BANK_SIZE     = 32'(NUM_MACS * COEF_DEPTH * 4);  // 16384
    localparam logic [31:0] DIR_BASE_ADDR = 32'h3FFF_0000;           // loader default
    localparam logic [31:0] BANK_DDR4     = 32'h0010_0000;
    localparam logic [15:0] FILT_ID       = 16'h0101;
    localparam logic [15:0] FILT_MISSING  = 16'h0404;

    // ---- Clocks / reset ---------------------------------------------------------------------
    logic clk_200m = 0, clk_ref = 0, clk_45m = 0, clk_49m = 0;
    logic mclk;
    wire  clk_sel;
    logic ext_rst_n = 0;
    always #(P200/2) clk_200m = ~clk_200m;
    always #(PREF/2) clk_ref  = ~clk_ref;
    always #(P49/2)  clk_49m  = ~clk_49m;
    always #(P45/2)  clk_45m  = ~clk_45m;
    assign mclk = clk_sel ? clk_45m : clk_49m;

    // I2S source (768 kHz frame) — keeps the ingress watchdog quiet
    wire i2s_bclk, i2s_lrclk;
    logic i2s_data = 0;

    // ---- SPI / misc pins ----------------------------------------------------------------------
    logic spi_sclk = 0, spi_cs_n = 1, spi_mosi = 0;
    wire  spi_miso, fpga_irq_n;
    wire  relay_line_mute, relay_hp_mute, relay_hp_rails;
    wire  [1:0]  relay_level;
    wire         led_status;
    wire  [3:0]  led_debug;     // [3]=clk_locked [2]=ddr4_calib [1]=i2s_err [0]=force_zero
    wire         qspi1_cs_n;
    wire  [3:0]  qspi1_dq;
    wire         cf_sck;             // carrier coef flash (bom 18a) - not populated here
    wire  [3:0]  cf_cs_n;
    wire  [3:0]  cf_dq;
    pullup (cf_dq[1]);               // absent device reads 0xFF -> SoM Flash 1 fallback
    wire  [63:0] cascode_l, cascode_r;

    // ---- DDR4 pins (64-bit, 4 x16 parts) ----------------------------------------------------
    wire [63:0] ddr4_dq;
    wire [7:0]  ddr4_dqs_c, ddr4_dqs_t, ddr4_dm_dbi_n;
    wire [16:0] ddr4_addr;
    wire [1:0]  ddr4_ba;
    wire [0:0]  ddr4_bg, ddr4_cs_n, ddr4_cke, ddr4_odt, ddr4_ck_t, ddr4_ck_c;
    wire        ddr4_act_n, ddr4_reset_n;

    // ---- DUT ---------------------------------------------------------------------------------
    defparam u_dut.u_automute.FLUSH_CYCLES       = 26'd400;
    defparam u_dut.u_automute.SETTLE_CYCLES      = 26'd200;
    defparam u_dut.u_automute.SWITCH_CYCLES      = 26'd200;
    defparam u_dut.u_automute.RAIL_SETTLE_CYCLES = 26'd600;
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
