ccroswhite/BFDAC/(commit log)

2026-04-09 First commit of systemverilog files. These are for the artix 7 running the DSP engines, ingesting I2S and outputting 5.1446MHz samples to the blade DACs via LVDS.
2026-04-12 Add clock generator taking the 48 and 49Mhz clock signals to generate appropriate clocking signals for the fir filter and LVDS signals for converter blades.
2026-04-12 instead of truncating which leads to noise, round up from closest bit.
    [volume_multiplier.sv]
2026-04-12 Use a BRAM to buffer all 256 coefficients to buffer DMA pauses/bubbles, force signed to unsigned, fix burst math to pull in the correct number of coefficients.
2026-04-12 1m tap engine needs to be done differently, move to polyphase engine: 1M taps is actually just a 512K mirror, so take those 512K coefficients (which are now 18 bits due to DSP slice capacity and nati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
    [fir_polyphase_interpolator.sv, polyphase_mac_engine.sv]
2026-04-12 remove old fir filter and mac engine in favor of a 1m tap polyphase filter.
2026-04-12 Add constraints file, this will need to be updated with pin assignments. Add the sigm-delta 2nd order noise shaper to push error way up into the 300+ Khz range.
    [artix_dac_master.xdc]
2026-04-12 Update artix_dac_top to incorporate the new polyphase and noise shaper and refine everything here in this file, remove ds_master_ctrl.sv.
    [artix_dac_top.sv]
2026-04-12 Move to 3 lvds pairs for data, frame and clock. Rename LVDS serializer.
2026-04-15 design constraints - added pin placement, seperating noisy from the LVDS pins on opposite sides of the FPGA.
2026-04-16 Add several different monitoring methods and be able to retrieve via the SPI bus about the condition of the DAC. Add python script that generates the coefficients for the DAC.
2026-04-16 Add QSPI flash device to store bitstream and filters local. Add ability for the the FPGA to manage the upgrades for both the coefficients and the bitstream. There will be a golden bitstream at 0x0 an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
2026-04-20 Current good state.
2026-05-09 Current state: coefficients done, script to create coefficients done, struggling to get design to use DSP slices, use less general fabric and close on timing, still long ways away from adding back al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
2026-05-10 Still seeing 512 DSP slices. Capturing courrent config in preparation of nuking the fir filter engine completely.
2026-05-11 Revert FIR/MAC/top to working 365607e baseline; DDR3 audio-path detour was the root of synthesis pathologies
    [artix_dac_master.xdc, artix_dac_top.sv, fir_polyphase_interpolator.sv, polyphase_mac_engine.sv]
2026-05-13 With dual 256 DSP DAC per channel w/dither, w/5th order noise chaper, w/DEM, w/volume multiplier, out of the LVDS bus, met timing at 357Mhz. Capturing before adding the DDR3 and changing up to use Tr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
    [artix_dac_master.xdc, artix_dac_top.sv, dem_mapper.sv, fir_polyphase_interpolator.sv, lvds_serial_tx.sv, noise_shaper_5th_order.sv, polyphase_mac_engine.sv]
2026-05-16 Move to Artix Ultrascale+ XCAU25p in hopes that we can meet timing. Add Opal Kelly dev board constraints files. Update to single bank BRAM e.g. no secondary coefficients bank, will need to pull these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
2026-05-20 Change coefficent super script to generate all sample rates of the sound choice. This means that we will have more than just 5 or 10 coefficient sets to store as each flavor of musicality will have 1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
2026-05-31 Add debugging to simulation - getting failures but not sure why.
    [coef_bank_loader.sv, dac_coef_subsys.sv, fir_polyphase_interpolator.sv, fir_polyphase_stereo.sv, polyphase_mac_engine.sv, tb_system_ddr4_to_fir.sv]
2026-08-19 No longer require coeffient depth to be a power of 2, this allows us to scale better and it more aligns with availalbe FPGA resources most importantly, URAM.
2026-08-22 Move to application processor interacts with i2c temp sensors, calculates and then loads into FPGA
2026-10-17 Checkpoint carrier bring-up design and keep generated output local
    Preserve the dual-channel KiCad design, manual test controls, power architecture, FPGA control/boot updates, regression fixtures and vendor design references before connector selection and layout. Exclude regenerable logs, captures, exports and local tooling state while retaining local artifact copies.
    Generated with [Devin](https://devin.ai)
2026-10-17 Checkpoint multirate FPGA-master I2S RTL draft
    Add coherent stream-rate control through 384 kHz, FPGA-generated I2S clocks, adjustable return-data capture, variable FIR phases, filter-rate validation, and targeted regressions. Record the locked AP/FPGA ownership contract and proposed register/coefficient metadata changes.
    Detached compile and regression results have not been reviewed. Synthesis and place-and-route remain on hold; this is an implementation checkpoint, not release sign-off.
    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
2026-10-17 Restructure documentation around the BFDAC system design
    Describe the intended product, subsystem roles, audio flow, clocks, analog conversion, power, planned physical architecture and system operation first. Preserve the previous R01-R20 implementation audit in a dedicated companion document, explicitly note that PCB layout has not started, and update the README as the design-document entry point.
    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
2026-10-17 Validate stream-rate filters and frame-ready unmute
    Version multirate filter metadata, verify family and interpolation tags, require a complete valid PCM frame before unmute, and cover these conditions in the loader and control regressions. Record the successful detached 14-test Vivado regression and its limits.
    No synthesis, place-and-route or hardware qualification was run.
    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
2026-10-17 Guard DPD deadlines and calibration-bank updates
    Raise the DSP MMCM clock divider ratio for additional feedback timing budget, monitor correction readiness at the next Stage-A consumption, and fault/mute on a deadline miss. Make calibration commits wait for DPD idle, reject pending-bank writes, track calibration validity, and safely resynchronize retained control toggles across DSP resets.
    Add DPD 49/50-cycle, deadline-boundary, RTZ spacing, calibration race/reset, and control-interlock regressions. Update system/interface review documentation and verification record.
    Detached Vivado compile/elaboration and all 19 configured simulations passed. No synthesis, place-and-route, routed timing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
2026-10-17 Switch FIR filter banks at native frame boundaries
    Wait for the last rate-selected polyphase result of a native input frame before swapping the active FIR coefficient bank. Keep the bank-select tree from changing during an in-flight frame, and verify frame-boundary waiting plus one completion marker per accepted input across all eight rates.
    Regression process 33632 was still running when this commit was made; results are pending. No synthesis, place-and-route, timing closure or hardware qualification was performed.
    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
2026-10-17 Fix halfband scaling and mute transition timing
    Accumulate halfband products at full precision, apply Q1.17 scaling once, and align the bypass sample with the filtered pipeline. Recalculate automute defaults for the maximum-family DSP clock and make switch_busy reflect relay transitions, allowing cell diagnostics in stable mute.
    Add halfband DC gain and fast-spacing alignment checks, automute timer/state tests, and a muted cell-test control-plane check.
    Detached Vivado compile/elaboration and all 22 configured simulations passed. No synthesis, place-and-route, timing closure or hardware qualification was run.
    Generated with [Devin](https://devin.ai)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
2026-10-17 Fix stereo dither and AXI filter-load errors
    Seed the L/R TPDF generators independently and carry the full 42-bit uniform difference in a signed 43-bit value through the EF3 quantizer. Regenerate DPD golden vectors at the full TPDF range.
    Retire the last registered FIFO write before reading, detect and drain AXI RRESP failures without activating a partial filter bank, report loader error code 4 with CMD_ERR_INFO detail, reset FIFO state on retry, and guard the final packed MAC index.
    The detached Vivado regression passed all 23 configured jobs, including the new TPDF range/independence test and AXI error/recovery test. No synthesis, place-and-route, timing closure or hardware qualification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
2026-10-18 Harden QSPI boot staging and backpressure
    Use a proper Gray-pointer FIFO full comparator, increase read-stall headroom, and run SoM flash accesses at 25 MHz pending exact MPN verification. Reject boot records outside the 30-bit DDR AXI aperture or unsupported length/alignment limits and report the format failure through boot status.
    Extend QSPI subsystem simulation with sustained AXI backpressure, record-boundary validation, and existing byte-order/readback checks. Targeted QSPI simulation passed; the expanded full regression is still running, so no full-suite pass is claimed.
    No synthesis, place-and-route, STA/CDC closure, MIG hardware, or analog qualification was run.
    Generated with [De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
2026-10-18 Constrain held volume CDC and reconcile clock docs
    Replace blanket clk_200m/dsp_clk false paths with first-stage synchronizer exceptions, constrain the held volume and level-target buses, and document rate-shift/reset assumptions. Refresh clock-network comments to match the dual-CCHD XOCLK design and correct clk_sel polarity.
    The RTL regression passed before these constraint/documentation updates; Vivado timing exception matching, synthesis, place-and-route and routed CDC remain unverified.
    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
2026-10-18 Prevent FIR sweep truncation on input overrun
    Accept new samples only while idle or at a completed-frame boundary. Ignore and report arrivals during active shift/sweep so the in-flight interpolation frame and phase accounting finish intact. Add a regression that exercises the overrun and include the stereo FIR test in the stream-rate suite.
    Expanded 25-job Vivado simulation suite passed. No synthesis, place-and-route, routed timing or hardware qualification was run.
    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
2026-10-18 Harden SPI frame close and DPD regression cadence
    Delay SPI frame validation to allow the final synchronized SCLK edge to settle when CS rises near it, and exercise that boundary in the control-plane test. Set the standalone DPD engine test default to the production 49-cycle case while retaining explicit 50- and 56-cycle coverage.
    The expanded 25-job Vivado simulation suite passed. No synthesis, place-and-route, routed timing or hardware qualification was run.
    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
2026-10-18 Exercise live relay busy in cell diagnostics
2026-10-18 Track FPGA and hardware release readiness tasks
2026-11-03 Add latest kicad designs. Updated FPGA pins.
2026-11-03 Update schematic kicad files
2026-11-03 Optimizations, specifically, folded half curve coefficients, volterra lag kernel updates, reduce MAC DSP reduction.
2026-11-04 Update bom, update schematic, add test points, jtag connectors.
2026-11-04 Update bom, update board to board connectors to use the Samtec SeaRay connector SEAF on the pre-reg board and the DAC converter main boards, 3 on each board in total.
