ccroswhite/BFDAC/(notices)

Notices in the files:
progress.md:
licence: SERVER csc3 2100, lmgrd in C:\AMDDesignTools\win_flexlm_*);
